yjc97/Haptic_Tablet/Media/Alpha/IMG_5569.jpg

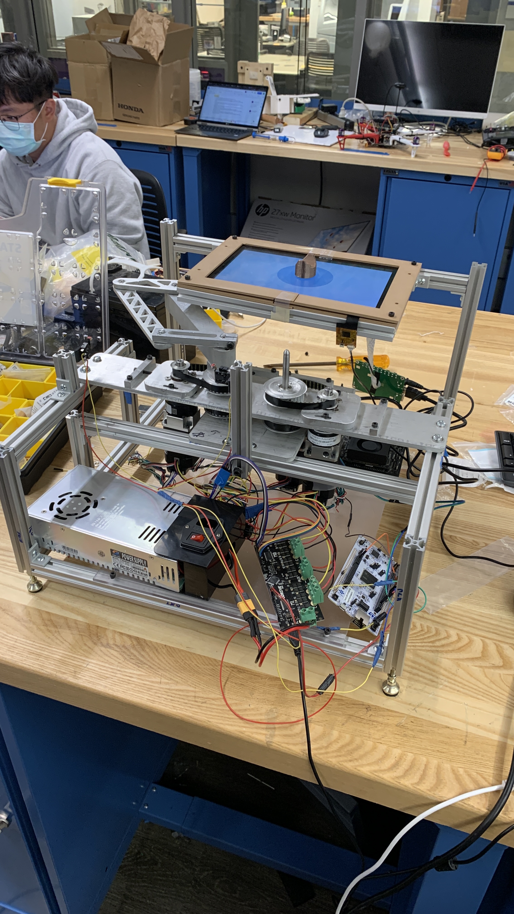
Media/Alpha/IMG_5569.jpg
