yjc97/Haptic_Tablet/Media/Alpha/IMG_5568.jpg

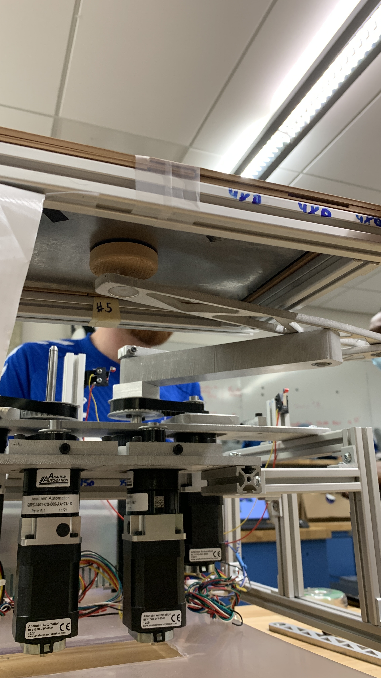
Media/Alpha/IMG_5568.jpg
