yjc97/Haptic_Tablet/Actuator/Motor Selection.docx

Maxon:

https://www.maxongroup.com/maxon/view/product/motor/ecmotor/ecflat/ecflat60/614949

Nominal voltage | 24 V
No load speed | 4300 rpm
No load current | 497 mA
Nominal speed | 3240 rpm
Nominal torque (max. continuous torque) | 536 mNm
Nominal current (max. continuous current) | 9.28 A
Stall torque | 4300 mNm
Stall current | 81.9 A
Max. efficiency | 85 %

https://www.maxongroup.com/maxon/view/category/motor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

Nominal voltage | 18 V
No load speed | 4450 rpm
No load current | 829 mA
Nominal speed | 3470 rpm
Nominal torque (max. continuous torque) | 896 mNm
Nominal current (max. continuous current) | 20.8 A
Stall torque | 10300 mNm
Stall current | 269 A
Max. efficiency | 89 %
