yjc97/Haptic_Tablet/Alpha/Demo Day Progress Slides.pptx

## Demo Day

Cameron, Sam, Lio, Ray, Diogo and Jose

## Design Requirements

- Transversable area of 7” x 10”
- Continuous 6N possible at the end effector
- Moving speed up to 150 mm/s
- Virtual wall stiffness of 1N/mm
Descoped for Alpha
- Track two points of contact -> one point of contact
  - One rotation of points, distance between points, etc.

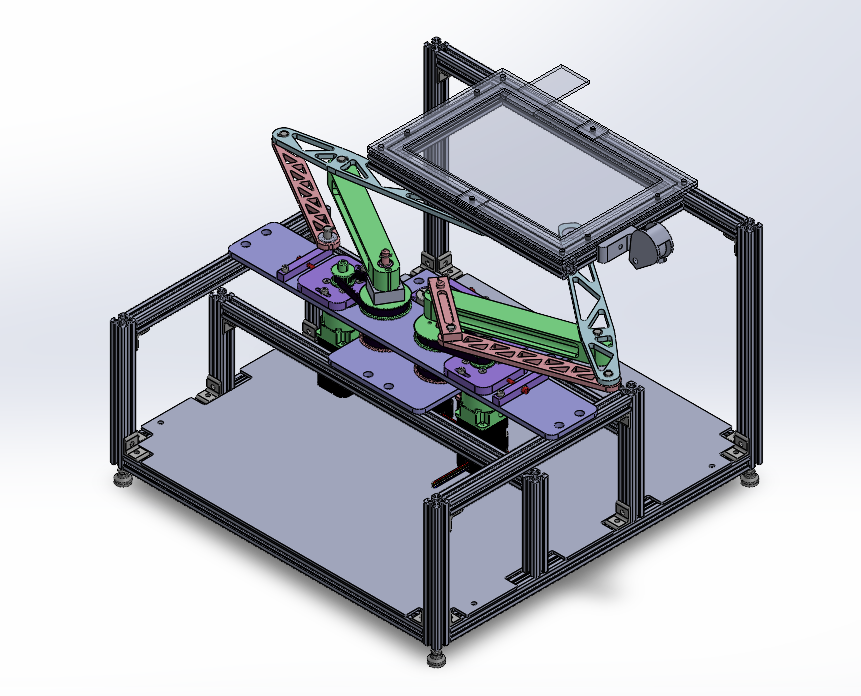
[picture p37: figure]

## Mechanical - Alpha

- Revised design
  - Removed upside-down motor
  - Updated link design to improve stiffness
  - Refined stack on longer shaft
  - Add limit switches
- Waterjet and machined all custom components
- Fully-assembled left-half linkage and 8020 frame
- Mounted key components to 8020 Frame

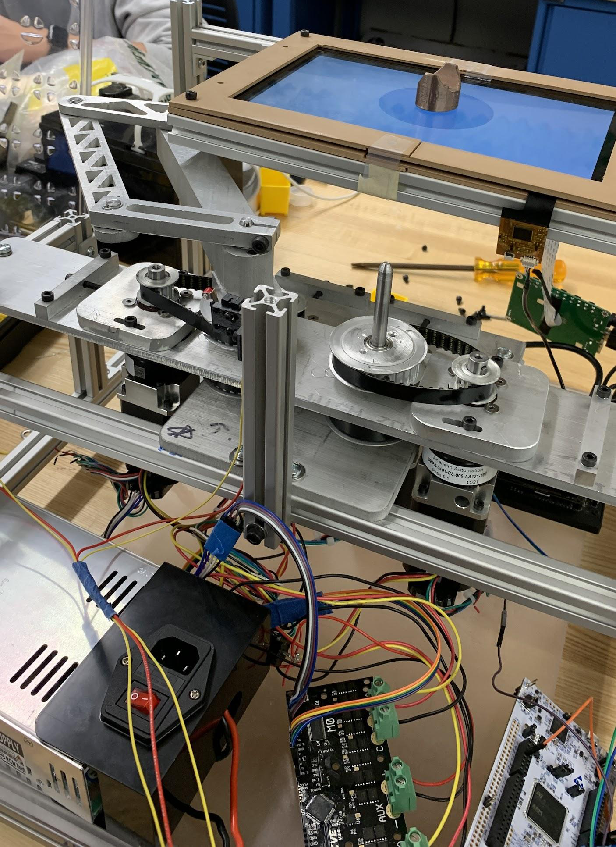
[picture p38: figure]

## Mechanical - Beta

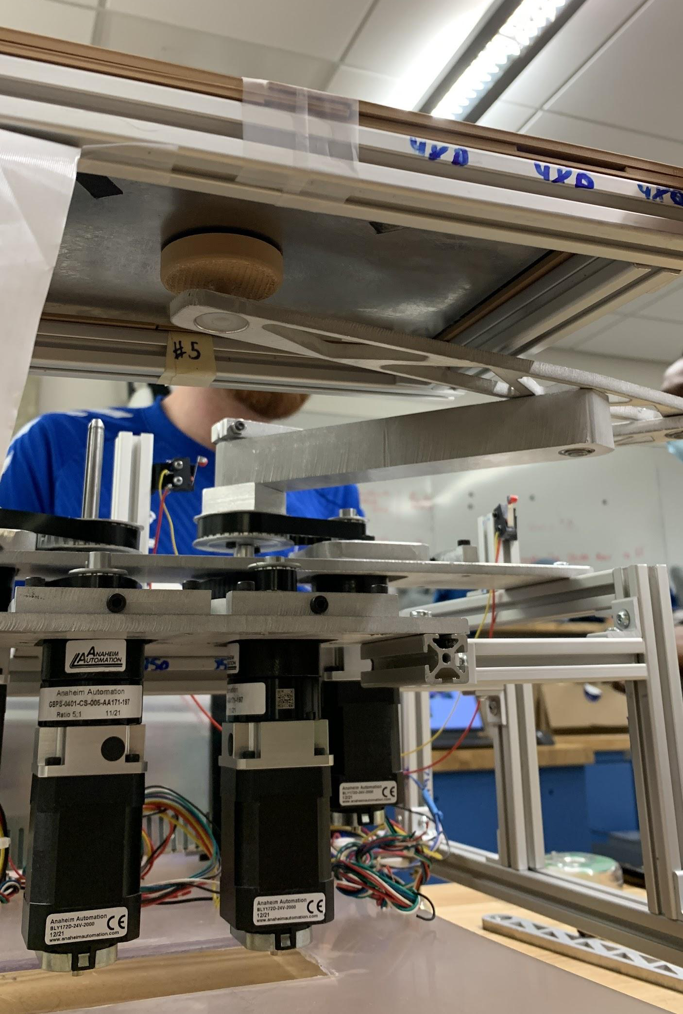
[picture p39: figure]

- Improve backdrivability
  - Analyze rotating components for ways to improve alignment & smoothness
- Improve stiffness in the frame via gussets
- Improve wire management
- Add acrylic guards to remove pinch points

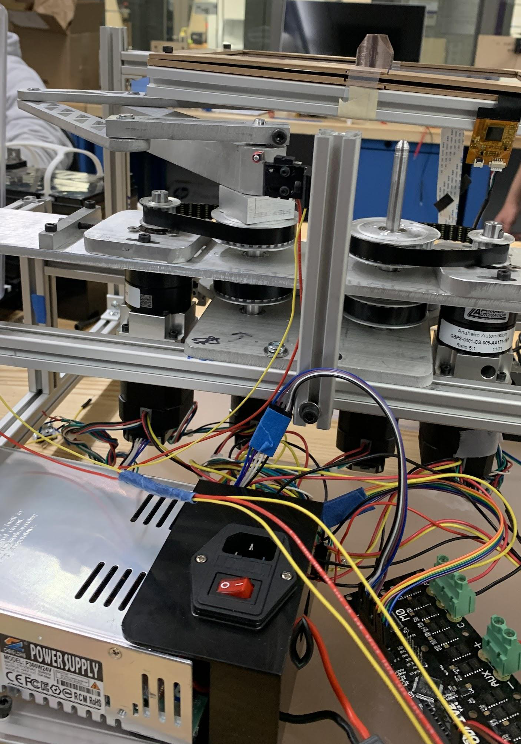
[picture p40: figure]

## Magnet

- New selection of magnets to increase shear force (8 N), while sustaining normal force and low friction (4 N)
- New puck design to allow for direct grounding

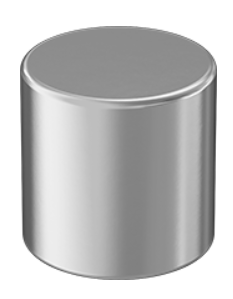
[picture p41: figure]
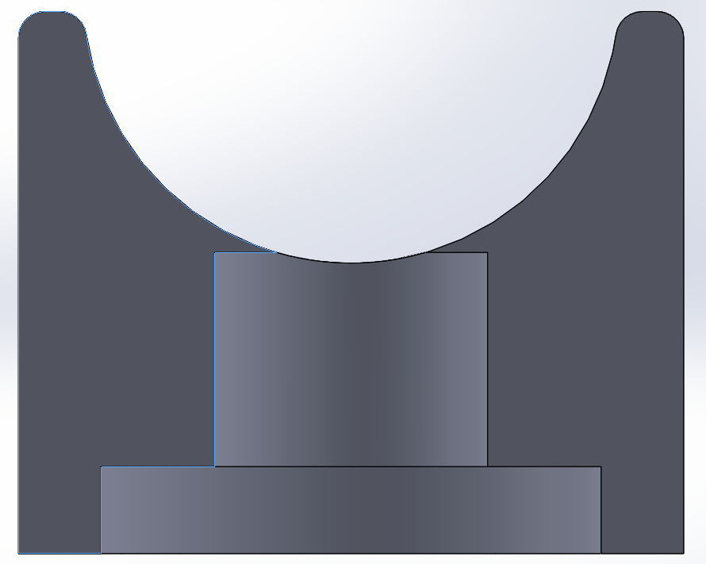
[picture p42: figure]
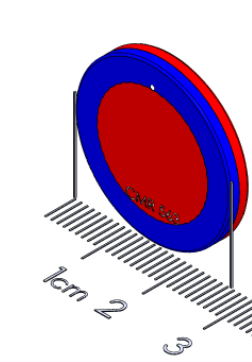
[picture p43: figure]
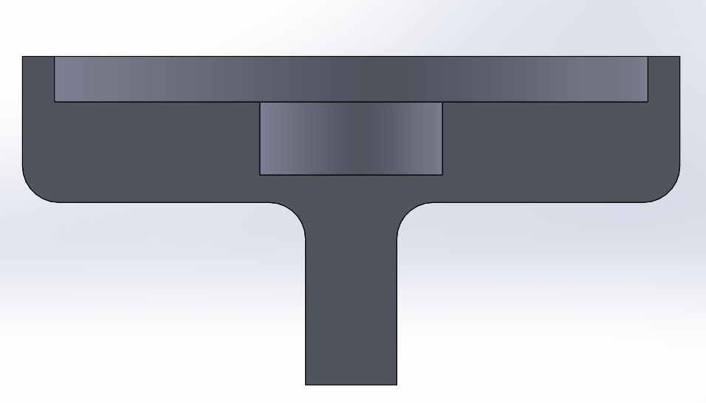
[picture p44: figure]

Notes: McMaster Magnet: 18N normal force
Polymagnet Magnet: 13.1N normal force
0.1N Shear force

## Electronics

Touchscreen

Phase ABC

Phase ABC

Axis0

Motor
Gearbox

Encoder

Axis1

Motor
Gearbox

Encoder

GND

Odrive

3.3V GND A B Z

FFC

Touch
sensor

FFC

HDMI
Driver

HDMI

Nvidia

Power

USB

3.3V GND A B Z

Power Supply

TX

RX

Power

GND

STM32

RX

TX

TX

RX

GND

## Electronics

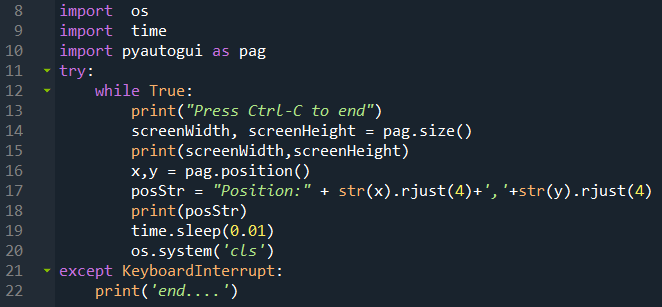
[picture p45: figure]

## Embedded

Screen (u, v) pix Touch module
Screen (x, y) mm Resolution calculation
Top Magnet (x, y)mm – –
Button Magnet desired force (Fx, Fy) N Algorithm (e.g. stiff wall)
Button Magnet desired pos (x, y) mm Magnet (displacement - force) relationship
Arm EE(x, y)mm – –
Arm Angle(theta1, theta2) revolution IK solver

## Embedded

Basic Calibration
Using switch to get the absolute angle (incremental encoder)
Use Geometric relationship to calculate the screen arm transformation
Full Automatic Calibration – TBD
Let Motor be IDEL User move the Top Magnet
Read (u, v) and Arm angle (theta1 theta2)
Use multi Group data to solve all the unknown parameter.

## Demo!

- Single-point tracking
- Circular virtual wall

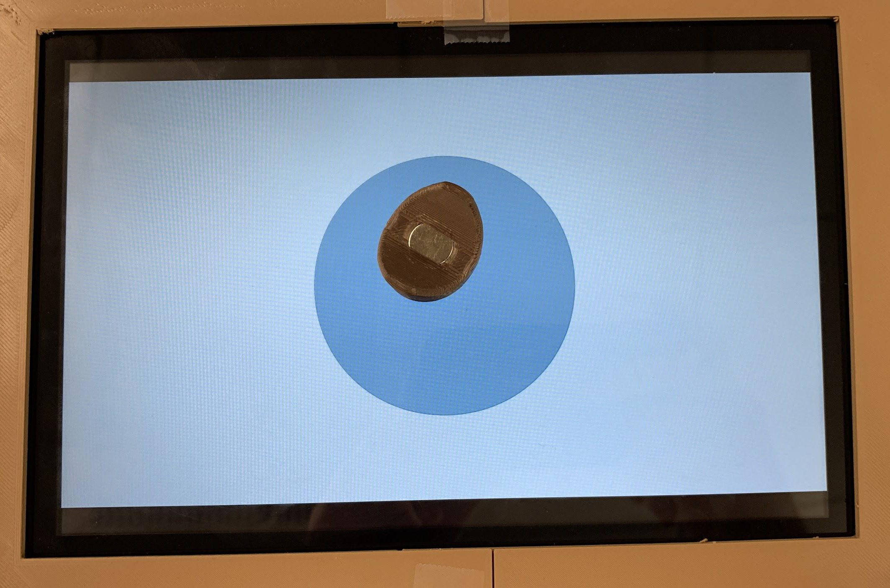
[picture p46: figure]
