yjc97/Haptic_Tablet/Alpha/Documentation Links.docx

- BOM (https://docs.google.com/spreadsheets/d/1UQJlw0del5G45h6zSm0E_HK45yHbqKKUzbgZlgoQl6M/edit#gid=0)
- Drawings (https://drive.google.com/drive/folders/1MZkpaJnwjj6plieDn9vKRo8g7MoNWwiO)
- Github (https://github.com/cmastoras/TabletCapstone)
  - Color Plot Script (https://github.com/cmastoras/TabletCapstone/blob/main/2R_TOPOLOGY.ipynb)
  - CAD (https://github.com/cmastoras/TabletCapstone/tree/main/GrabCAD)
    - Alpha (https://github.com/cmastoras/TabletCapstone/tree/main/GrabCAD/ALPHA)
