yjc97/Haptic_Tablet/Mechanism/Magnet/3_4 Polymagnet meeting.pptx

## HAPTIC DEVICE

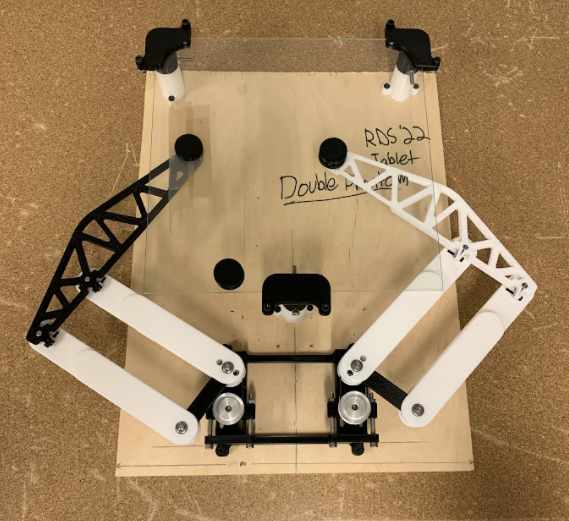
[picture p72: figure]
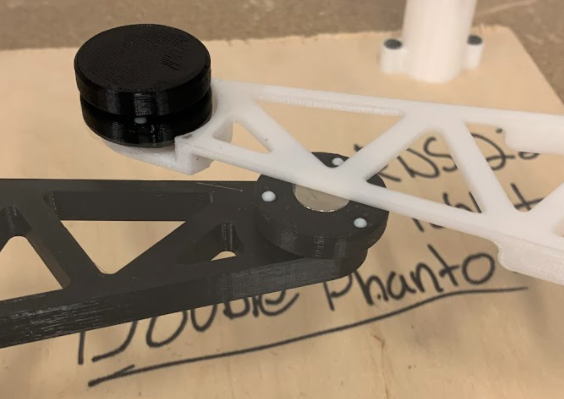
[picture p73: figure]
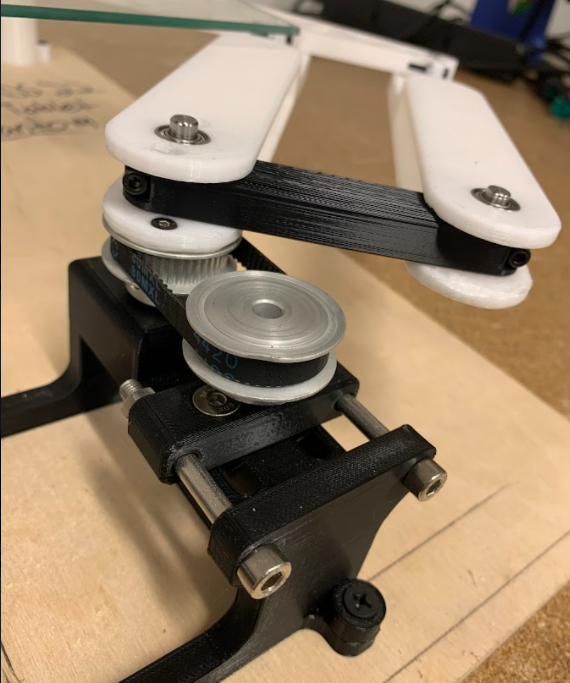
[picture p74: figure]

## KEY REQUIREMENTS

LOW FRICTION:
- In free motion, the user should experience no more than 0.22 lbs or 100 g of inertia.
- In free motion, the gantry device should be able to match finger speeds up to 150 mm/s or 5.9 in/s.
SHEAR STRENGTH:
- When the user is interacting with a virtual wall, the device will be able to respond with a stiffness of 1 N/mm or 5.71 lbs/in

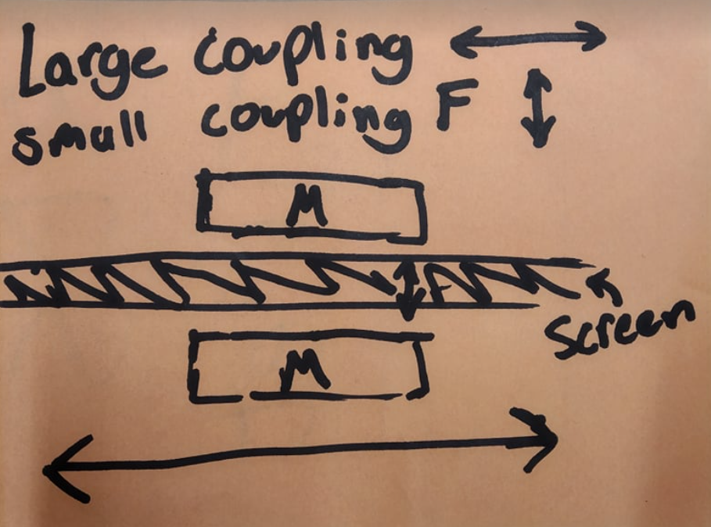
[picture p75: figure]

## CURRENT MAGNET DESIGN

- Teflon tape / balls
- Grease
- Roller Bearings
- Air bearing

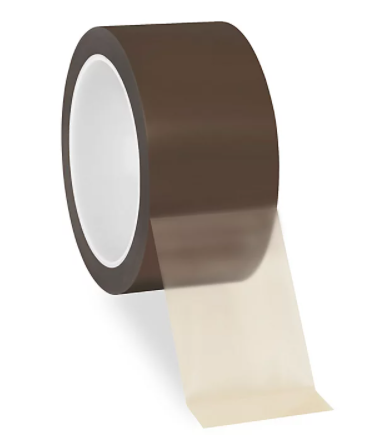
[picture p76: figure]
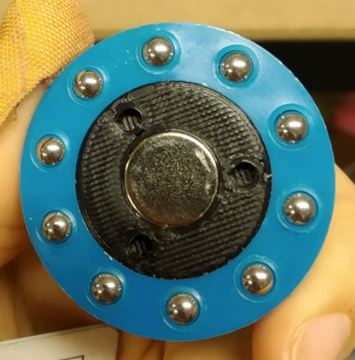
[picture p77: figure]
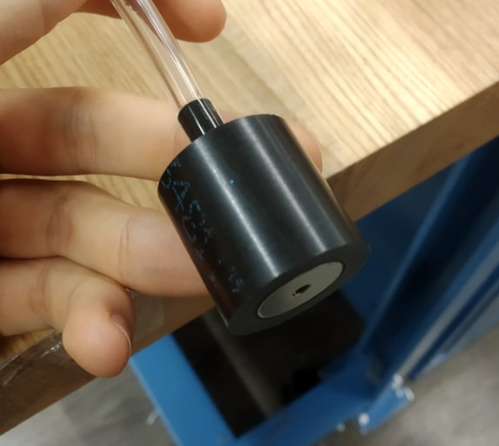
[picture p78: figure]

## Polymagnet design

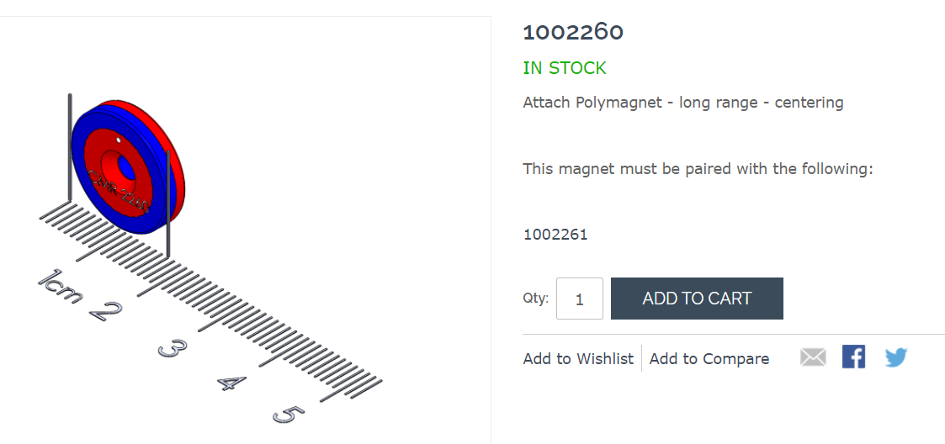
[picture p79: figure]
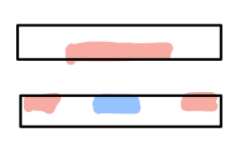
[picture p80: figure]
