yjc97/Haptic_Tablet/Mechanism/Magnet/Magnets.docx

Quick Crash Info

https://www.youtube.com/watch?v=s94suB5uLWw&t=506s

https://www.intemag.com/magnetic-frequently-asked-questions#:~:text=There%20are%20three%20types%20of,of%20magnetism%20or%20electrical%20power.

Buying list
