yjc97/Haptic_Tablet/Mechanism/Misc/Open Chain Topology Analysis.docx

Geometry | Condition Number within Boundary

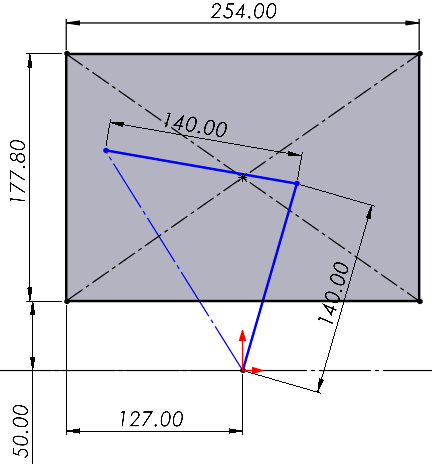
[picture p81: figure]
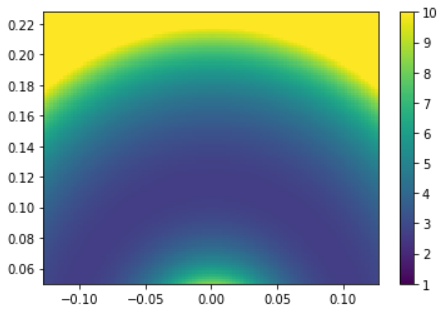
[picture p82: figure]
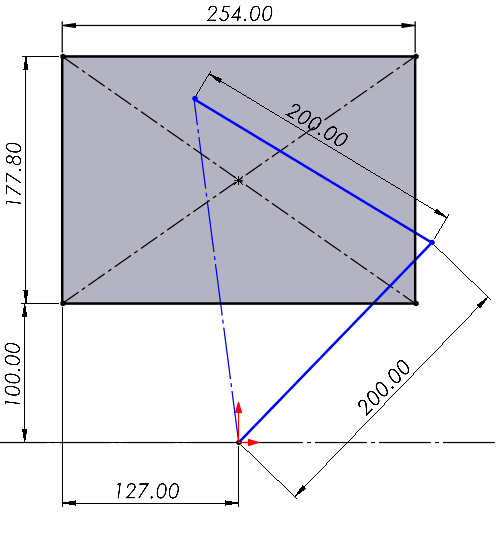
[picture p83: figure]
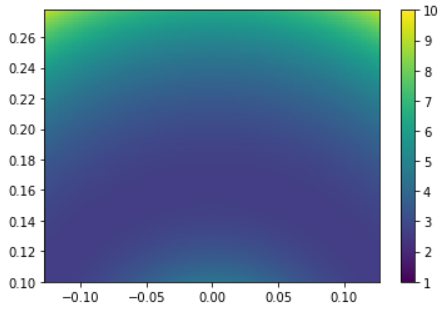
[picture p84: figure]
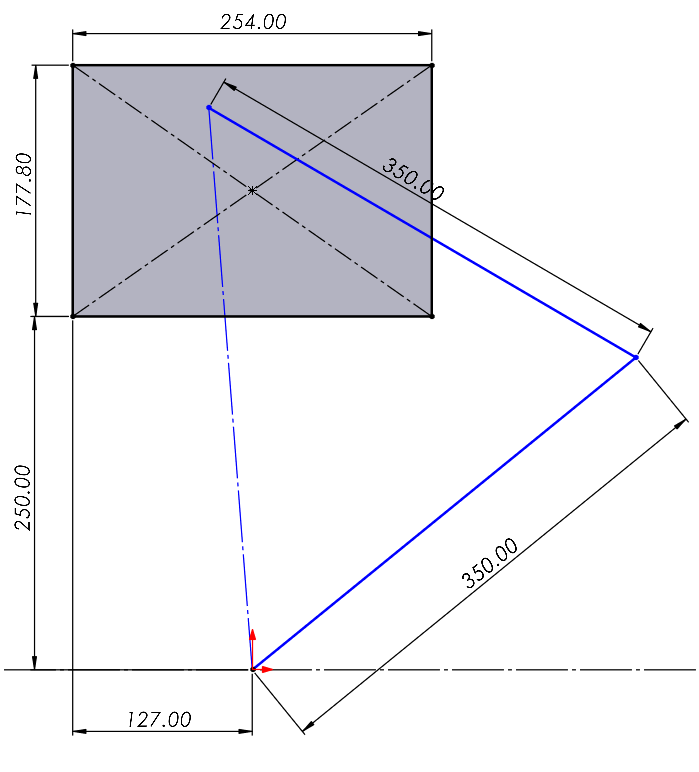
[picture p85: figure]
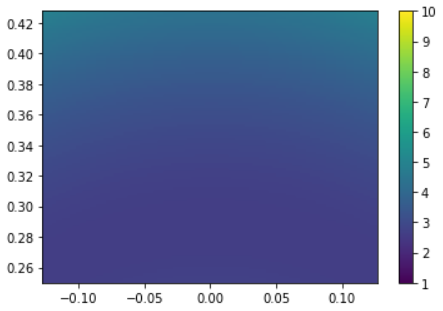
[picture p86: figure]
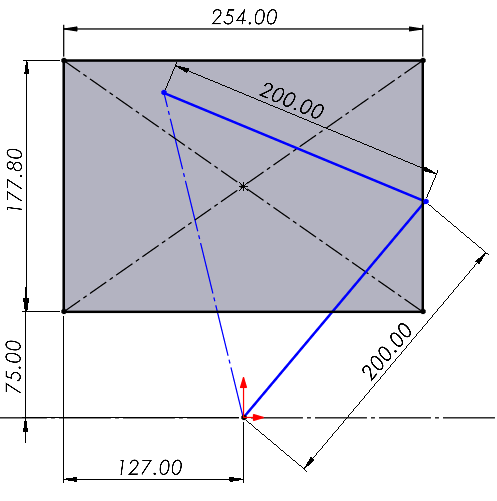
[picture p87: figure]
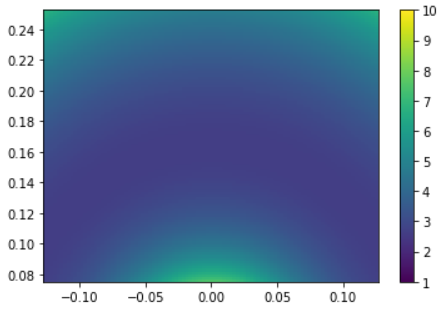
[picture p88: figure]
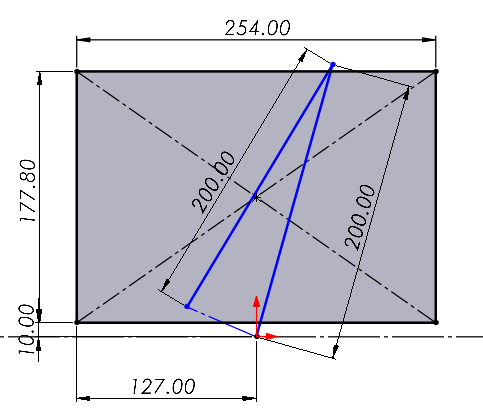
[picture p89: figure]
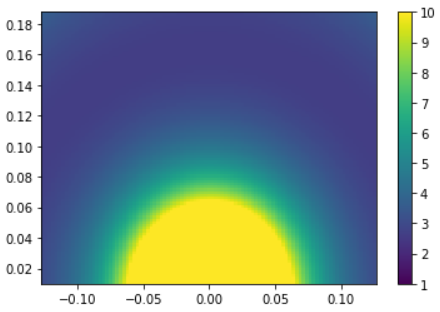
[picture p90: figure]
