yjc97/Haptic_Tablet/Brainstorming/Capstone design brainstorm.pdf

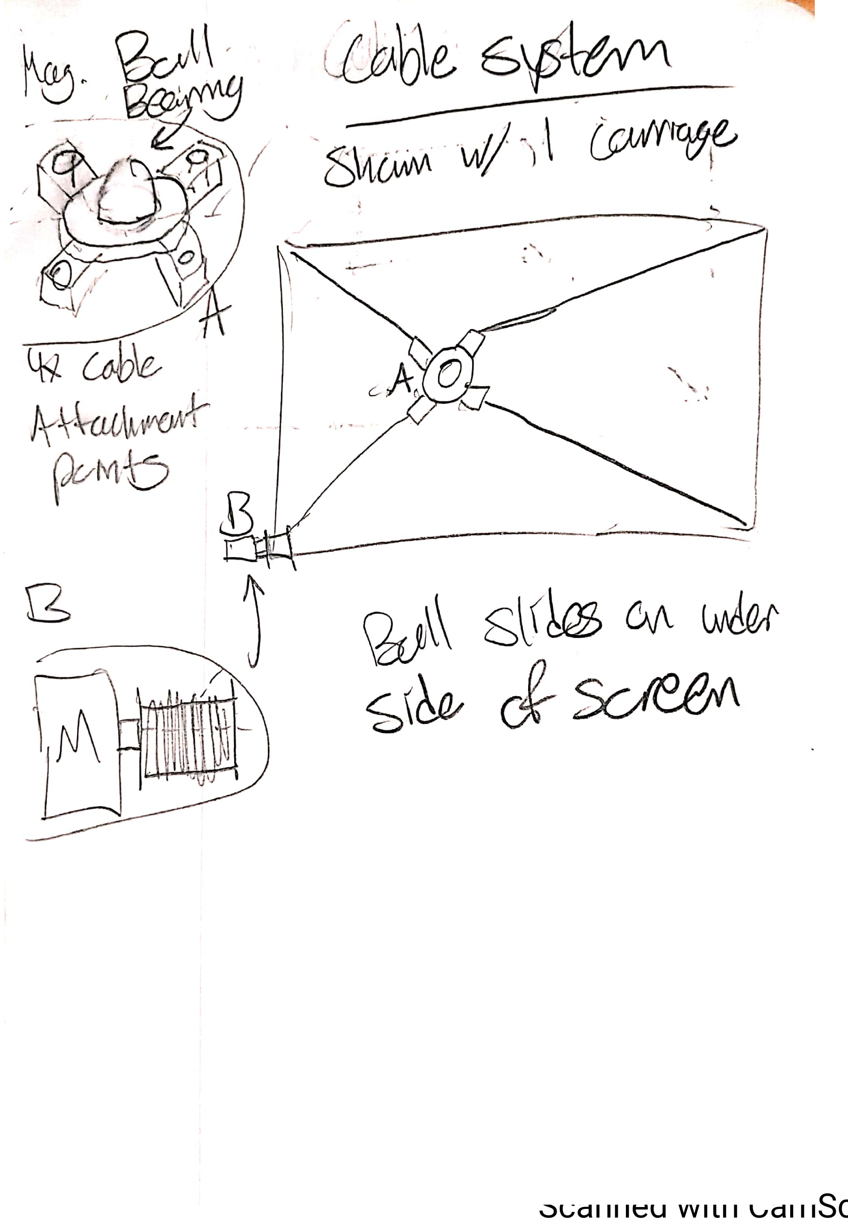
[picture p91: page 1]
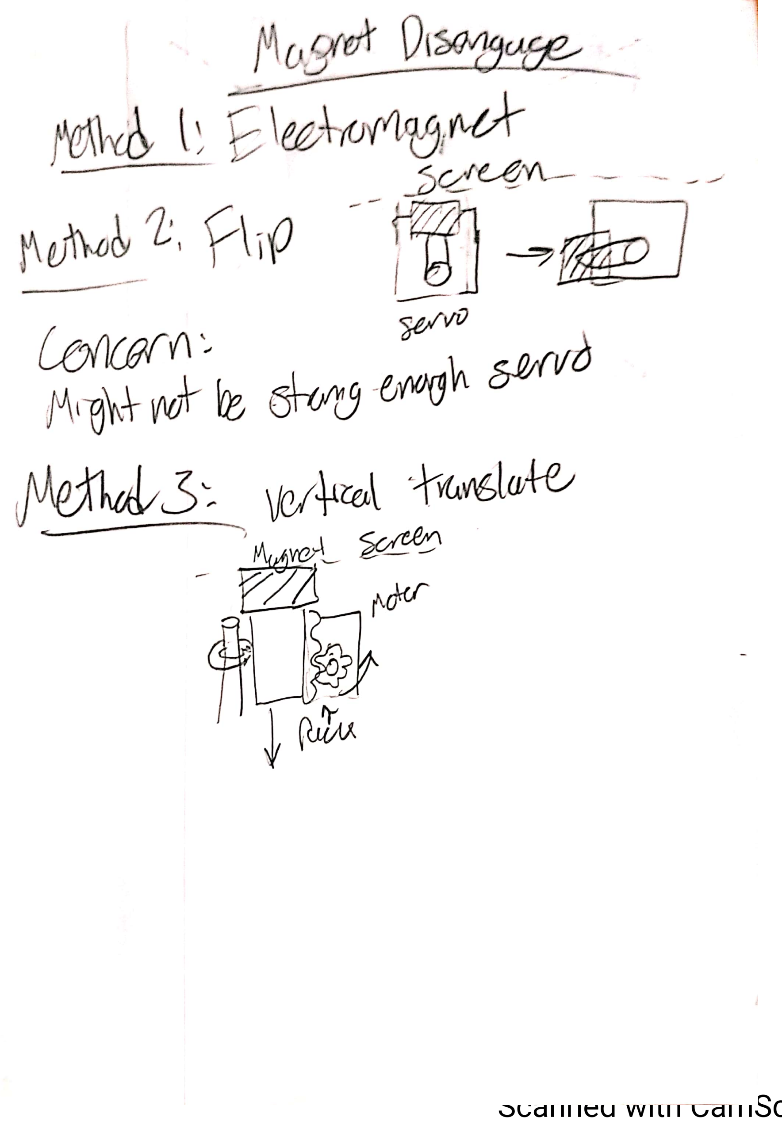
[picture p92: page 2]
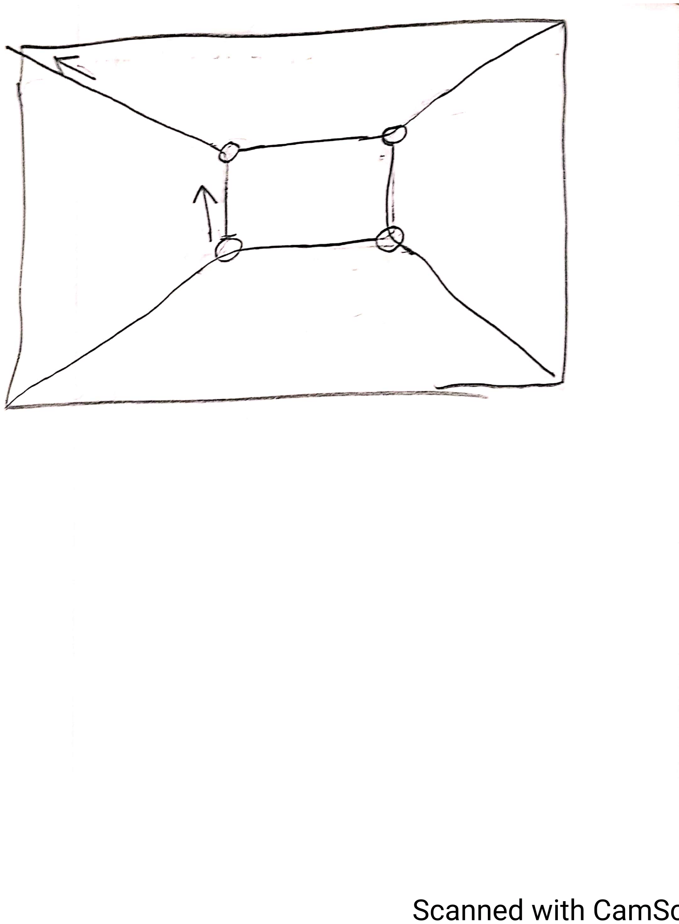
[picture p93: page 3]
