yjc97/Haptic_Tablet/Actuator/Block Diagram.jpg

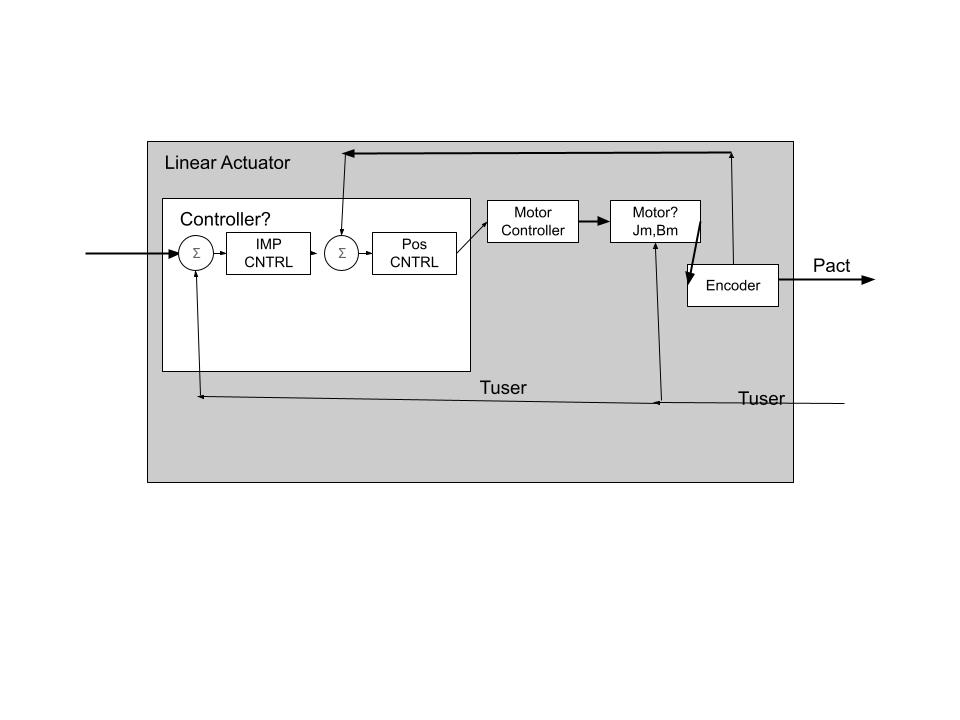
Actuator/Block Diagram.jpg
