yjc97/Haptic_Tablet/Brainstorming/Brainstorm.jpg

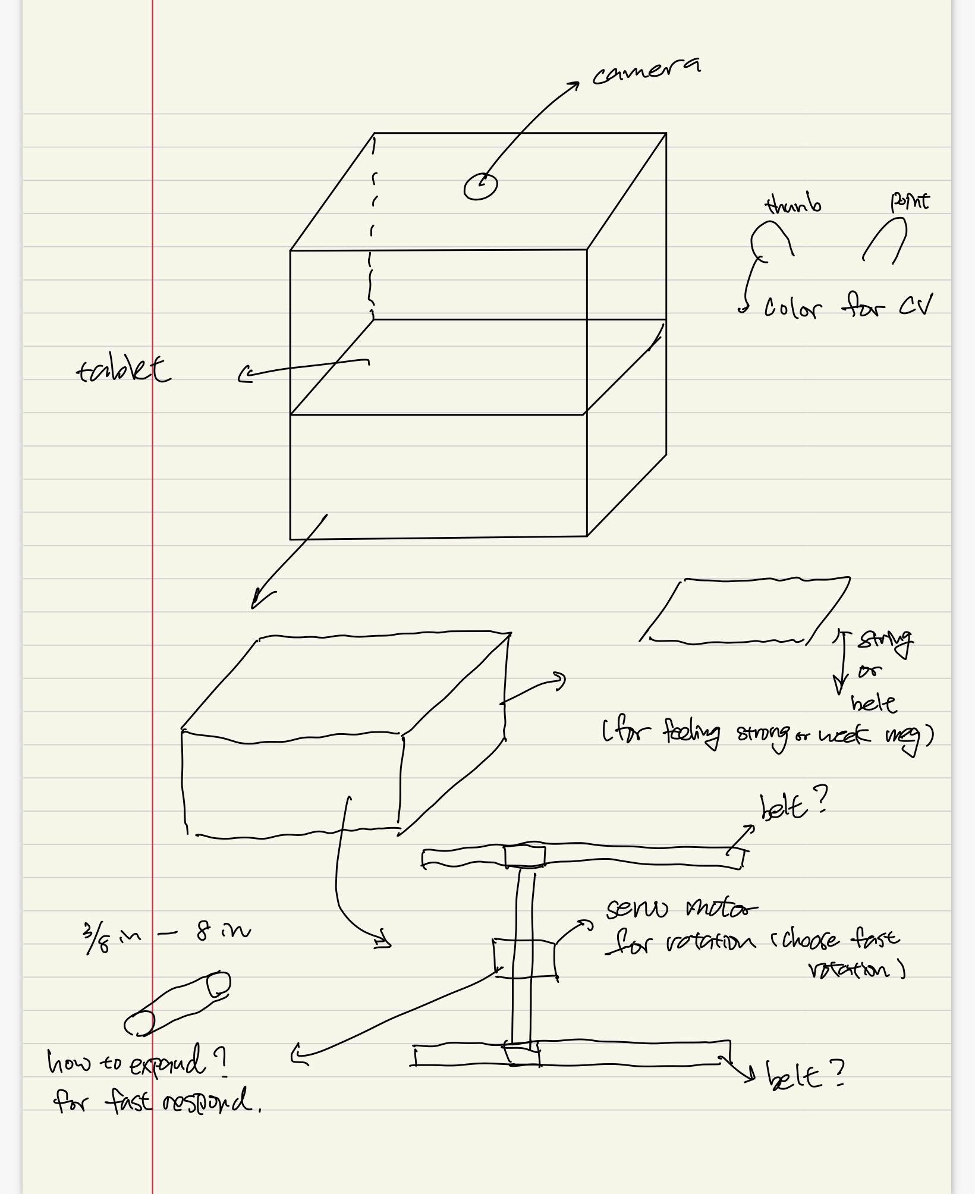
Brainstorming/Brainstorm.jpg
