yjc97/Haptic_Tablet/Brainstorming/Diogo Initial Sketches.png

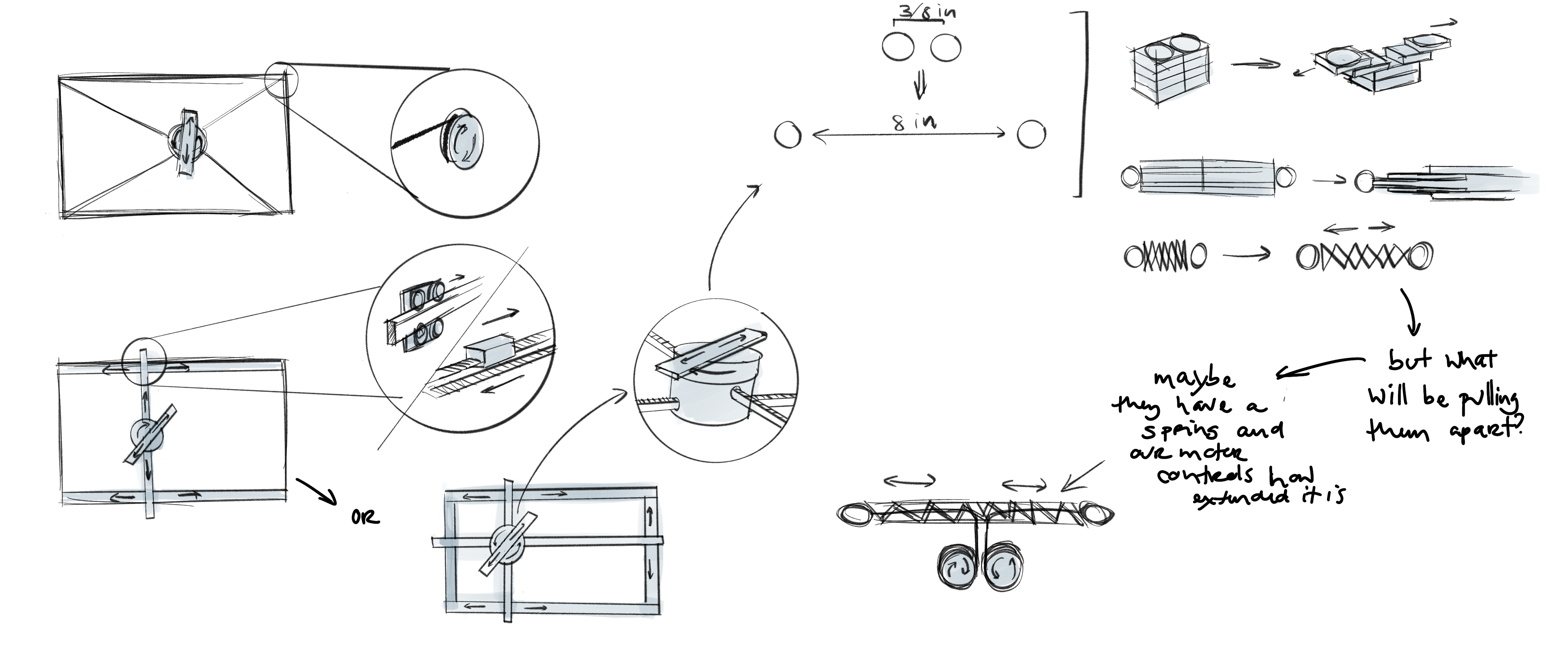
Brainstorming/Diogo Initial Sketches.png
