yjc97/Haptic_Tablet/Mechanism/Diagrams/System Architecture.jpg

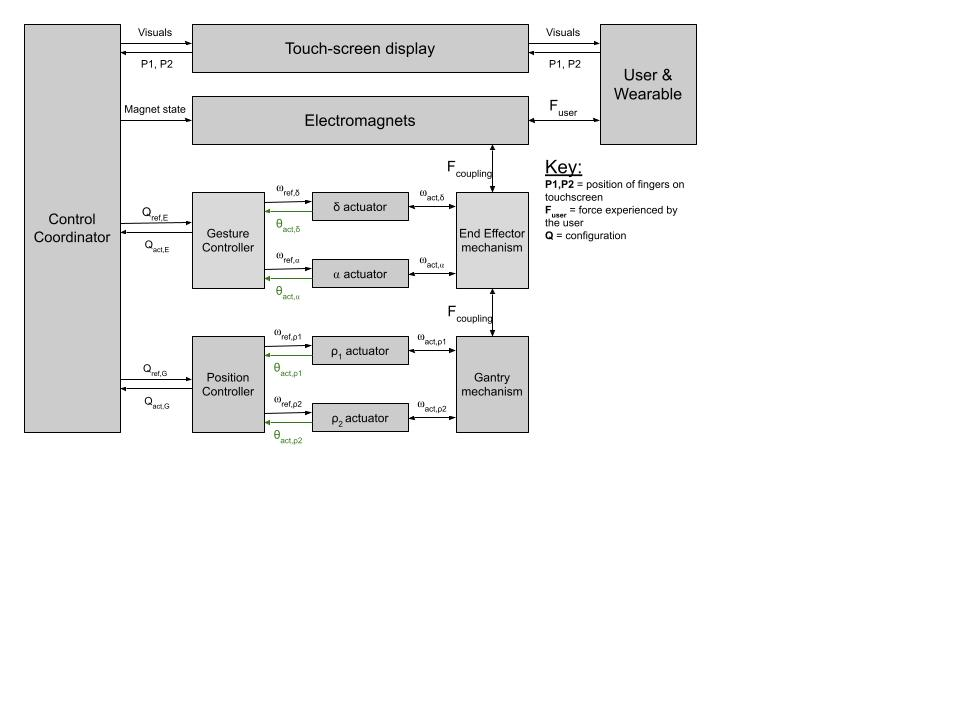
Mechanism/Diagrams/System Architecture.jpg
