yjc97/Haptic_Tablet/Media/Alpha/IMG_5562.jpg

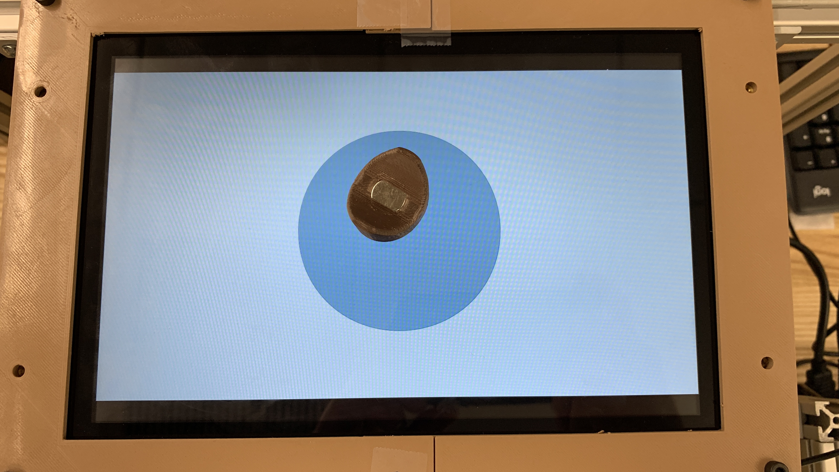
Media/Alpha/IMG_5562.jpg
