yjc97/Haptic_Tablet/Media/Alpha/IMG_5563.jpg

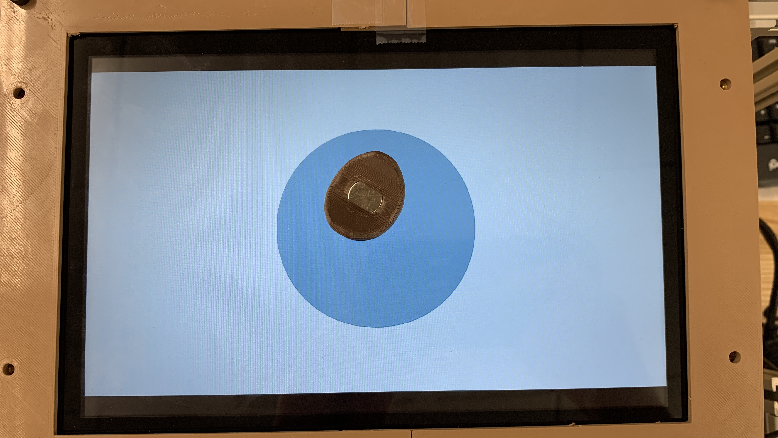
Media/Alpha/IMG_5563.jpg
