yjc97/Haptic_Tablet/Media/Alpha/IMG_5564.jpg

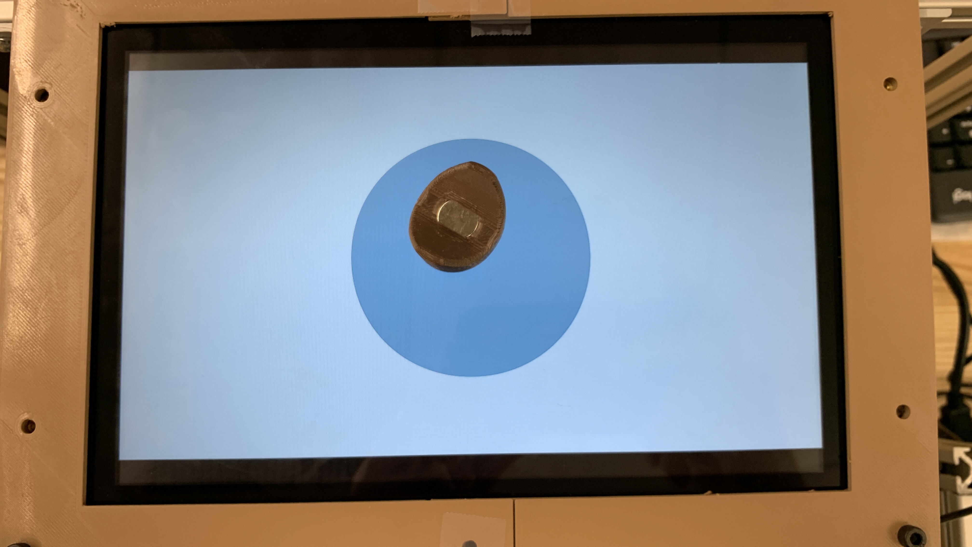
Media/Alpha/IMG_5564.jpg
