yjc97/Haptic_Tablet/Media/Alpha/IMG_5566.jpg

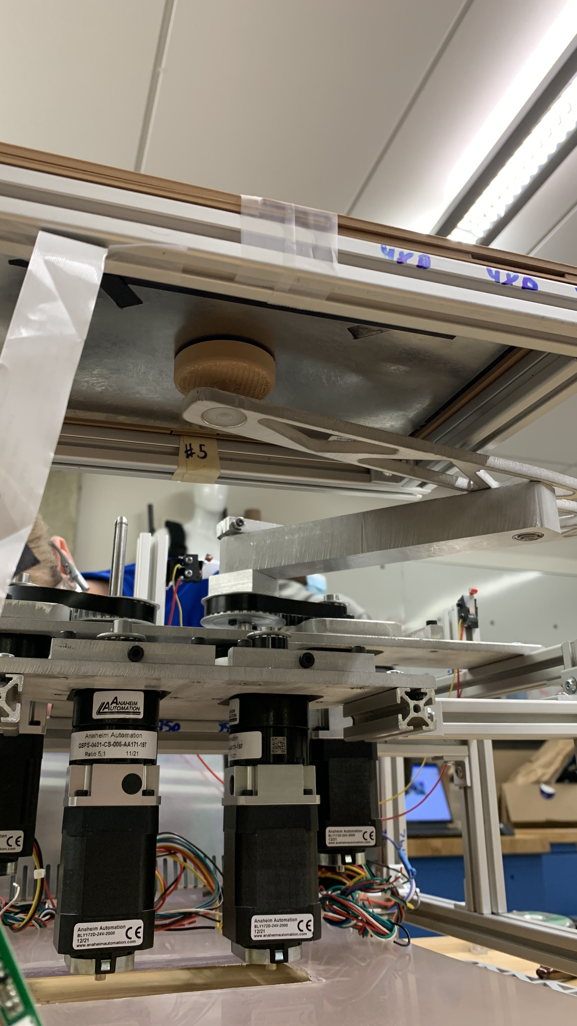
Media/Alpha/IMG_5566.jpg
