yjc97/Haptic_Tablet/Media/Alpha/IMG_5567.jpg

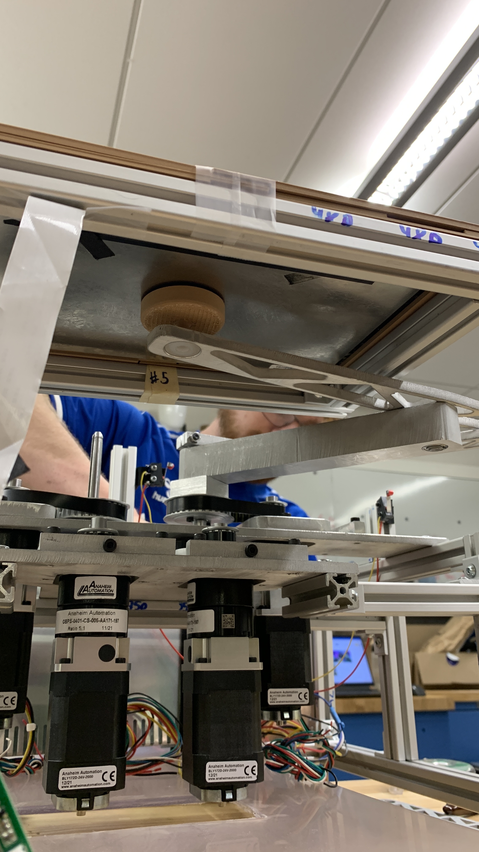
Media/Alpha/IMG_5567.jpg
