yjc97/Haptic_Tablet/Media/Alpha/IMG_5570.jpg

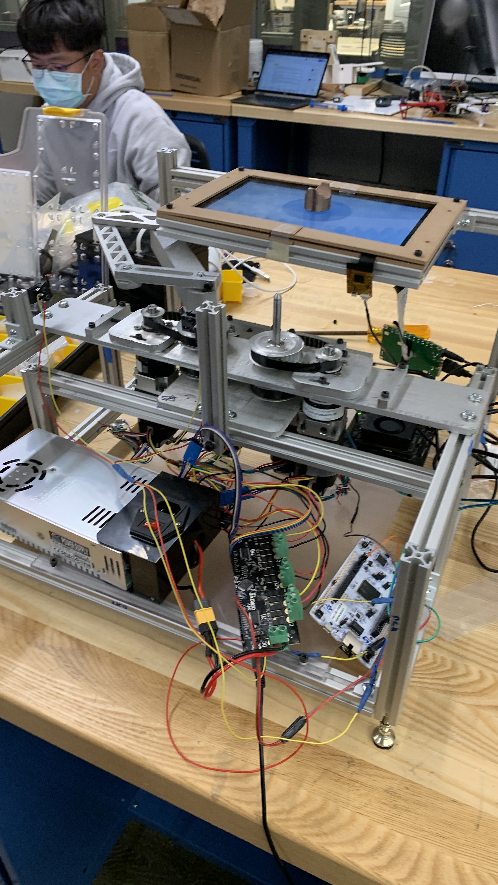
Media/Alpha/IMG_5570.jpg
