yjc97/Haptic_Tablet/Media/Alpha/IMG_5571.jpg

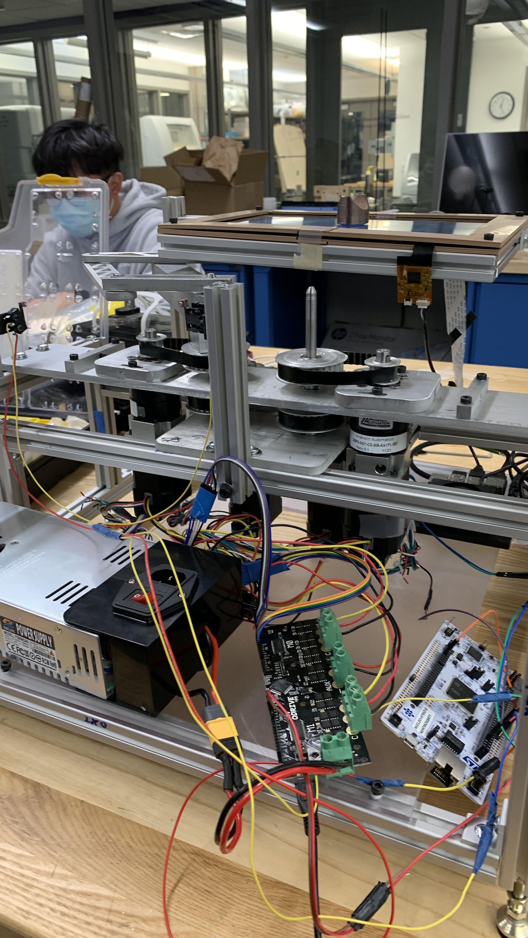
Media/Alpha/IMG_5571.jpg
