yjc97/Haptic_Tablet/Media/Alpha/IMG_5572.jpg

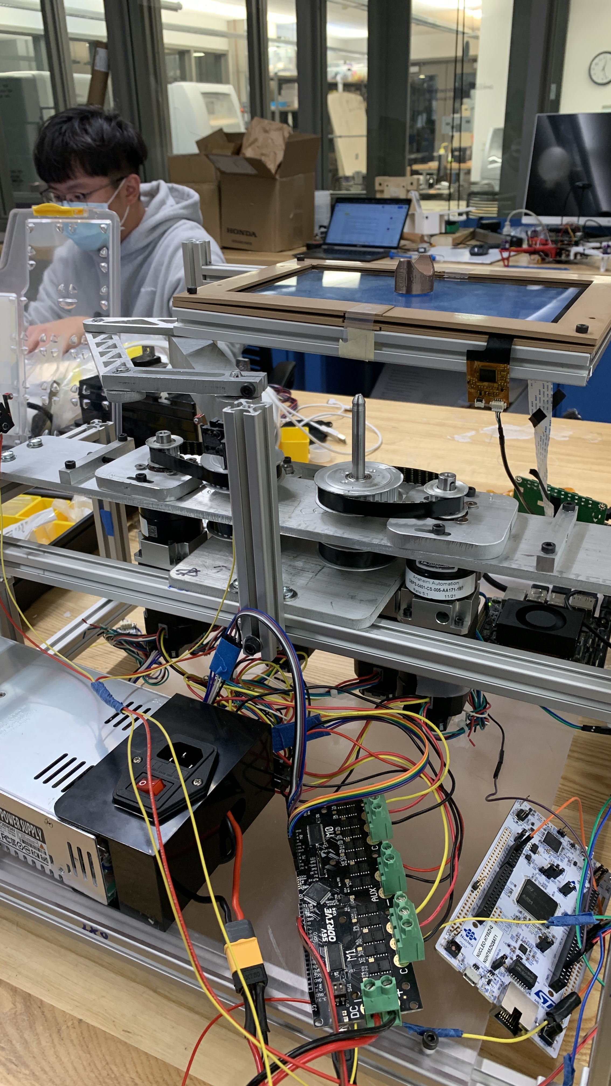
Media/Alpha/IMG_5572.jpg
