yjc97/Haptic_Tablet/Media/Alpha/IMG_5573.jpg

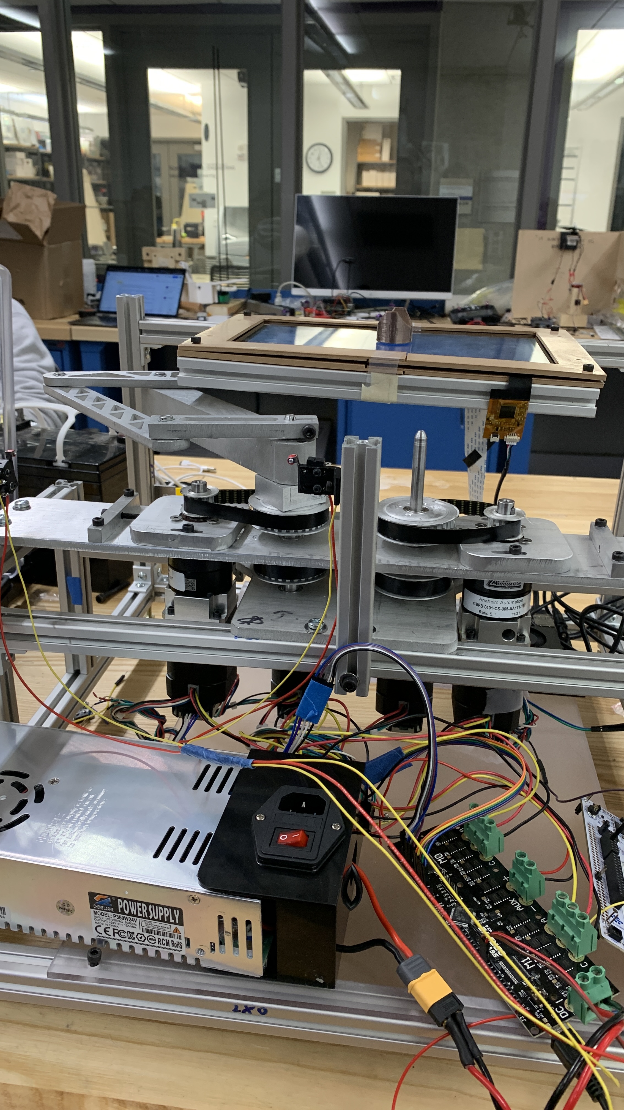
Media/Alpha/IMG_5573.jpg
