yjc97/Haptic_Tablet/Media/Alpha/IMG_5574.jpg

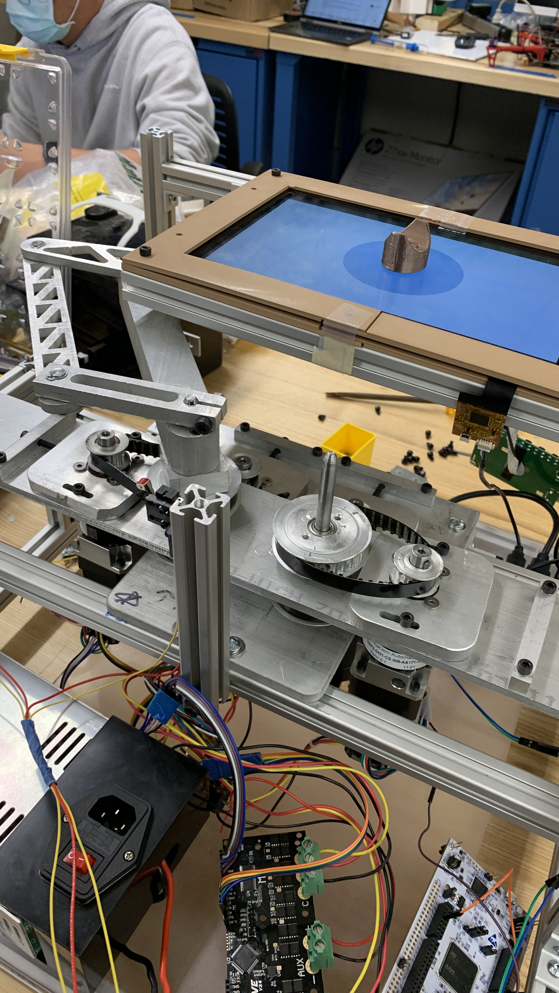
Media/Alpha/IMG_5574.jpg
