yjc97/Haptic_Tablet/Media/Alpha/IMG_5575.jpg

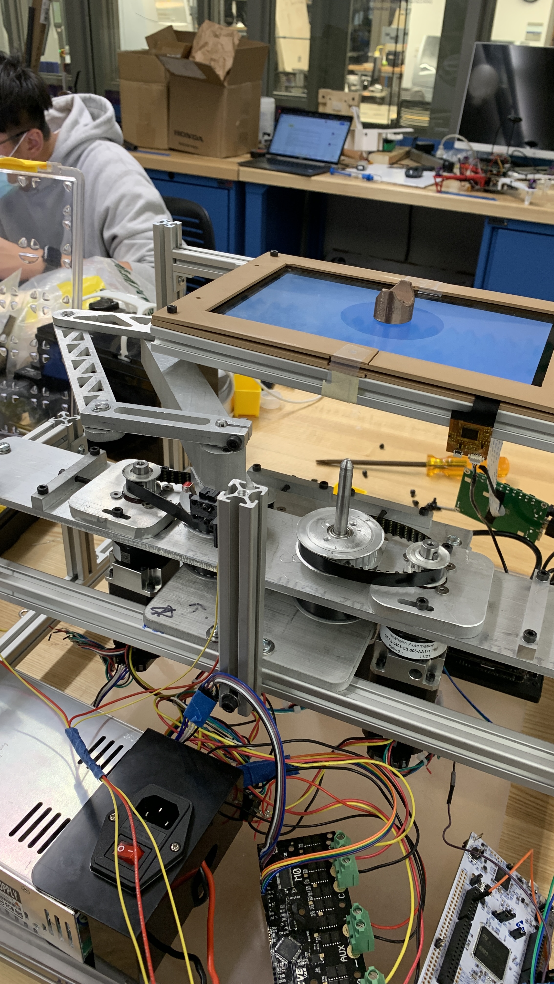
Media/Alpha/IMG_5575.jpg
