yjc97/Haptic_Tablet/Media/Alpha/IMG_5576.jpg

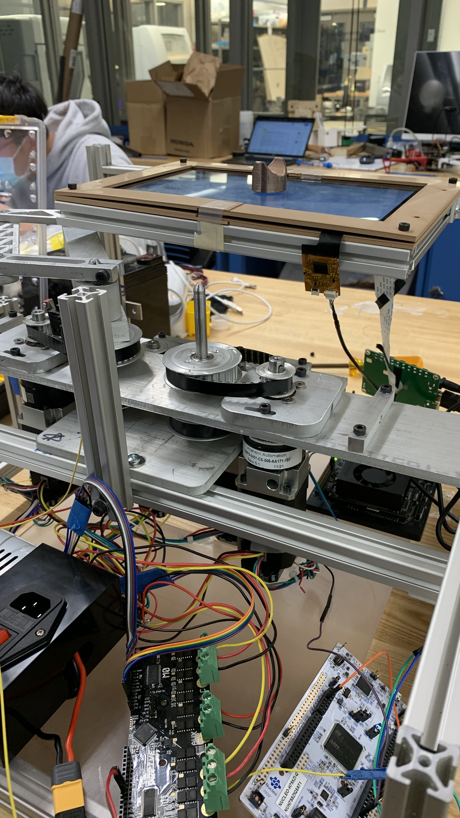
Media/Alpha/IMG_5576.jpg
