yjc97/Haptic_Tablet/Media/Alpha/IMG_5577.jpg

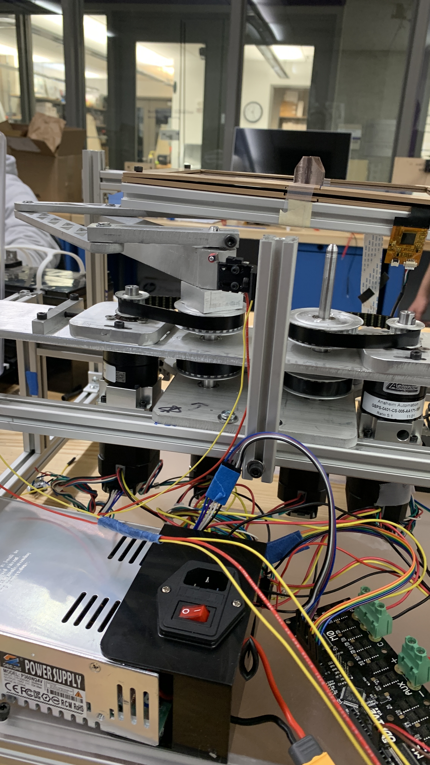
Media/Alpha/IMG_5577.jpg
