yjc97/Haptic_Tablet/Media/Alpha/IMG_5578.jpg

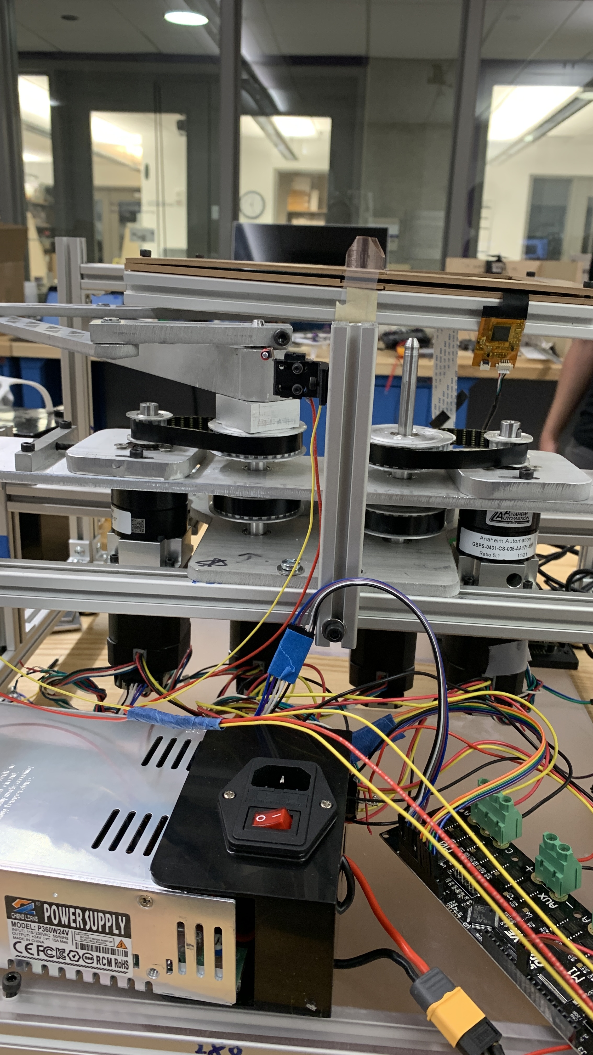
Media/Alpha/IMG_5578.jpg
