yjc97/Haptic_Tablet/Media/Alpha/IMG_5579.jpg

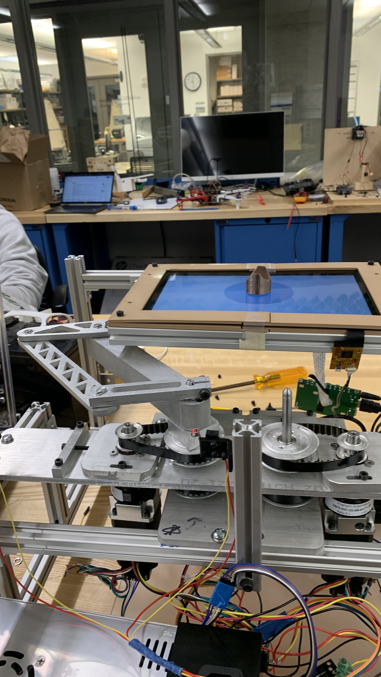
Media/Alpha/IMG_5579.jpg
