yjc97/Haptic_Tablet/Media/Alpha/IMG_5580.jpg

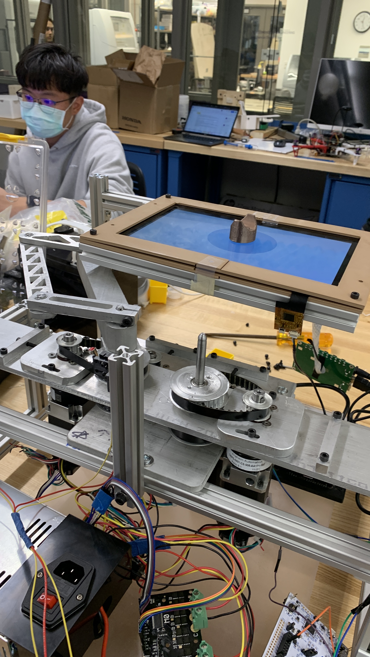
Media/Alpha/IMG_5580.jpg
