yjc97/Haptic_Tablet/Media/Alpha/IMG_5581.jpg

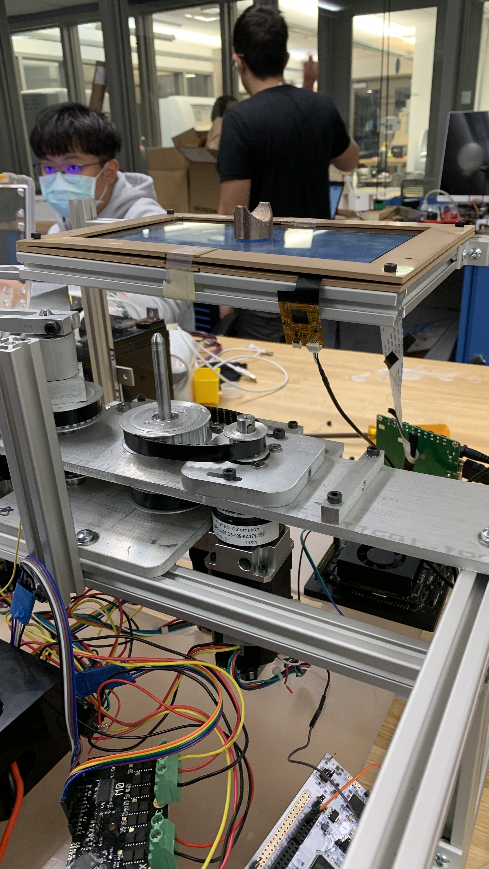
Media/Alpha/IMG_5581.jpg
