yjc97/Haptic_Tablet/Media/Alpha/IMG_5582.jpg

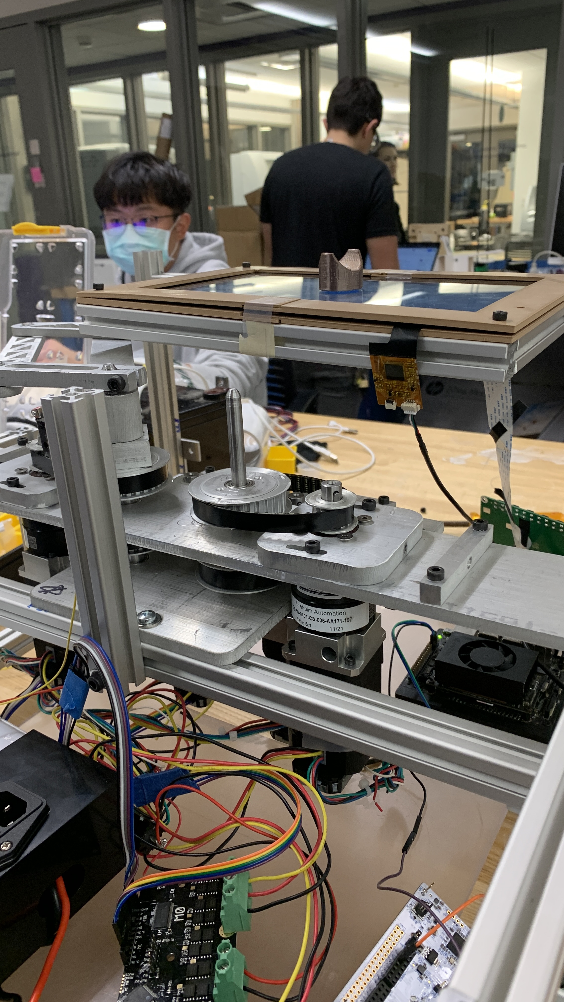
Media/Alpha/IMG_5582.jpg
