yjc97/Haptic_Tablet/Media/Mechanism/IMG_4413.JPG

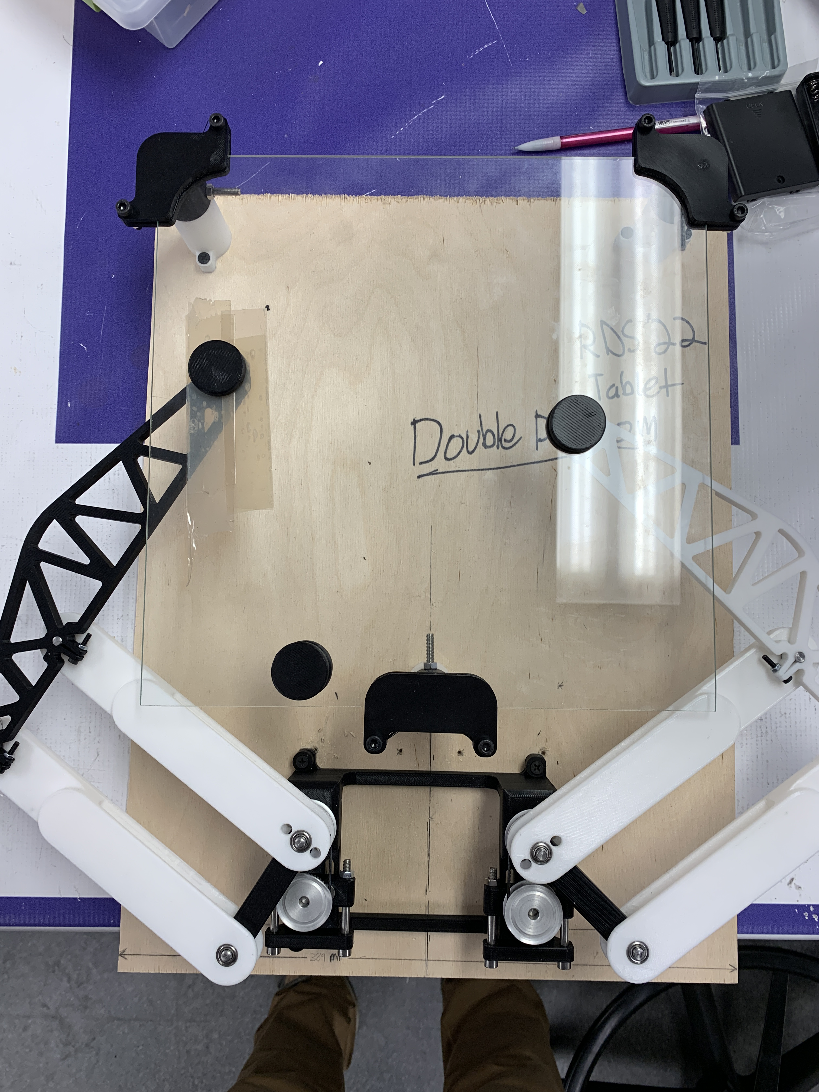
Media/Mechanism/IMG_4413.JPG
