yjc97/Haptic_Tablet/Media/Mechanism/IMG_4414.JPG

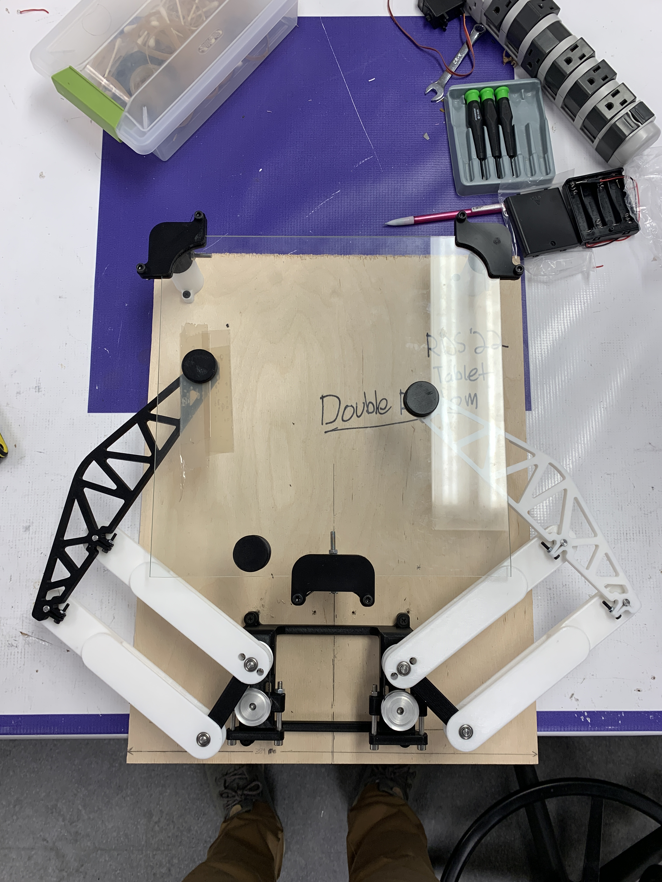
Media/Mechanism/IMG_4414.JPG
