yjc97/Haptic_Tablet/Media/Mechanism/IMG_4418.JPG

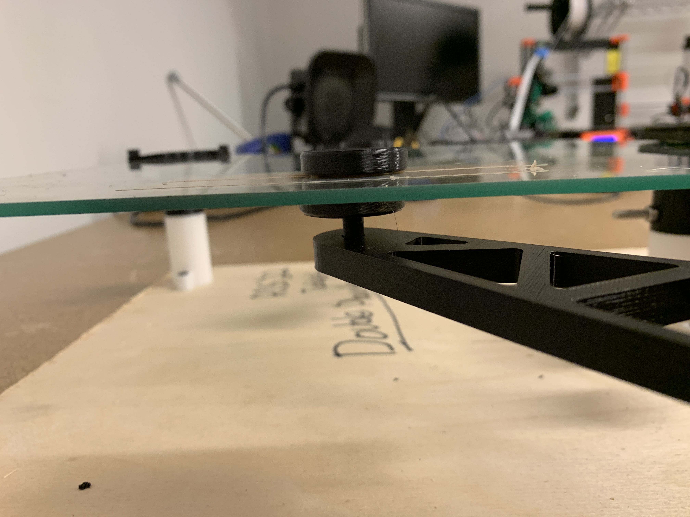
Media/Mechanism/IMG_4418.JPG
