yjc97/Haptic_Tablet/Media/Mechanism/IMG_4419.JPG

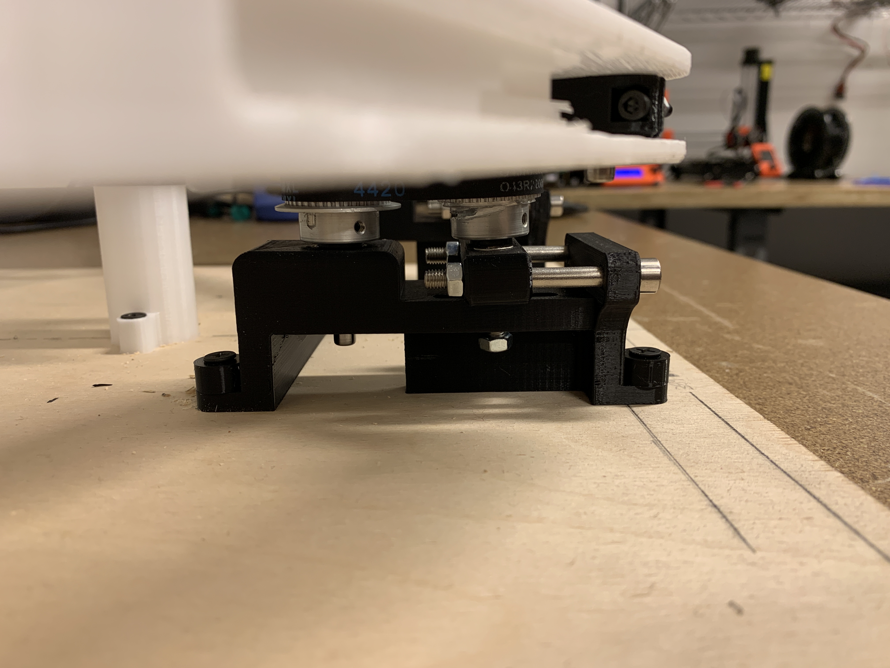
Media/Mechanism/IMG_4419.JPG
