yjc97/Haptic_Tablet/Media/Mechanism/IMG_4420.JPG

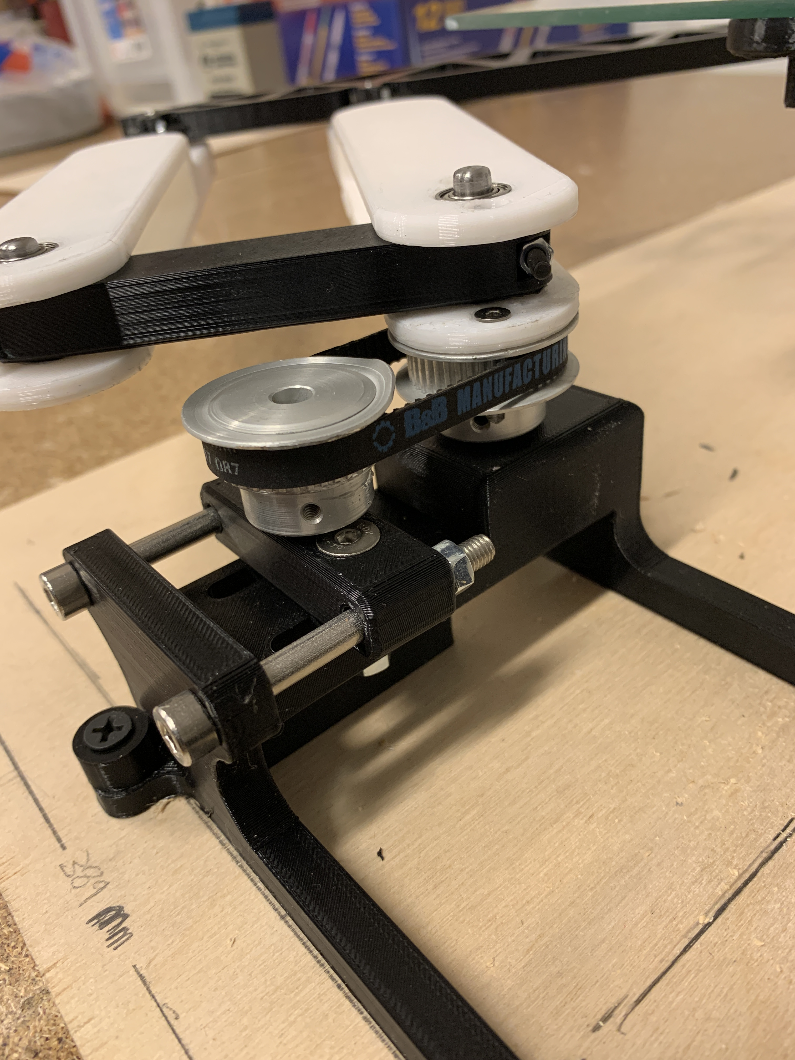
Media/Mechanism/IMG_4420.JPG
