yjc97/Haptic_Tablet/Media/Mechanism/IMG_4421.JPG

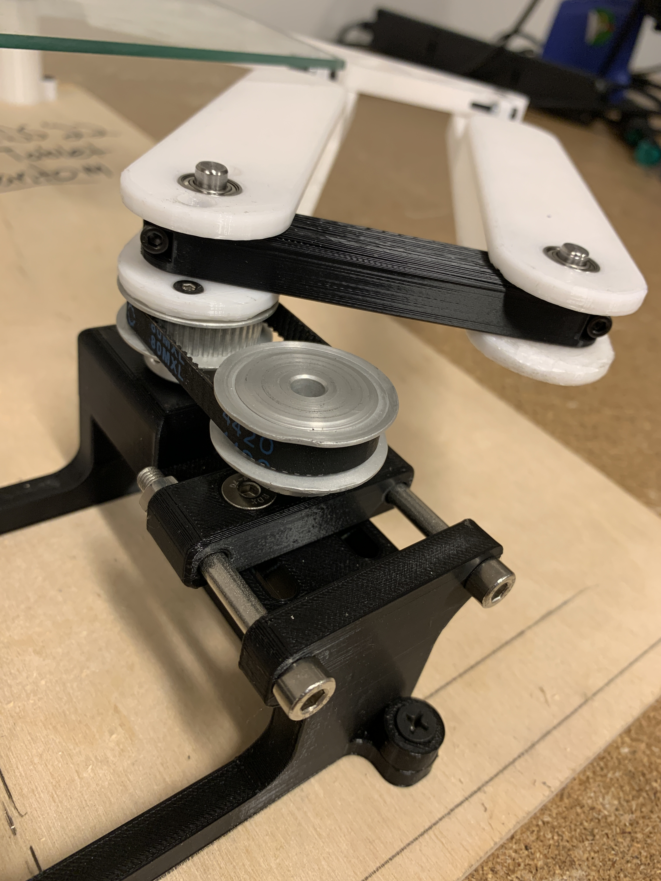
Media/Mechanism/IMG_4421.JPG
