yjc97/Haptic_Tablet/Media/Mechanism/IMG_4422.JPG

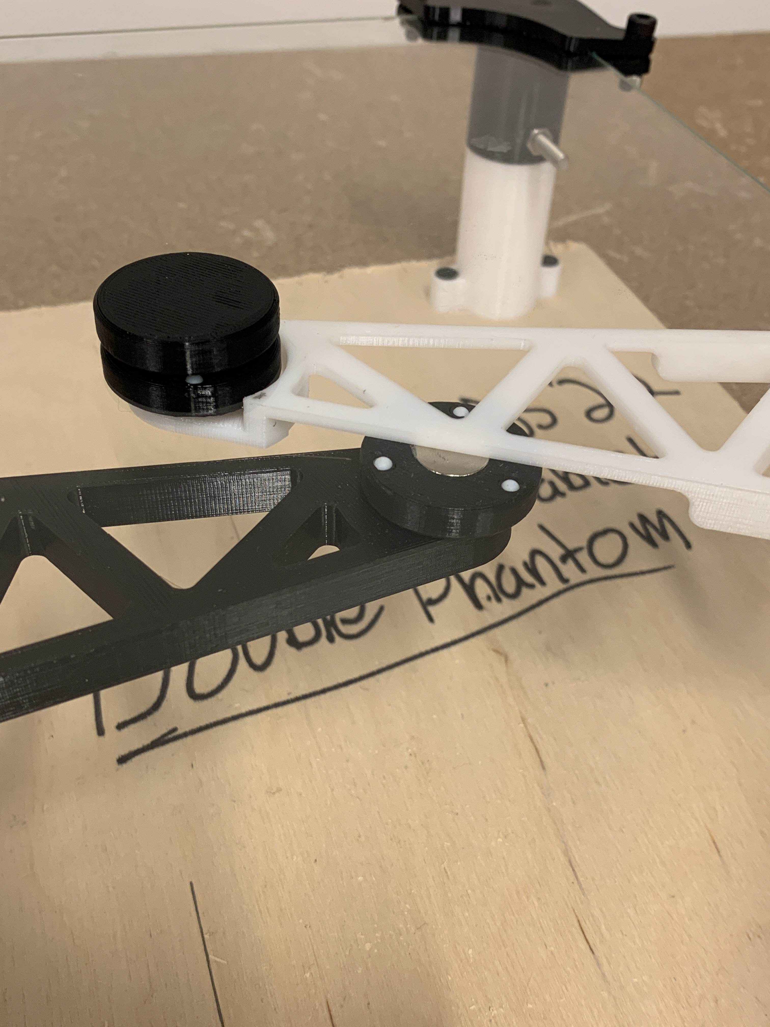
Media/Mechanism/IMG_4422.JPG
