yjc97/Haptic_Tablet/Media/Mechanism/IMG_4423.JPG

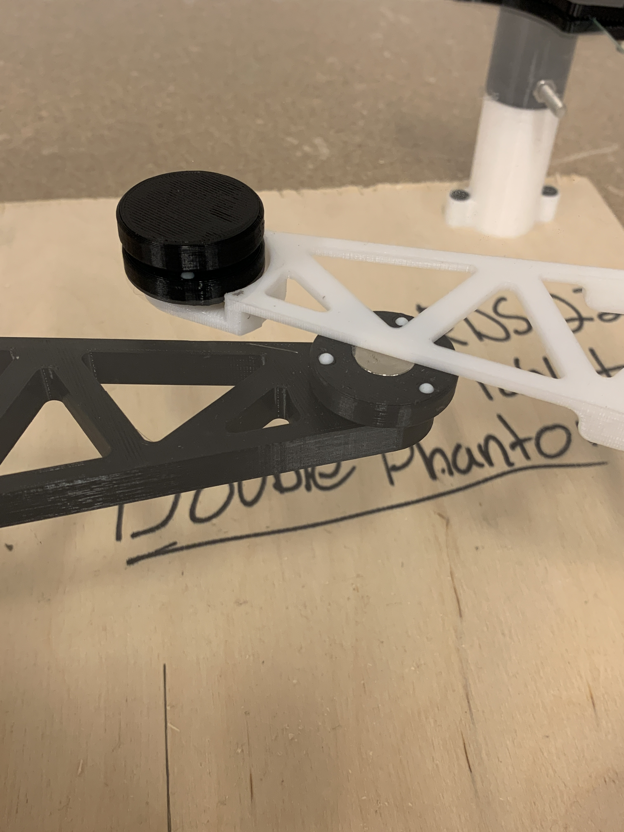
Media/Mechanism/IMG_4423.JPG
