yjc97/Haptic_Tablet/Media/Mechanism/IMG_4424.JPG

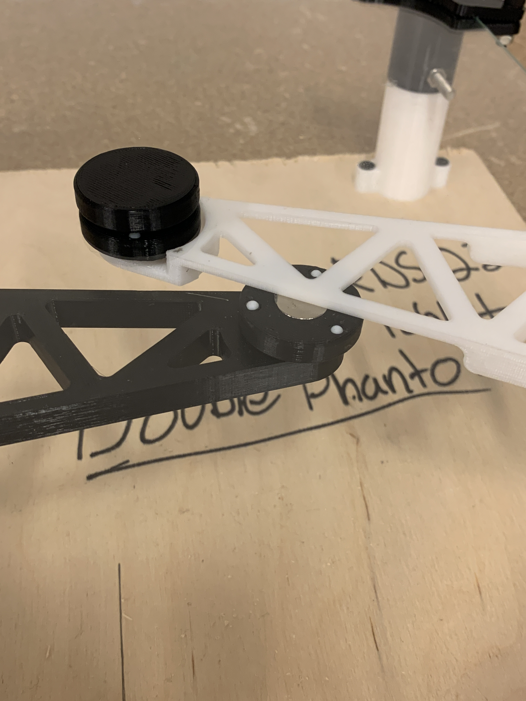
Media/Mechanism/IMG_4424.JPG
