yjc97/Haptic_Tablet/Media/Mechanism/IMG_4431.JPG

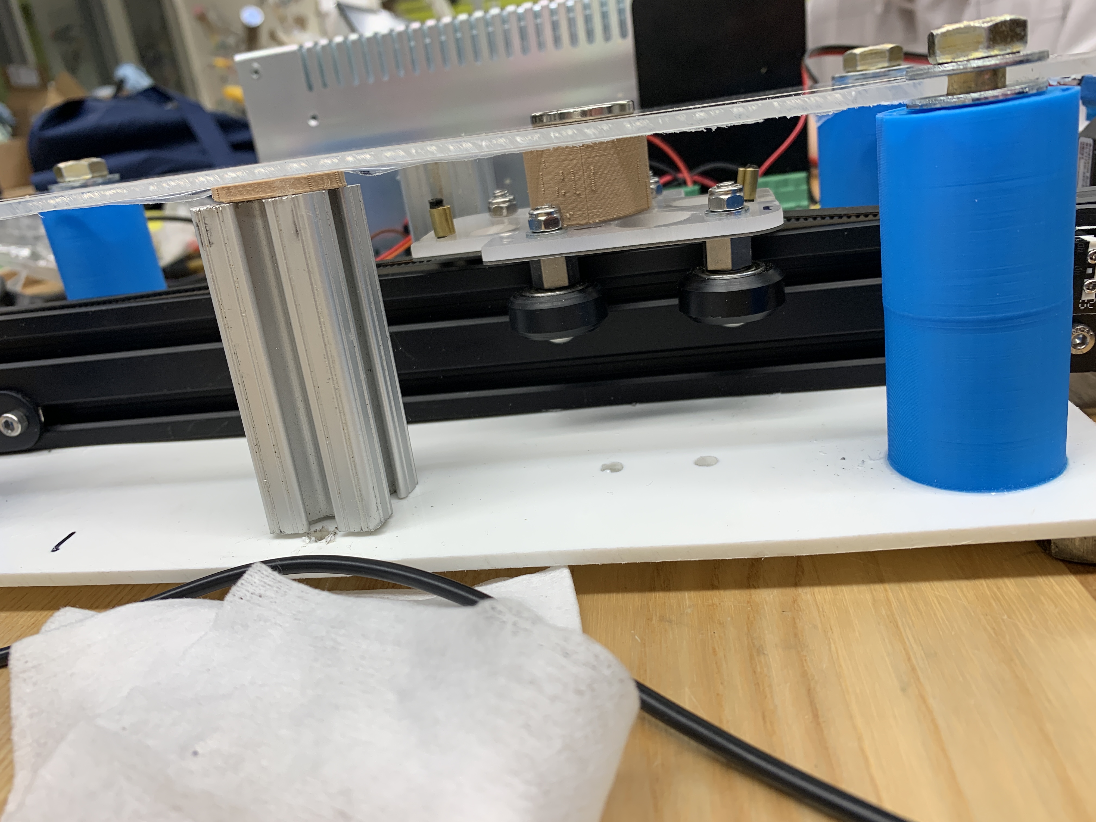
Media/Mechanism/IMG_4431.JPG
