yjc97/Haptic_Tablet/Media/Mechanism/IMG_4432.JPG

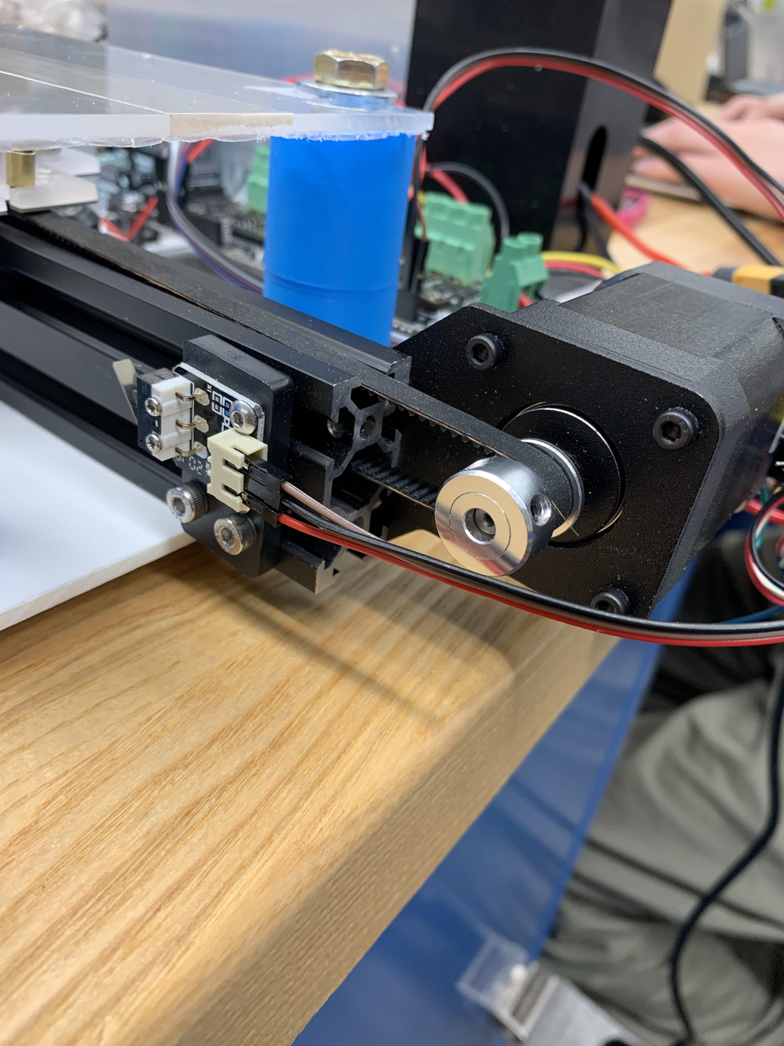
Media/Mechanism/IMG_4432.JPG
