yjc97/Haptic_Tablet/Media/Mechanism/IMG_4437.JPG

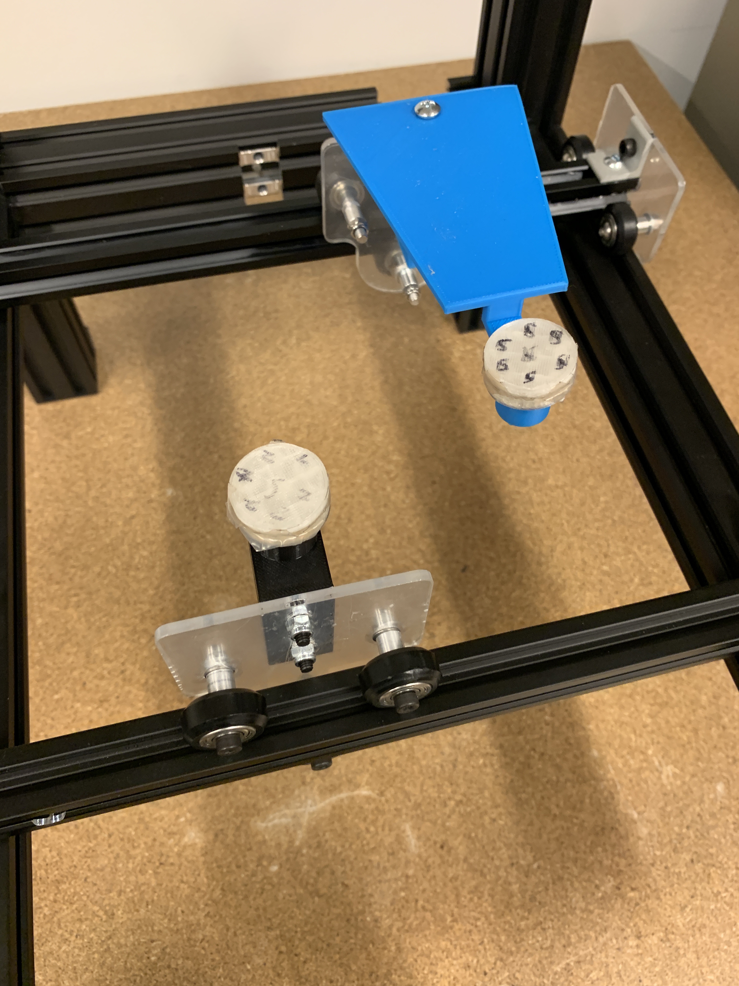
Media/Mechanism/IMG_4437.JPG
