yjc97/Haptic_Tablet/Media/Mechanism/IMG_4441.JPG

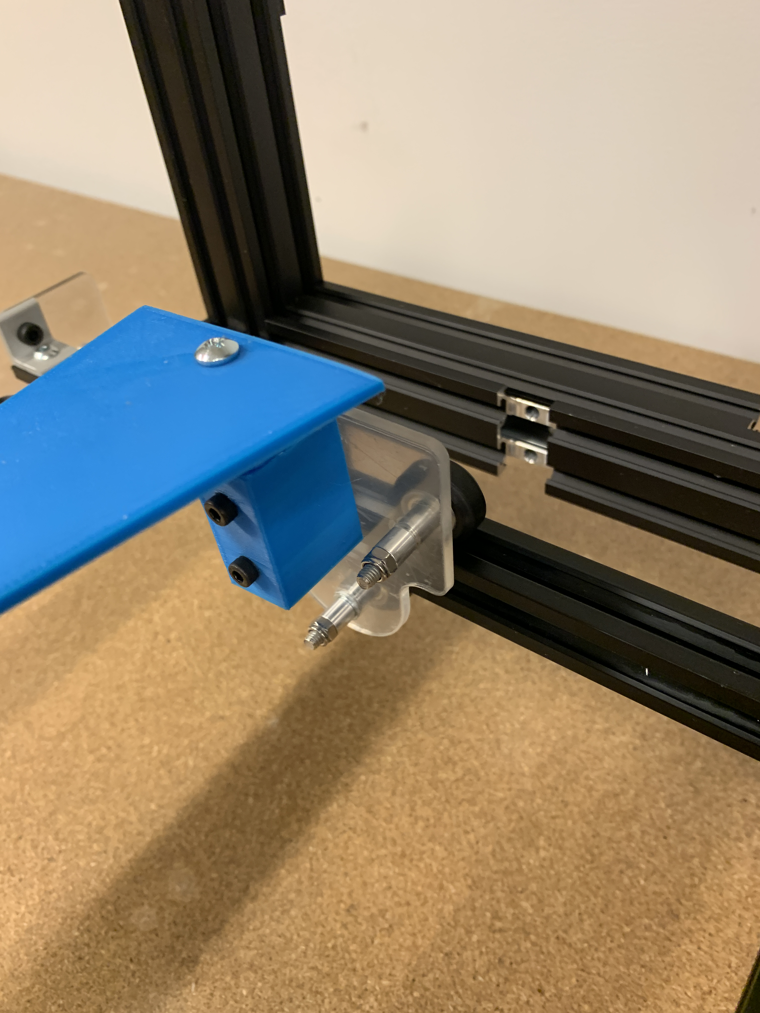
Media/Mechanism/IMG_4441.JPG
