yjc97/Haptic_Tablet/Media/Mechanism/IMG_4442.JPG

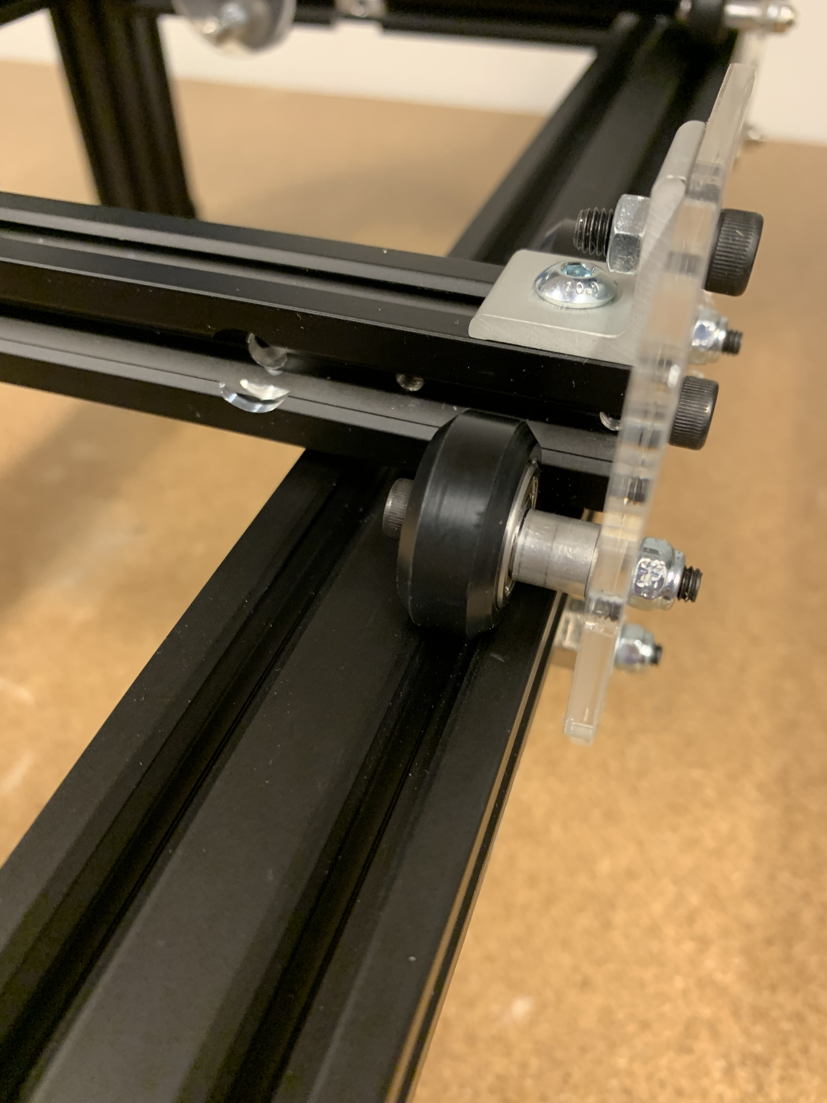
Media/Mechanism/IMG_4442.JPG
