yjc97/Haptic_Tablet/Media/Mechanism/IMG_4443.JPG

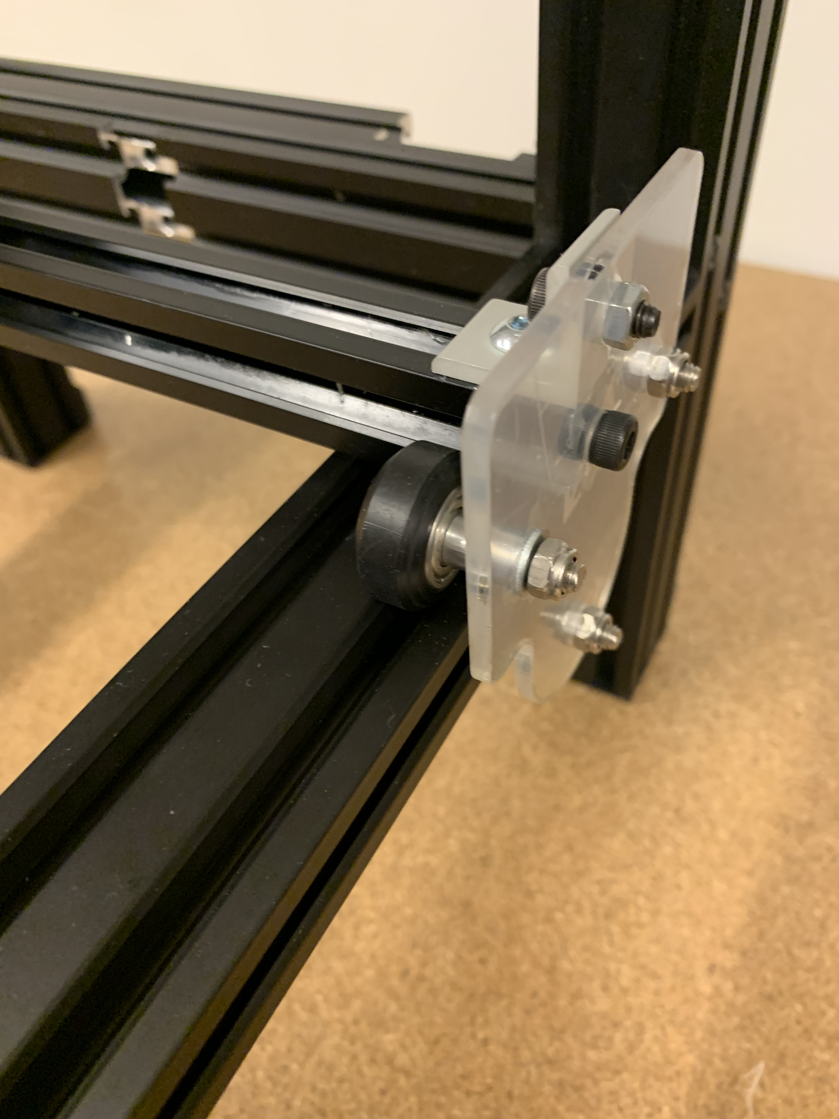
Media/Mechanism/IMG_4443.JPG
