yjc97/Haptic_Tablet/Media/Mechanism/IMG_4445.JPG

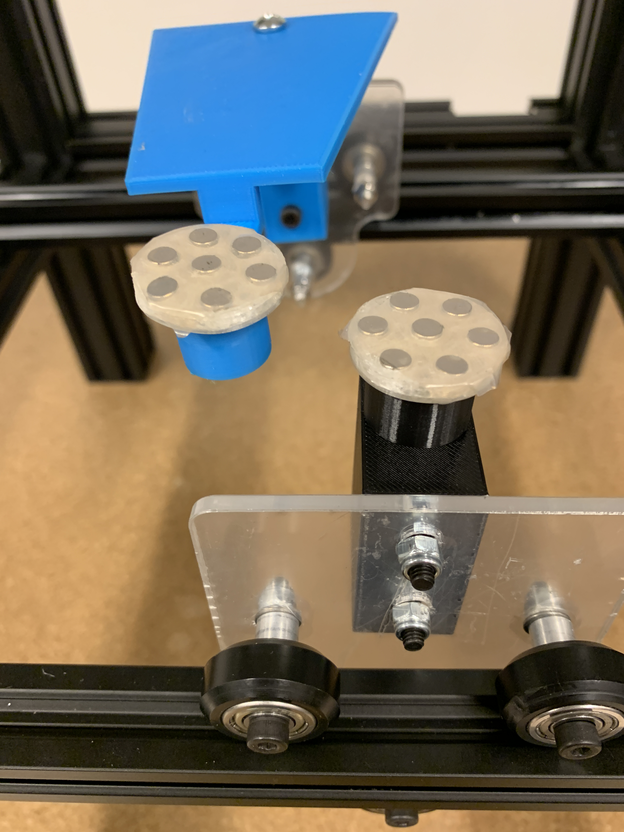
Media/Mechanism/IMG_4445.JPG
