yjc97/Haptic_Tablet/Media/Mechanism/IMG_4446.JPG

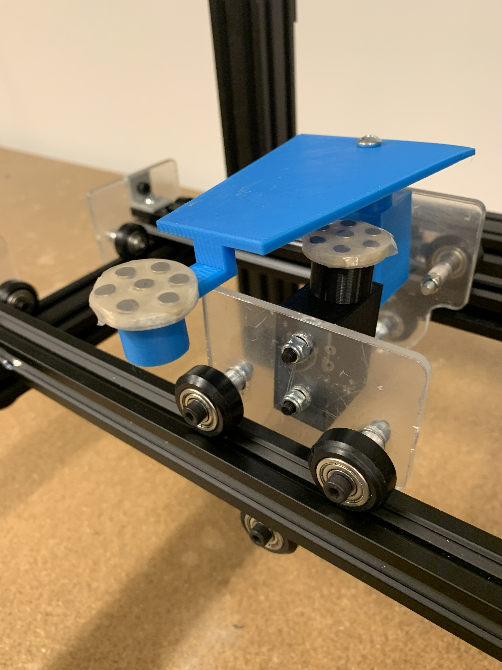
Media/Mechanism/IMG_4446.JPG
