yjc97/Haptic_Tablet/Media/Mechanism/IMG_4448.JPG

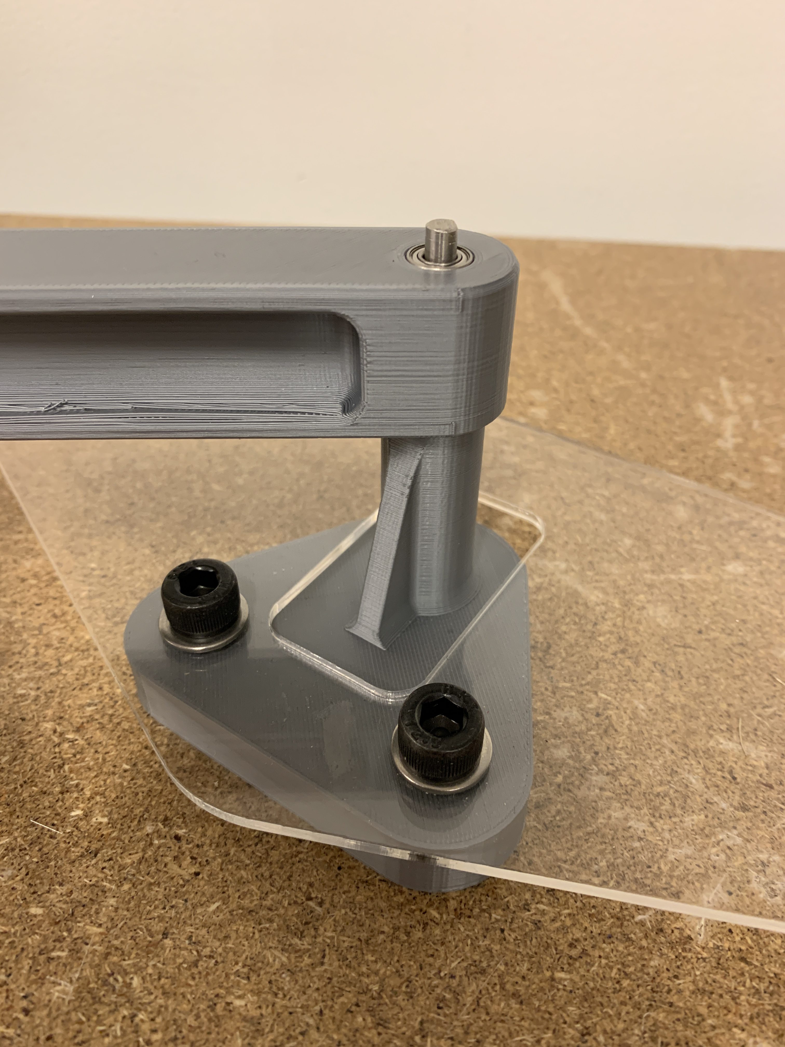
Media/Mechanism/IMG_4448.JPG
