yjc97/Haptic_Tablet/Mechanism/Magnet/Air Bearing Parts.docx

We need approximately 15 PSI to overcome the magnet force, however small aquarium pumps range from 0.5 psi to maybe 5 at the most.

Something like this would be dope:

# Awesome Tiny Compressor (https://www.amazon.com/NW-5V-6VDC-Miniature-Vacuum-100KPa/dp/B078H8V563)

4.3mm outlet so buy some 4mm tubing
