yjc97/Haptic_Tablet/Mechanism/Misc/Part Sourcing.docx

# Gantry

- [Amazon] V-2020 aluminum extrusion (https://www.amazon.com/OUYANG-Aluminum-Extrusion-European-Standard/dp/B0912PLFRX?hvadid=533110299309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)
  - 500 mm for $30
  - Should work with the wheels we have
- [Amazon] Official Creaility Ender 3 Printer (https://www.amazon.com/Comgrow-Creality-Ender-Aluminum-220x220x250mm/dp/B07BR3F9N6)
  - Full 3D printer that we destroyed
  - $189
- [Amazon] 3 rollers and face plate (https://www.amazon.com/dp/B09B3N2HBC?s=industrial)
  - $6
- [VXB] V-2020 aluminum extrusion (https://www.vxb.com/Black-Anodized-Aluminum-V-Slot-Extrusion-Profile-p/Anodized-Plate-Set-1000mm-Rail.htm)
  - 1000 mm for $40
  - Comes with face plate + 4 rollers

Adjustable screen prototype

⅜ - 16 Threaded rod - https://www.mcmaster.com/98957A132/

Plastic Threaded Inserts - https://www.mcmaster.com/90742A111/

Friction materials

⅛ PTFE balls - https://www.mcmaster.com/9660K13/

⅛ NYlon balls - https://www.mcmaster.com/9613K13/

1” by 15’ Teflon tape - https://www.mcmaster.com/6305A12/

12” x 12” x ⅛” Felt x 2 - https://www.mcmaster.com/2842T21/

8 x 10 x ⅛ Glass sheet x 2 - https://www.mcmaster.com/8476K714/

# Open-Chain Linkage

5 mm linear shaft, 200 mm length, QTY1 - https://www.mcmaster.com/1265K44/

Ball bearings, 5 mm shaft, QTY8 - https://www.mcmaster.com/7804K106/
Low-friction thrust bearing, QTY12 - https://www.mcmaster.com/8920N26/
Shaft collars, 5 mm diameter, QTY8 - https://www.mcmaster.com/3761N102/
