yjc97/Haptic_Tablet/Tablet BOM.xlsx

Sheet: Off-the-shelf
Part Name | Part Number(Link) | Vendor | Quantity Total | Already Have | Quantity To be Ordered | Price/Unit | Ordered? | Received? | Total Cost | Notes
Control System
BLDC Motor | BLY172D-24V-4000 (substituted: BLY172D-24V-2000) (https://www.anaheimautomation.com/products/brushless/brushless-motor-item.php?sID=143&pt=i&tID=96&cID=22) | AnaheimAutomation | 4 | 0 | 4 | $92.00 | TRUE | TRUE | $368.00
Gearbox, 5:1 | GBPS-0401-005-CS-AA171-197 (https://www.anaheimautomation.com/products/gearbox/planetary-gearbox-item.php?sID=786&pt=i&tID=1089&cID=30) | AnaheimAutomation | 4 | 0 | 4 | $231.00 | TRUE | TRUE | $924.00
Raspberry Pi 3b | N/A | N/A | 1 | 1 | 0 | $20.00 | TRUE | TRUE | $20.00
ODrive | ODrive 3.6 (https://odriverobotics.com/shop/odrive-v36) | ODriveRobotics | 2 | 1 | 1 | $200.00 | FALSE | FALSE | $400.00
Encoder | 490-AMT102-V (https://www.mouser.com/ProductDetail/CUI-Devices/AMT102-V?qs=WyjlAZoYn533PQfgnorrMg%3D%3D) | Mouser | 4 | 1 | 3 | $12.08 | FALSE | FALSE | $48.32
Power Supply | N/A | Creality | 1 | 1 | 0 | $0.00 | FALSE | FALSE | $0.00
Limit Switches | N/A | Creality | 4 | 4 | 0 | $0.00 | FALSE | FALSE | $0.00
 |  |  |  |  |  |  |  |  | $0.00
Mechanical |  |  |  |  |  |  |  |  | $0.00
8020 Extrusion(5 ft) | 5537T101 (https://www.mcmaster.com/5537T101/) | McMaster | 4 | 0 | 4 | $20.17 | TRUE | TRUE | $80.68 | Comes in 10 Ft pieces, get two | 80.68
8020 Brackets | 5537T935 (https://www.mcmaster.com/5537T935/) | McMaster | 35 | 0 | 35 | $7.17 | TRUE | TRUE | $250.95 |  | 250.95
24"x24" Frame Base Plate | 89015K48 (https://www.mcmaster.com/89015K48/) | McMaster | 1 | 0 | 1 | $108.44 | TRUE | TRUE | $108.44 |  | 108.44
80/20 Mounting Feet | 5537T982 (https://www.mcmaster.com/5537T982/) | McMaster | 4 | 0 | 4 | $6.29 | TRUE | TRUE | $25.16 |  | 25.16
Heat Set inserts | 94180A331 (https://www.mcmaster.com/94180A331/) | McMaster | 1 | 0 | 1 | $16.81 | TRUE | TRUE | $16.81 |  | 16.81
1045 Carbon Steel Keyed Rotary Shaft | 1439K221 (https://www.mcmaster.com/1439K221/) | McMaster | 2 | 0 | 2 | $30.92 | TRUE | TRUE | $61.84 |  | 61.84
Metal Sealing Washer | 97725A700 (https://www.mcmaster.com/97725A700/) | McMaster | 1 | 0 | 1 | $14.49 | TRUE | TRUE | $14.49 |  | 14.49
Stainless Steel Ball Bearing | 7804K117 (https://www.mcmaster.com/7804K117/) | McMaster | 24 | 0 | 24 | $7.11 | TRUE | TRUE | $170.64 |  | 170.64
Clamping Two-Piece Shaft Collar with Keyway | 3444N12 (https://www.mcmaster.com/3444N12/) | McMaster | 4 | 0 | 4 | $23.53 | TRUE | TRUE | $94.12 |  | 94.12
Thrust Ball Bearings | 6655K17 (https://www.mcmaster.com/6655K17/) | McMaster | 2 | 2 | 2 | $2.98 | TRUE | TRUE | $5.96 |  | 5.96
Teflon Balls, pack of 100 | 9660K13 (https://www.mcmaster.com/9660K13/) | McMaster | 1 | 0 | 1 | $15.19 | TRUE | TRUE | $15.19 |  | 15.19
3/4" polymagnet | 1000575 (https://catalog.polymagnet.com/polymagnet-products/attach/1000575.html) | Polymagnet | 2 | 2 | 0 |  | FALSE | FALSE
5/8" Polymagnet | 1002260 (https://catalog.polymagnet.com/polymagnet-products/attach/1002260.html) | Polymagnet | 1 | 1 | 0 | $3.55 | TRUE | TRUE | $3.55 |  | 0
1" Polymagnet | 1000563 (https://catalog.polymagnet.com/polymagnet-products/attach/1000563.html) | Polymagnet | 1 | 1 | 0 | $7.09 | TRUE | TRUE | $7.09 |  | 0
30 Tooth Pulley | 1277N787 (https://www.mcmaster.com/1277N787/) | McMaster | 4 | 0 | 4 | $20.51 | TRUE | TRUE | $82.04 |  | 82.04
Retaining ring, 8 mm shaft, packs of 100 | 90154A137 (https://www.mcmaster.com/90154A137/) | McMaster | 1 | 0 | 1 | $12.01 | TRUE | TRUE | $12.01 |  | 12.01
Socket Screw, M4x0.7x40L, packs of 5 | 91290A174 (https://www.mcmaster.com/91290A174/) | McMaster | 1 | 0 | 1 | $3.00 | TRUE | TRUE | $3.00 |  | 3
Flat Head Screw, M4x0.7x16L, packs of 100 | 92125A188 (https://www.mcmaster.com/92125A188/) | McMaster | 1 | 0 | 1 | $8.42 | TRUE | TRUE | $8.42 |  | 8.42
Socket Screw, M4x0.7x16L, packs of 100 | 91292A118 (https://www.mcmaster.com/91292A118/) | McMaster | 1 | 0 | 1 | $9.81 | TRUE | TRUE | $9.81 |  | 9.81
Magnet Bushing | 1988T11 (https://www.mcmaster.com/1988T11/) | McMaster | 1 | 0 | 1 | $17.67 | TRUE | TRUE | $17.67 |  | 17.67
Key Stock | 92288A710 (https://www.mcmaster.com/92288A710/?SrchEntryWebPart_InpBox=hex+bearings) | McMaster | 1 | 0 | 1 |  | TRUE | TRUE | $0.00
XL Timing Belt, 9" diameter | 1679K19 (https://www.mcmaster.com/1679K19/) | McMaster | 5 | 0 | 5 | $4.48 | FALSE | FALSE | $22.40
 |  |  |  |  |  |  |  |  | $0.00
 |  |  |  |  |  |  |  |  | $0.00
Stock |  |  |  |  |  |  |  |  | $0.00
STOCK-TB1-001-BASE-LINK | 8975K526 (https://www.mcmaster.com/8975K526-8975K524/) | McMaster | 1 | 1 | 0 | $48.38 | TRUE | FALSE | $48.38 | Ask Joe | 0
STOCK-TB1-002,003 | 8975K142-9246K44 (https://www.mcmaster.com/8975K142-9246K44/) | McMaster | 1 | 0 | 1 | $74.21 | TRUE | TRUE | $74.21 |  | 74.21
STOCK-TB1-004,006,008 | 8975K213-8975K441 (https://www.mcmaster.com/8975K213-8975K441/) | McMaster | 1 | 0 | 1 | $63.11 | TRUE | TRUE | $63.11 |  | 63.11
STOCK-TB1-005 | 1277N777 (https://www.mcmaster.com/1277N777/) | McMaster | 4 | 0 | 4 | $12.76 | TRUE | TRUE | $51.04 |  | 51.04
STOCK-TB1-009,011 | 8974K48 (https://www.mcmaster.com/8974K48-8974K282/) | McMaster | 1 | 0 | 1 | $6.89 | TRUE | FALSE | $6.89 | Only received 1 ft | 6.89
STOCK-TB1-007 | 5033N129 (https://www.mcmaster.com/5033N129/) | McMaster | 5 | 0 | 5 | $11.90 | FALSE | FALSE | $59.50 |  | 46.1
 |  |  |  |  |  |  |  |  | $3073.72 |  | 1218.58

Sheet: Manufactured Parts
Part name | Quantity | Process | Raw Stock Received? | Waterjet? | Drawing Made? | Part Made?
TB1-001-BASE-LINK | 4 | CNC |  | FALSE | TRUE | TRUE
TB1-002-DIST-LINK | 2 | Waterjet, Mill Finish |  | TRUE | TRUE | TRUE
TB1-003-PROX-LINK | 2 | Waterjet, Mill Finish |  | TRUE | TRUE | TRUE
TB1-004-TRANSMISSION-PLATE-TOP | 1 | Waterjet, Mill Finish |  | TRUE | TRUE | TRUE
TB1-005-DRIVE-PULLEY | 2 | Lathe |  |  | TRUE | TRUE
TB1-006-MOTOR-MOUNT | 2 | Waterjet, Mill Finish |  | TRUE | TRUE | TRUE
TB1-007-PROXIMAL-LINK-SHAFT | 6 | Lathe |  |  | TRUE | TRUE
TB1-008-TENSION-BAR | 4 | Waterjet, Mill Finish |  | TRUE | TRUE | TRUE
TB1-009-PULLEY-SPACER | 4 | Lathe |  |  | TRUE | TRUE
TB1-10-PHANTOM-PULLEY | 4 | Lathe,Mill |  |  | TRUE | TRUE | This is technically 2 different parts but whatever
TB1-011-PHANTOM-SPACER | 2 | Mill |  |  | TRUE | TRUE | May want to remake, 1 is M4 tapped other is M3 lol
TB1-012-OUTER-LINK | 2 | Waterjet, Mill Finish |  | TRUE | TRUE | TRUE
TB1-013-LINK-SPACER | 4 | Lathe |  |  | TRUE | TRUE
TB1-014-DISTAL-LINK-SHAFT | 2 | Lathe |  |  | TRUE | TRUE
TB1-015-MAGNET-BUSHING | 2 | Lathe |  |  | TRUE | TRUE
TB1-016-TRANSMISSION-PLATE-BOTTOM | 1 | Waterjet, Mill Finish |  | TRUE | TRUE | TRUE
TB1-017-OUTER-LINK-SHAFT | 2 | Lathe |  |  | TRUE | TRUE
TB1-018-POWER-SHAFT | 2 |  |  |  | TRUE | TRUE
