yjc97/Haptic_Tablet/Alpha/Rough Bom.xlsx

Description | Part No. | Vendor | Quantity | Price / ea. | Total Price | Total Price
XL timing belt pulley, 30 teeth | 1277N787 (https://www.mcmaster.com/1277N787/) | McMaster-Carr | 5 | $20.51 | $102.55 | $1644.96
Keyed shaft, 8mm diameter, 500mm long | 1439K221 (https://www.mcmaster.com/1439K221/) | McMaster-Carr | 1 | $30.92 | $30.92
Ball bearing, 8mm shaft, 16mm housing | 7804K117 (https://www.mcmaster.com/7804K117/) | McMaster-Carr | 20 | $7.11 | $142.20
Key Stock, 1/8" | 98830A520 (https://www.mcmaster.com/98830A520/) | McMaster-Carr | 1 | $4.69 | $4.69
Brushless Motor | BLY172D-24V-2000 (https://www.anaheimautomation.com/products/brushless/brushless-motor-item.php?sID=143&pt=i&tID=96&cID=22) | Anaheim | 4 | $92.00 | $368.00
5:1 Gearbox | GBPS-0401-CS-005 (https://www.anaheimautomation.com/products/gearbox/planetary-gearbox-item.php?sID=786&pt=i&tID=1089&cID=30) | Anaheim | 4 | $231.00 | $924.00
Metal Sealing Washer, 8.2 mm ID, Pack of 50 | 97725A700 (https://www.mcmaster.com/97725A700/) | McMaster-Carr | 1 | $14.49 | $14.49
Linear Motion Shaft, 8mm Dia, 400 mm long | 5033N135 (https://www.mcmaster.com/5033N135/) | McMaster-Carr | 1 | $46.10 | $46.10
Retaining ring, for 8mm shaft, pack of 100 | 90154A137 (https://www.mcmaster.com/90154A137/) | McMaster-Carr | 1 | $12.01 | $12.01
 |  |  |  |  | $0.00
 |  |  |  |  | $0.00
 |  |  |  |  | $0.00
 |  |  |  |  | $0.00
 |  |  |  |  | $0.00
 |  |  |  |  | $0.00
 |  |  |  |  | $0.00
 |  |  |  |  | $0.00
 |  |  |  |  | $0.00
 |  |  |  |  | $0.00
 |  |  |  |  | $0.00
 |  |  |  |  | $0.00
 |  |  |  |  | $0.00
 |  |  |  |  | $0.00
 |  |  |  |  | $0.00
 |  |  |  |  | $0.00
 |  |  |  |  | $0.00
 |  |  |  |  | $0.00
 |  |  |  |  | $0.00
 |  |  |  |  | $0.00
 |  |  |  |  | $0.00
 |  |  |  |  | $0.00
 |  |  |  |  | $0.00
 |  |  |  |  | $0.00
 |  |  |  |  | $0.00
 |  |  |  |  | $0.00
 |  |  |  |  | $0.00
 |  |  |  |  | $0.00
 |  |  |  |  | $0.00
 |  |  |  |  | $0.00
 |  |  |  |  | $0.00
 |  |  |  |  | $0.00
 |  |  |  |  | $0.00
 |  |  |  |  | $0.00
 |  |  |  |  | $0.00
 |  |  |  |  | $0.00
 |  |  |  |  | $0.00
 |  |  |  |  | $0.00
 |  |  |  |  | $0.00
 |  |  |  |  | $0.00
 |  |  |  |  | $0.00
 |  |  |  |  | $0.00
 |  |  |  |  | $0.00
 |  |  |  |  | $0.00
 |  |  |  |  | $0.00
 |  |  |  |  | $0.00
 |  |  |  |  | $0.00
 |  |  |  |  | $0.00
 |  |  |  |  | $0.00
 |  |  |  |  | $0.00
 |  |  |  |  | $0.00
 |  |  |  |  | $0.00
 |  |  |  |  | $0.00
 |  |  |  |  | $0.00
 |  |  |  |  | $0.00
 |  |  |  |  | $0.00
 |  |  |  |  | $0.00
 |  |  |  |  | $0.00
 |  |  |  |  | $0.00
 |  |  |  |  | $0.00
 |  |  |  |  | $0.00
 |  |  |  |  | $0.00
 |  |  |  |  | $0.00
 |  |  |  |  | $0.00
 |  |  |  |  | $0.00
 |  |  |  |  | $0.00
 |  |  |  |  | $0.00
 |  |  |  |  | $0.00
 |  |  |  |  | $0.00
 |  |  |  |  | $0.00
 |  |  |  |  | $0.00
 |  |  |  |  | $0.00
 |  |  |  |  | $0.00
 |  |  |  |  | $0.00
 |  |  |  |  | $0.00
 |  |  |  |  | $0.00
 |  |  |  |  | $0.00
 |  |  |  |  | $0.00
 |  |  |  |  | $0.00
 |  |  |  |  | $0.00
 |  |  |  |  | $0.00
 |  |  |  |  | $0.00
 |  |  |  |  | $0.00
 |  |  |  |  | $0.00
 |  |  |  |  | $0.00
 |  |  |  |  | $0.00
 |  |  |  |  | $0.00
 |  |  |  |  | $0.00
