yjc97/Haptic_Tablet/Mechanism/Misc/PHANTOM_2R_PARTS_LIST.xlsx

Item | Part No. | QTY | Price / ea. | Total Price
Ball Bearing, for 6 mm shaft | 7804K112 (https://www.mcmaster.com/7804K112/) | 20 | $8.89 | $177.80
Shaft, 6 mm DIa, 500 mm long | 5033N127 (https://www.mcmaster.com/5033N127/) | 1 | $56.18 | $56.18
Timing belt pulley, for 6 mm wide belt | 1375K147 (https://www.mcmaster.com/1375K147/) | 4 | $19.58 | $78.32
Snap ring, for 6 mm shaft, pack of 100 | 90154A111 (https://www.mcmaster.com/90154A111/) | 1 | $8.48 | $8.48
Timing belt, 6 mm wide, 162mm outside | 5027N48 (https://www.mcmaster.com/5027N48/) | 3 | $5.77 | $17.31
M3 screw, 12 mm long, 18-8 ss | 92125A132 (https://www.mcmaster.com/92125A132/) | 1 | $6.77 | $6.77
Thrust bearing, 6mm ID | 8920N29 (https://www.mcmaster.com/8920N29/) | 15 | $1.23 | $18.45
M5x0.8x50L SHCS, pack of 25 | 91292A196 (https://www.mcmaster.com/91292A196/) | 1 | $9.72 | $9.72
M5x0.8x25L Flat screw, pack of 25 | 93395A313 (https://www.mcmaster.com/93395A313/) | 1 | $9.01 | $9.01
 |  |  |  | $373.03
