yjc97/Haptic_Tablet/Mechanism/Magnet/Magnets Listings.xlsx

# | Name | Description | TB Designed | TB Printed | TB ordered | Completion
1 | 1/2 Top | -1/2 polymagnet mcmaster -1/2 dia thrust bearing -15/16 peg (encompasses thrust) | - Peg "Finger puck v2" | - Peg | -1/2 dia thrust bearing | TRUE
2 | 1/2 Top | -1/2 polymagnet mcmaster -5/8 dia thrust bearing - Holding structure -1 1/8'' peg (encompasses thrust) | - Peg "Finger puck v3" - Holding Structure "Magnet Peg Top V11_1_2MC" | - Peg - Holding Structure | -5/8 dia thrust bearing | TRUE
3 | 1 Bottom | -1 polymagnet -1 bottom peg | - Botttom Peg "Magnet Peg V12_1in_wballs" | - Botttom Peg |  | TRUE
4 | 1 Bottom | -1 polymagnet -1 dia thrust bearing -Holding structure | - Holding structure "Magnet Peg V12_1in_wrollers" | - Holding Structure |  | TRUE
