yjc97/Haptic_Tablet/CAD/Tablet Capstone/Initial Prototypes/Mechanism Team/Air Bearings/AirBearing Assembly.SLDASM

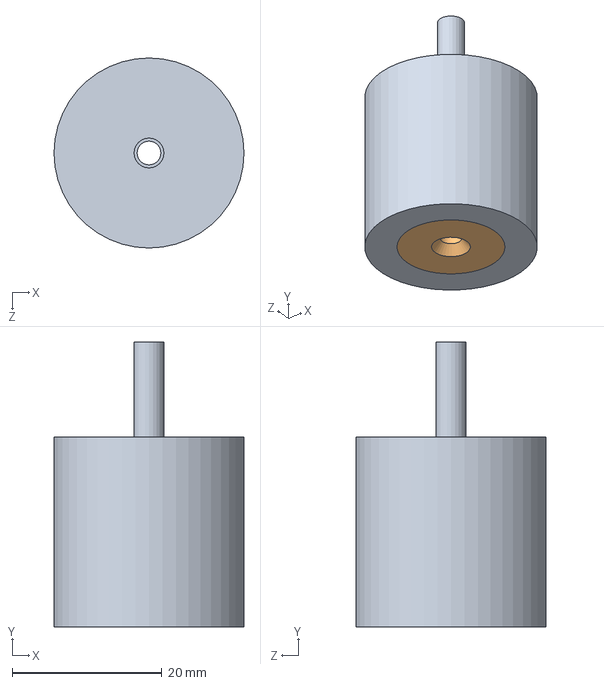
[picture p148: CAD file, 2022-11-08]
CAD/Tablet Capstone/Initial Prototypes/Mechanism Team/Air Bearings/AirBearing Assembly.SLDASM
25.4 x 38.1 x 25.4 mm
MagnetToHoseAdapter
