yjc97/Haptic_Tablet/CAD/Tablet Capstone/Initial Prototypes/Mechanism Team/Ender3 Files/ASM Frame.step.SLDASM

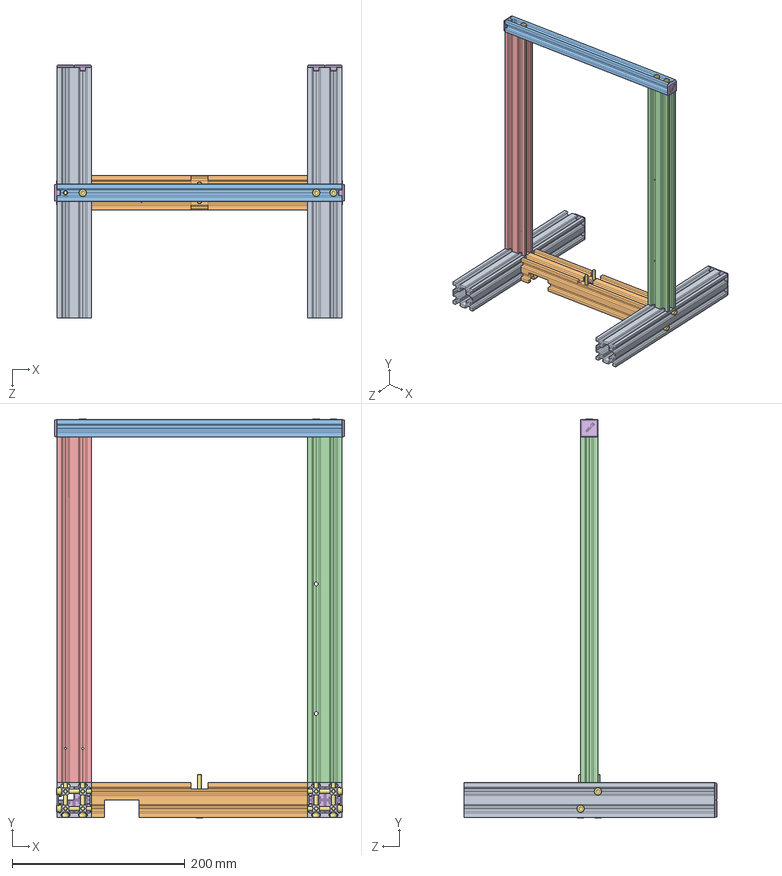
[picture p149: CAD file, 2022-11-08]
CAD/Tablet Capstone/Initial Prototypes/Mechanism Team/Ender3 Files/ASM Frame.step.SLDASM
335.7 x 461.6 x 292.9 mm
4040 profile.step x 2
4040-3 profile.step
2040-3R profile.step
2040-3L profile.step
2020 Endcap.step x 9
M5X45 Socket Head Screw.step x 13
