yjc97/Haptic_Tablet/CAD/Tablet Capstone/Frame/FrameAssem.SLDASM

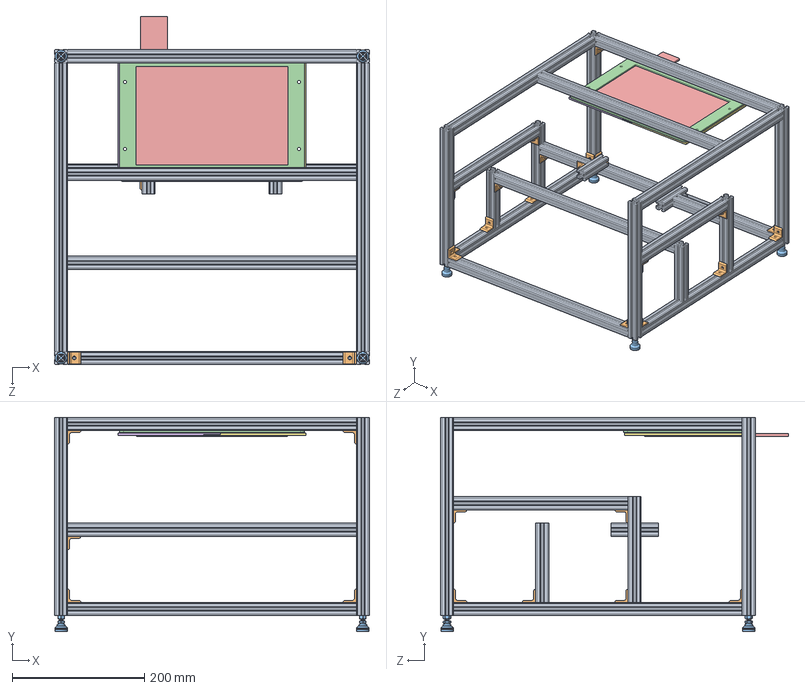
[picture p150: CAD file, 2022-11-08]
CAD/Tablet Capstone/Frame/FrameAssem.SLDASM
477.2 x 324.3 x 527.4 mm
ShortCornerBracket x 20
5537T982_feet x 4
ScreenMountPlate
TabletScreen
TopLeft
TopRight
