yjc97/Haptic_Tablet/CAD/Tablet Capstone/Initial Prototypes/1DOF Actuator Team/V2/EnderY/Ensamblaje_Tensor_Eje_Y.SLDASM

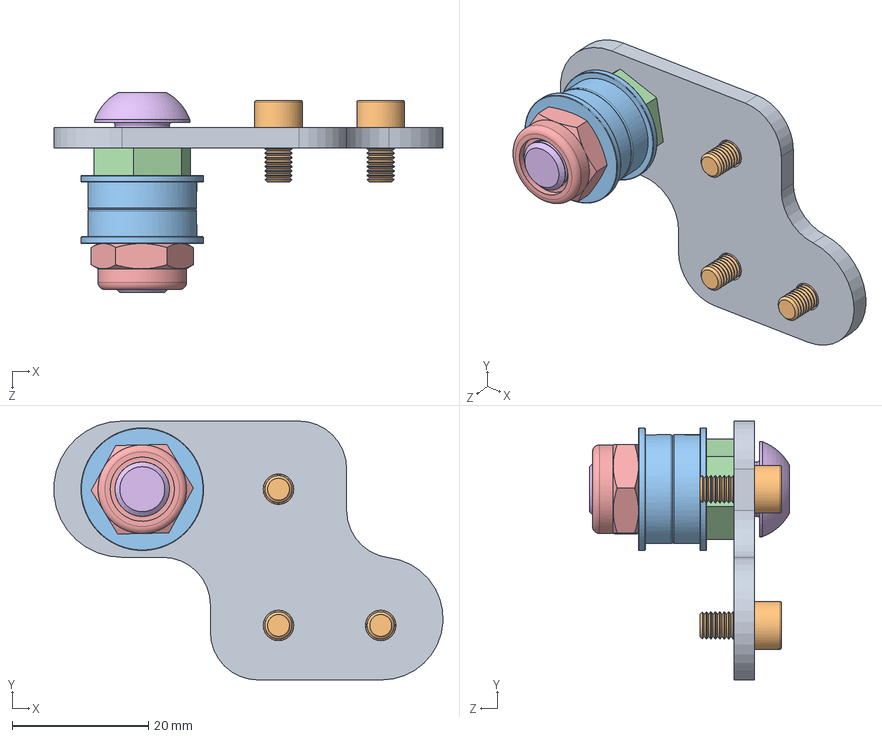
[picture p151: CAD file, 2022-11-08]
CAD/Tablet Capstone/Initial Prototypes/1DOF Actuator Team/V2/EnderY/Ensamblaje_Tensor_Eje_Y.SLDASM
57.1 x 38.0 x 29.4 mm
Base_Tensor_Y
socket head cap screw_iso x 3
Cojinete x 2
hex thin nut gradeb_iso
torque nut 08_iso
socket button head screw_iso
