yjc97/Haptic_Tablet/CAD/Tablet Capstone/Initial Prototypes/Mechanism Team/Magnets/First Quarter - Final Magnet/Top Magnets.SLDASM

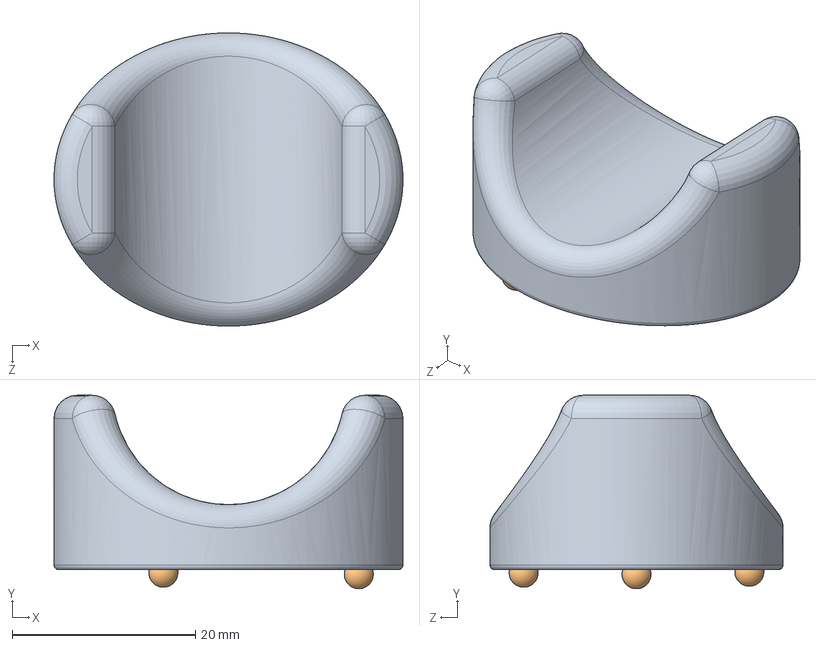
[picture p152: CAD file, 2022-11-08]
CAD/Tablet Capstone/Initial Prototypes/Mechanism Team/Magnets/First Quarter - Final Magnet/Top Magnets.SLDASM
38.1 x 21.1 x 32.0 mm
Finger puck v4
Teflon Balls x 3
Polymagnet
