yjc97/Haptic_Tablet/CAD/Tablet Capstone/ALPHA/TB1-DRIVE-TRAIN.SLDASM

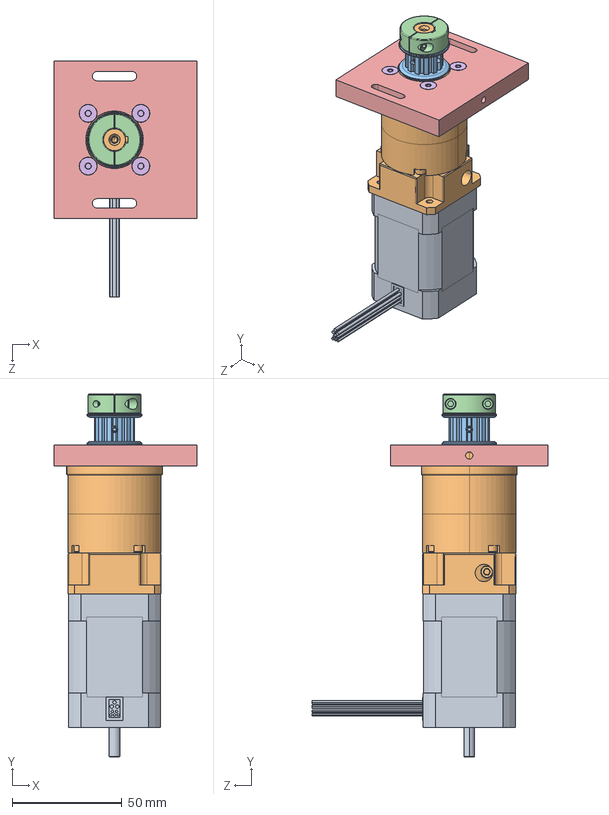
[picture p153: CAD file, 2022-11-08]
CAD/Tablet Capstone/ALPHA/TB1-DRIVE-TRAIN.SLDASM
65.0 x 165.5 x 107.8 mm
BLY172D
GBPS-0401-CS-AA171-197
TB1-005-DRIVE-PULLEY
3444N12_SHAFT-COLLAR_10MM-SHAFT
TB1-006-MOTOR-MOUNT
92125A188_FLAT-SCREW_M4X0.7X8L x 4
