yjc97/Haptic_Tablet/CAD/Tablet Capstone/Frame/ScreenStuff/CasePieces_ForPrinting/CaseAssem_SeperateParts.SLDASM

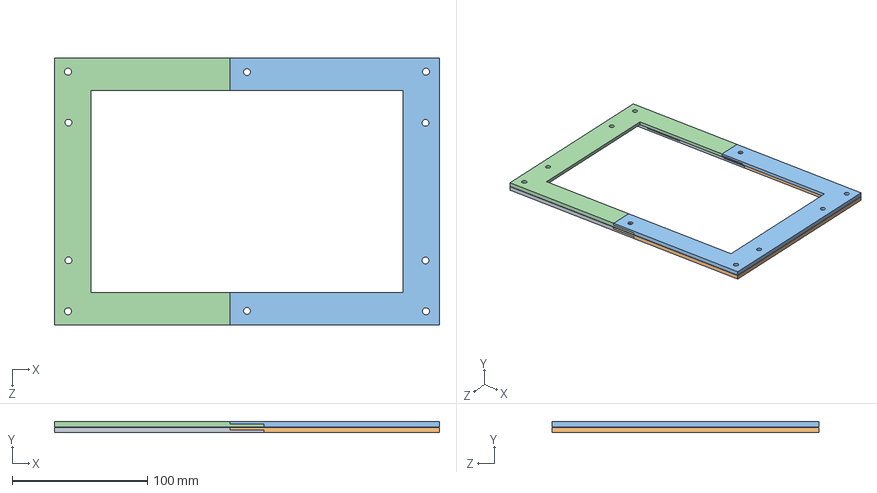
[picture p154: CAD file, 2022-11-08]
CAD/Tablet Capstone/Frame/ScreenStuff/CasePieces_ForPrinting/CaseAssem_SeperateParts.SLDASM
284.2 x 8.39 x 196.9 mm
BottomLeft
BottomRight
TopRight
TopLeft
