yjc97/Haptic_Tablet/CAD/Tablet Capstone/Initial Prototypes/Mechanism Team/PH2R-PROTOTYPE/PH2R-COMMON-LINKAGE.SLDASM

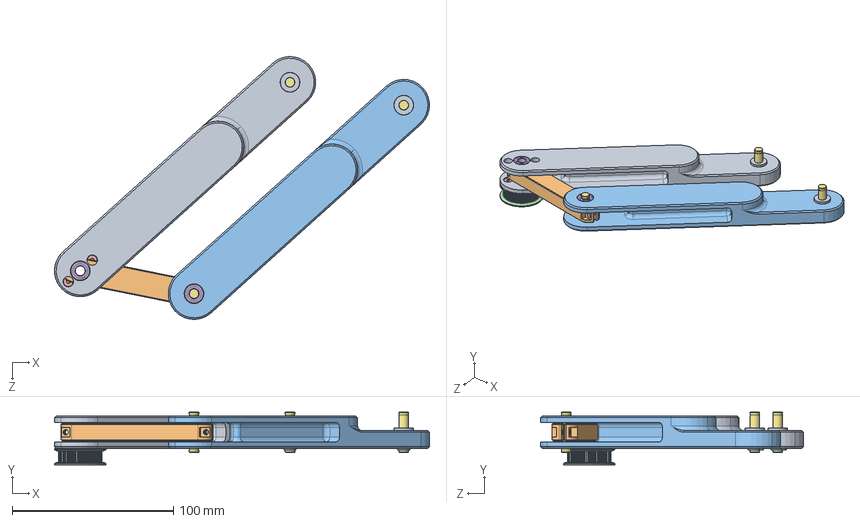
[picture p155: CAD file, 2022-11-08]
CAD/Tablet Capstone/Initial Prototypes/Mechanism Team/PH2R-PROTOTYPE/PH2R-COMMON-LINKAGE.SLDASM
232.7 x 32.8 x 163.1 mm
PH2R-BASE-LINK
PH2R-CON-LINK
PH2R-ACT-LINK
1375K147_PULLEY_32MM_NO-HUB
92125A132_M3X12 x 2
7804K112_BEARING x 8
5033N127_6MM-SHAFT_24MM x 3
90154A111_SNAP_RING x 2
8920N29_THRUST-WASHER x 2
