yjc97/Haptic_Tablet/CAD/Tablet Capstone/ALPHA/TB1-PHANTOM-LINKAGE.SLDASM

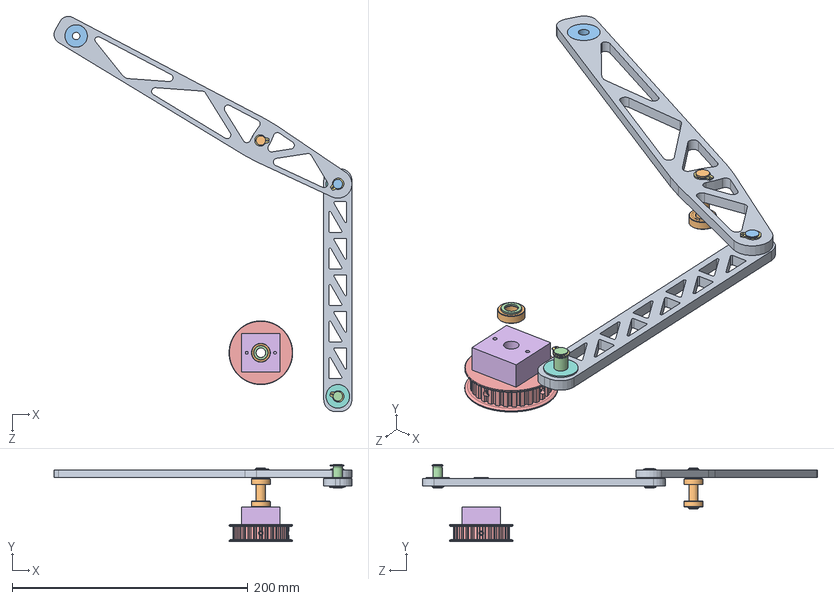
[picture p156: CAD file, 2022-11-08]
CAD/Tablet Capstone/ALPHA/TB1-PHANTOM-LINKAGE.SLDASM
252.7 x 65.4 x 335.2 mm
TB1-002-DIST-LINK
7804K117_BALL-BEARING_8MM-SHAFT x 6
TB1-017-OUTER-LINK-SHAFT
TB1-007-PROXIMAL-LINK-SHAFT
TB1-010-PHANTOM-PULLEY
TB1-011-PHANTOM-SPACER
90154A137_External Retaining Ring (1) x 6
TB1-013-LINK-SPACER x 2
TB1-012-OUTER-LINK
TB1-014-DISTAL-LINK-SHAFT
TB1-015-MAGNET-BUSHING
97725A700_WASHER_8MMID x 2
