yjc97/Haptic_Tablet/CAD/Tablet Capstone/Initial Prototypes/1DOF Actuator Team/V2/EnderY/Ensamblaje_Rueda_Excentrica_EjeY.SLDASM

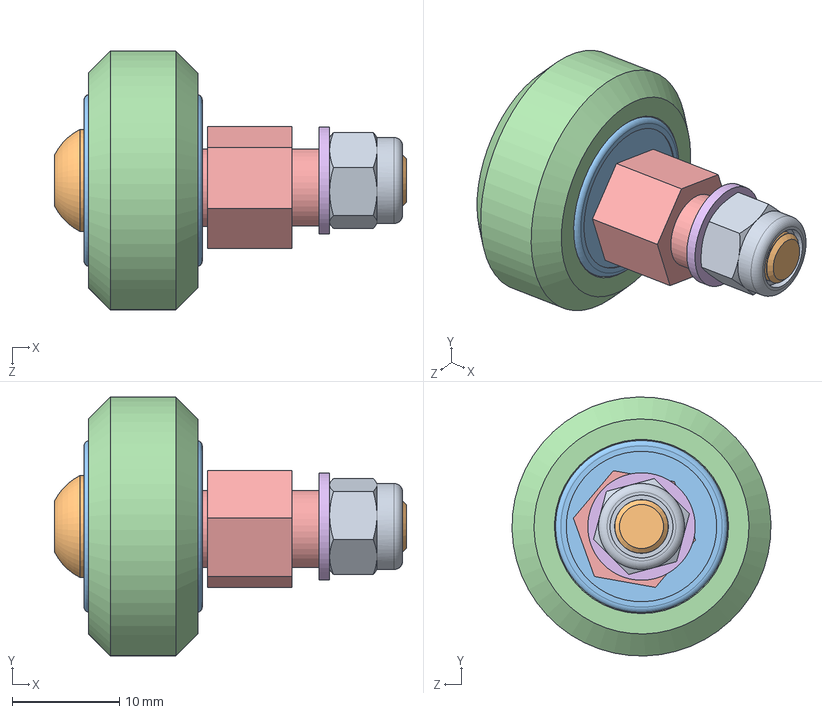
[picture p157: CAD file, 2022-11-08]
CAD/Tablet Capstone/Initial Prototypes/1DOF Actuator Team/V2/EnderY/Ensamblaje_Rueda_Excentrica_EjeY.SLDASM
32.8 x 24.1 x 24.1 mm
torque nut 01_iso
socket button head screw_iso
Rodamiento x 2
Rueda
Separador
plain washer normal grade a_iso
