yjc97/Haptic_Tablet/CAD/Tablet Capstone/Initial Prototypes/Mechanism Team/Ender3 Files/DenisSofron_Proyecto_EG_Ender_3_PackandGo/Ensamblaje_Fuente_Alimentacion.SLDASM

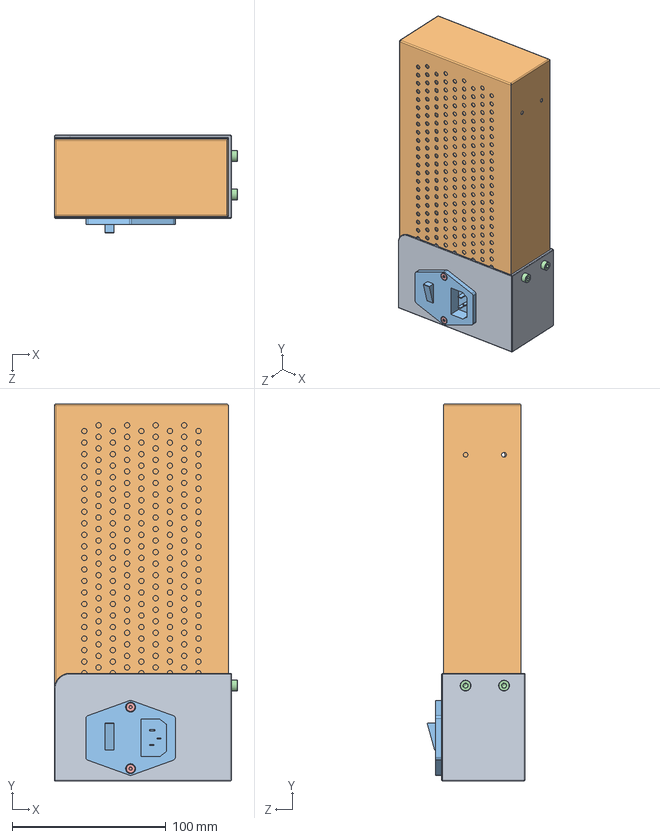
[picture p158: CAD file, 2022-11-08]
CAD/Tablet Capstone/Initial Prototypes/Mechanism Team/Ender3 Files/DenisSofron_Proyecto_EG_Ender_3_PackandGo/Ensamblaje_Fuente_Alimentacion.SLDASM
119.0 x 245.0 x 63.5 mm
Base
Fuente_General
Slot_Enchufe
socket head cap screw_iso x 2
socket countersunk head screw_iso x 2
