yjc97/Haptic_Tablet/CAD/Tablet Capstone/Initial Prototypes/1DOF Actuator Team/V2/1DOF V2 Assembly.SLDASM

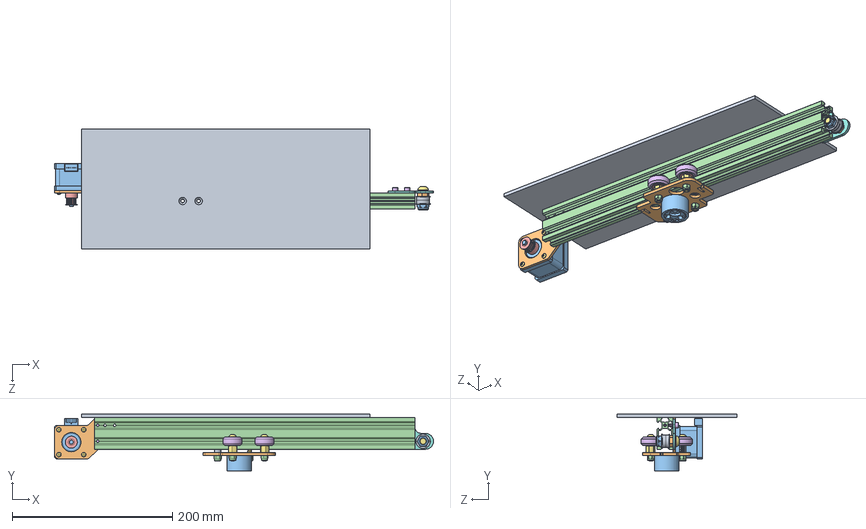
[picture p159: CAD file, 2022-11-08]
CAD/Tablet Capstone/Initial Prototypes/1DOF Actuator Team/V2/1DOF V2 Assembly.SLDASM
473.1 x 70.8 x 150.0 mm
Base Plate
Base_Sujecion
Motor_PasoaPaso
Perfil
Polea
socket head cap screw_iso x 5
socket button head screw_iso x 9
Base_Tensor_Y
Cojinete x 2
hex thin nut gradeb_iso
torque nut 08_iso
torque nut 01_iso x 4
Rodamiento x 8
Rueda x 4
Separador x 2
plain washer normal grade a_iso x 2
Electromagnet Belt Mounting Plate
Gantry Magnet Mount
