yjc97/Haptic_Tablet/CAD/Tablet Capstone/Initial Prototypes/Mechanism Team/GantryPrototype/Gantry-X-Axis.SLDASM

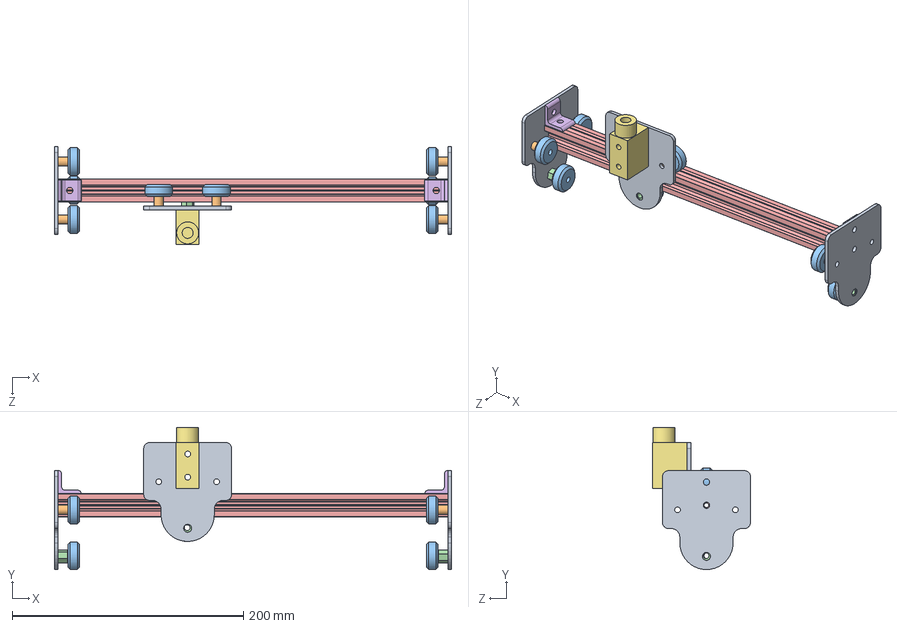
[picture p160: CAD file, 2022-11-08]
CAD/Tablet Capstone/Initial Prototypes/Mechanism Team/GantryPrototype/Gantry-X-Axis.SLDASM
343.2 x 123.1 x 84.6 mm
WheelPlates x 3
WheelSpacers x 6
Wheels x 9
eccentric_nut x 3
20x20Extrusion-XAxis
5537T935_T-Slotted Framing x 2
MagnetHolderV1
