yjc97/Haptic_Tablet/CAD/Tablet Capstone/Initial Prototypes/1DOF Actuator Team/V2/Ender3 Y Axis Modified.SLDASM

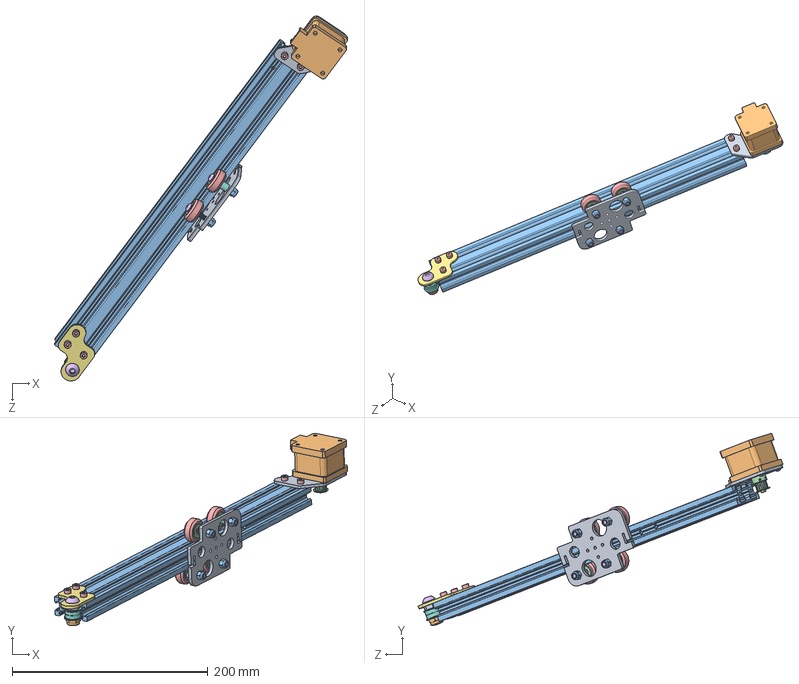
[picture p161: CAD file, 2022-11-08]
CAD/Tablet Capstone/Initial Prototypes/1DOF Actuator Team/V2/Ender3 Y Axis Modified.SLDASM
299.4 x 196.5 x 372.5 mm
Base_Sujecion
Motor_PasoaPaso
Perfil
Polea
socket head cap screw_iso x 5
socket button head screw_iso x 9
Base_Tensor_Y
Cojinete x 2
hex thin nut gradeb_iso
torque nut 08_iso
torque nut 01_iso x 4
Rodamiento x 8
Rueda x 4
Separador x 2
plain washer normal grade a_iso x 2
Electromagnet Belt Mounting Plate
