yjc97/Haptic_Tablet/CAD/Tablet Capstone/Initial Prototypes/Mechanism Team/CABLE-BOT-PROTOTYPE/CABLE-CARRIAGE.SLDASM

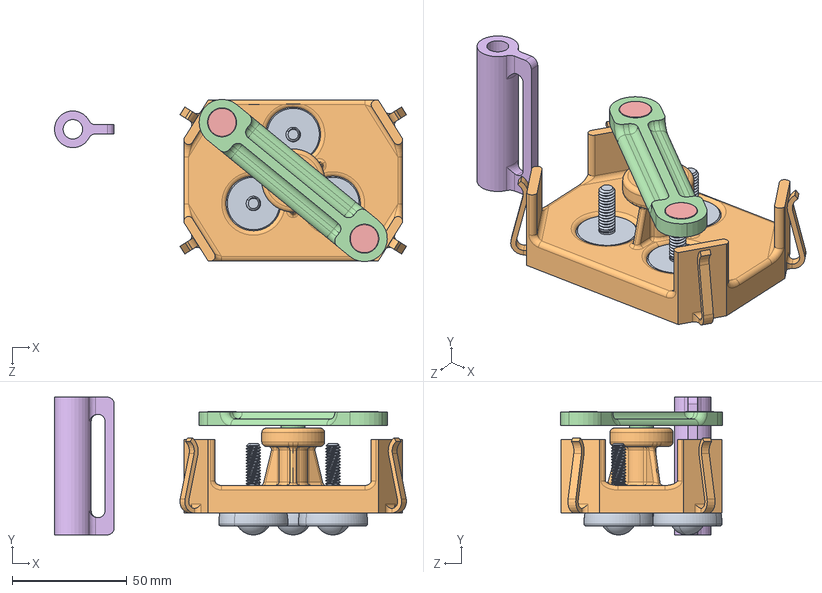
[picture p162: CAD file, 2022-11-08]
CAD/Tablet Capstone/Initial Prototypes/Mechanism Team/CABLE-BOT-PROTOTYPE/CABLE-CARRIAGE.SLDASM
153.2 x 60.0 x 70.6 mm
6460K21 x 3
CABLE-CARRIAGE
7804K117
MAGNET-SUPPORT
5862K105 x 2
SCREEN-SUPPORT
