yjc97/Haptic_Tablet/CAD/Tablet Capstone/Initial Prototypes/Mechanism Team/Ender3 Files/DenisSofron_Proyecto_EG_Ender_3_PackandGo/Ensamblaje_Eje_Z.SLDASM

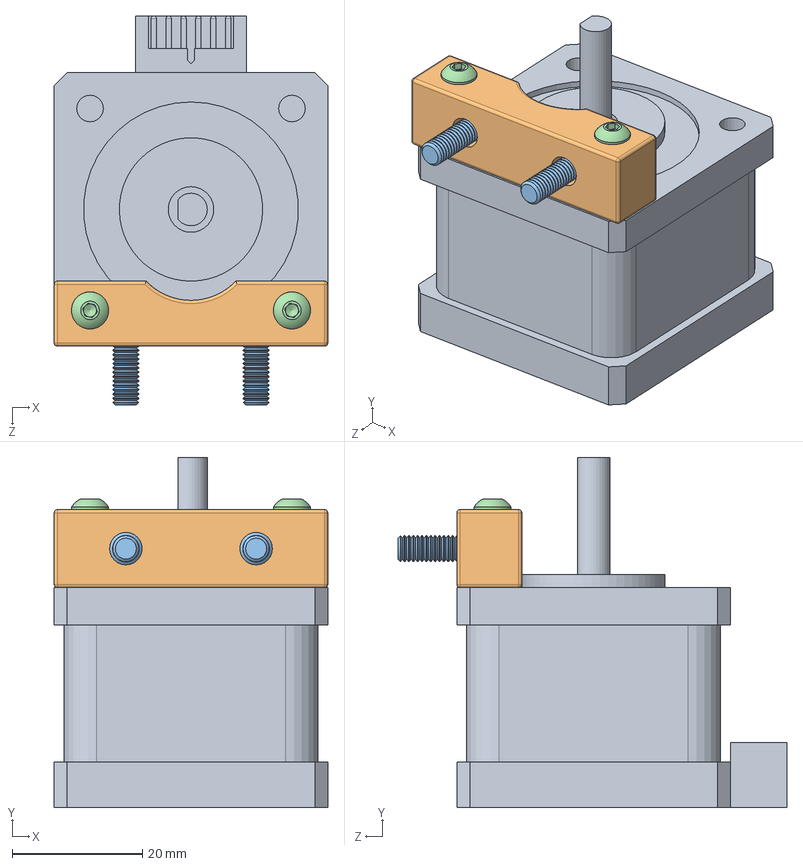
[picture p163: CAD file, 2022-11-08]
CAD/Tablet Capstone/Initial Prototypes/Mechanism Team/Ender3 Files/DenisSofron_Proyecto_EG_Ender_3_PackandGo/Ensamblaje_Eje_Z.SLDASM
42.0 x 53.8 x 59.7 mm
Motor_PasoaPaso
Pieza_Agarrar
socket countersunk head screw_iso x 2
socket button head screw_iso x 2
