yjc97/Haptic_Tablet/CAD/Tablet Capstone/Initial Prototypes/1DOF Actuator Team/V2/EnderY/Ensamblaje_Tornillería_Ruedas.SLDASM

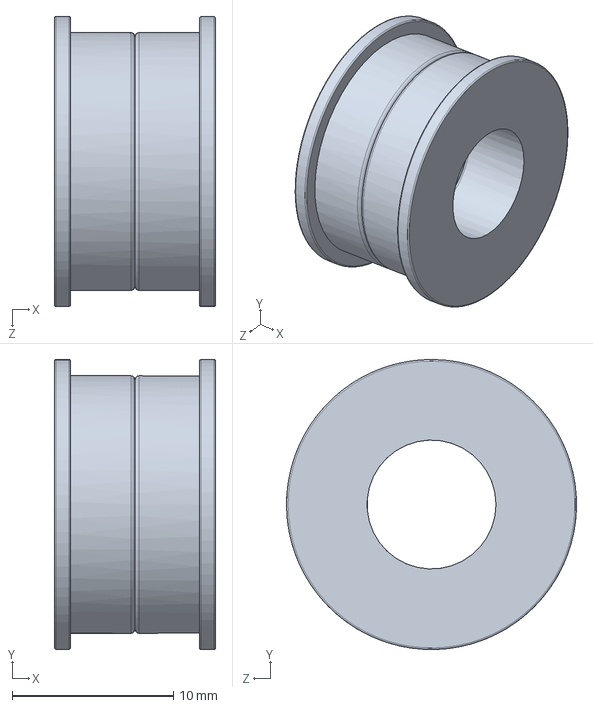
[picture p164: CAD file, 2022-11-08]
CAD/Tablet Capstone/Initial Prototypes/1DOF Actuator Team/V2/EnderY/Ensamblaje_Tornillería_Ruedas.SLDASM
10.0 x 18.0 x 18.0 mm
Cojinete x 2
