yjc97/Haptic_Tablet/CAD/Tablet Capstone/Initial Prototypes/Mechanism Team/2R-ARM-PROTOTYPE/2R-LINKAGE.SLDASM

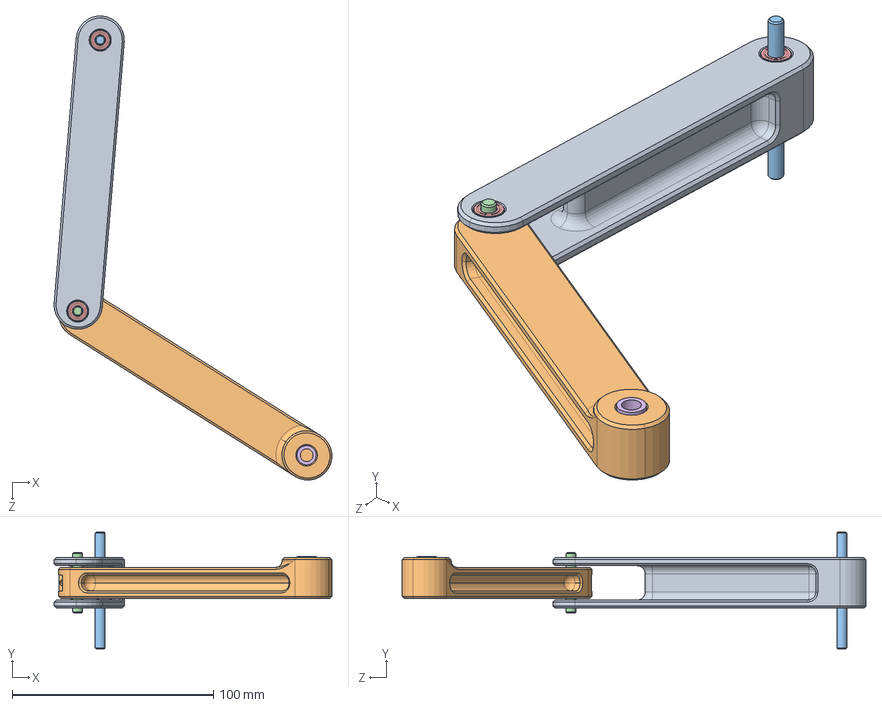
[picture p165: CAD file, 2022-11-08]
CAD/Tablet Capstone/Initial Prototypes/Mechanism Team/2R-ARM-PROTOTYPE/2R-LINKAGE.SLDASM
137.9 x 58.0 x 230.3 mm
2R-BASE-LINK
2R-END-LINK
1265K44-58MM
1265K44-30MM
7804K106-BEARING x 4
2639T7-PTFE-SLEEVE-BEARING
