yjc97/Haptic_Tablet/CAD/Tablet Capstone/Initial Prototypes/Mechanism Team/AdjustableScreen/AdjustableScreen.SLDASM

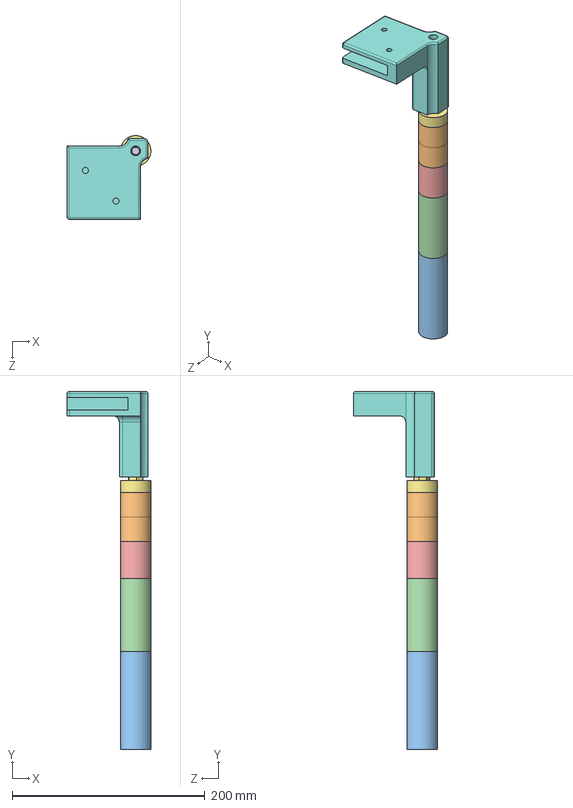
[picture p166: CAD file, 2022-11-08]
CAD/Tablet Capstone/Initial Prototypes/Mechanism Team/AdjustableScreen/AdjustableScreen.SLDASM
87.0 x 371.8 x 87.0 mm
98957A132_Grade B7 Medium-Strength Steel Threaded Rod
RiserSpacer1.0 x 2
RiserSpacer4.0
RiserSpacer3.0
RiserSpacer1.5
95462A031_Medium-Strength Steel Hex Nut
RiserSpacer0.5
GlassAdapter
