yjc97/Haptic_Tablet/CAD/Tablet Capstone/Initial Prototypes/Mechanism Team/GantryPrototype/Gantry.SLDASM

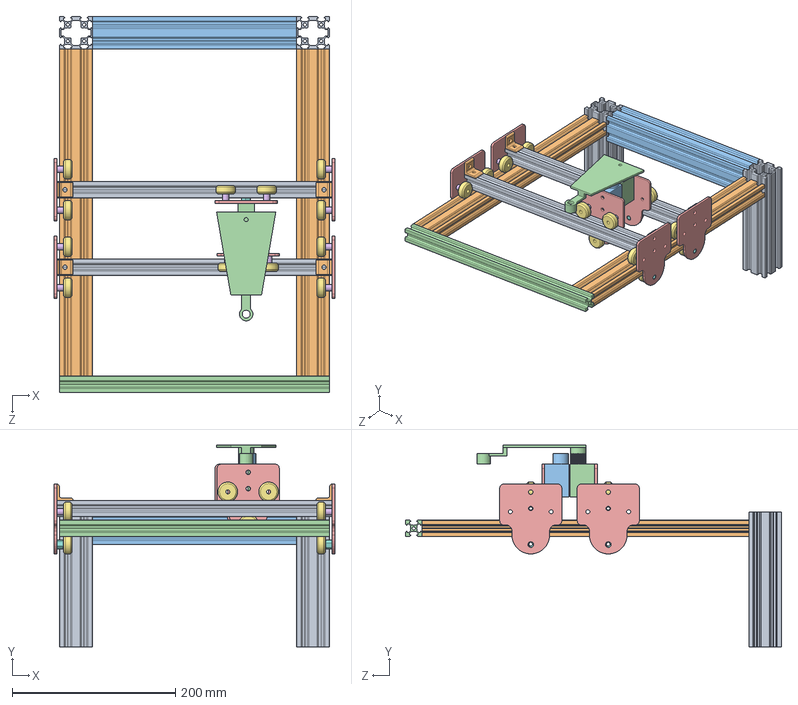
[picture p167: CAD file, 2022-11-08]
CAD/Tablet Capstone/Initial Prototypes/Mechanism Team/GantryPrototype/Gantry.SLDASM
343.2 x 246.8 x 460.0 mm
40x40Extrusion x 2
20x40Extrusion x 2
40x40Extrusion-CenterPiece
20x20Extrusion-FrameTop
WheelPlates x 6
WheelSpacers x 12
Wheels x 18
eccentric_nut x 6
20x20Extrusion-XAxis x 2
5537T935_T-Slotted Framing x 4
MagnetHolderV1
MagnetHolderOverhang
