yjc97/Haptic_Tablet/CAD/Tablet Capstone/Initial Prototypes/Mechanism Team/Magnets/First Quarter - Final Magnet/Bottom Magnet.SLDASM

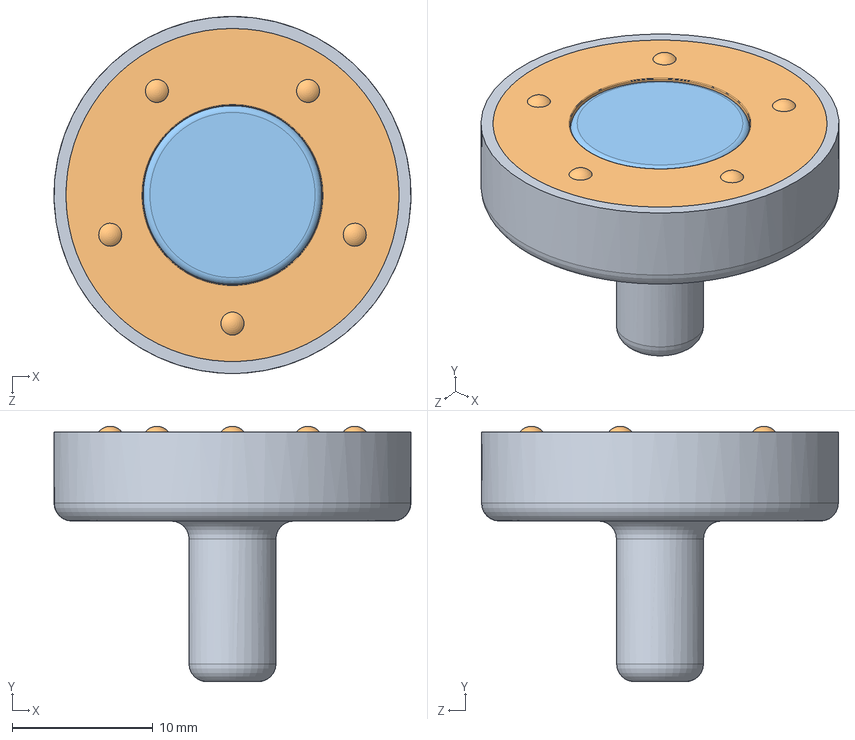
[picture p168: CAD file, 2022-11-08]
CAD/Tablet Capstone/Initial Prototypes/Mechanism Team/Magnets/First Quarter - Final Magnet/Bottom Magnet.SLDASM
25.4 x 18.2 x 25.4 mm
Magnet Peg Bottom V13
6655K17_Thrust Ball Bearing
2494N11_Multi-Pole Neodymium Magnet
