yjc97/Haptic_Tablet/CAD/Tablet Capstone/Initial Prototypes/Mechanism Team/PH2R-PROTOTYPE/PH2R-ANCHOR.SLDASM

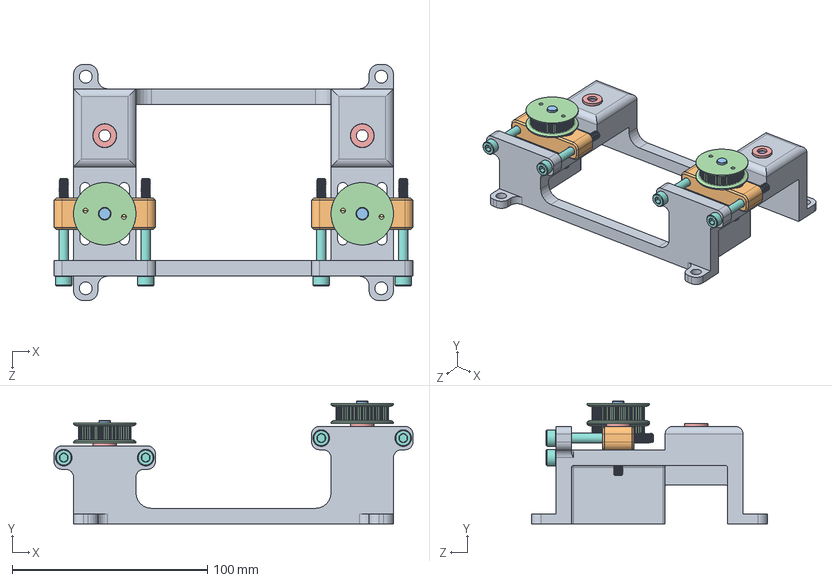
[picture p169: CAD file, 2022-11-08]
CAD/Tablet Capstone/Initial Prototypes/Mechanism Team/PH2R-PROTOTYPE/PH2R-ANCHOR.SLDASM
184.0 x 63.0 x 121.0 mm
PH2R-MOUNT
PH2R-PULLEY-SLIDE x 2
5033N127_6MM-SHAFT_24MM x 2
1375K147_PULLEY_32MM_NO-HUB - Copy x 2
8920N29_THRUST-WASHER x 4
7804K112_BEARING x 4
93395A313_M5X0.8X25_FLAT x 4
91292A196_M5X0.8X50L_SHCS x 4
