yjc97/Haptic_Tablet/CAD/Tablet Capstone/Initial Prototypes/1DOF Actuator Team/V2/EnderY/Ensamblaje_Eje_Y.SLDASM

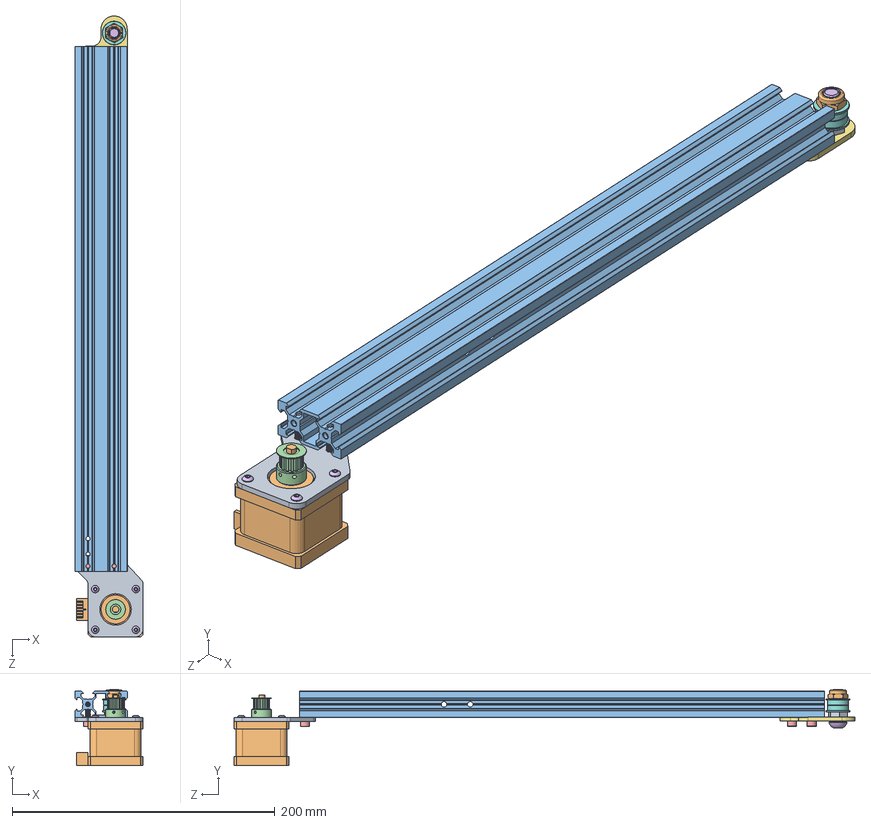
[picture p170: CAD file, 2022-11-08]
CAD/Tablet Capstone/Initial Prototypes/1DOF Actuator Team/V2/EnderY/Ensamblaje_Eje_Y.SLDASM
52.0 x 58.2 x 473.1 mm
Base_Sujecion
Motor_PasoaPaso
Perfil
Polea
socket head cap screw_iso x 5
socket button head screw_iso x 5
Base_Tensor_Y
Cojinete x 2
hex thin nut gradeb_iso
torque nut 08_iso
