yjc97/Haptic_Tablet/CAD/Tablet Capstone/Initial Prototypes/Mechanism Team/CABLE-BOT-PROTOTYPE/SCREEN-MOCKUP.SLDASM

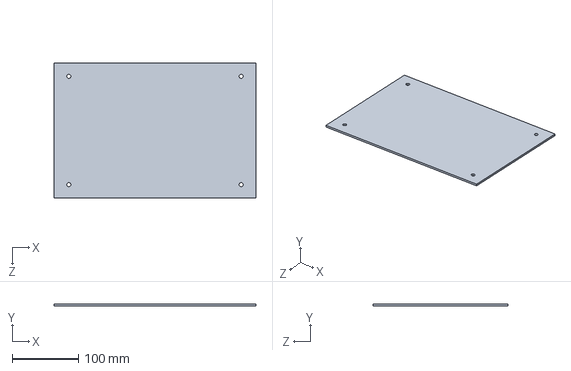
[picture p171: CAD file, 2022-11-08]
CAD/Tablet Capstone/Initial Prototypes/Mechanism Team/CABLE-BOT-PROTOTYPE/SCREEN-MOCKUP.SLDASM
304.8 x 3.17 x 203.2 mm
