yjc97/Haptic_Tablet/CAD/Tablet Capstone/Initial Prototypes/Mechanism Team/D2R-CONCEPT-MODEL/D2R-PROTOTYE.SLDASM

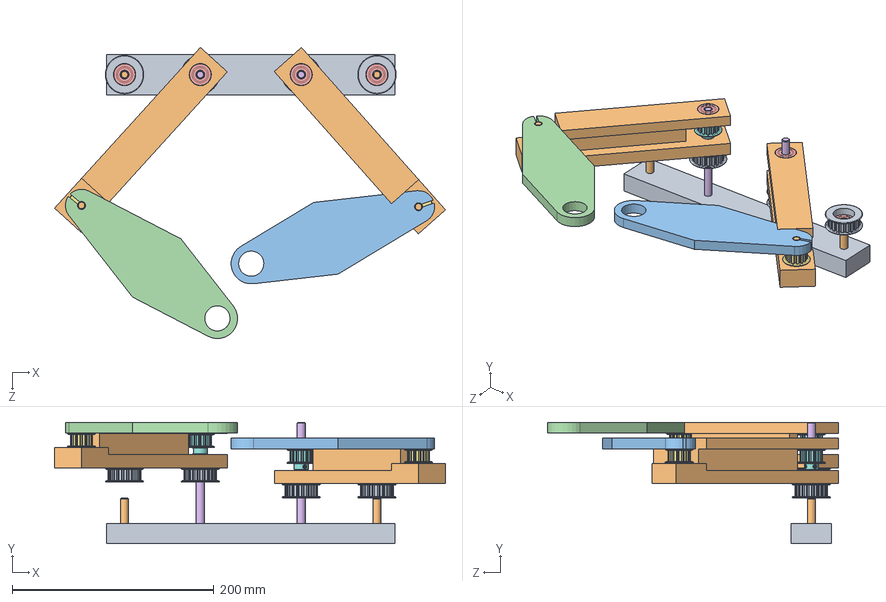
[picture p172: CAD file, 2022-11-08]
CAD/Tablet Capstone/Initial Prototypes/Mechanism Team/D2R-CONCEPT-MODEL/D2R-PROTOTYE.SLDASM
387.3 x 120.0 x 288.3 mm
D2R-BASE
D2R-BASE-LINK x 2
D2R-PROX-LINK-BOT
D2R-PROX-LINK-TOP
5972K501_Ball Bearing x 10
1265K66_77MM x 2
1277N714_28MM x 2
1277N714_28MM_HUB x 2
1277N718_PULLEY_38MM x 4
1265K66_45MM x 4
