yjc97/Haptic_Tablet/CAD/Tablet Capstone/Initial Prototypes/Mechanism Team/Ender3 Files/DenisSofron_Proyecto_EG_Ender_3_PackandGo/Ensamblaje_Final_de_Carrera_EjeX.SLDASM

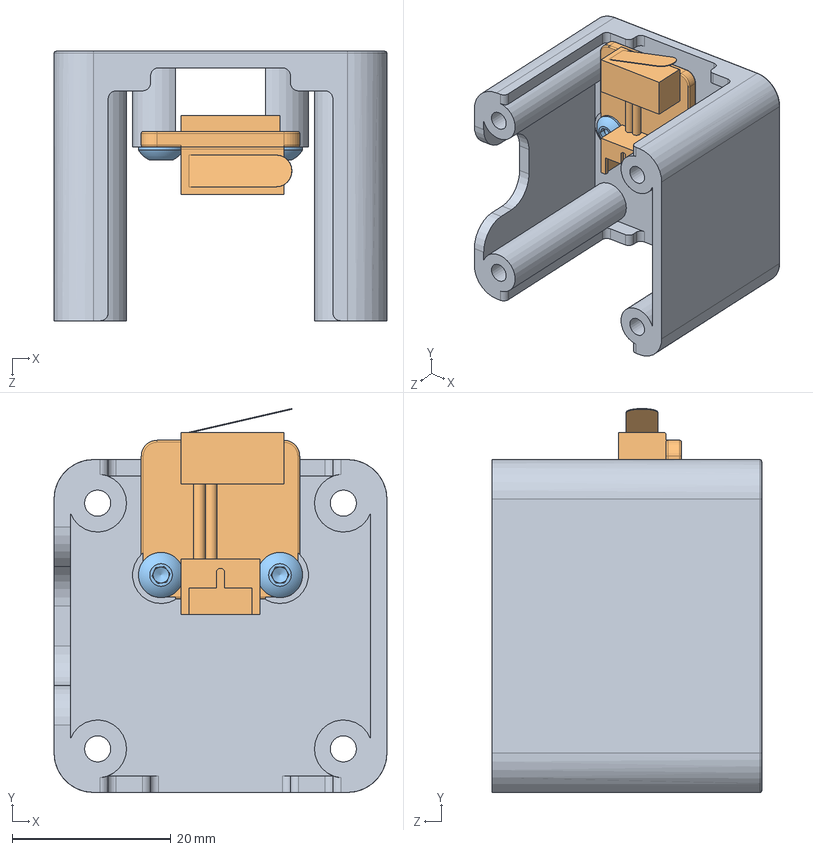
[picture p173: CAD file, 2022-11-08]
CAD/Tablet Capstone/Initial Prototypes/Mechanism Team/Ender3 Files/DenisSofron_Proyecto_EG_Ender_3_PackandGo/Ensamblaje_Final_de_Carrera_EjeX.SLDASM
42.0 x 48.4 x 34.0 mm
Tapa_X
Final_Carrera
socket button head screw_iso x 2
