yjc97/Haptic_Tablet/CAD/Tablet Capstone/Initial Prototypes/Mechanism Team/GantryPrototype/Wheel+PlateSubassem.SLDASM

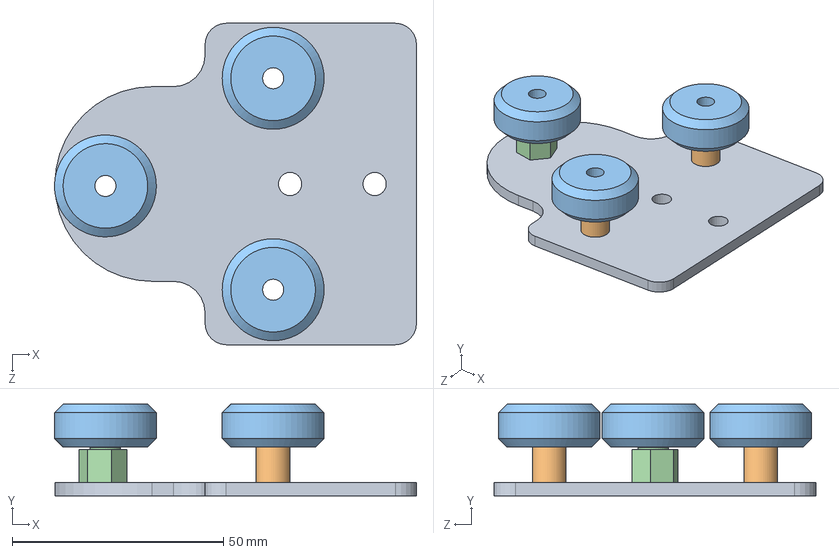
[picture p174: CAD file, 2022-11-08]
CAD/Tablet Capstone/Initial Prototypes/Mechanism Team/GantryPrototype/Wheel+PlateSubassem.SLDASM
85.6 x 21.7 x 76.0 mm
WheelPlates
WheelSpacers x 2
Wheels x 3
eccentric_nut
