yjc97/Haptic_Tablet/CAD/Tablet Capstone/Frame/ScreenStuff/ScreenAssem.SLDASM

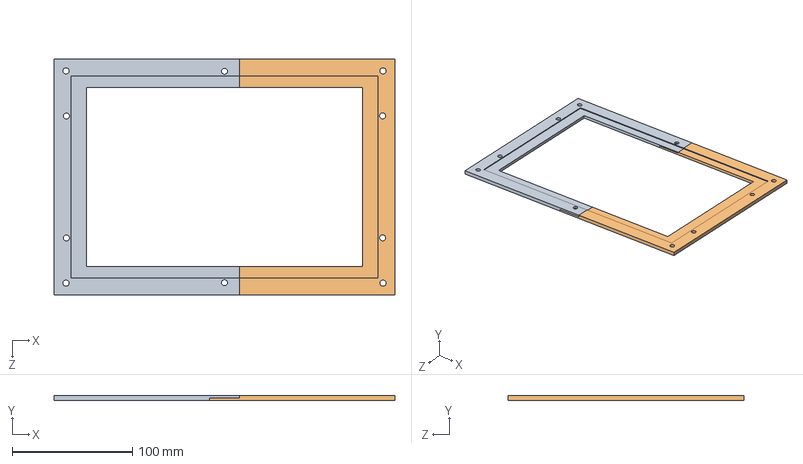
[picture p175: CAD file, 2022-11-08]
CAD/Tablet Capstone/Frame/ScreenStuff/ScreenAssem.SLDASM
284.2 x 4.04 x 196.9 mm
TopLeft
TopRight
