yjc97/Haptic_Tablet/CAD/Tablet Capstone/Initial Prototypes/Mechanism Team/PH2R-PROTOTYPE/PH2R-PROTOTYPE.SLDASM

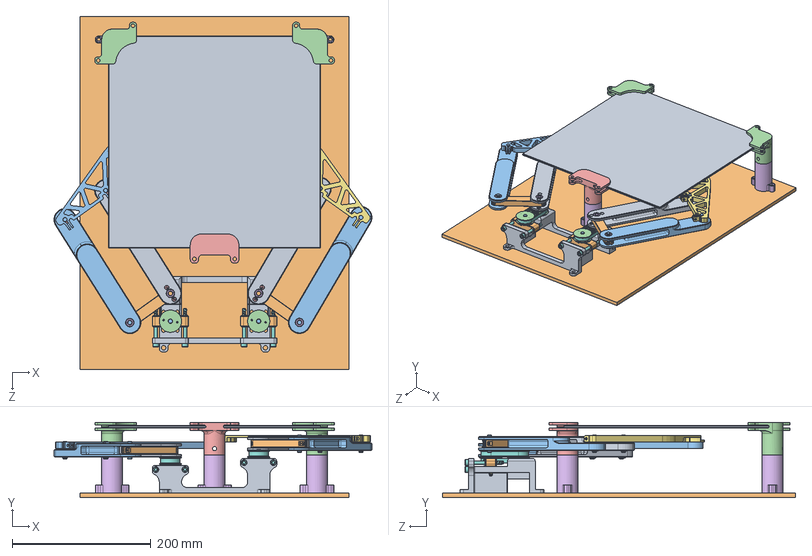
[picture p177: CAD file, 2022-11-08]
CAD/Tablet Capstone/Initial Prototypes/Mechanism Team/PH2R-PROTOTYPE/PH2R-PROTOTYPE.SLDASM
457.6 x 108.1 x 508.0 mm
PH2R-MOUNT
PH2R-PULLEY-SLIDE x 2
5033N127_6MM-SHAFT_24MM x 8
1375K147_PULLEY_32MM_NO-HUB - Copy x 2
8920N29_THRUST-WASHER x 8
7804K112_BEARING x 20
93395A313_M5X0.8X25_FLAT x 4
91292A196_M5X0.8X50L_SHCS x 4
PH2R-BASE-LINK x 2
PH2R-CON-LINK x 2
PH2R-ACT-LINK x 2
1375K147_PULLEY_32MM_NO-HUB x 2
92125A132_M3X12 x 4
90154A111_SNAP_RING x 4
PH2R-PROX-LINK
5027N48_TIMING-BELT_162MM x 2
GLASS-SCREEN
WOODEN-BASE
PH2R-PROX-LINK-BOT
GLASS-STAND-CORNER x 2
GLASS-STAND-SIDE
GLASS-STAND-BASE x 3
