yjc97/Haptic_Tablet/CAD/Tablet Capstone/Initial Prototypes/1DOF Actuator Team/V2/EnderY/Ensamblaje_Cama_Caliente.SLDASM

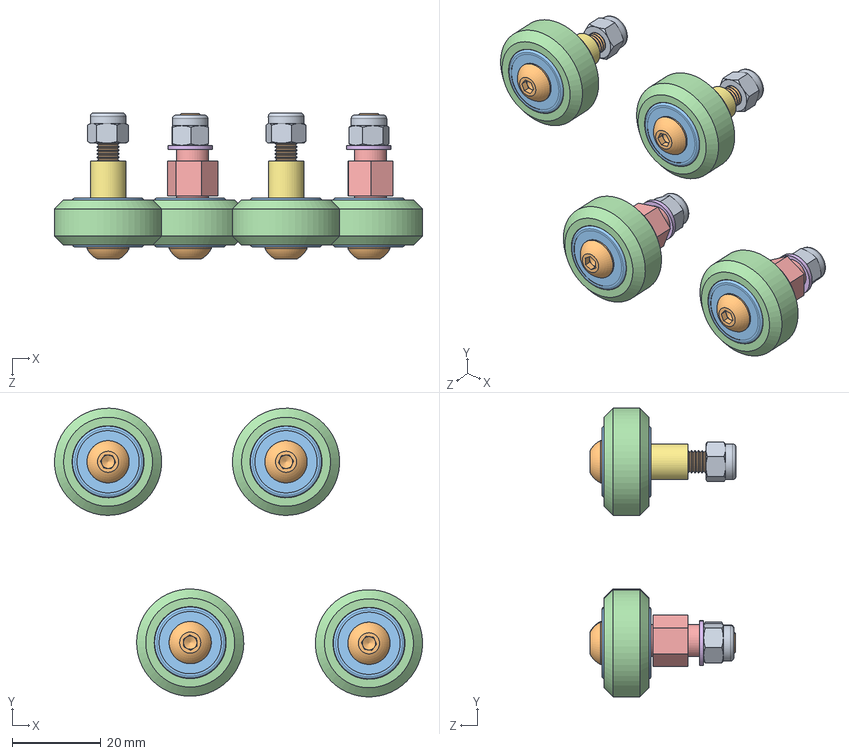
[picture p178: CAD file, 2022-11-08]
CAD/Tablet Capstone/Initial Prototypes/1DOF Actuator Team/V2/EnderY/Ensamblaje_Cama_Caliente.SLDASM
82.7 x 64.9 x 32.9 mm
torque nut 01_iso x 4
socket button head screw_iso x 4
Rodamiento x 8
Rueda x 4
Separador x 2
plain washer normal grade a_iso x 2
Separador_2 x 2
