yjc97/Haptic_Tablet/CAD/Tablet Capstone/Initial Prototypes/Mechanism Team/Ender3 Files/DenisSofron_Proyecto_EG_Ender_3_PackandGo/Ensamblaje_Final_de_Carrera_EjeZ.SLDASM

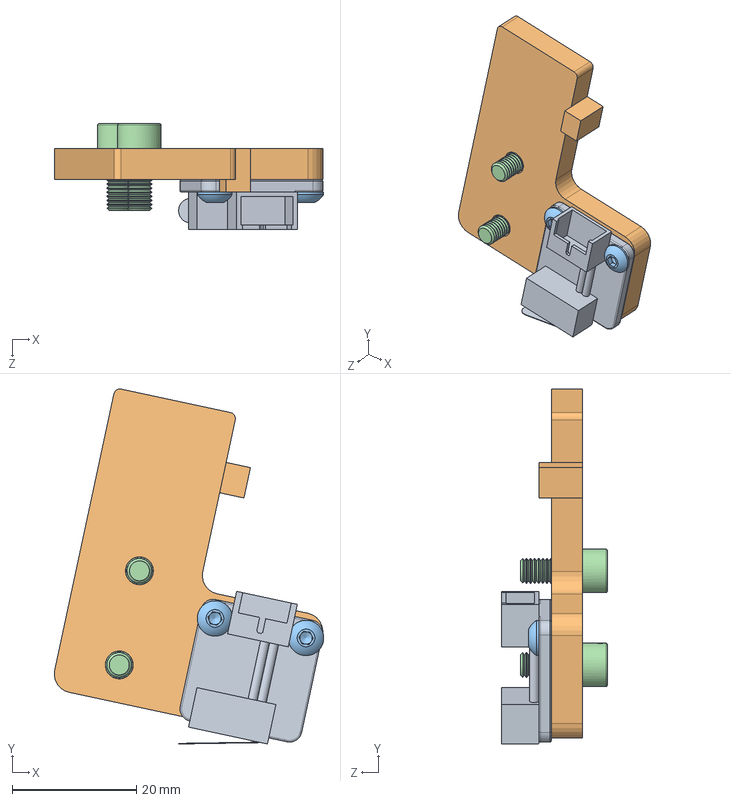
[picture p179: CAD file, 2022-11-08]
CAD/Tablet Capstone/Initial Prototypes/Mechanism Team/Ender3 Files/DenisSofron_Proyecto_EG_Ender_3_PackandGo/Ensamblaje_Final_de_Carrera_EjeZ.SLDASM
43.4 x 57.2 x 17.0 mm
Final_Carrera
Pieza_Base_2
socket button head screw_iso x 2
socket head cap screw_iso x 2
