yjc97/Haptic_Tablet/CAD/Tablet Capstone/Initial Prototypes/Mechanism Team/GantryPrototype/EnderFrame.SLDASM

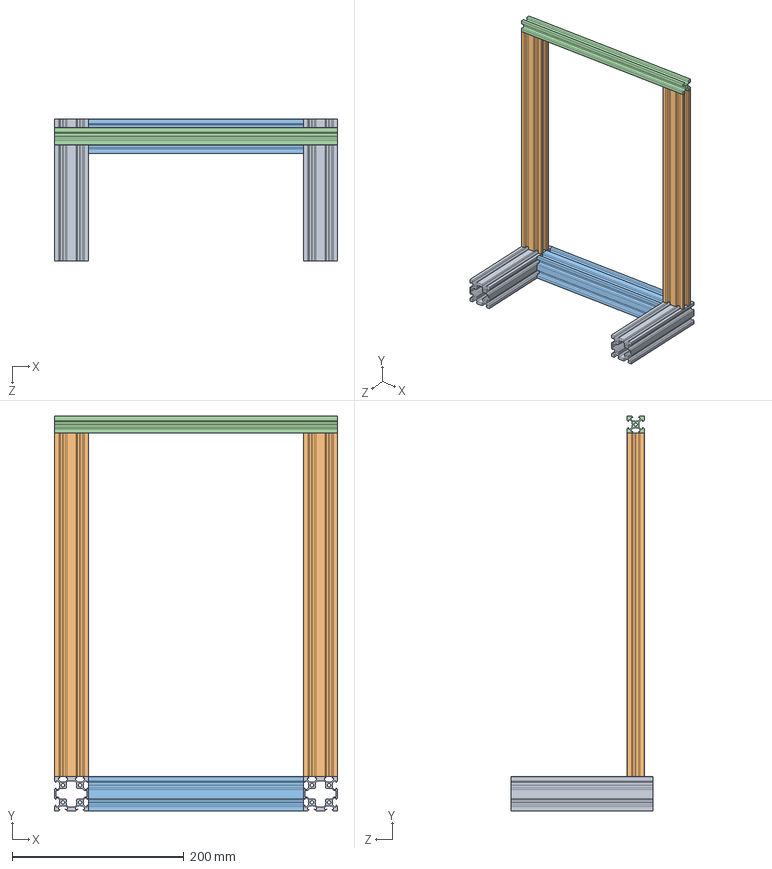
[picture p180: CAD file, 2022-11-08]
CAD/Tablet Capstone/Initial Prototypes/Mechanism Team/GantryPrototype/EnderFrame.SLDASM
330.0 x 460.0 x 165.0 mm
40x40Extrusion x 2
20x40Extrusion x 2
40x40Extrusion-CenterPiece
20x20Extrusion-FrameTop
