yjc97/Haptic_Tablet/CAD/Tablet Capstone/Initial Prototypes/Mechanism Team/Ender3 Files/DenisSofron_Proyecto_EG_Ender_3_PackandGo/Ensamblaje_Placa_Rodadura_Izquierda.SLDASM

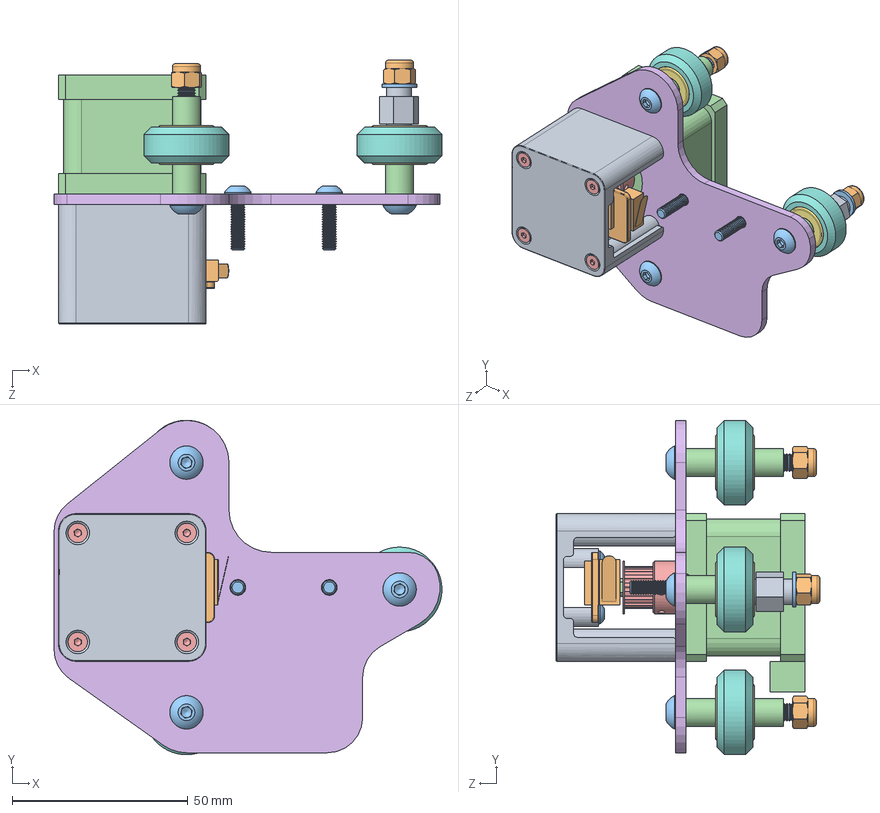
[picture p181: CAD file, 2022-11-08]
CAD/Tablet Capstone/Initial Prototypes/Mechanism Team/Ender3 Files/DenisSofron_Proyecto_EG_Ender_3_PackandGo/Ensamblaje_Placa_Rodadura_Izquierda.SLDASM
110.3 x 95.1 x 75.0 mm
Tapa_X
Final_Carrera
socket button head screw_iso x 7
Motor_PasoaPaso
Polea
Base_SujecionX_Izquierda
Rodamiento x 6
Rueda x 3
Separador
torque nut 01_iso x 3
plain washer normal grade a_iso
Separador_2 x 5
socket countersunk head screw_iso x 4
