yjc97/Haptic_Tablet/CAD/Tablet Capstone/Initial Prototypes/Mechanism Team/Ender3 Files/DenisSofron_Proyecto_EG_Ender_3_PackandGo/Ensamblaje_Rueda_Excentrica_EjeZ_I.SLDASM

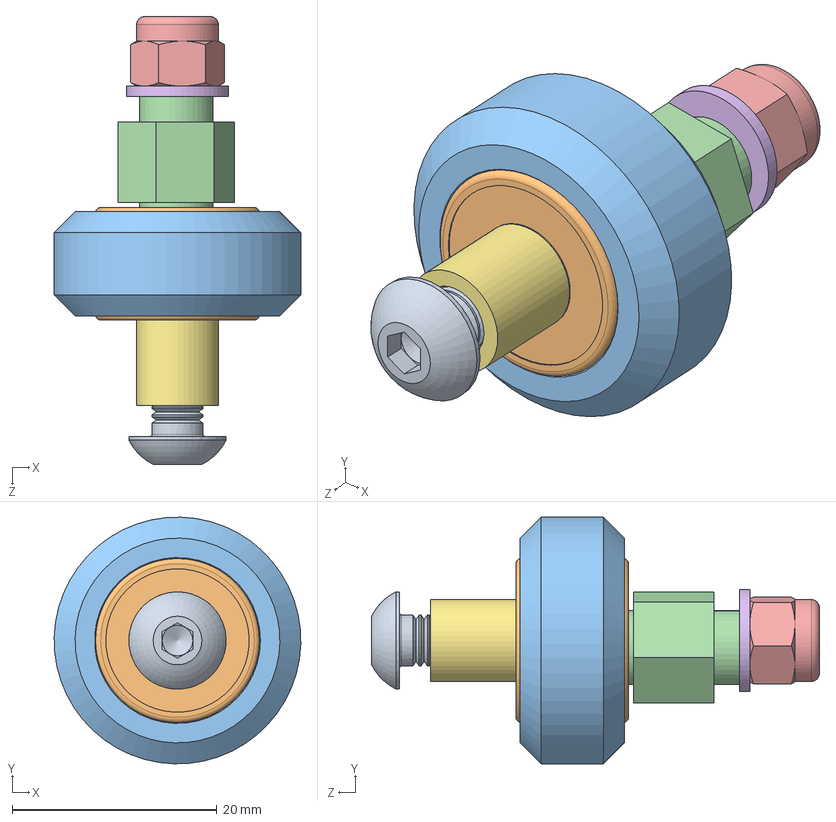
[picture p182: CAD file, 2022-11-08]
CAD/Tablet Capstone/Initial Prototypes/Mechanism Team/Ender3 Files/DenisSofron_Proyecto_EG_Ender_3_PackandGo/Ensamblaje_Rueda_Excentrica_EjeZ_I.SLDASM
24.1 x 24.1 x 43.8 mm
socket button head screw_iso
Rodamiento x 2
Rueda
Separador
torque nut 01_iso
plain washer normal grade a_iso
Separador_2
