yjc97/Haptic_Tablet/CAD/Tablet Capstone/Initial Prototypes/Mechanism Team/Ender3 Files/DenisSofron_Proyecto_EG_Ender_3_PackandGo/Ensamblaje_Sujeta_Bobina.SLDASM

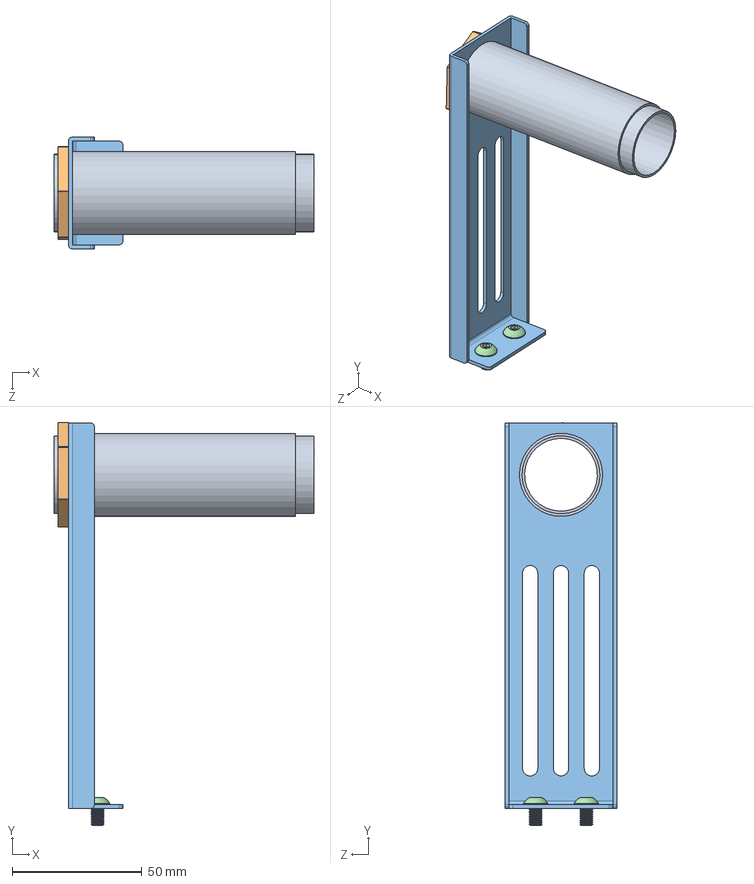
[picture p183: CAD file, 2022-11-08]
CAD/Tablet Capstone/Initial Prototypes/Mechanism Team/Ender3 Files/DenisSofron_Proyecto_EG_Ender_3_PackandGo/Ensamblaje_Sujeta_Bobina.SLDASM
100.0 x 155.1 x 43.0 mm
Cilindro
M30_Cierre
Pieza_Principal
socket button head screw_iso x 2
