yjc97/Haptic_Tablet/CAD/Tablet Capstone/Initial Prototypes/Mechanism Team/Ender3 Files/DenisSofron_Proyecto_EG_Ender_3_PackandGo/Ensamblaje2.SLDASM

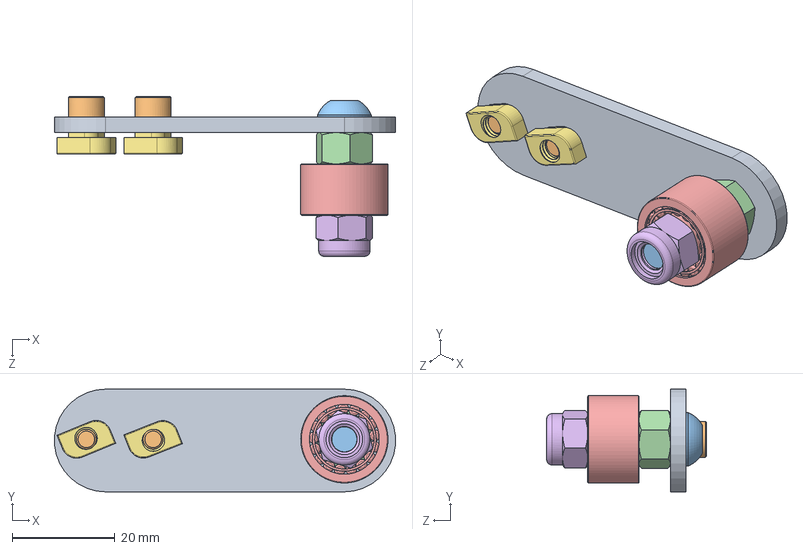
[picture p184: CAD file, 2022-11-08]
CAD/Tablet Capstone/Initial Prototypes/Mechanism Team/Ender3 Files/DenisSofron_Proyecto_EG_Ender_3_PackandGo/Ensamblaje2.SLDASM
66.4 x 20.0 x 31.1 mm
Placa
socket head cap screw_iso x 2
socket button head screw_iso
hex nut gradec_iso
needle roller bearing_nrba_iso
torque nut 01_iso
Tuerca_carril_Tornillo_2xM4 x 2
