yjc97/Haptic_Tablet/CAD/Tablet Capstone/Initial Prototypes/Mechanism Team/Ender3 Files/DenisSofron_Proyecto_EG_Ender_3_PackandGo/Ensamblaje_Perfil.SLDASM

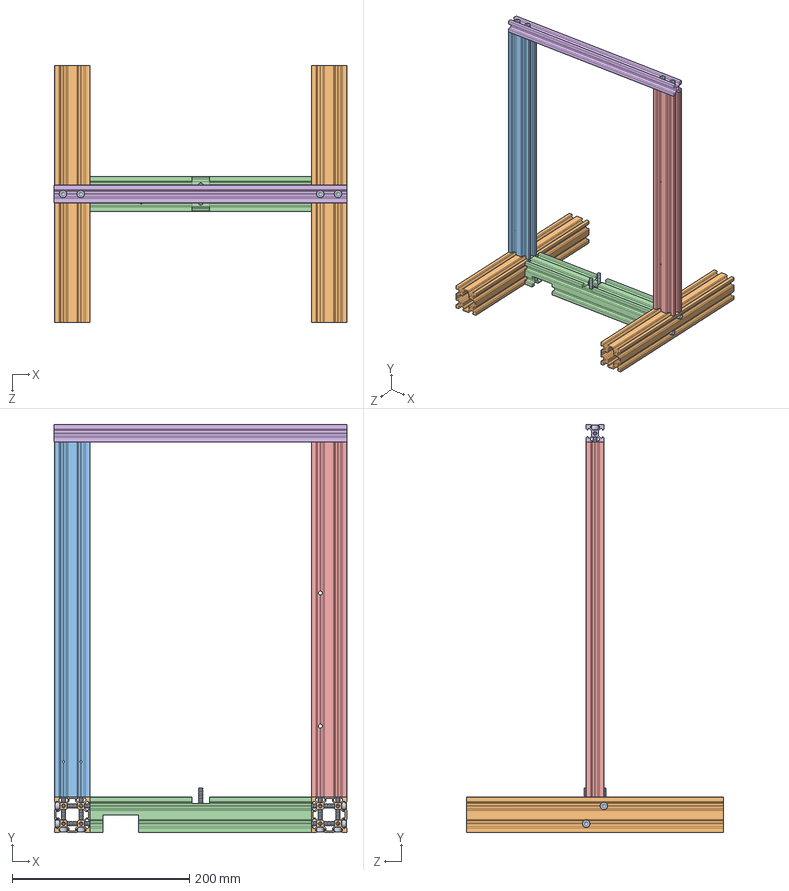
[picture p185: CAD file, 2022-11-08]
CAD/Tablet Capstone/Initial Prototypes/Mechanism Team/Ender3 Files/DenisSofron_Proyecto_EG_Ender_3_PackandGo/Ensamblaje_Perfil.SLDASM
330.0 x 459.9 x 290.1 mm
socket head cap screw_iso x 14
Perfil_Base_1 x 2
Perfil_3_I
Perfil_Base_2
Perfil_3_D
Perfil_1
