yjc97/Haptic_Tablet/CAD/Tablet Capstone/Initial Prototypes/Mechanism Team/Ender3 Files/DenisSofron_Proyecto_EG_Ender_3_PackandGo/Ensamblaje_Cabeza.SLDASM

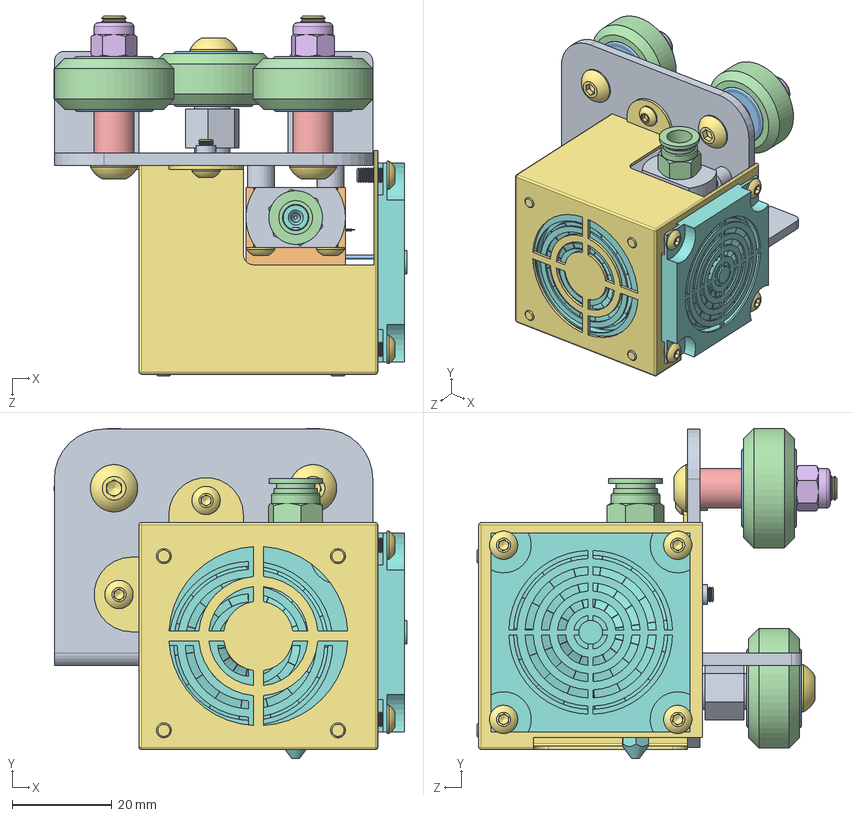
[picture p186: CAD file, 2022-11-08]
CAD/Tablet Capstone/Initial Prototypes/Mechanism Team/Ender3 Files/DenisSofron_Proyecto_EG_Ender_3_PackandGo/Ensamblaje_Cabeza.SLDASM
70.9 x 66.4 x 72.3 mm
Chapa_Forma_L
Bloque_1
Calentador
Conector neumatico
socket countersunk head screw_iso x 2
socket set screw cup point_iso x 2
socket button head screw_iso x 15
Punta
Radiador
Tremistor x 2
Rodamiento x 6
Rueda x 3
Separador_2 x 2
torque nut 01_iso x 3
Cubierta
Ventilador x 2
Separador
plain washer normal grade a_iso
