yjc97/Haptic_Tablet/CAD/Tablet Capstone/Initial Prototypes/Mechanism Team/Ender3 Files/DenisSofron_Proyecto_EG_Ender_3_PackandGo/Ensamblaje_Placa_Rodadura_Derecha.SLDASM

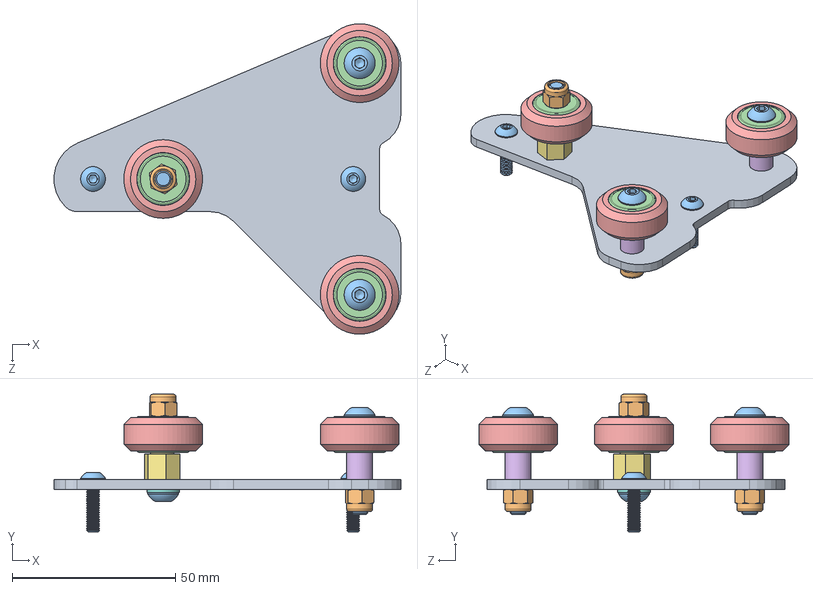
[picture p187: CAD file, 2022-11-08]
CAD/Tablet Capstone/Initial Prototypes/Mechanism Team/Ender3 Files/DenisSofron_Proyecto_EG_Ender_3_PackandGo/Ensamblaje_Placa_Rodadura_Derecha.SLDASM
106.3 x 42.2 x 95.1 mm
Base_SujecionX_Derecha
torque nut 01_iso x 3
socket button head screw_iso x 5
Rodamiento x 6
Rueda x 3
Separador_2 x 2
Separador
plain washer normal grade a_iso
