yjc97/Haptic_Tablet/CAD/Tablet Capstone/Initial Prototypes/Mechanism Team/Ender3 Files/DenisSofron_Proyecto_EG_Ender_3_PackandGo/Ensamblaje_Rueda_Normal_EjeZ_I.SLDASM

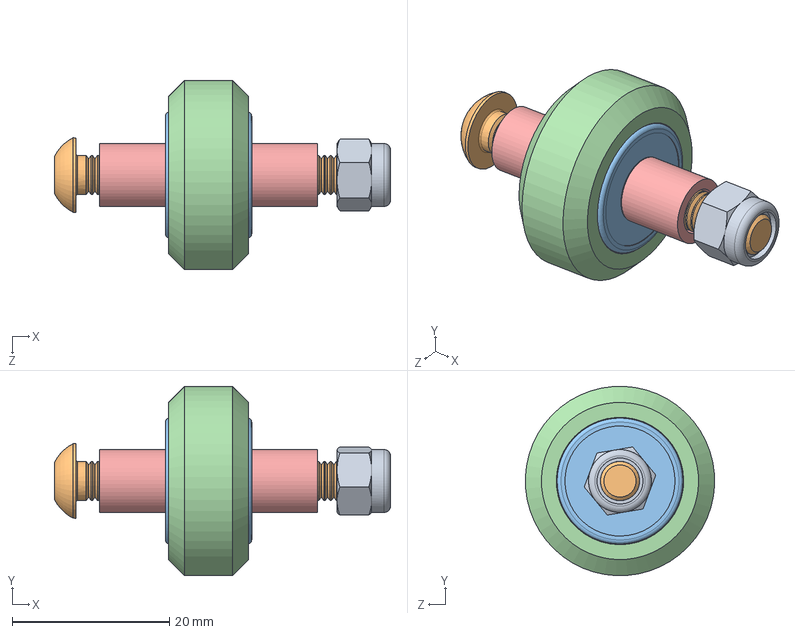
[picture p188: CAD file, 2022-11-08]
CAD/Tablet Capstone/Initial Prototypes/Mechanism Team/Ender3 Files/DenisSofron_Proyecto_EG_Ender_3_PackandGo/Ensamblaje_Rueda_Normal_EjeZ_I.SLDASM
42.8 x 24.1 x 24.1 mm
torque nut 01_iso
socket button head screw_iso
Rodamiento x 2
Rueda
Separador_2 x 2
