yjc97/Haptic_Tablet/CAD/Tablet Capstone/Initial Prototypes/Mechanism Team/Ender3 Files/DenisSofron_Proyecto_EG_Ender_3_PackandGo/Ensamblaje_Final_de_Carrera_Switch.SLDASM

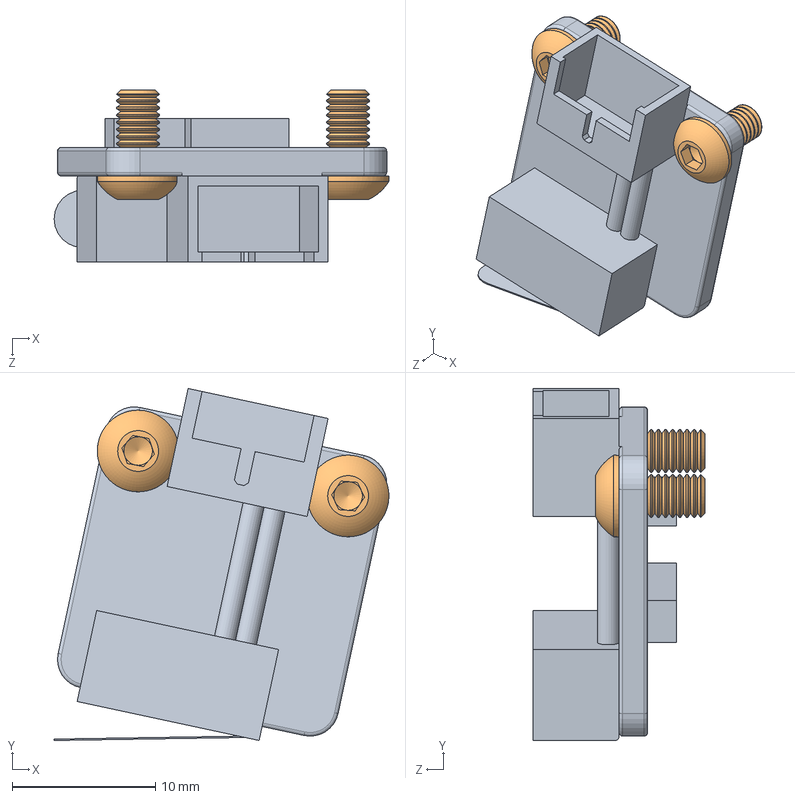
[picture p189: CAD file, 2022-11-08]
CAD/Tablet Capstone/Initial Prototypes/Mechanism Team/Ender3 Files/DenisSofron_Proyecto_EG_Ender_3_PackandGo/Ensamblaje_Final_de_Carrera_Switch.SLDASM
23.4 x 24.6 x 12.0 mm
Final_Carrera
socket button head screw_iso x 2
