yjc97/Haptic_Tablet/CAD/Tablet Capstone/Initial Prototypes/Mechanism Team/Ender3 Files/DenisSofron_Proyecto_EG_Ender_3_PackandGo/Ensamblaje_Calentador.SLDASM

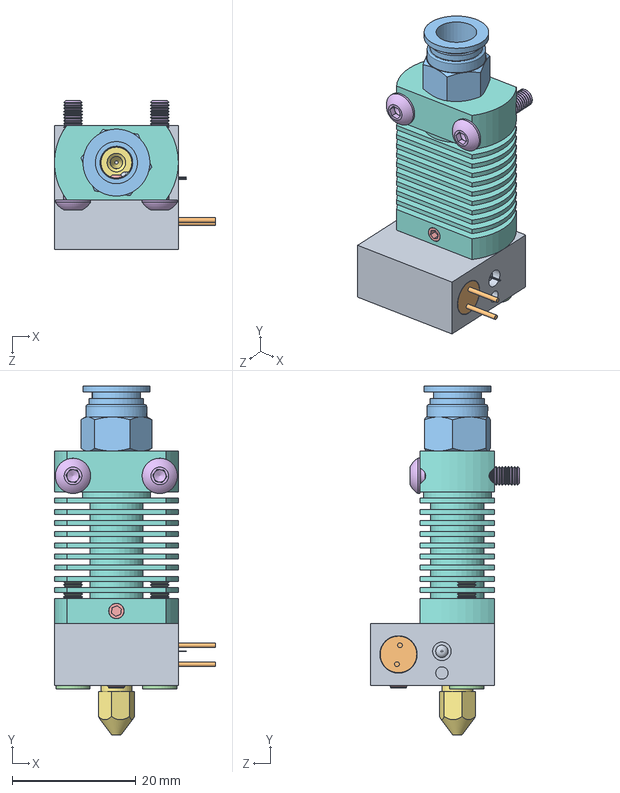
[picture p190: CAD file, 2022-11-08]
CAD/Tablet Capstone/Initial Prototypes/Mechanism Team/Ender3 Files/DenisSofron_Proyecto_EG_Ender_3_PackandGo/Ensamblaje_Calentador.SLDASM
26.0 x 56.3 x 24.0 mm
Bloque_1
Calentador
Conector neumatico
socket countersunk head screw_iso x 2
socket set screw cup point_iso x 2
socket button head screw_iso x 2
Punta
Radiador
Tremistor x 2
