yjc97/Haptic_Tablet/CAD/Tablet Capstone/Initial Prototypes/Mechanism Team/Ender3 Files/DenisSofron_Proyecto_EG_Ender_3_PackandGo/Ensamblaje_Eje_X.SLDASM

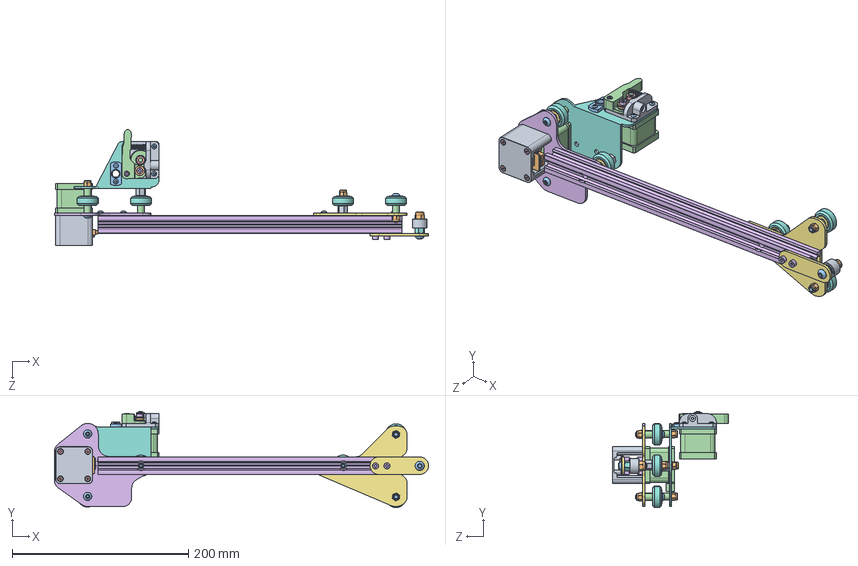
[picture p191: CAD file, 2022-11-08]
CAD/Tablet Capstone/Initial Prototypes/Mechanism Team/Ender3 Files/DenisSofron_Proyecto_EG_Ender_3_PackandGo/Ensamblaje_Eje_X.SLDASM
425.0 x 109.1 x 132.1 mm
Tapa_X
Final_Carrera
socket button head screw_iso x 17
Motor_PasoaPaso x 2
Polea
Base_SujecionX_Izquierda
Rodamiento x 12
Rueda x 6
Separador x 2
torque nut 01_iso x 7
plain washer normal grade a_iso x 2
Separador_2 x 7
socket countersunk head screw_iso x 5
Perfil_X
Base_SujecionX_Derecha
Base_SujecionX_Extrusor
Base_Ext_1
Cojinete_Extrusor
Muelle_Extrusor
Palanca_Ext
Rueda_Extrusor_Agarre
socket head cap screw_iso x 4
Placa
hex nut gradec_iso
needle roller bearing_nrba_iso
Tuerca_carril_Tornillo_2xM4 x 2
Tuerca_1
