yjc97/Haptic_Tablet/CAD/Tablet Capstone/Initial Prototypes/Mechanism Team/Ender3 Files/DenisSofron_Proyecto_EG_Ender_3_PackandGo/Ensamblaje_Cama_Caliente.SLDASM

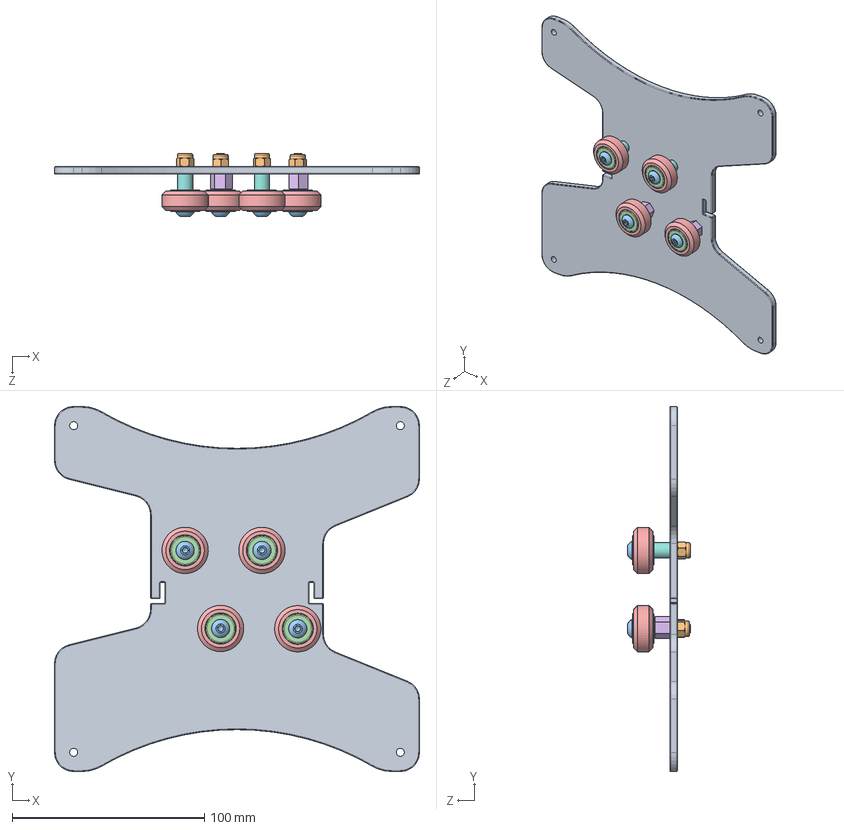
[picture p192: CAD file, 2022-11-08]
CAD/Tablet Capstone/Initial Prototypes/Mechanism Team/Ender3 Files/DenisSofron_Proyecto_EG_Ender_3_PackandGo/Ensamblaje_Cama_Caliente.SLDASM
190.0 x 190.0 x 32.9 mm
Apoyo Cama
torque nut 01_iso x 4
socket button head screw_iso x 4
Rodamiento x 8
Rueda x 4
Separador x 2
plain washer normal grade a_iso x 2
Separador_2 x 2
