yjc97/Haptic_Tablet/CAD/Tablet Capstone/Initial Prototypes/Mechanism Team/Ender3 Files/DenisSofron_Proyecto_EG_Ender_3_PackandGo/Ensamblaje_Extrusor.SLDASM

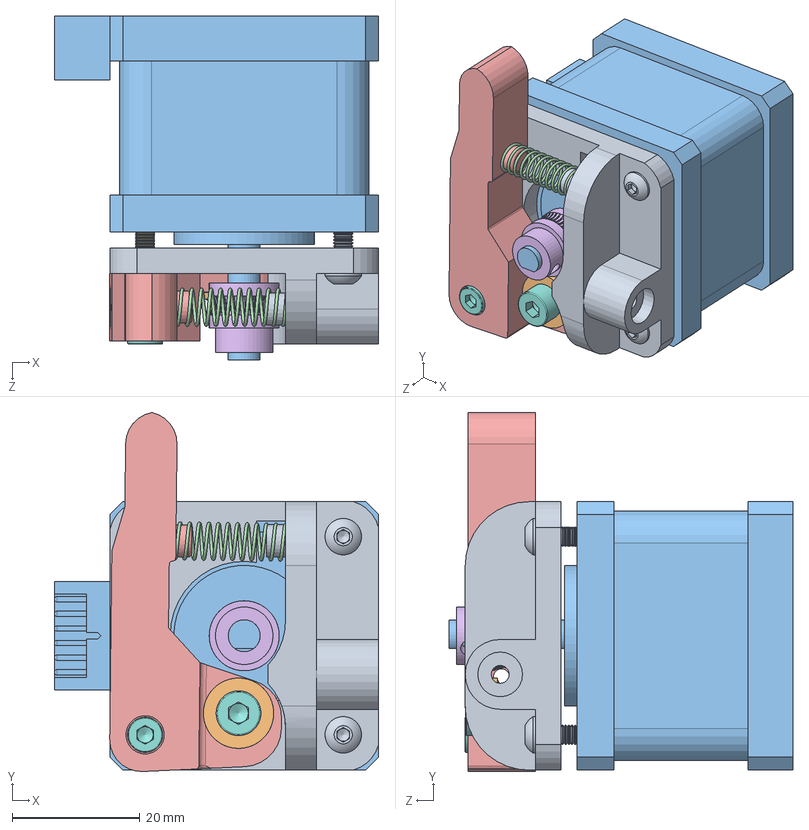
[picture p193: CAD file, 2022-11-08]
CAD/Tablet Capstone/Initial Prototypes/Mechanism Team/Ender3 Files/DenisSofron_Proyecto_EG_Ender_3_PackandGo/Ensamblaje_Extrusor.SLDASM
50.7 x 56.2 x 53.8 mm
Base_Ext_1
Cojinete_Extrusor
Motor_PasoaPaso
Muelle_Extrusor
Palanca_Ext
Rueda_Extrusor_Agarre
socket countersunk head screw_iso
socket head cap screw_iso x 2
socket button head screw_iso x 2
