yjc97/Haptic_Tablet/CAD/Tablet Capstone/Initial Prototypes/Mechanism Team/Ender3 Files/DenisSofron_Proyecto_EG_Ender_3_PackandGo/Ensamblaje_PANTALLA.SLDASM

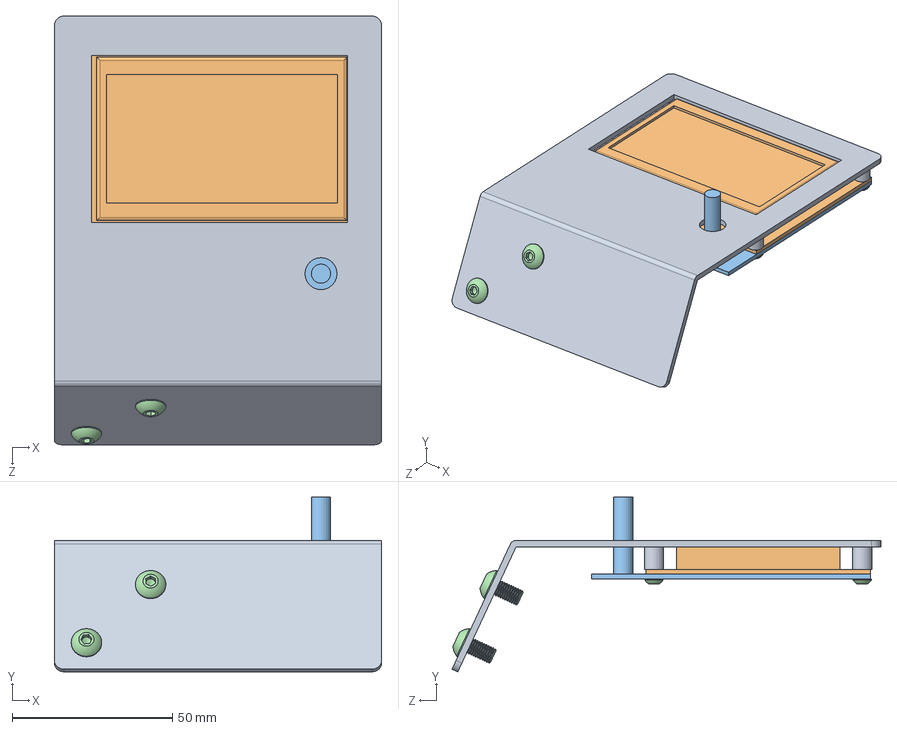
[picture p194: CAD file, 2022-11-08]
CAD/Tablet Capstone/Initial Prototypes/Mechanism Team/Ender3 Files/DenisSofron_Proyecto_EG_Ender_3_PackandGo/Ensamblaje_PANTALLA.SLDASM
102.0 x 54.5 x 133.7 mm
Soporte
LCD
Base_1
socket button head screw_iso x 6
