yjc97/Haptic_Tablet/CAD/Tablet Capstone/ALPHA/CUSTOM/TB1-004-TRANSMISSION-PLATE.SLDPRT

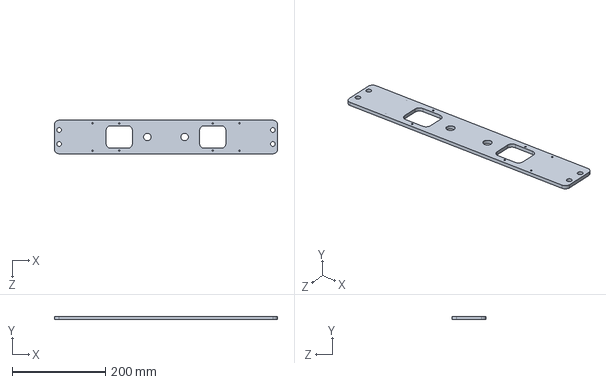
[picture p196: CAD file, 2022-11-08]
CAD/Tablet Capstone/ALPHA/CUSTOM/TB1-004-TRANSMISSION-PLATE.SLDPRT
477.2 x 6.35 x 72.0 mm
