yjc97/Haptic_Tablet/CAD/Tablet Capstone/ALPHA/DRAWINGS/DXFs/TB1-012-OUTER-LINK 0.25_QTY1.DXF

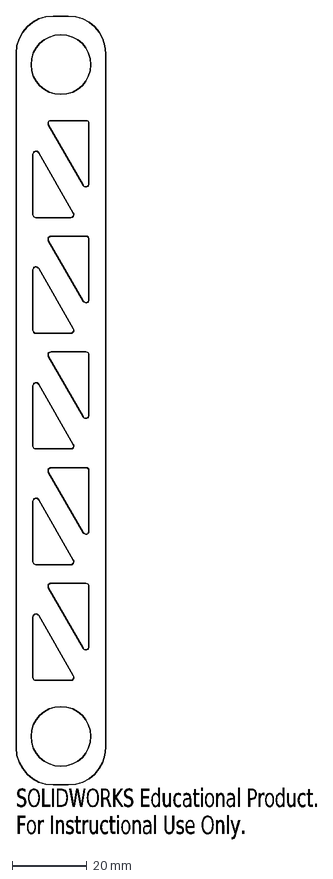
[picture p197: CAD file, 2022-11-08]
CAD/Tablet Capstone/ALPHA/DRAWINGS/DXFs/TB1-012-OUTER-LINK 0.25_QTY1.DXF
SOLIDWORKS Educational Product.
For Instructional Use Only.
