yjc97/Haptic_Tablet/CAD/Tablet Capstone/ALPHA/PURCHASE/GBPS-0401-CS-AA171-197.SLDPRT

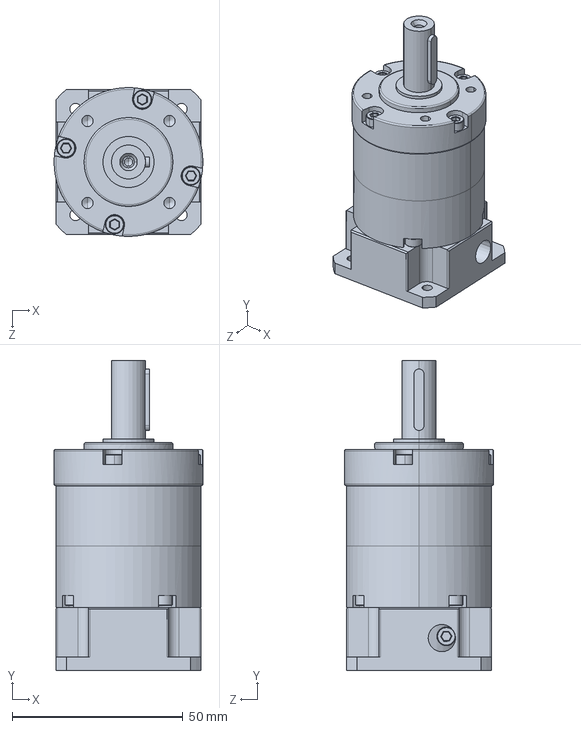
[picture p198: CAD file, 2022-11-08]
CAD/Tablet Capstone/ALPHA/PURCHASE/GBPS-0401-CS-AA171-197.SLDPRT
43.6 x 90.8 x 43.6 mm
