yjc97/Haptic_Tablet/CAD/Tablet Capstone/ALPHA/TB1-MASTER.SLDPRT

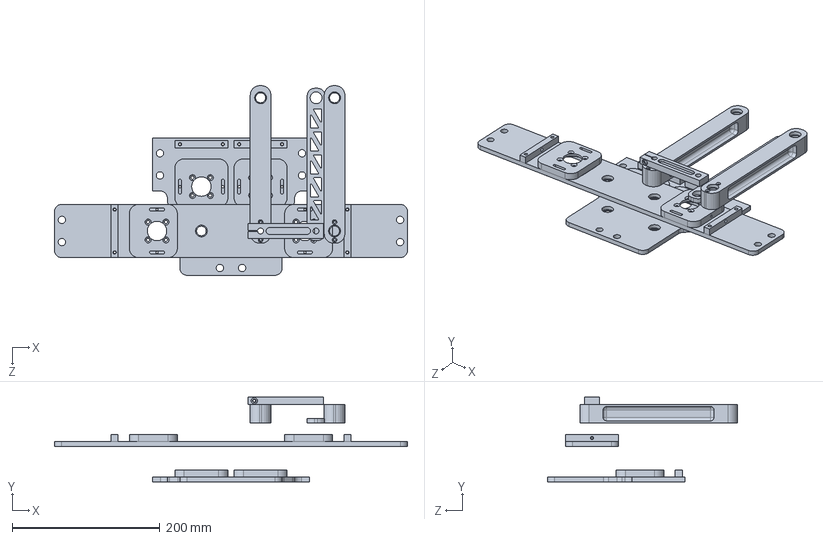
[picture p199: CAD file, 2022-11-08]
CAD/Tablet Capstone/ALPHA/TB1-MASTER.SLDPRT
477.2 x 114.3 x 256.5 mm
