yjc97/Haptic_Tablet/CAD/Tablet Capstone/Frame/MagnetValidation/Pulley.SLDPRT

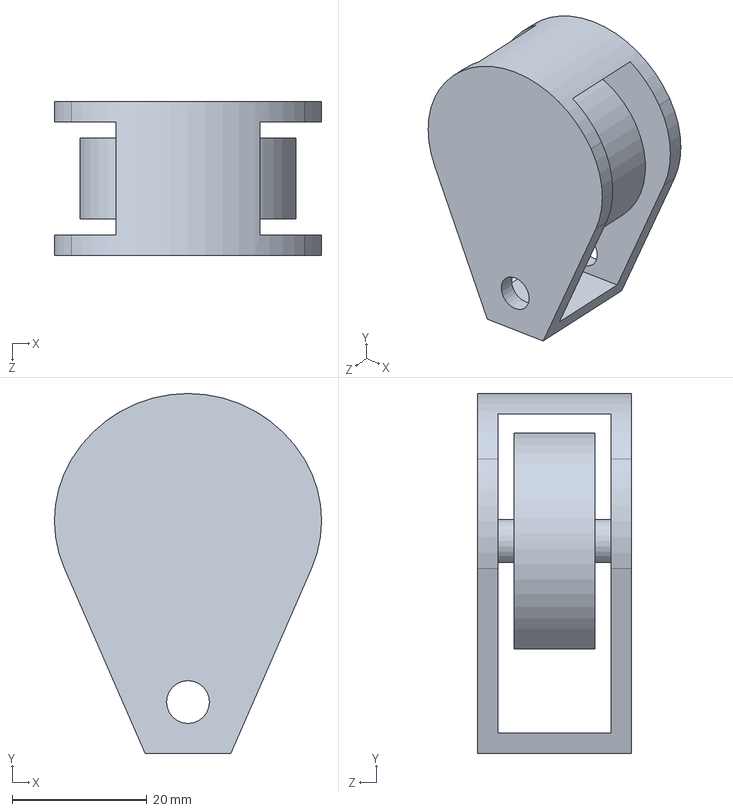
[picture p200: CAD file, 2022-11-08]
CAD/Tablet Capstone/Frame/MagnetValidation/Pulley.SLDPRT
39.6 x 53.3 x 22.9 mm
