yjc97/Haptic_Tablet/CAD/Tablet Capstone/Frame/ScreenStuff/CasePieces_ForPrinting/STLs/BottomRight-1.STL

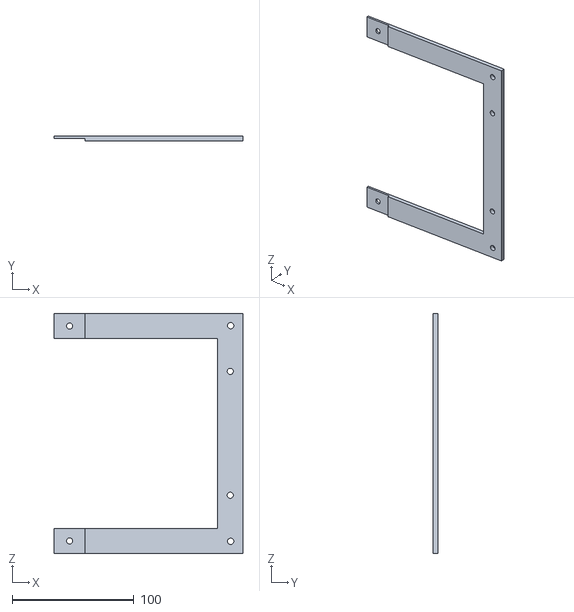
[picture p201: CAD file, 2022-11-08]
CAD/Tablet Capstone/Frame/ScreenStuff/CasePieces_ForPrinting/STLs/BottomRight-1.STL
154.8 x 3.97 x 196.9
