yjc97/Haptic_Tablet/CAD/Tablet Capstone/Frame/ShortCornerBracket.SLDPRT

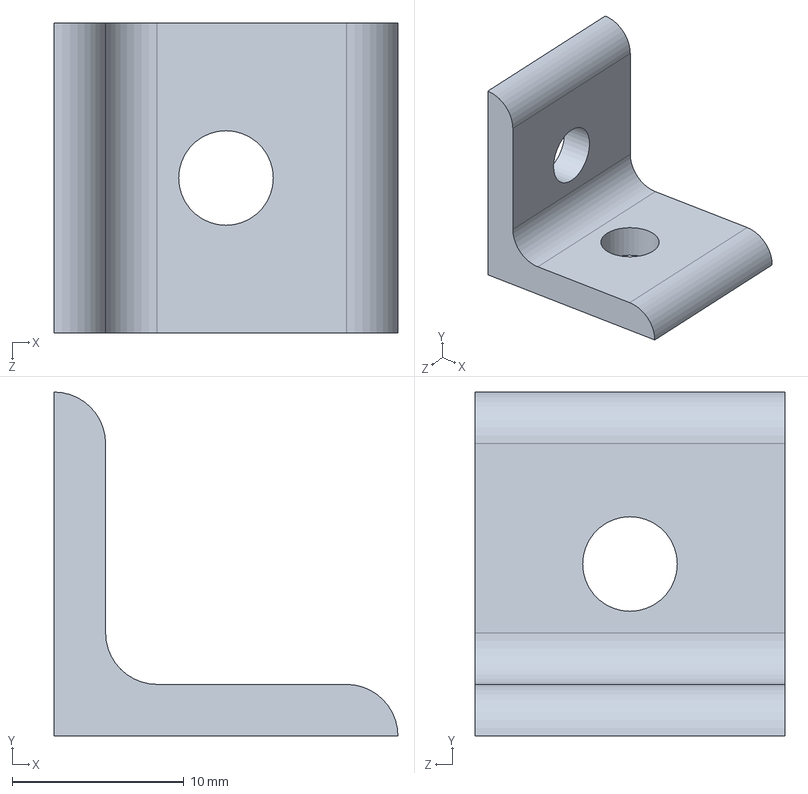
[picture p202: CAD file, 2022-11-08]
CAD/Tablet Capstone/Frame/ShortCornerBracket.SLDPRT
20.0 x 20.0 x 18.0 mm
