yjc97/Haptic_Tablet/CAD/Tablet Capstone/Initial Prototypes/1DOF Actuator Team/V2/Electromagnet Belt Mounting Plate_V4.DXF

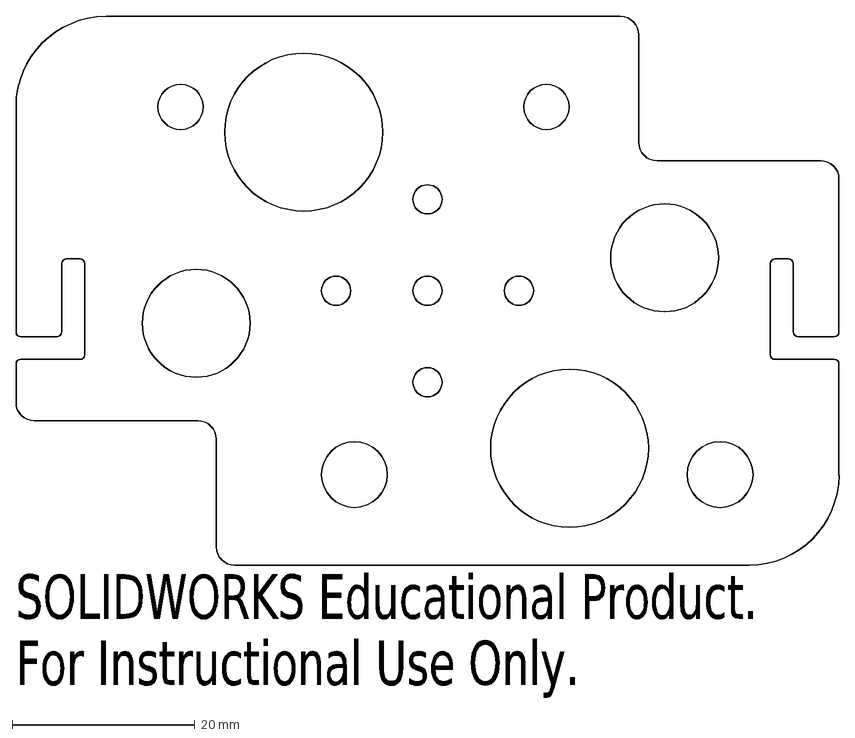
[picture p203: CAD file, 2022-11-08]
CAD/Tablet Capstone/Initial Prototypes/1DOF Actuator Team/V2/Electromagnet Belt Mounting Plate_V4.DXF
SOLIDWORKS Educational Product.
For Instructional Use Only.
