yjc97/Haptic_Tablet/CAD/Tablet Capstone/Initial Prototypes/Mechanism Team/AdjustableScreen/RiserSpacer2.0.SLDPRT

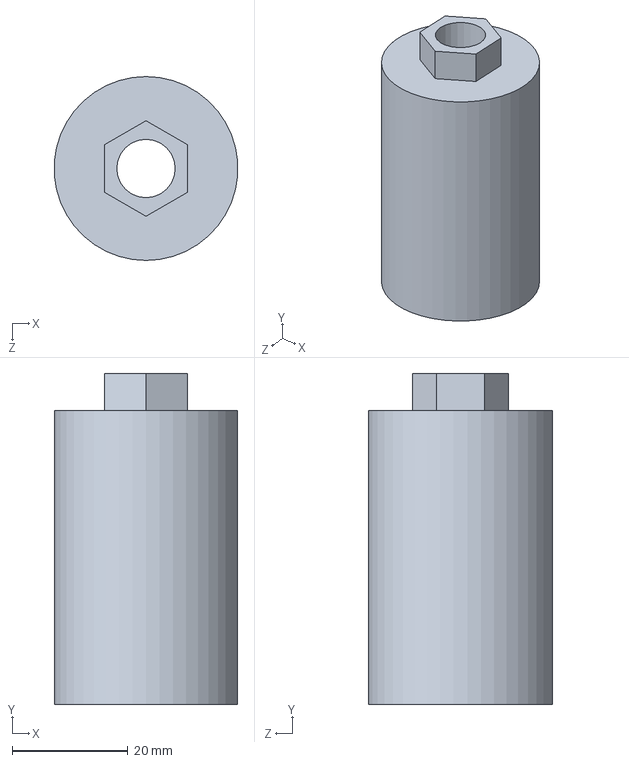
[picture p206: CAD file, 2022-11-08]
CAD/Tablet Capstone/Initial Prototypes/Mechanism Team/AdjustableScreen/RiserSpacer2.0.SLDPRT
31.7 x 57.1 x 31.8 mm
