yjc97/Haptic_Tablet/CAD/Tablet Capstone/Initial Prototypes/Mechanism Team/AdjustableScreen/STLs/RiserSpacer1.5_Q4.STL

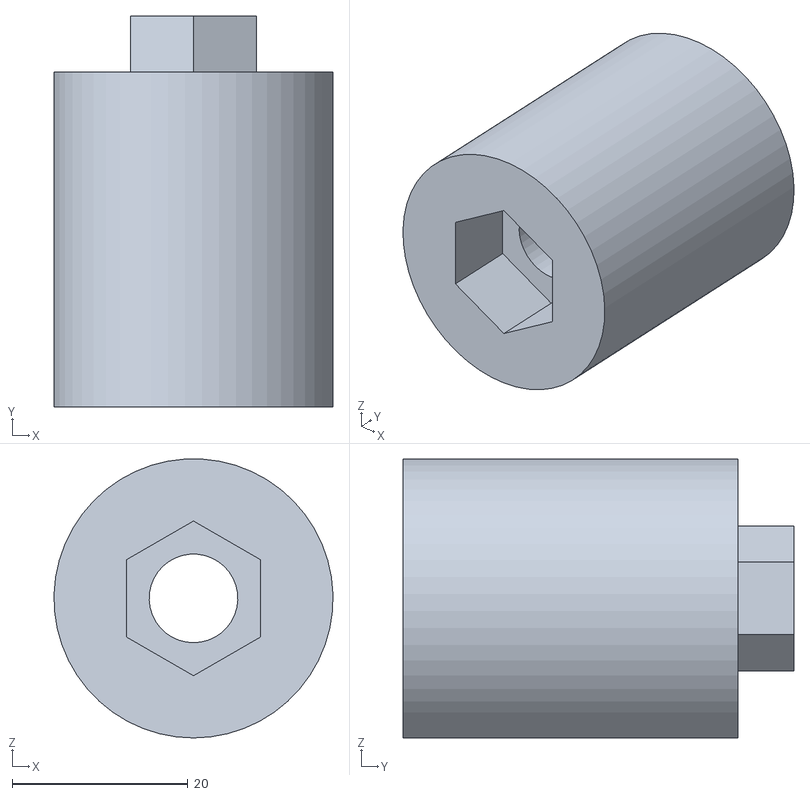
[picture p207: CAD file, 2022-11-08]
CAD/Tablet Capstone/Initial Prototypes/Mechanism Team/AdjustableScreen/STLs/RiserSpacer1.5_Q4.STL
31.7 x 44.5 x 31.7
