yjc97/Haptic_Tablet/CAD/Tablet Capstone/Initial Prototypes/Mechanism Team/CABLE-BOT-PROTOTYPE/MAGNET-SUPPORT.SLDPRT

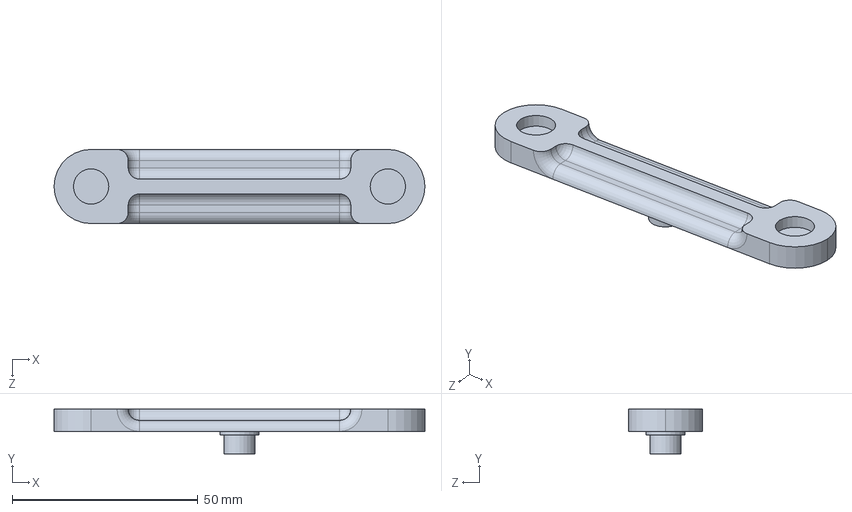
[picture p208: CAD file, 2022-11-08]
CAD/Tablet Capstone/Initial Prototypes/Mechanism Team/CABLE-BOT-PROTOTYPE/MAGNET-SUPPORT.SLDPRT
100.0 x 12.0 x 20.0 mm
