yjc97/Haptic_Tablet/CAD/Tablet Capstone/Initial Prototypes/Mechanism Team/GantryPrototype/Extrusions/20x20Extrusion.SLDPRT

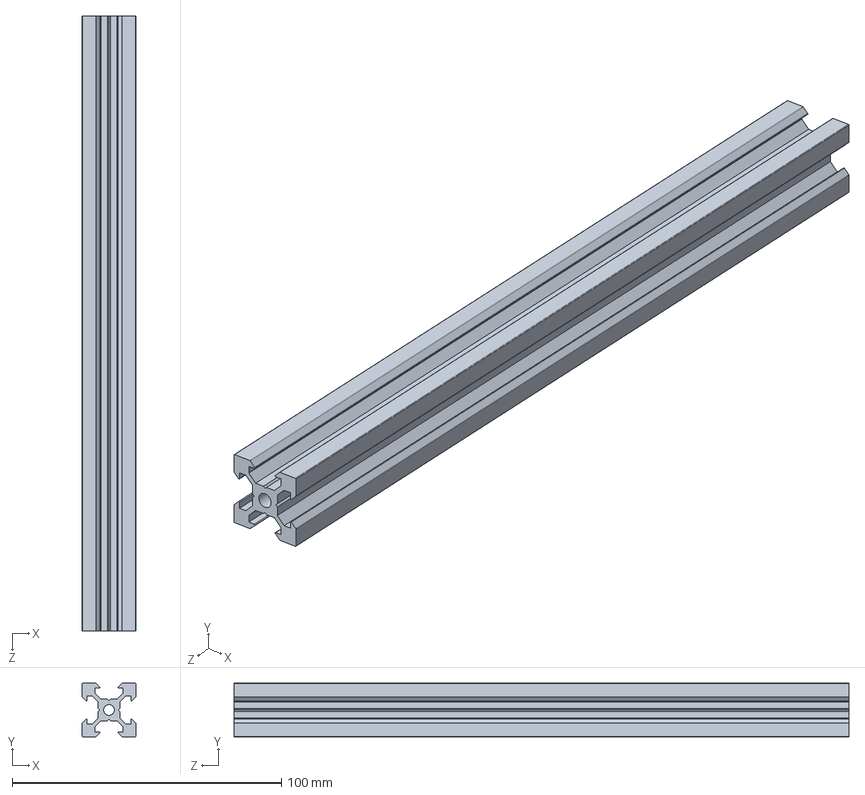
[picture p210: CAD file, 2022-11-08]
CAD/Tablet Capstone/Initial Prototypes/Mechanism Team/GantryPrototype/Extrusions/20x20Extrusion.SLDPRT
20.0 x 20.0 x 228.6 mm
