yjc97/Haptic_Tablet/CAD/Tablet Capstone/Initial Prototypes/Mechanism Team/Magnets/Alpha Final Magnets/Finger puck v5.SLDPRT

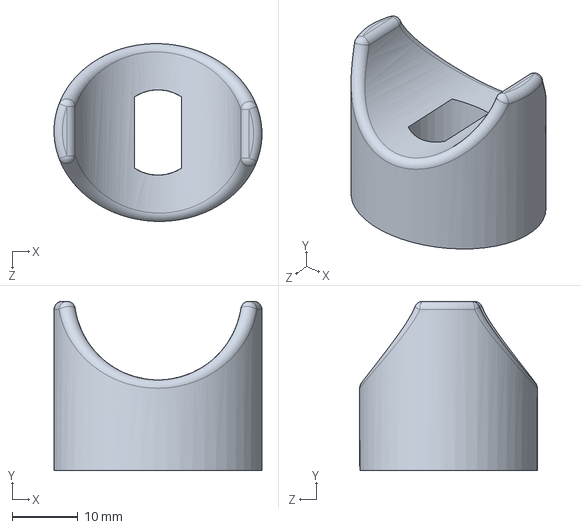
[picture p211: CAD file, 2022-11-08]
CAD/Tablet Capstone/Initial Prototypes/Mechanism Team/Magnets/Alpha Final Magnets/Finger puck v5.SLDPRT
31.6 x 25.7 x 27.0 mm
