yjc97/Haptic_Tablet/CAD/Tablet Capstone/Initial Prototypes/Mechanism Team/Magnets/Beta Final Magnets/Bottom Magnet (Weak).SLDPRT

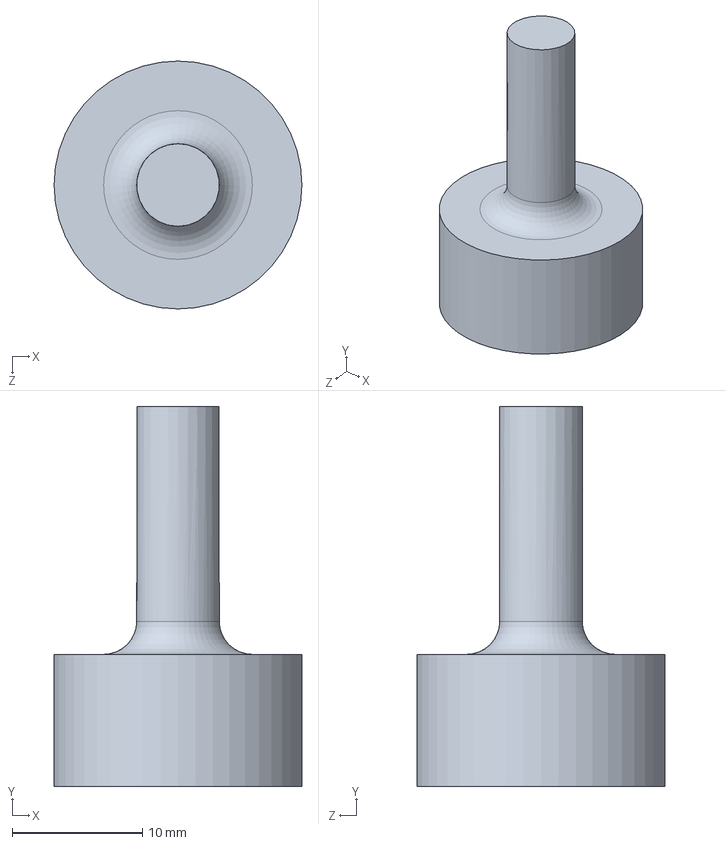
[picture p212: CAD file, 2022-11-08]
CAD/Tablet Capstone/Initial Prototypes/Mechanism Team/Magnets/Beta Final Magnets/Bottom Magnet (Weak).SLDPRT
19.1 x 29.2 x 19.1 mm
