yjc97/Haptic_Tablet/CAD/Tablet Capstone/Initial Prototypes/Mechanism Team/Magnets/First Quarter - Final Magnet/Finger puck v4.SLDPRT

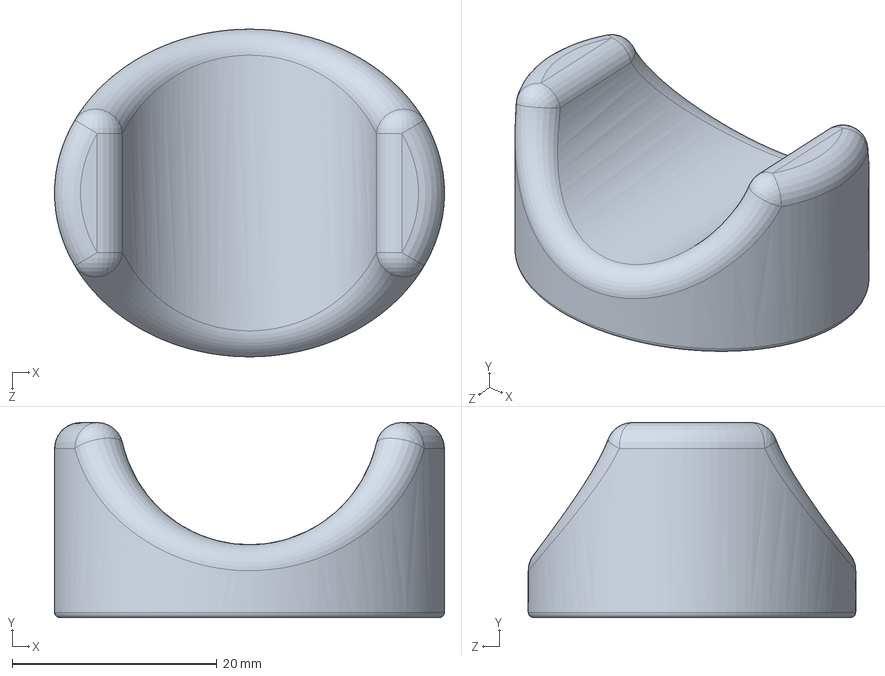
[picture p213: CAD file, 2022-11-08]
CAD/Tablet Capstone/Initial Prototypes/Mechanism Team/Magnets/First Quarter - Final Magnet/Finger puck v4.SLDPRT
38.1 x 19.1 x 32.0 mm
