yjc97/Haptic_Tablet/CAD/Tablet Capstone/Initial Prototypes/Mechanism Team/OverhangBase-Cam.STL

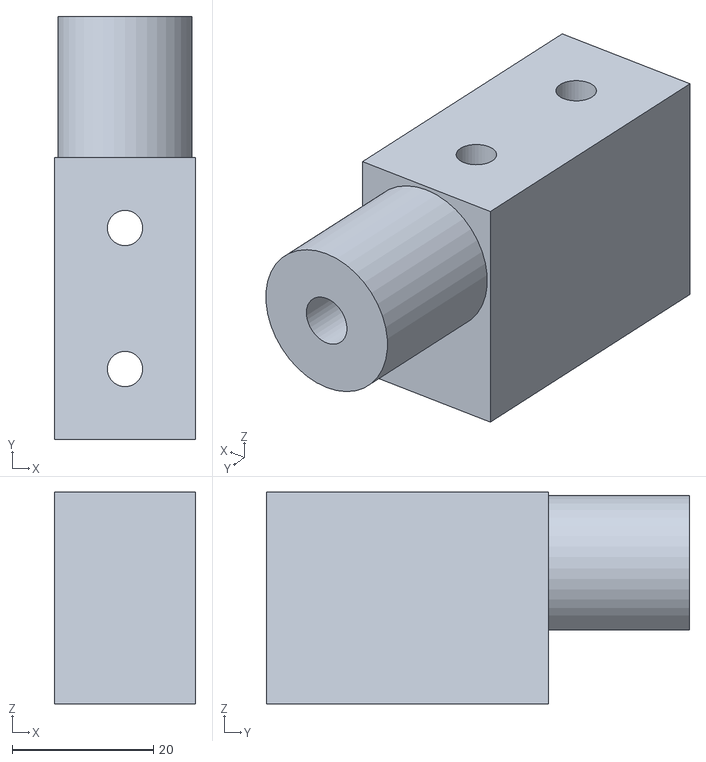
[picture p214: CAD file, 2022-11-08]
CAD/Tablet Capstone/Initial Prototypes/Mechanism Team/OverhangBase-Cam.STL
20.0 x 60.0 x 30.0
