yjc97/Haptic_Tablet/CAD/Tablet Capstone/Initial Prototypes/Mechanism Team/PH2R-PROTOTYPE/ACRYLIC-SCREEN.SLDPRT

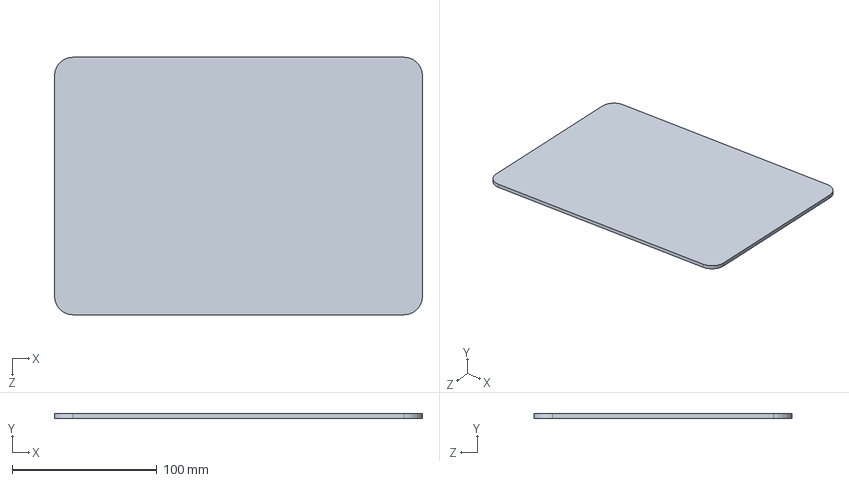
[picture p215: CAD file, 2022-11-08]
CAD/Tablet Capstone/Initial Prototypes/Mechanism Team/PH2R-PROTOTYPE/ACRYLIC-SCREEN.SLDPRT
254.0 x 3.17 x 177.8 mm
