yjc97/Haptic_Tablet/CAD/Tablet Capstone/Initial Prototypes/Mechanism Team/PH2R-PROTOTYPE/PRINTING/PH2R-BASE-LINK_2-22.STL

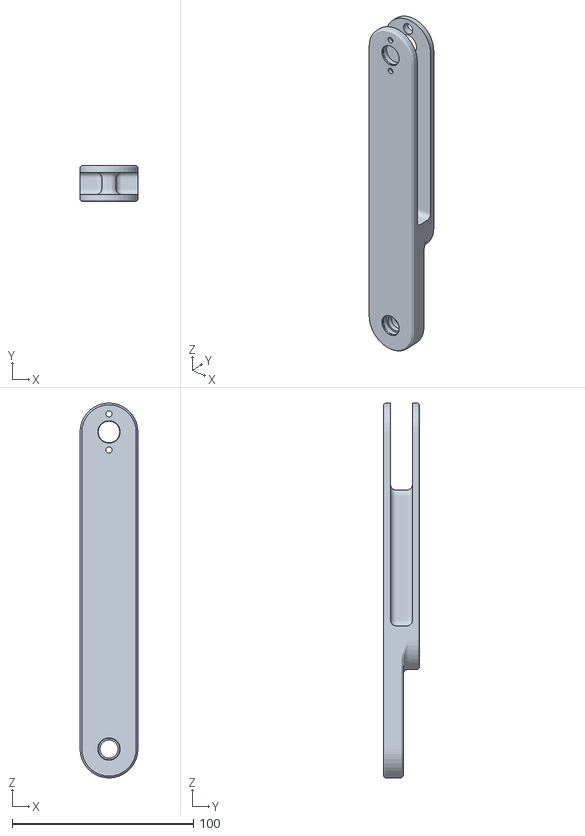
[picture p216: CAD file, 2022-11-08]
CAD/Tablet Capstone/Initial Prototypes/Mechanism Team/PH2R-PROTOTYPE/PRINTING/PH2R-BASE-LINK_2-22.STL
32.0 x 20.0 x 207.0
