yjc97/Haptic_Tablet/CAD/Tablet Capstone/ALPHA/CUSTOM/TB1-014-DISTAL-LINK-SHAFT.SLDPRT

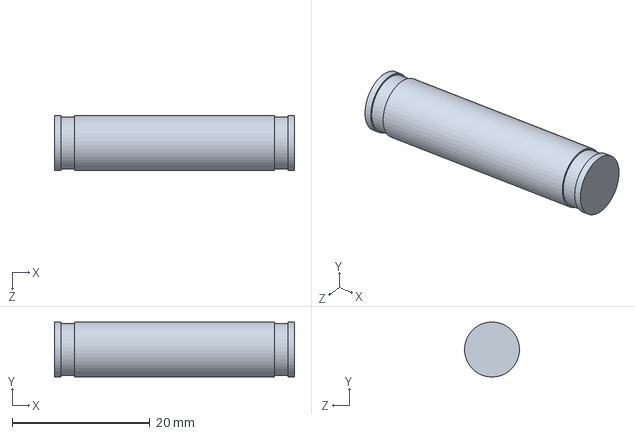
[picture p217: CAD file, 2022-11-08]
CAD/Tablet Capstone/ALPHA/CUSTOM/TB1-014-DISTAL-LINK-SHAFT.SLDPRT
34.9 x 7.98 x 8.00 mm
