yjc97/Haptic_Tablet/CAD/Tablet Capstone/ALPHA/DRAWINGS/DXFs/TB1-006-MOTOR-MOUNT_0.38_QTY4.DXF

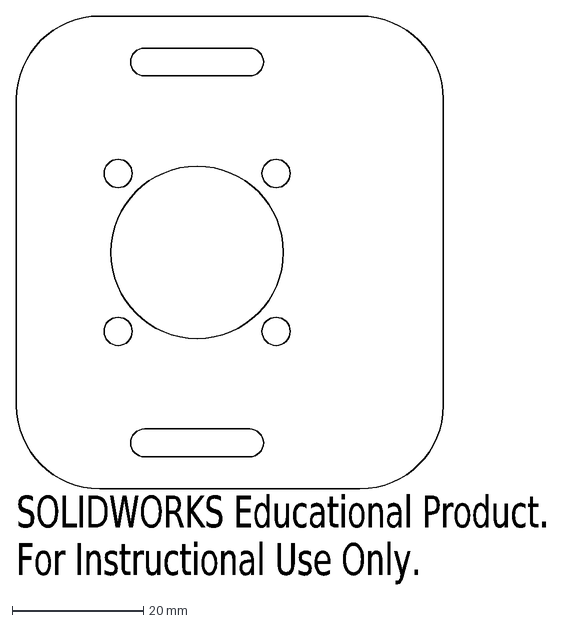
[picture p218: CAD file, 2022-11-08]
CAD/Tablet Capstone/ALPHA/DRAWINGS/DXFs/TB1-006-MOTOR-MOUNT_0.38_QTY4.DXF
SOLIDWORKS Educational Product.
For Instructional Use Only.
