yjc97/Haptic_Tablet/CAD/Tablet Capstone/ALPHA/Outer Link.SLDPRT

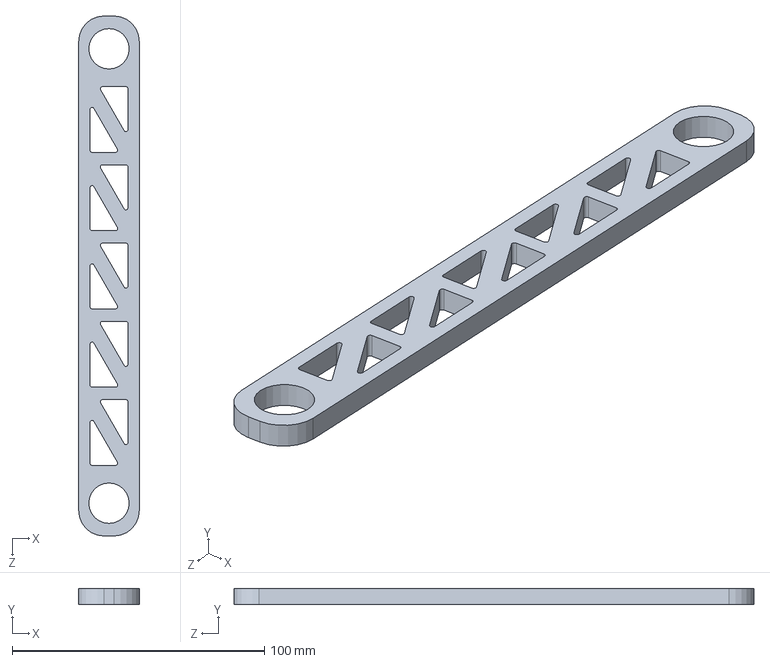
[picture p219: CAD file, 2022-11-08]
CAD/Tablet Capstone/ALPHA/Outer Link.SLDPRT
24.0 x 6.35 x 206.0 mm
