yjc97/Haptic_Tablet/CAD/Tablet Capstone/Frame/MagnetValidation/pulley_bracket.SLDPRT

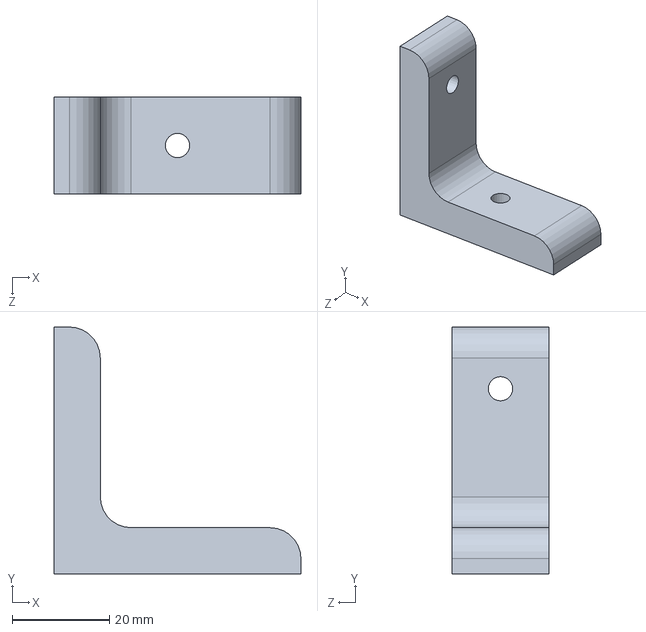
[picture p220: CAD file, 2022-11-08]
CAD/Tablet Capstone/Frame/MagnetValidation/pulley_bracket.SLDPRT
50.8 x 50.8 x 20.0 mm
