yjc97/Haptic_Tablet/CAD/Tablet Capstone/Frame/ScreenStuff/CasePieces_ForPrinting/STLs/TopLeft-1.STL

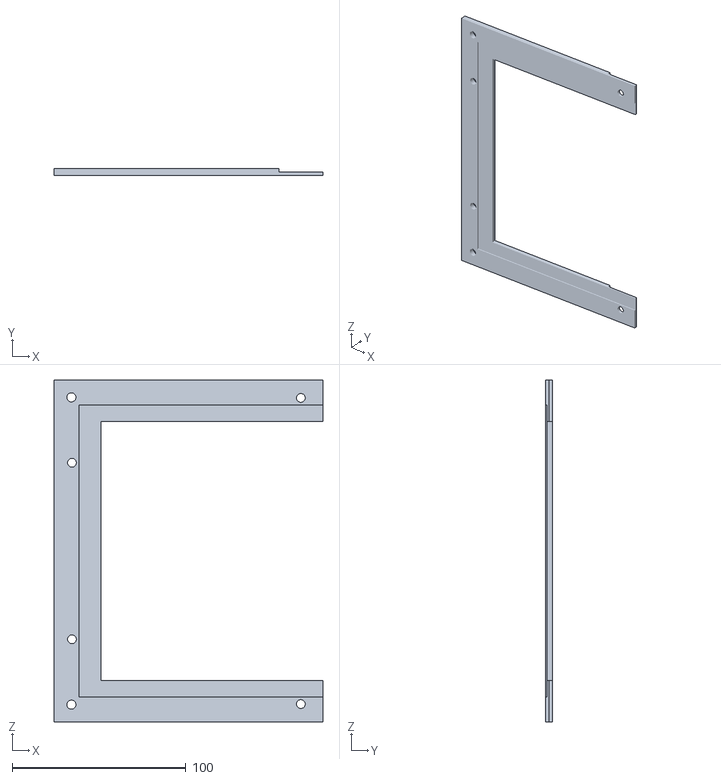
[picture p221: CAD file, 2022-11-08]
CAD/Tablet Capstone/Frame/ScreenStuff/CasePieces_ForPrinting/STLs/TopLeft-1.STL
154.8 x 4.04 x 196.9
