yjc97/Haptic_Tablet/CAD/Tablet Capstone/Frame/ScreenStuff/ScreenMountPlate.SLDPRT

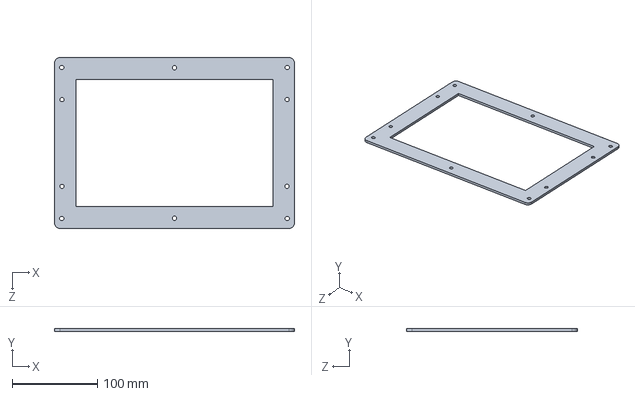
[picture p222: CAD file, 2022-11-08]
CAD/Tablet Capstone/Frame/ScreenStuff/ScreenMountPlate.SLDPRT
281.0 x 3.17 x 200.0 mm
