yjc97/Haptic_Tablet/CAD/Tablet Capstone/Initial Prototypes/1DOF Actuator Team/V2/BLY172D.STEP

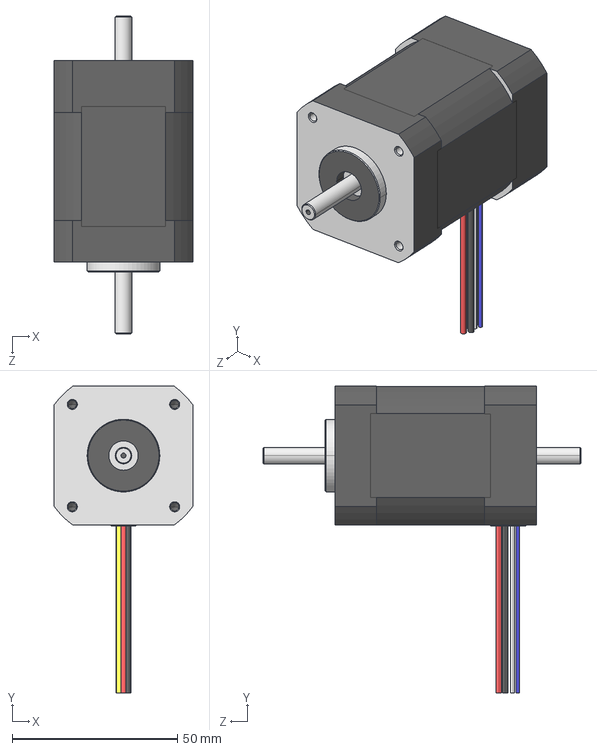
[picture p223: CAD file, 2022-11-08]
CAD/Tablet Capstone/Initial Prototypes/1DOF Actuator Team/V2/BLY172D.STEP
42.0 x 92.8 x 96.3 mm
