yjc97/Haptic_Tablet/CAD/Tablet Capstone/Initial Prototypes/Mechanism Team/2R-ARM-PROTOTYPE/2R-ALIGNMENT-PLATE.SLDPRT

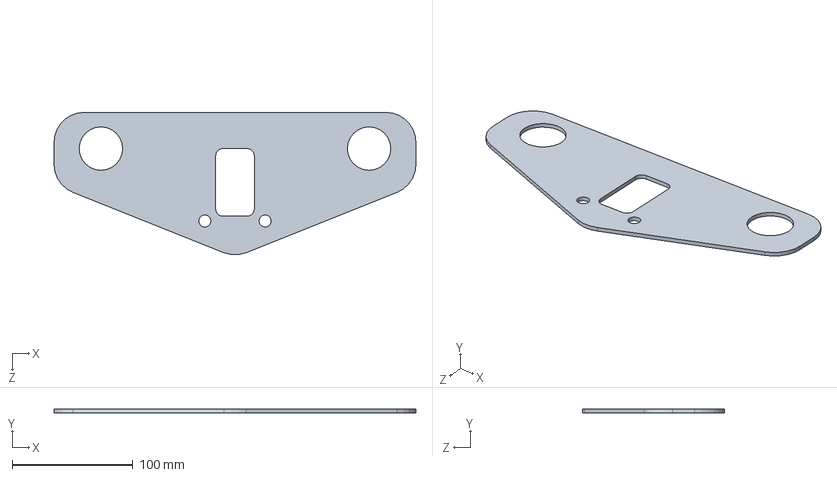
[picture p224: CAD file, 2022-11-08]
CAD/Tablet Capstone/Initial Prototypes/Mechanism Team/2R-ARM-PROTOTYPE/2R-ALIGNMENT-PLATE.SLDPRT
300.0 x 3.17 x 117.9 mm
