yjc97/Haptic_Tablet/CAD/Tablet Capstone/Initial Prototypes/Mechanism Team/2R-ARM-PROTOTYPE/PRINTING/2R-END-LINK-2-16.STL

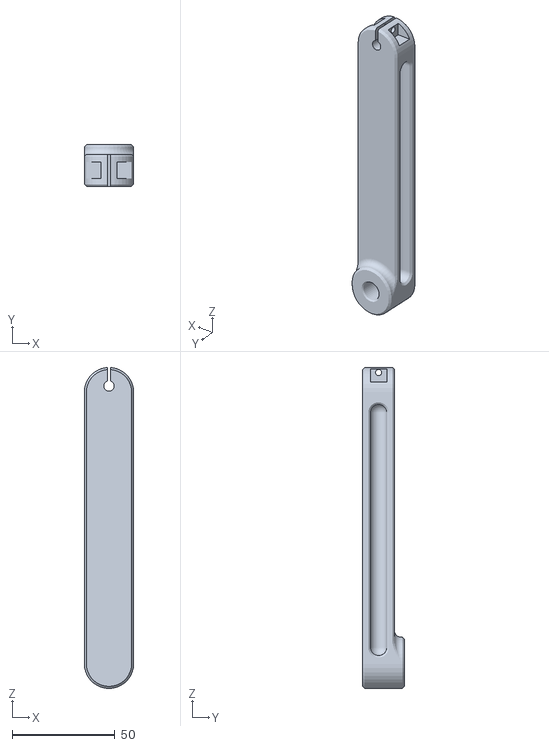
[picture p225: CAD file, 2022-11-08]
CAD/Tablet Capstone/Initial Prototypes/Mechanism Team/2R-ARM-PROTOTYPE/PRINTING/2R-END-LINK-2-16.STL
24.0 x 20.2 x 156.0
