yjc97/Haptic_Tablet/CAD/Tablet Capstone/Initial Prototypes/Mechanism Team/AdjustableScreen/RiserSpacer4.0.SLDPRT

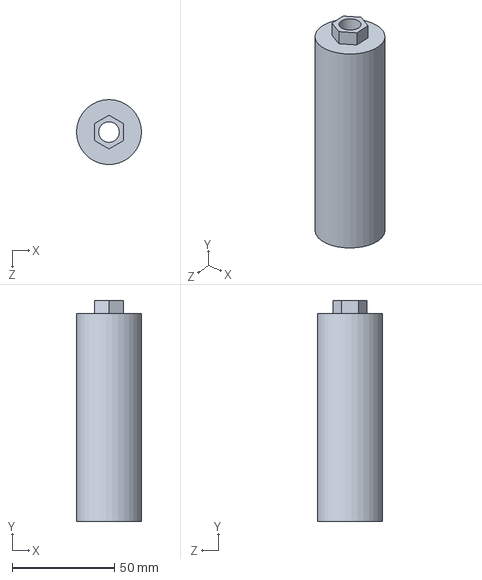
[picture p226: CAD file, 2022-11-08]
CAD/Tablet Capstone/Initial Prototypes/Mechanism Team/AdjustableScreen/RiserSpacer4.0.SLDPRT
31.7 x 108.0 x 31.7 mm
