yjc97/Haptic_Tablet/CAD/Tablet Capstone/Initial Prototypes/Mechanism Team/AdjustableScreen/STLs/RiserSpacer3.0_Q4.STL

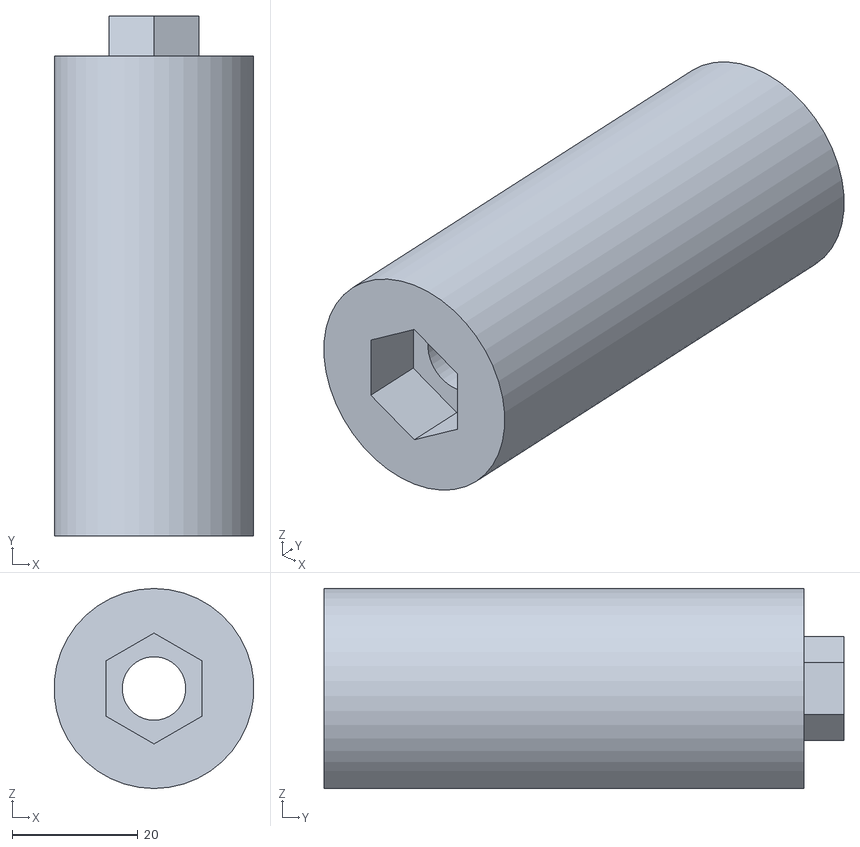
[picture p227: CAD file, 2022-11-08]
CAD/Tablet Capstone/Initial Prototypes/Mechanism Team/AdjustableScreen/STLs/RiserSpacer3.0_Q4.STL
31.7 x 82.5 x 31.8
