yjc97/Haptic_Tablet/CAD/Tablet Capstone/Initial Prototypes/Mechanism Team/Air Bearings/Multi-holePuck.SLDPRT

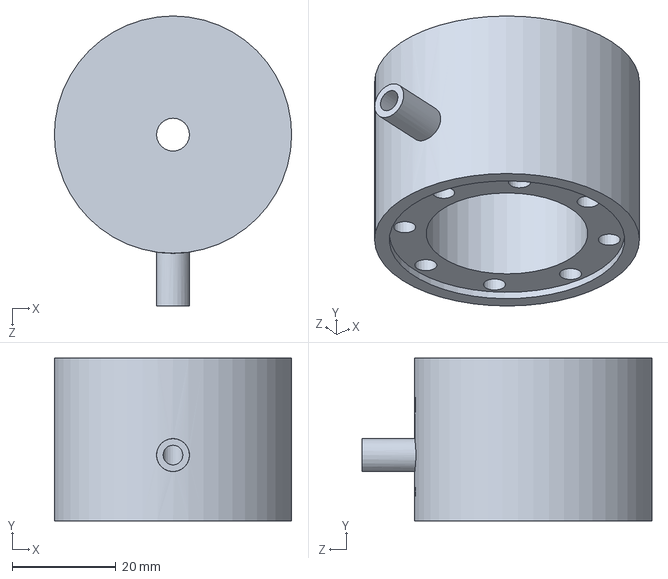
[picture p228: CAD file, 2022-11-08]
CAD/Tablet Capstone/Initial Prototypes/Mechanism Team/Air Bearings/Multi-holePuck.SLDPRT
45.7 x 31.4 x 55.9 mm
