yjc97/Haptic_Tablet/CAD/Tablet Capstone/Initial Prototypes/Mechanism Team/CABLE-BOT-PROTOTYPE/PRINTING/CABLE-CARRIAGE-2-16.STL

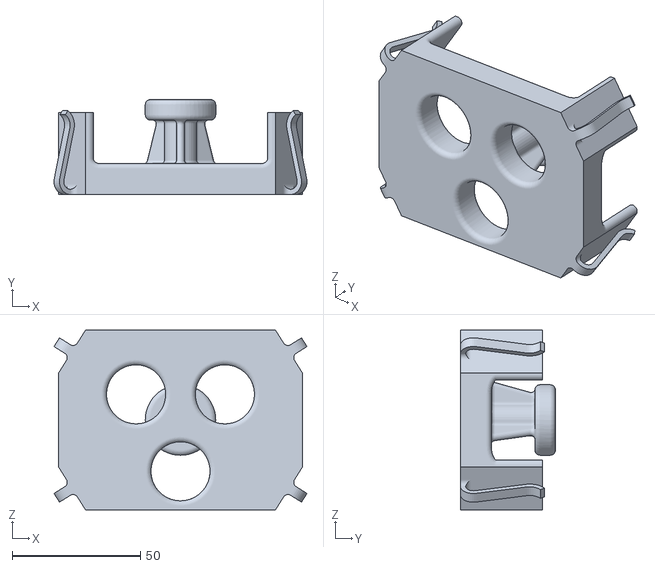
[picture p229: CAD file, 2022-11-08]
CAD/Tablet Capstone/Initial Prototypes/Mechanism Team/CABLE-BOT-PROTOTYPE/PRINTING/CABLE-CARRIAGE-2-16.STL
98.6 x 37.0 x 70.0
