yjc97/Haptic_Tablet/CAD/Tablet Capstone/Initial Prototypes/Mechanism Team/GantryPrototype/Extrusions/20x20Extrusion-FrameTop.SLDPRT

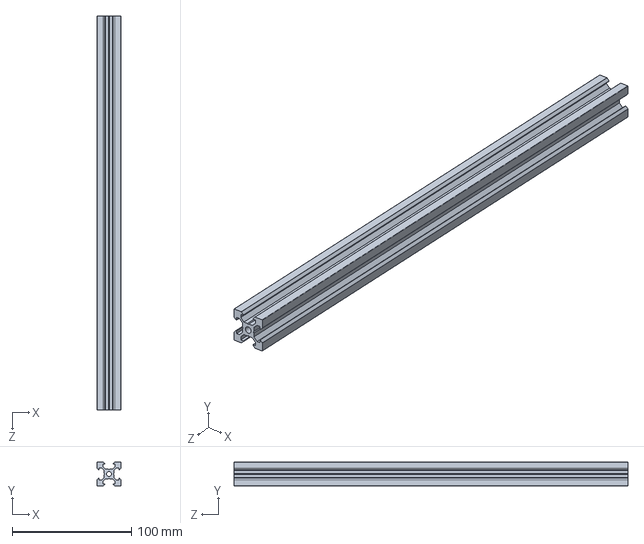
[picture p230: CAD file, 2022-11-08]
CAD/Tablet Capstone/Initial Prototypes/Mechanism Team/GantryPrototype/Extrusions/20x20Extrusion-FrameTop.SLDPRT
20.0 x 20.0 x 330.0 mm
