yjc97/Haptic_Tablet/CAD/Tablet Capstone/Initial Prototypes/Mechanism Team/GantryPrototype/WheelPlates.SLDPRT

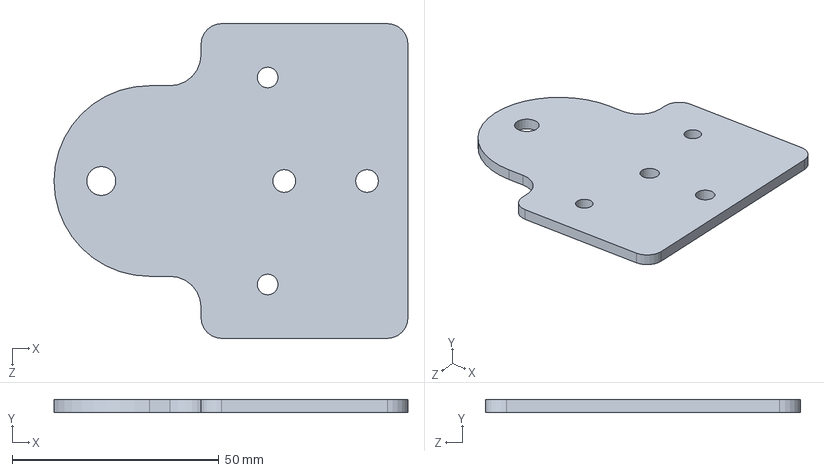
[picture p231: CAD file, 2022-11-08]
CAD/Tablet Capstone/Initial Prototypes/Mechanism Team/GantryPrototype/WheelPlates.SLDPRT
85.5 x 3.17 x 76.0 mm
