yjc97/Haptic_Tablet/CAD/Tablet Capstone/Initial Prototypes/Mechanism Team/MagnetHolderV1_STL.STL

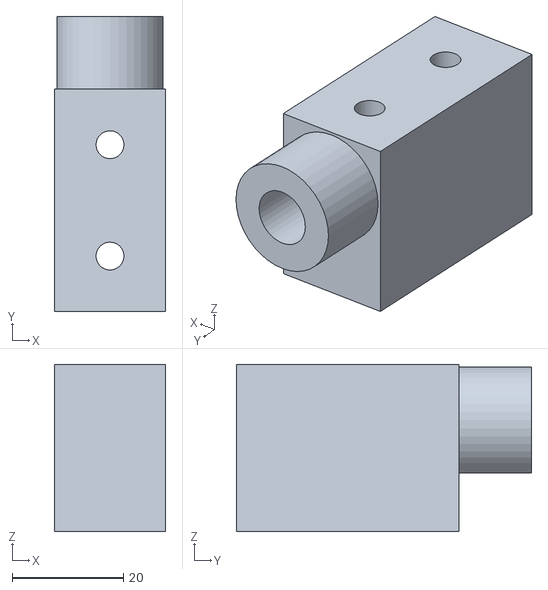
[picture p232: CAD file, 2022-11-08]
CAD/Tablet Capstone/Initial Prototypes/Mechanism Team/MagnetHolderV1_STL.STL
20.0 x 53.1 x 30.0
