yjc97/Haptic_Tablet/CAD/Tablet Capstone/Initial Prototypes/Mechanism Team/Magnets/Alpha Final Magnets/Bottom_Magnet_Peg_V15.SLDPRT

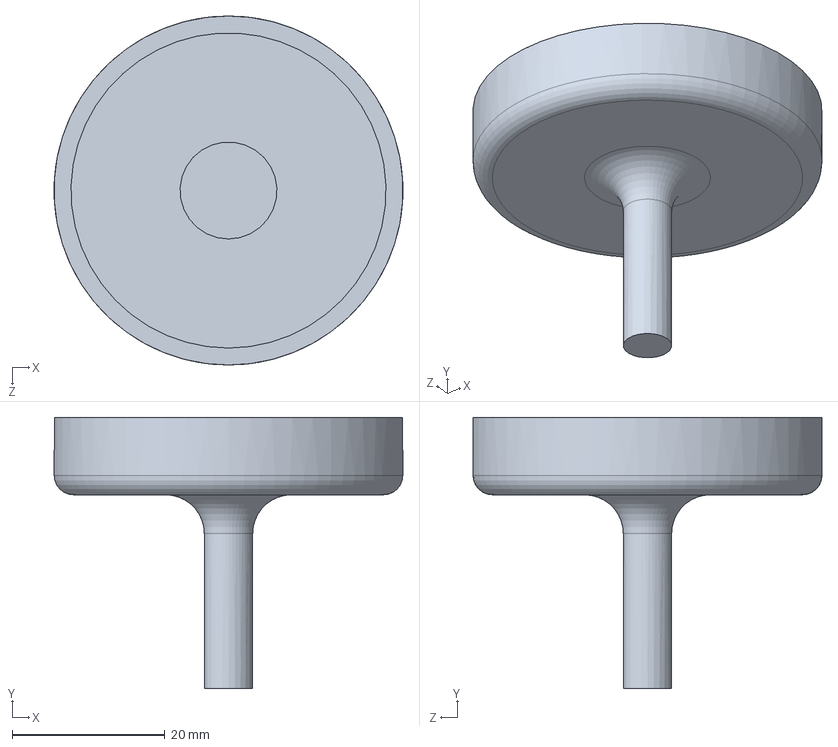
[picture p233: CAD file, 2022-11-08]
CAD/Tablet Capstone/Initial Prototypes/Mechanism Team/Magnets/Alpha Final Magnets/Bottom_Magnet_Peg_V15.SLDPRT
45.7 x 35.6 x 45.7 mm
