yjc97/Haptic_Tablet/CAD/Tablet Capstone/Initial Prototypes/Mechanism Team/Magnets/Beta Final Magnets/Magnet Puck (Open).SLDPRT

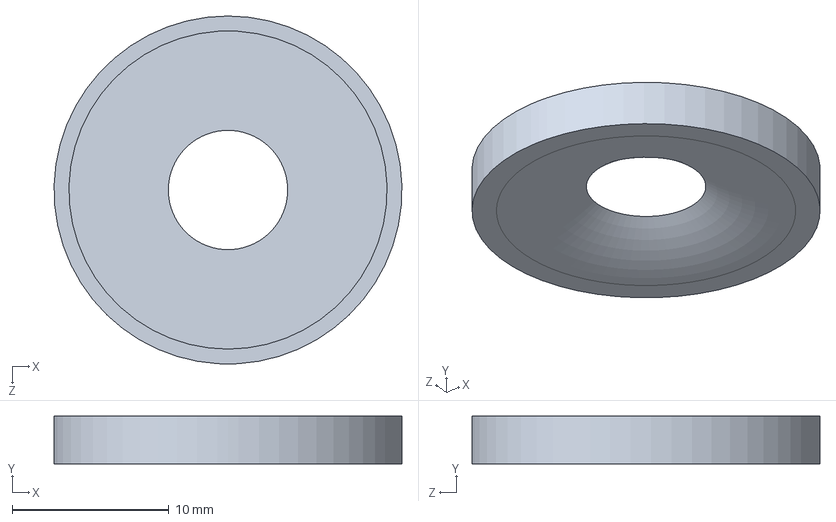
[picture p234: CAD file, 2022-11-08]
CAD/Tablet Capstone/Initial Prototypes/Mechanism Team/Magnets/Beta Final Magnets/Magnet Puck (Open).SLDPRT
22.2 x 3.05 x 22.2 mm
