yjc97/Haptic_Tablet/CAD/Tablet Capstone/Initial Prototypes/Mechanism Team/PH2R-PROTOTYPE/GLASS-STAND-BASE.SLDPRT

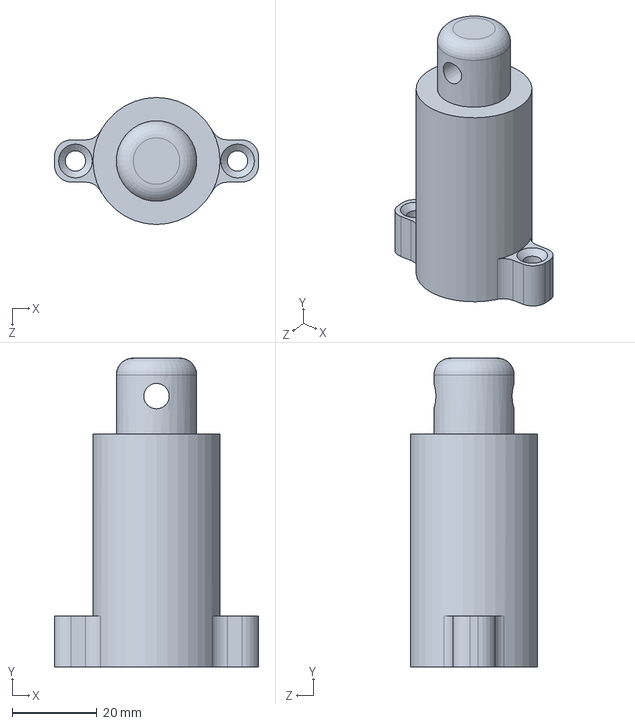
[picture p235: CAD file, 2022-11-08]
CAD/Tablet Capstone/Initial Prototypes/Mechanism Team/PH2R-PROTOTYPE/GLASS-STAND-BASE.SLDPRT
48.3 x 73.0 x 30.0 mm
