yjc97/Haptic_Tablet/CAD/Tablet Capstone/Initial Prototypes/Mechanism Team/PH2R-PROTOTYPE/PRINTING/PH2R-PROX-LINK-BOT_2-24.STL

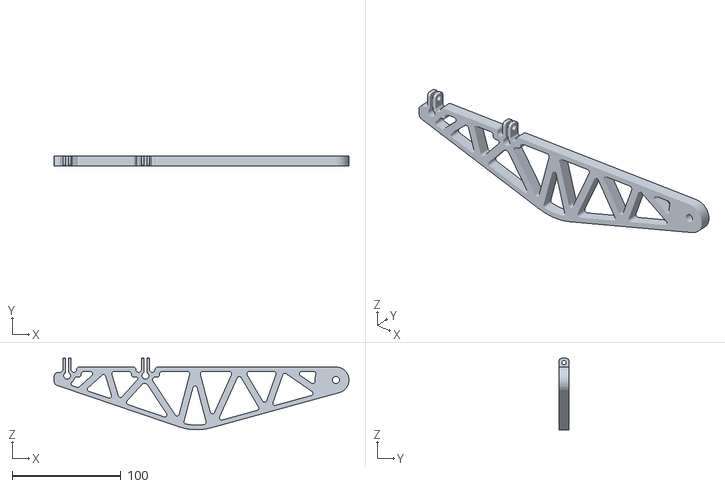
[picture p236: CAD file, 2022-11-08]
CAD/Tablet Capstone/Initial Prototypes/Mechanism Team/PH2R-PROTOTYPE/PRINTING/PH2R-PROX-LINK-BOT_2-24.STL
271.0 x 9.00 x 65.7
