yjc97/Haptic_Tablet/CAD/Tablet Capstone/ALPHA/DRAWINGS/DXFs/TB1-004-TRANSMISSION-PLATE-TOP_0.25.DXF

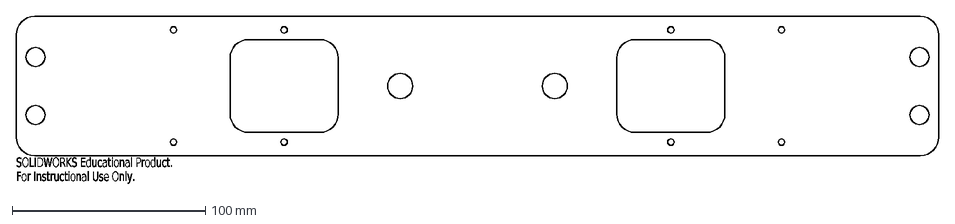
[picture p237: CAD file, 2022-11-08]
CAD/Tablet Capstone/ALPHA/DRAWINGS/DXFs/TB1-004-TRANSMISSION-PLATE-TOP_0.25.DXF
SOLIDWORKS Educational Product.
For Instructional Use Only.
