yjc97/Haptic_Tablet/CAD/Tablet Capstone/Initial Prototypes/Mechanism Team/2R-ARM-PROTOTYPE/PRINTING/2R-ANCHOR-2-17.STL

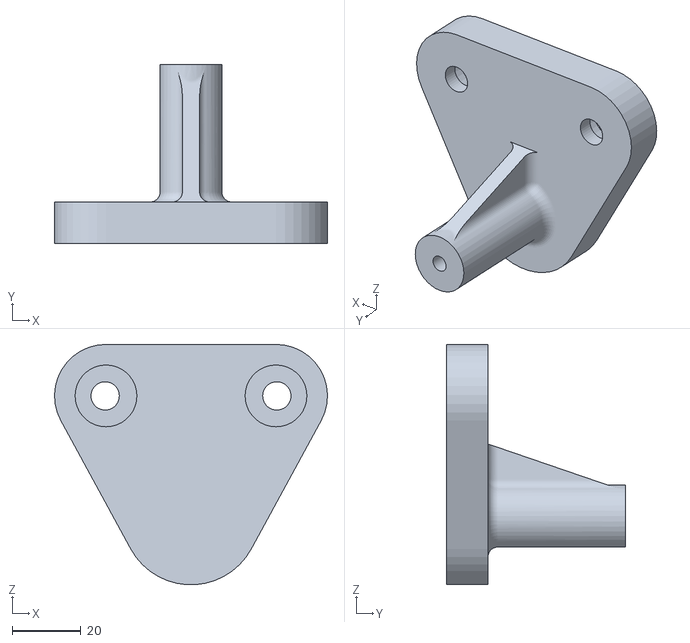
[picture p239: CAD file, 2022-11-08]
CAD/Tablet Capstone/Initial Prototypes/Mechanism Team/2R-ARM-PROTOTYPE/PRINTING/2R-ANCHOR-2-17.STL
79.5 x 52.0 x 69.9
