yjc97/Haptic_Tablet/CAD/Tablet Capstone/Initial Prototypes/Mechanism Team/AdjustableScreen/STLs/GlassAdapter_Q3.STL

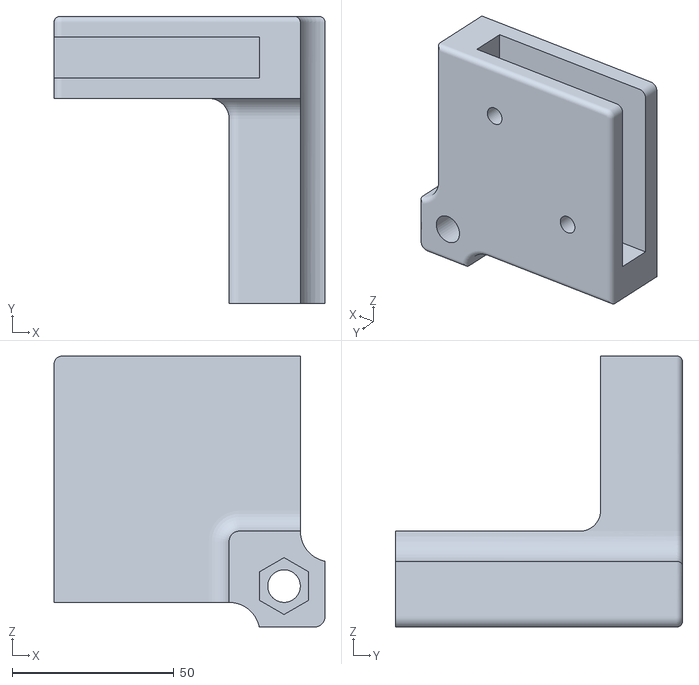
[picture p240: CAD file, 2022-11-08]
CAD/Tablet Capstone/Initial Prototypes/Mechanism Team/AdjustableScreen/STLs/GlassAdapter_Q3.STL
83.8 x 88.9 x 83.8
