yjc97/Haptic_Tablet/CAD/Tablet Capstone/Initial Prototypes/Mechanism Team/Air Bearings/2261.SLDPRT

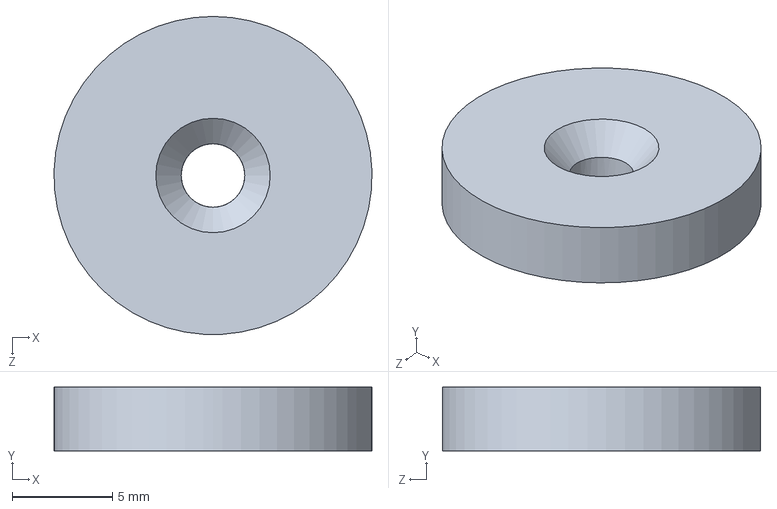
[picture p241: CAD file, 2022-11-08]
CAD/Tablet Capstone/Initial Prototypes/Mechanism Team/Air Bearings/2261.SLDPRT
15.9 x 3.17 x 15.9 mm
