yjc97/Haptic_Tablet/CAD/Tablet Capstone/Initial Prototypes/Mechanism Team/D2R-CONCEPT-MODEL/D2R-PROX-LINK-TOP.SLDPRT

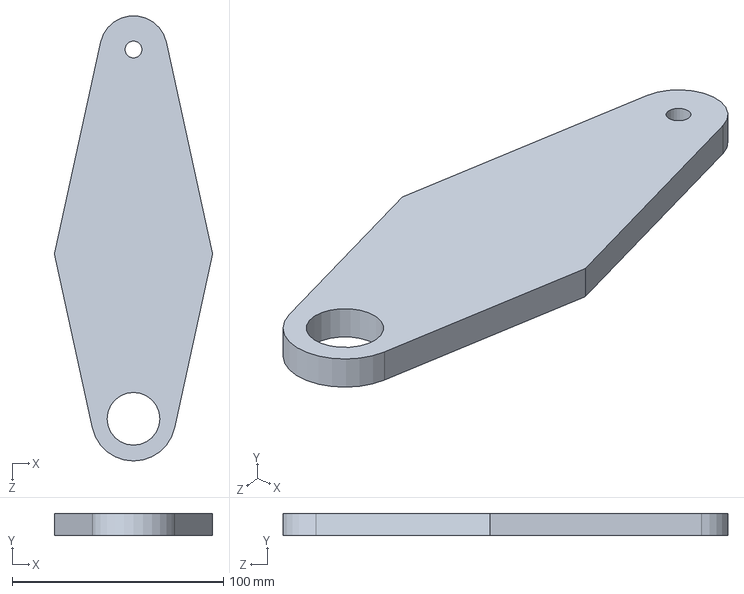
[picture p242: CAD file, 2022-11-08]
CAD/Tablet Capstone/Initial Prototypes/Mechanism Team/D2R-CONCEPT-MODEL/D2R-PROX-LINK-TOP.SLDPRT
75.0 x 10.5 x 210.9 mm
