yjc97/Haptic_Tablet/CAD/Tablet Capstone/Initial Prototypes/Mechanism Team/GantryPrototype/Extrusions/40x40Extrusion-CenterPiece.SLDPRT

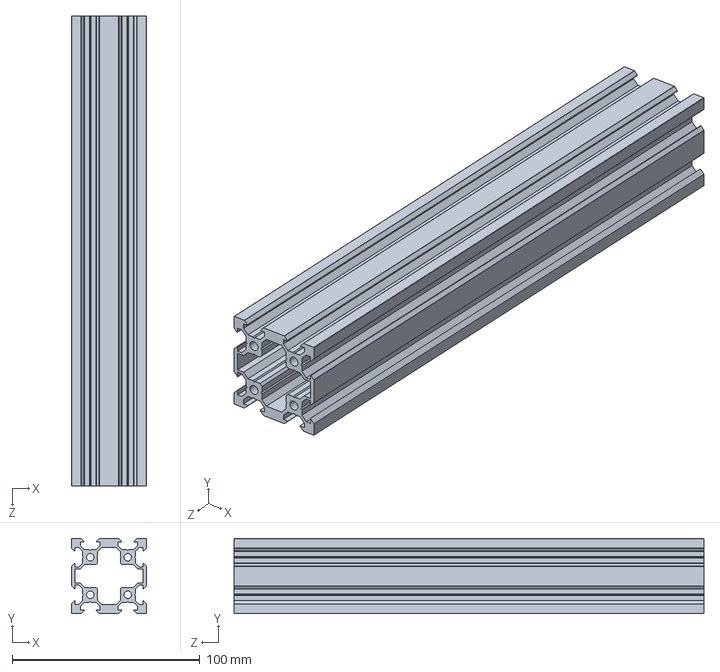
[picture p244: CAD file, 2022-11-08]
CAD/Tablet Capstone/Initial Prototypes/Mechanism Team/GantryPrototype/Extrusions/40x40Extrusion-CenterPiece.SLDPRT
40.0 x 40.0 x 250.0 mm
