yjc97/Haptic_Tablet/CAD/Tablet Capstone/Initial Prototypes/Mechanism Team/GantryPrototype/MagnetHolderOverhang.SLDPRT

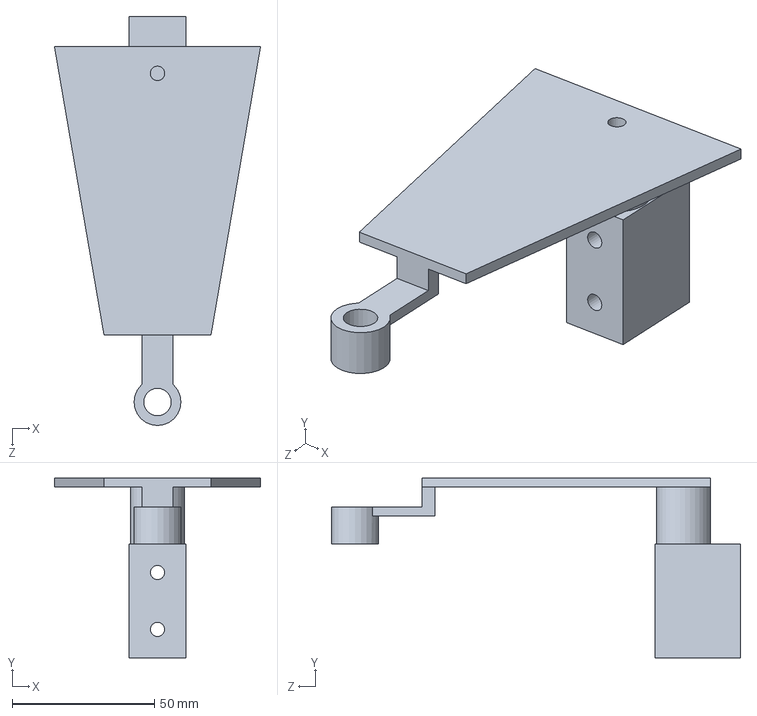
[picture p245: CAD file, 2022-11-08]
CAD/Tablet Capstone/Initial Prototypes/Mechanism Team/GantryPrototype/MagnetHolderOverhang.SLDPRT
72.5 x 63.2 x 143.9 mm
