yjc97/Haptic_Tablet/CAD/Tablet Capstone/Initial Prototypes/Mechanism Team/Magnets/Beta Final Magnets/Bottom Magnet (Strong).SLDPRT

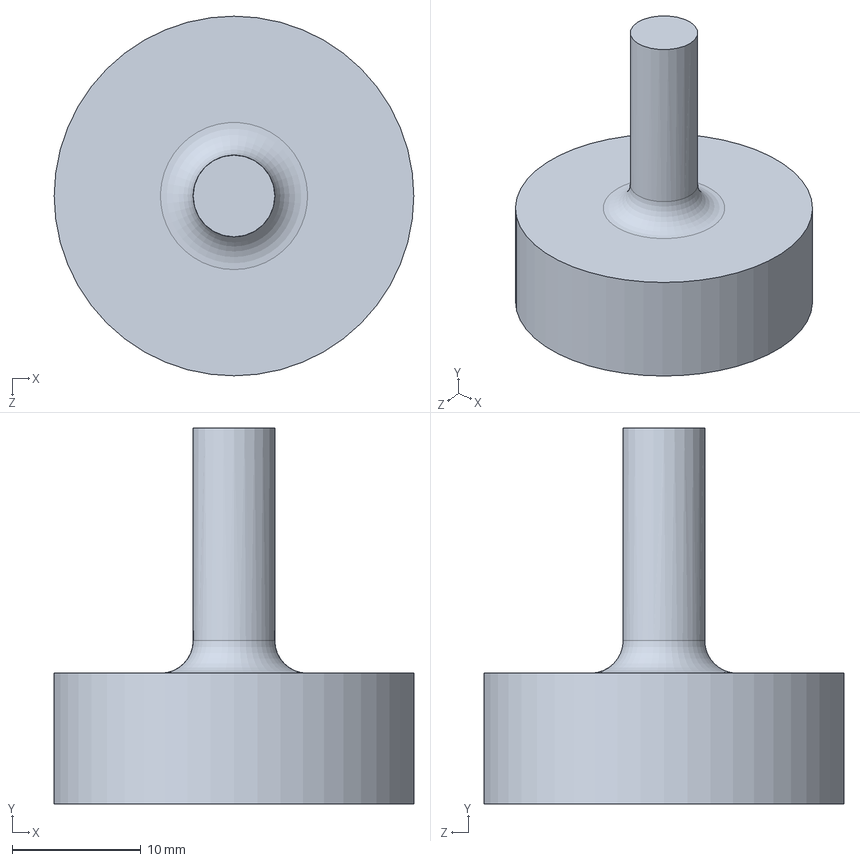
[picture p246: CAD file, 2022-11-08]
CAD/Tablet Capstone/Initial Prototypes/Mechanism Team/Magnets/Beta Final Magnets/Bottom Magnet (Strong).SLDPRT
27.9 x 29.2 x 27.9 mm
