yjc97/Haptic_Tablet/CAD/Tablet Capstone/Initial Prototypes/Mechanism Team/Magnets/First Quarter - Final Magnet/Polymagnet.SLDPRT

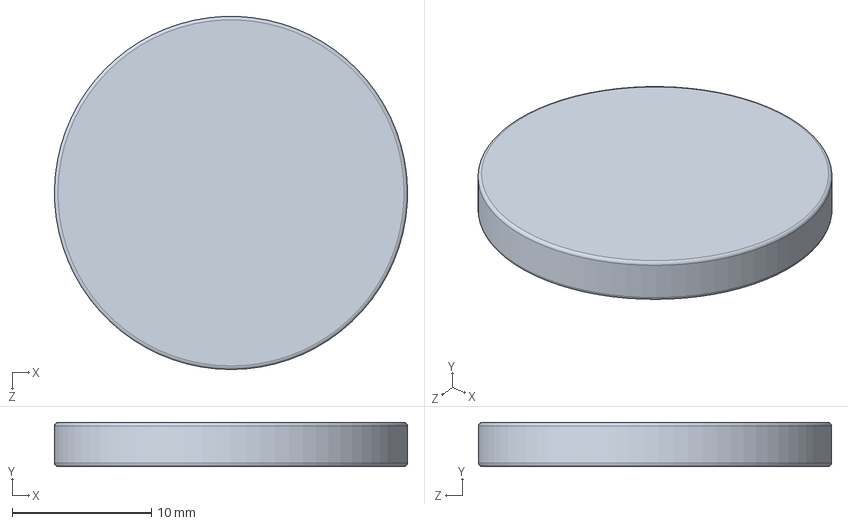
[picture p247: CAD file, 2022-11-08]
CAD/Tablet Capstone/Initial Prototypes/Mechanism Team/Magnets/First Quarter - Final Magnet/Polymagnet.SLDPRT
25.4 x 3.17 x 25.4 mm
