yjc97/Haptic_Tablet/CAD/Tablet Capstone/Initial Prototypes/Mechanism Team/Overhang_flop.SLDPRT

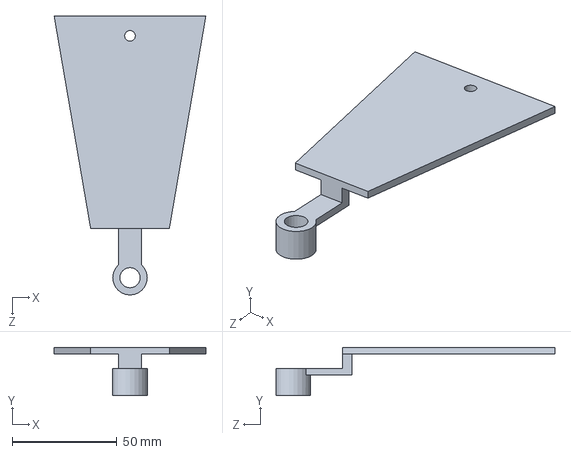
[picture p248: CAD file, 2022-11-08]
CAD/Tablet Capstone/Initial Prototypes/Mechanism Team/Overhang_flop.SLDPRT
72.5 x 23.2 x 133.4 mm
