yjc97/Haptic_Tablet/CAD/Tablet Capstone/Initial Prototypes/Mechanism Team/PH2R-PROTOTYPE/PRINTING/PH2R-CON-LINK_2-22.STL

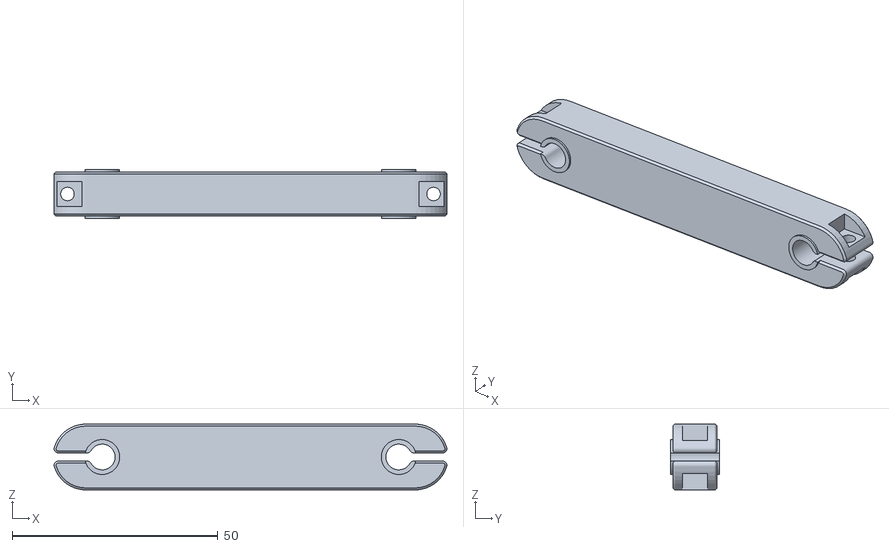
[picture p249: CAD file, 2022-11-08]
CAD/Tablet Capstone/Initial Prototypes/Mechanism Team/PH2R-PROTOTYPE/PRINTING/PH2R-CON-LINK_2-22.STL
95.4 x 11.8 x 16.0
