yjc97/Haptic_Tablet/CAD/Tablet Capstone/ALPHA/CUSTOM/TB1-009-PULLEY-SPACER.SLDPRT

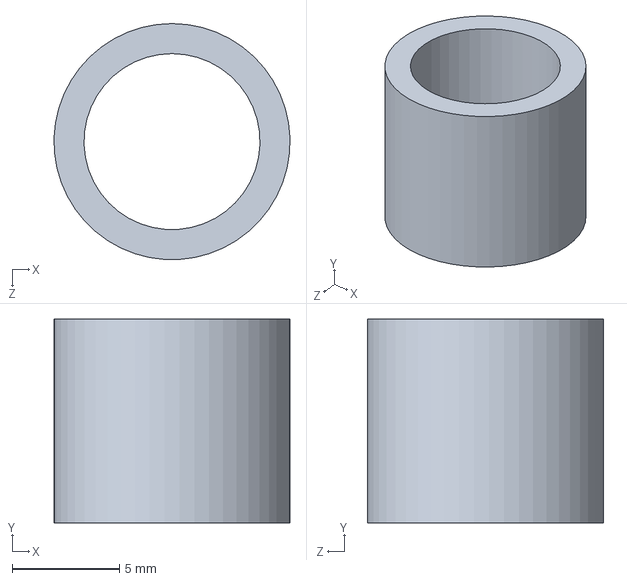
[picture p250: CAD file, 2022-11-08]
CAD/Tablet Capstone/ALPHA/CUSTOM/TB1-009-PULLEY-SPACER.SLDPRT
11.0 x 9.50 x 11.0 mm
