yjc97/Haptic_Tablet/CAD/Tablet Capstone/ALPHA/DRAWINGS/DXFs/TB1-016-TRANSMISSION-PLATE-BOT_0.25.DXF

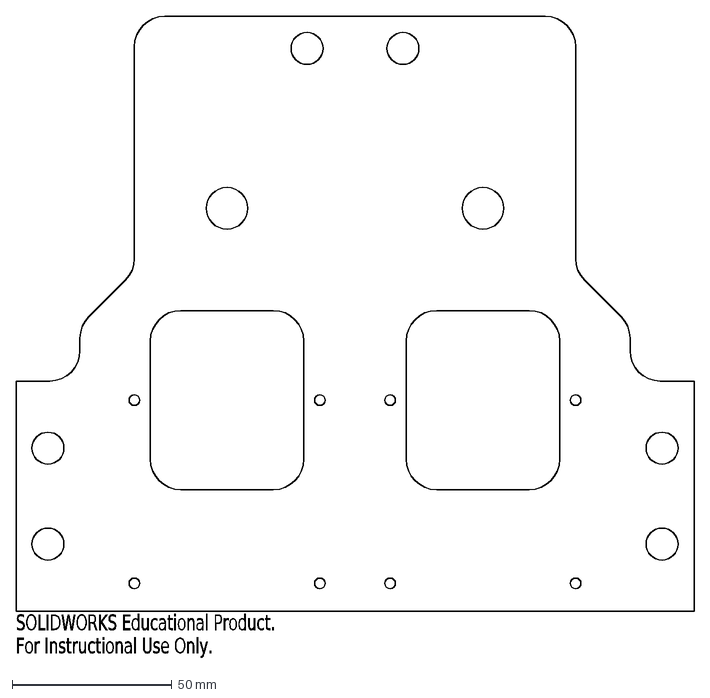
[picture p251: CAD file, 2022-11-08]
CAD/Tablet Capstone/ALPHA/DRAWINGS/DXFs/TB1-016-TRANSMISSION-PLATE-BOT_0.25.DXF
SOLIDWORKS Educational Product.
For Instructional Use Only.
