yjc97/Haptic_Tablet/CAD/Tablet Capstone/Initial Prototypes/1DOF Actuator Team/V2/Gantry Magnet Mount_V2.STL

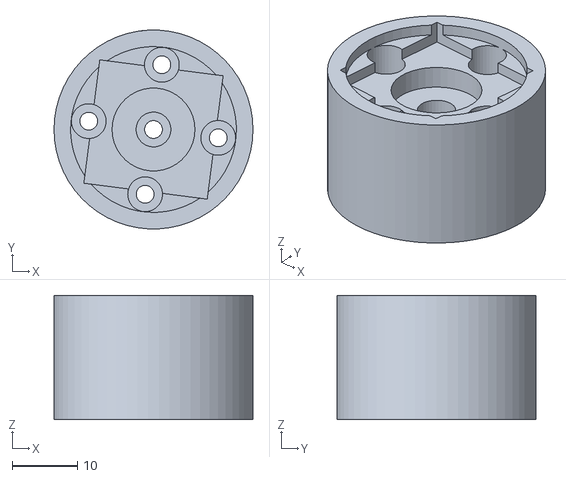
[picture p252: CAD file, 2022-11-08]
CAD/Tablet Capstone/Initial Prototypes/1DOF Actuator Team/V2/Gantry Magnet Mount_V2.STL
30.5 x 30.4 x 19.1
