yjc97/Haptic_Tablet/(list of files, cad)

Other CAD files:
CAD/Tablet Capstone/Initial Prototypes/Mechanism Team/Ender3 Files/STEP Import/ASM X-Axis.step.SLDASM
CAD/Tablet Capstone/Initial Prototypes/Mechanism Team/Ender3 Files/STEP Import/ASM Display.step.SLDASM
CAD/Tablet Capstone/Initial Prototypes/Mechanism Team/Ender3 Files/STEP Import/ASM Eccentrical Roller Y-Axis.step.SLDASM
CAD/Tablet Capstone/Initial Prototypes/Mechanism Team/Ender3 Files/STEP Import/ASM Frame.step.SLDASM
CAD/Tablet Capstone/Initial Prototypes/Mechanism Team/Ender3 Files/STEP Import/ASM Roller Z-Axis Left.step.SLDASM
CAD/Tablet Capstone/Initial Prototypes/Mechanism Team/Ender3 Files/STEP Import/ASM Roller X-Axis.step.SLDASM
CAD/Tablet Capstone/Initial Prototypes/Mechanism Team/Ender3 Files/DenisSofron_Proyecto_EG_Ender_3_PackandGo/Ensamblaje_Rueda_Normal_EjeX.SLDASM
CAD/Tablet Capstone/Initial Prototypes/Mechanism Team/Ender3 Files/DenisSofron_Proyecto_EG_Ender_3_PackandGo/Ensamblaje_Rueda_Excentrica_EjeY.SLDASM
CAD/Tablet Capstone/Initial Prototypes/Mechanism Team/Ender3 Files/DenisSofron_Proyecto_EG_Ender_3_PackandGo/Ensamblaje_Rueda_Normal_EjeY.SLDASM
CAD/Tablet Capstone/Initial Prototypes/Mechanism Team/Ender3 Files/DenisSofron_Proyecto_EG_Ender_3_PackandGo/Ensamblaje_Eje_Y.SLDASM
CAD/Tablet Capstone/Initial Prototypes/Mechanism Team/Ender3 Files/DenisSofron_Proyecto_EG_Ender_3_PackandGo/Ensamblaje_Rueda_Excentrica_EjeZ_D.SLDASM
CAD/Tablet Capstone/Initial Prototypes/Mechanism Team/Ender3 Files/STEP Import/ASM Extruder.step.SLDASM
CAD/Tablet Capstone/Initial Prototypes/Mechanism Team/Ender3 Files/STEP Import/ASM Y-Axis Limit Switch.step.SLDASM
CAD/Tablet Capstone/Initial Prototypes/Mechanism Team/Ender3 Files/STEP Import/ASM Power Supply.step.SLDASM
CAD/Tablet Capstone/Initial Prototypes/Mechanism Team/Ender3 Files/DenisSofron_Proyecto_EG_Ender_3_PackandGo/Ensamblaje_Rueda_Normal_EjeZ_D.SLDASM
CAD/Tablet Capstone/Initial Prototypes/Mechanism Team/Ender3 Files/STEP Import/ASM Bed.step.SLDASM
CAD/Tablet Capstone/Initial Prototypes/Mechanism Team/Ender3 Files/STEP Import/ASM Z-Axis Limit Switch.step.SLDASM
CAD/Tablet Capstone/Initial Prototypes/Mechanism Team/Ender3 Files/STEP Import/ASM Y-Axis.step.SLDASM
CAD/Tablet Capstone/Initial Prototypes/Mechanism Team/Ender3 Files/STEP Import/ASM Printing Head.step.SLDASM
CAD/Tablet Capstone/Initial Prototypes/Mechanism Team/Ender3 Files/STEP Import/ASM Electronic Enclosure.step.SLDASM
CAD/Tablet Capstone/Initial Prototypes/Mechanism Team/Ender3 Files/DenisSofron_Proyecto_EG_Ender_3_PackandGo/Ensamblaje_Tensor_Eje_Y.SLDASM
CAD/Tablet Capstone/Initial Prototypes/Mechanism Team/Ender3 Files/STEP Import/ASM Z-Axis.step.SLDASM
CAD/Tablet Capstone/Initial Prototypes/Mechanism Team/Ender3 Files/DenisSofron_Proyecto_EG_Ender_3_PackandGo/Ensamblaje_Tornillería_Ruedas.SLDASM
CAD/Tablet Capstone/Initial Prototypes/Mechanism Team/Ender3 Files/STEP Import/ASM Eccentrical Roller X-Axis.step.SLDASM
CAD/Tablet Capstone/Initial Prototypes/Mechanism Team/Ender3 Files/STEP Import/ASM Spool Holder.step.SLDASM
CAD/Tablet Capstone/Initial Prototypes/Mechanism Team/Ender3 Files/STEP Import/ASM Heating Unit.step.SLDASM
CAD/Tablet Capstone/Initial Prototypes/Mechanism Team/Ender3 Files/STEP Import/ASM Roller Y-Axis.step.SLDASM
CAD/Tablet Capstone/Initial Prototypes/Mechanism Team/Ender3 Files/STEP Import/ASM Roller Z-Axis Right.step.SLDASM
CAD/Tablet Capstone/Initial Prototypes/Mechanism Team/Ender3 Files/STEP Import/ASM Eccentrical Roller Z-Axis Left.step.SLDASM
CAD/Tablet Capstone/Initial Prototypes/Mechanism Team/Ender3 Files/STEP Import/ASM Eccentrical Roller Z-Axis Right.step.SLDASM
CAD/Tablet Capstone/Initial Prototypes/Mechanism Team/Ender3 Files/STEP Import/ASM X-Belt Tensioner.step.SLDASM
CAD/Tablet Capstone/Initial Prototypes/Mechanism Team/Ender3 Files/STEP Import/ASM Y-Belt Tensioner.step.SLDASM
CAD/Tablet Capstone/Initial Prototypes/Mechanism Team/Ender3 Files/STEP Import/Ender_3_Whole_Assembly (1).step.SLDASM
CAD/Tablet Capstone/Frame/ScreenStuff/CasePieces_ForPrinting/BottomLeft.SLDPRT
CAD/Tablet Capstone/Initial Prototypes/Mechanism Team/CABLE-BOT-PROTOTYPE/PRINTING/MAGNET-SUPPORT-2-17.STL
CAD/Tablet Capstone/Initial Prototypes/Mechanism Team/Ender3 Files/STEP Import/4040-3 profile.step.SLDPRT
CAD/Tablet Capstone/Frame/ScreenStuff/CasePieces_ForPrinting/TopLeft.SLDPRT
CAD/Tablet Capstone/Initial Prototypes/Mechanism Team/Ender3 Files/STEP Import/Y Adjustment Block.step.SLDPRT
CAD/Tablet Capstone/ALPHA/CUSTOM/TB1-004-TRANSMISSION-PLATE-BOT.SLDPRT
CAD/Tablet Capstone/Frame/ScreenStuff/CasePieces_ForPrinting/STLs/TopRight-1.STL
CAD/Tablet Capstone/Initial Prototypes/Mechanism Team/AdjustableScreen/RiserSpacer3.0.SLDPRT
CAD/Tablet Capstone/Initial Prototypes/Mechanism Team/CABLE-BOT-PROTOTYPE/PRINTING/CABLE-CARRIAGE-2-17.STL
CAD/Tablet Capstone/Frame/ScreenStuff/BottomRight.SLDPRT
CAD/Tablet Capstone/Frame/ScreenStuff/CasePieces_ForPrinting/BottomRight.SLDPRT
CAD/Tablet Capstone/Frame/ScreenStuff/CasePieces_ForPrinting/STLs/BottomLeft-1.STL
CAD/Tablet Capstone/ALPHA/CUSTOM/TB1-001-BASE-LINK.SLDPRT
CAD/Tablet Capstone/ALPHA/CUSTOM/TB1-002-DIST-LINK.SLDPRT
CAD/Tablet Capstone/ALPHA/CUSTOM/TB1-003-PROX-LINK.SLDPRT
CAD/Tablet Capstone/ALPHA/CUSTOM/TB1-004-TRANSMISSION-PLATE-TOP.SLDPRT
CAD/Tablet Capstone/ALPHA/CUSTOM/TB1-005-DRIVE-PULLEY.SLDPRT
CAD/Tablet Capstone/ALPHA/CUSTOM/TB1-006-MOTOR-MOUNT.SLDPRT
CAD/Tablet Capstone/ALPHA/CUSTOM/TB1-007-LONGER-SHAFT.SLDPRT
CAD/Tablet Capstone/ALPHA/CUSTOM/TB1-007-PROXIMAL-LINK-SHAFT.SLDPRT
CAD/Tablet Capstone/ALPHA/CUSTOM/TB1-008-TENSION-BAR.SLDPRT
CAD/Tablet Capstone/ALPHA/CUSTOM/TB1-010-PHANTOM-PULLEY.SLDPRT
CAD/Tablet Capstone/ALPHA/CUSTOM/TB1-011-PHANTOM-SPACER.SLDPRT
CAD/Tablet Capstone/ALPHA/CUSTOM/TB1-012-OUTER-LINK.SLDPRT
CAD/Tablet Capstone/ALPHA/CUSTOM/TB1-013-LINK-SPACER.SLDPRT
CAD/Tablet Capstone/ALPHA/CUSTOM/TB1-015-MAGNET-BUSHING.SLDPRT
CAD/Tablet Capstone/ALPHA/CUSTOM/TB1-016-TRANSMISSION-PLATE-BOT.SLDPRT
CAD/Tablet Capstone/ALPHA/CUSTOM/TB1-017-OUTER-LINK-SHAFT.SLDPRT
CAD/Tablet Capstone/ALPHA/DRAWINGS/DXFs/TB1-002-DIST-LINK_0.25_QTY2.DXF
CAD/Tablet Capstone/ALPHA/DRAWINGS/DXFs/TB1-003-PROX-LINK_0.38_QTY2.DXF
CAD/Tablet Capstone/ALPHA/DRAWINGS/DXFs/TB1-008-TENSION-BAR_0.38_QTY4.DXF
CAD/Tablet Capstone/ALPHA/DRAWINGS/DXFs/TB1-011-PHANTOM-SPACER_1.0.DXF
CAD/Tablet Capstone/ALPHA/DRAWINGS/TB1-002-DIST-LINK.SLDDRW
CAD/Tablet Capstone/ALPHA/DRAWINGS/TB1-003-PROX-LINK.SLDDRW
CAD/Tablet Capstone/ALPHA/DRAWINGS/TB1-004-TRANSMISSION-PLATE.SLDDRW
CAD/Tablet Capstone/ALPHA/DRAWINGS/TB1-005-DRIVE-PULLEY.SLDDRW
CAD/Tablet Capstone/ALPHA/DRAWINGS/TB1-006-MOTOR-MOUNT.SLDDRW
CAD/Tablet Capstone/ALPHA/DRAWINGS/TB1-007-PROXIMAL-LINK-SHAFT.SLDDRW
CAD/Tablet Capstone/ALPHA/DRAWINGS/TB1-008-TENSION-BAR.SLDDRW
CAD/Tablet Capstone/ALPHA/DRAWINGS/TB1-009-PULLEY-SPACER.SLDDRW
CAD/Tablet Capstone/ALPHA/DRAWINGS/TB1-011-PHANTOM-SPACER.SLDDRW
CAD/Tablet Capstone/ALPHA/DRAWINGS/TB1-013-LINK-SPACER.SLDDRW
CAD/Tablet Capstone/ALPHA/DRAWINGS/TB1-014-DISTAL-LINK-SHAFT.SLDDRW
CAD/Tablet Capstone/ALPHA/DRAWINGS/TB1-015-MAGNET-BUSHING.SLDDRW
CAD/Tablet Capstone/ALPHA/DRAWINGS/TB1-016-TRANSMISSION-PLATE-BOT.SLDDRW
CAD/Tablet Capstone/ALPHA/DRAWINGS/TB1-017-OUTER-LINK-SHAFT.SLDDRW
CAD/Tablet Capstone/ALPHA/DRAWINGS/TB1-018-POWER-SHAFT-1439K221_KEYED-SHAFT_8MM.SLDDRW
CAD/Tablet Capstone/ALPHA/PURCHASE/1277N775_XL-PULLEY_10-TEETH.SLDPRT
CAD/Tablet Capstone/ALPHA/PURCHASE/1277N777_XL-PULLEY_12-TEETH.SLDPRT
CAD/Tablet Capstone/ALPHA/PURCHASE/1277N787_XL-PULLEY_30-TEETH.SLDPRT
CAD/Tablet Capstone/ALPHA/PURCHASE/1679K197_Dust-Free Timing Belt.SLDPRT
CAD/Tablet Capstone/ALPHA/PURCHASE/3444N12_SHAFT-COLLAR_10MM-SHAFT.SLDPRT
CAD/Tablet Capstone/ALPHA/PURCHASE/5033N135_LIN-SHAFT_8MMX400L.SLDPRT
CAD/Tablet Capstone/ALPHA/PURCHASE/6383K215_Ball Bearing.SLDPRT
CAD/Tablet Capstone/ALPHA/PURCHASE/7804K117_BALL-BEARING_8MM-SHAFT.SLDPRT
CAD/Tablet Capstone/ALPHA/PURCHASE/8920N36_THRUST-BEARING_8MM-SHAFT.SLDPRT
CAD/Tablet Capstone/ALPHA/PURCHASE/90154A137_External Retaining Ring (1).SLDPRT
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
