yjc97/Haptic_Tablet/Mechanism/Magnet/Testing_.docx

TESTING NEEDED

1. Measure lateral forces when the arm is free
2. Measure lateral forces when the arm is fixed - how does the force displacement characteristic look?

PROCEDURE

1. Apply forces and use the touch screen to measure how the magnet moves - use a cable and over pulley with changing weights
