yjc97/Haptic_Tablet/CAD/Tablet Capstone/Initial Prototypes/1DOF Actuator Team/V1/new/test.txt

AGTFW30-GT2090-5
GPA30GT2090-A-H5
SSEBZ13_220
GBN4302GT-90
TBCF-S2M100-4H-N3-L16-P15
