yjc97/Haptic_Tablet/Software/calibration/reprojection.png

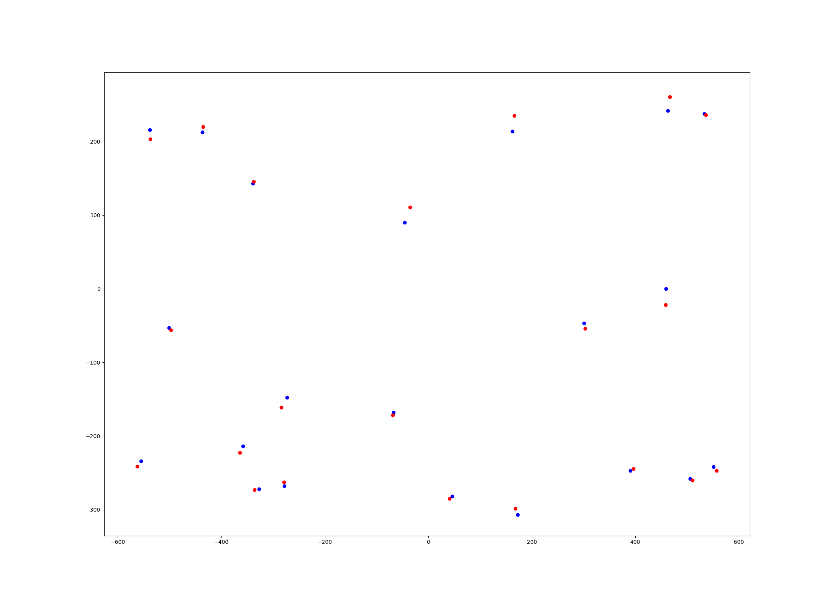
Software/calibration/reprojection.png
