yjc97/Haptic_Tablet/Alpha/Drawings/TB1-DRIVE-TRAIN.pdf

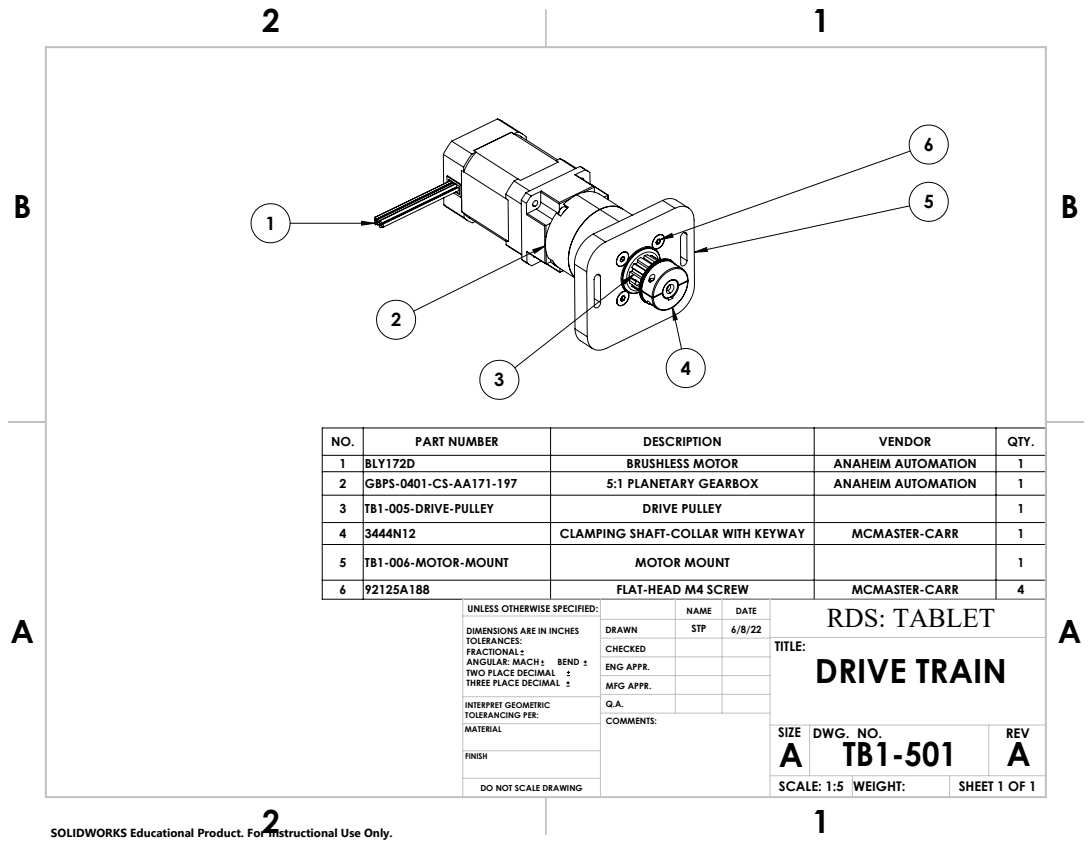
[picture p259: page 1]
SHEET 1 OF 1; SCALE: 1:5; WEIGHT:; DWG. NO.; REV

NO. | PART NUMBER | DESCRIPTION | VENDOR | QTY.
1 | BLY172D | BRUSHLESS MOTOR | ANAHEIM AUTOMATION | 1
2 | GBPS-0401-CS-AA171-197 | 5:1 PLANETARY GEARBOX | ANAHEIM AUTOMATION | 1
3 | TB1-005-DRIVE-PULLEY | DRIVE PULLEY | | 1
4 | 3444N12 | CLAMPING SHAFT-COLLAR WITH KEYWAY | MCMASTER-CARR | 1
5 | TB1-006-MOTOR-MOUNT | MOTOR MOUNT | | 1
6 | 92125A188 | FLAT-HEAD M4 SCREW | MCMASTER-CARR | 4

UNLESS OTHERWISE SPECIFIED: | | | DATE | RDS: TABLET NAME
DIMENSIONS ARE IN INCHES TOLERANCES: FRACTIONAL ANGULAR: MACH BEND TWO PLACE DECIMAL THREE PLACE DECIMAL | DRAWN | STP | 6/8/22
CHECKED | | | TITLE: DRIVE TRAIN

ENG APPR.
MFG APPR.

INTERPRET GEOMETRIC TOLERANCING PER: | Q.A.

DO NOT SCALE DRAWING

SOLIDWORKS Educational Product. For Instructional Use Only.
