yjc97/Haptic_Tablet/Alpha/Drawings/TB1-002-DIST-LINK.pdf

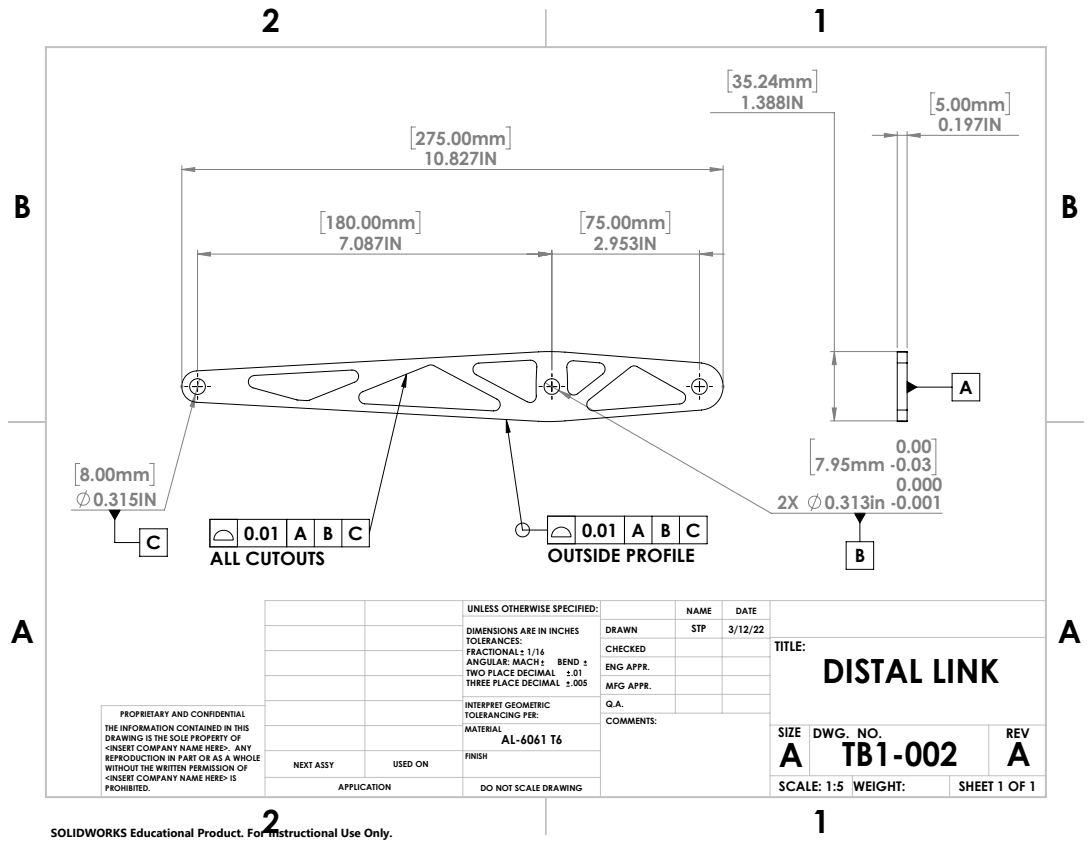
[picture p261: page 1]
0.01 A B C ALL CUTOUTS; OUTSIDE PROFILE

UNLESS OTHERWISE SPECIFIED: | | NAME | DATE
DIMENSIONS ARE IN INCHES TOLERANCES: FRACTIONAL 1/16 ANGULAR: MACH BEND TWO PLACE DECIMAL .01 THREE PLACE DECIMAL .005 | DRAWN | STP | 3/12/22
CHECKED | | | TITLE: DISTAL LINK

ENG APPR.
MFG APPR.

INTERPRET GEOMETRIC TOLERANCING PER: | Q.A.
MATERIAL AL-6061 T6 | | SIZE A | DWG. NO. TB1-002 | REV A

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

NEXT ASSY | USED ON | FINISH

APPLICATION | DO NOT SCALE DRAWING | | SCALE: 1:5 | WEIGHT: | SHEET 1 OF 1

SOLIDWORKS Educational Product. For Instructional Use Only.
