yjc97/Haptic_Tablet/Alpha/Drawings/TB1-003-PROX-LINK.pdf

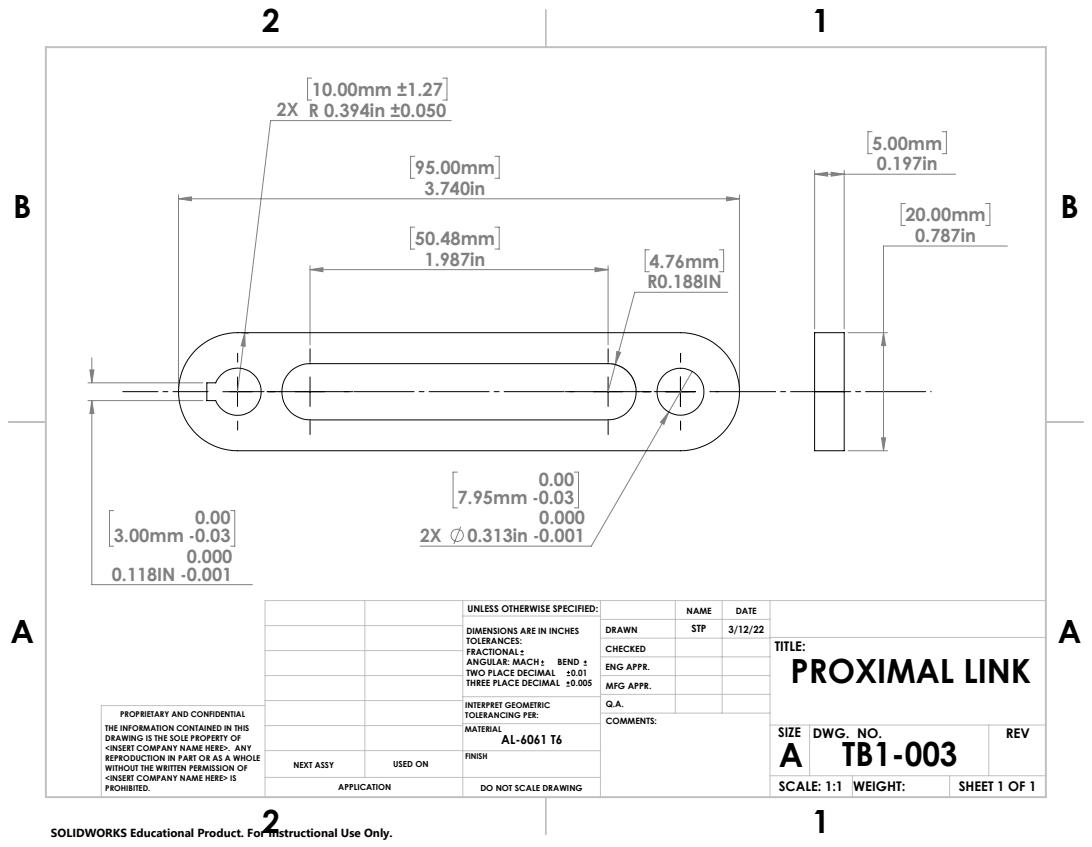
[picture p262: page 1]

UNLESS OTHERWISE SPECIFIED: | | NAME | DATE
DIMENSIONS ARE IN INCHES TOLERANCES: FRACTIONAL ANGULAR: MACH BEND TWO PLACE DECIMAL 0.01 THREE PLACE DECIMAL 0.005 | DRAWN | STP | 3/12/22
CHECKED | | | TITLE: PROXIMAL LINK

ENG APPR.
MFG APPR.

INTERPRET GEOMETRIC TOLERANCING PER: | Q.A.
MATERIAL AL-6061 T6 | | SIZE A | DWG. NO. TB1-003 | REV

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

NEXT ASSY | USED ON | FINISH

APPLICATION | DO NOT SCALE DRAWING | | SCALE: 1:1 | WEIGHT: | SHEET 1 OF 1

SOLIDWORKS Educational Product. For Instructional Use Only.
