yjc97/Haptic_Tablet/Alpha/Drawings/TB1-004-TRANSMISSION-PLATE.pdf

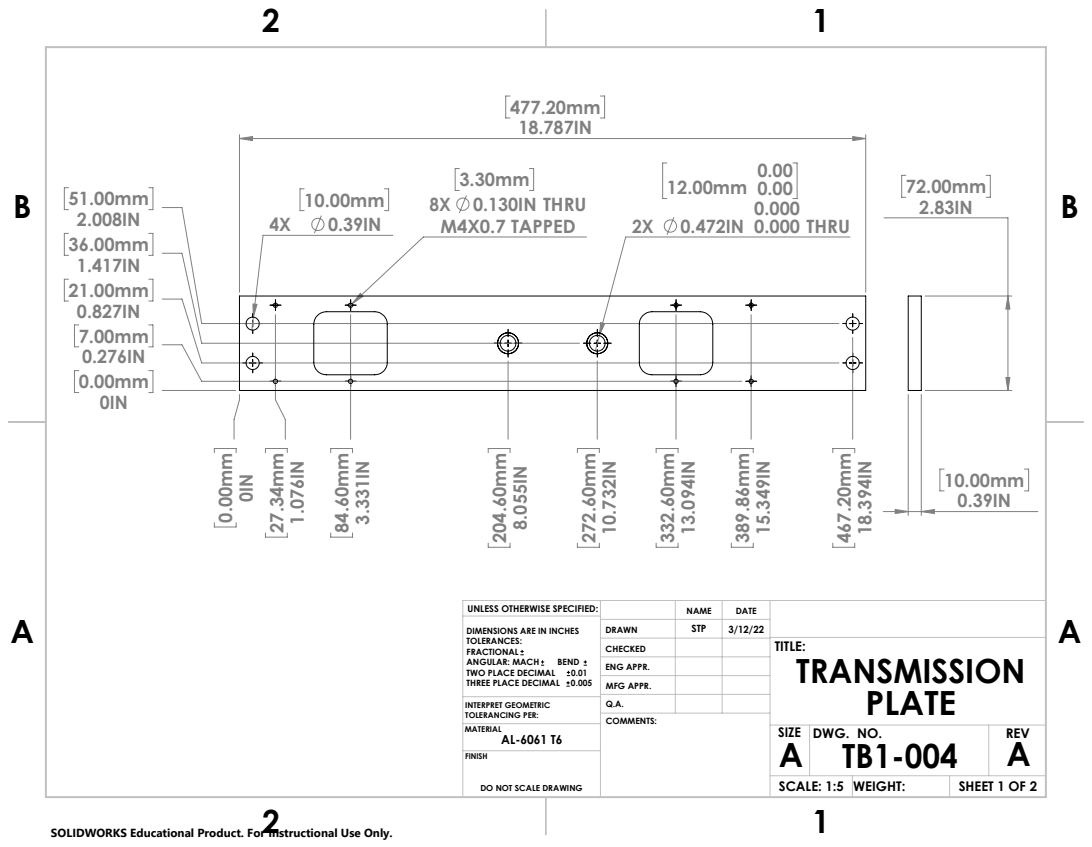
[picture p263: page 1]
0.130IN THRU; M4X0.7 TAPPED; 0.000 THRU; SHEET 1 OF 2; SCALE: 1:5; WEIGHT:; DWG. NO.; REV

UNLESS OTHERWISE SPECIFIED: | | NAME | DATE
DIMENSIONS ARE IN INCHES TOLERANCES: FRACTIONAL ANGULAR: MACH BEND TWO PLACE DECIMAL 0.01 THREE PLACE DECIMAL 0.005 | DRAWN | STP | 3/12/22
CHECKED | | | TITLE: TRANSMISSION PLATE

ENG APPR.
MFG APPR.

INTERPRET GEOMETRIC TOLERANCING PER: | Q.A.

DO NOT SCALE DRAWING

SOLIDWORKS Educational Product. For Instructional Use Only.

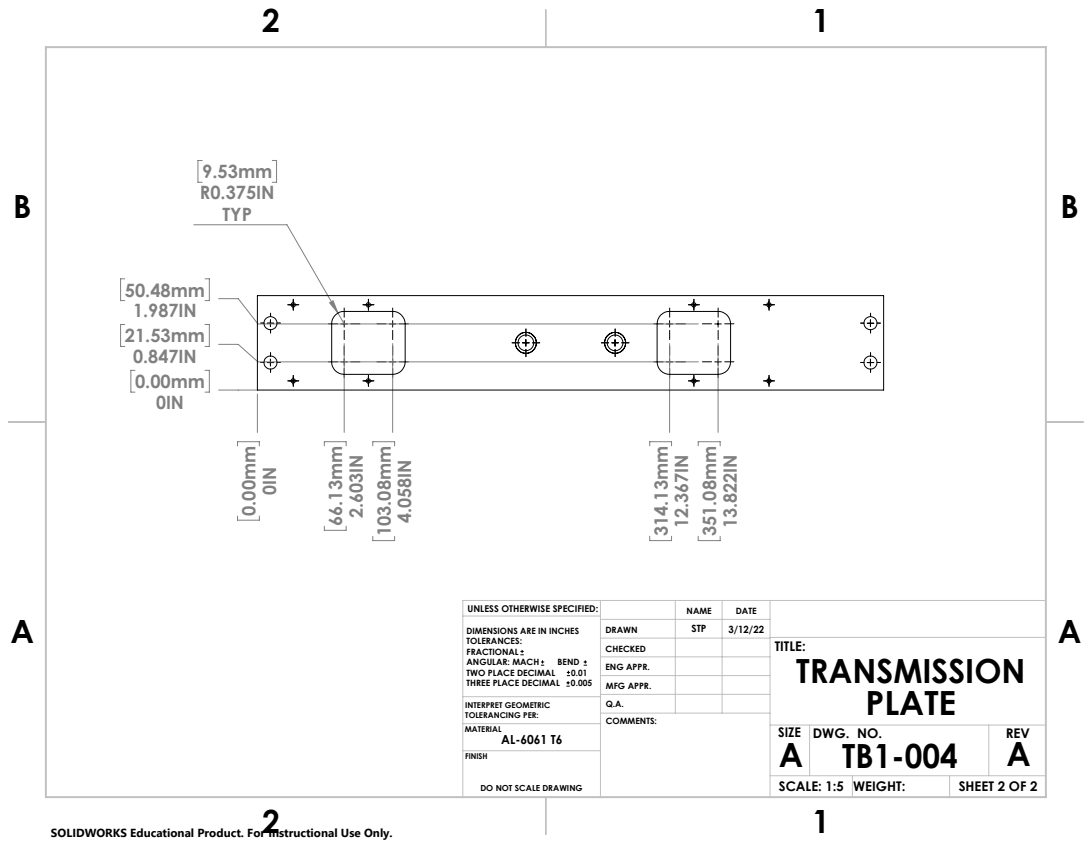
[picture p264: page 2]
TYP 0.00mm; SHEET 2 OF 2; SCALE: 1:5; WEIGHT:; DWG. NO.; REV

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

ENG APPR.
MFG APPR.

INTERPRET GEOMETRIC TOLERANCING PER: | Q.A.

DO NOT SCALE DRAWING

SOLIDWORKS Educational Product. For Instructional Use Only.
