yjc97/Haptic_Tablet/Alpha/Drawings/TB1-005-DRIVE-PULLEY.pdf

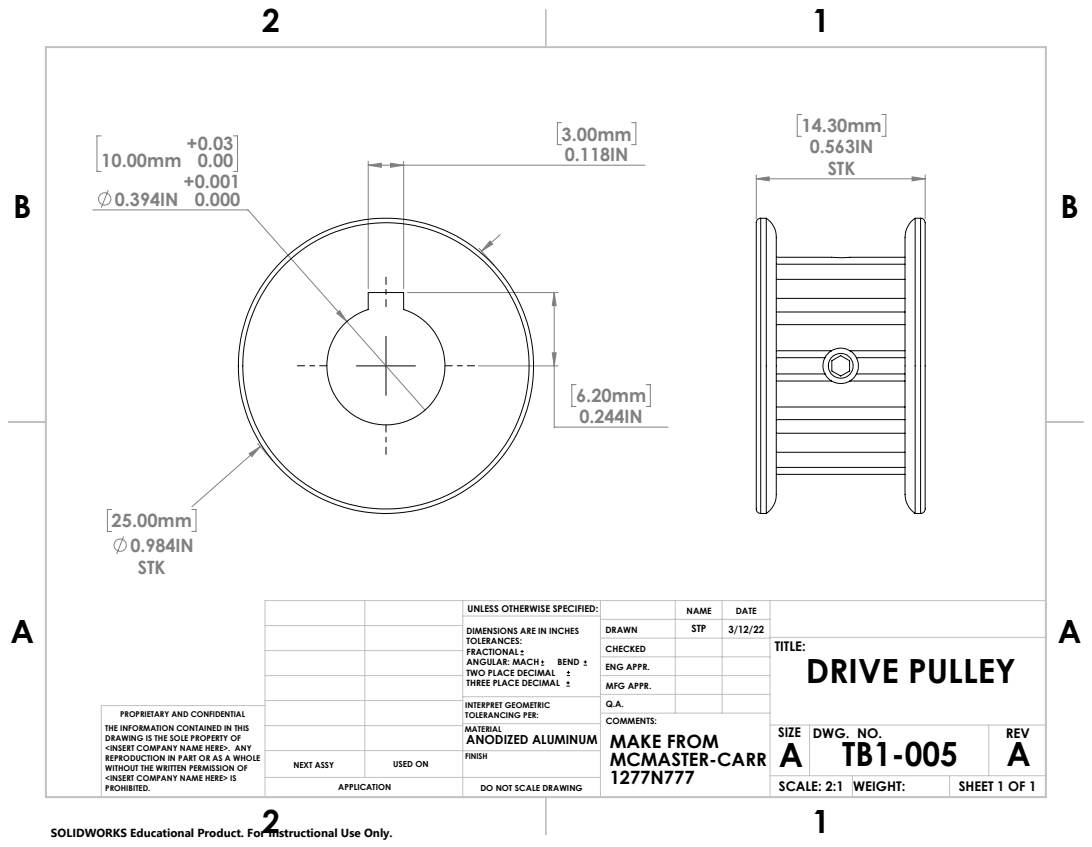
[picture p265: page 1]
MAKE FROM

UNLESS OTHERWISE SPECIFIED: | | NAME | DATE
DIMENSIONS ARE IN INCHES TOLERANCES: FRACTIONAL ANGULAR: MACH BEND TWO PLACE DECIMAL THREE PLACE DECIMAL | DRAWN | STP | 3/12/22
CHECKED | | | TITLE: DRIVE PULLEY

ENG APPR.
MFG APPR.

INTERPRET GEOMETRIC TOLERANCING PER: | Q.A.
MATERIAL ANODIZED ALUMINUM | | SIZE A | DWG. NO. TB1-005 | REV A

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

NEXT ASSY | USED ON | FINISH

APPLICATION | DO NOT SCALE DRAWING | | SCALE: 2:1 | WEIGHT: | SHEET 1 OF 1

SOLIDWORKS Educational Product. For Instructional Use Only.
