yjc97/Haptic_Tablet/Alpha/Drawings/TB1-PHANTOM-LINKAGE.pdf

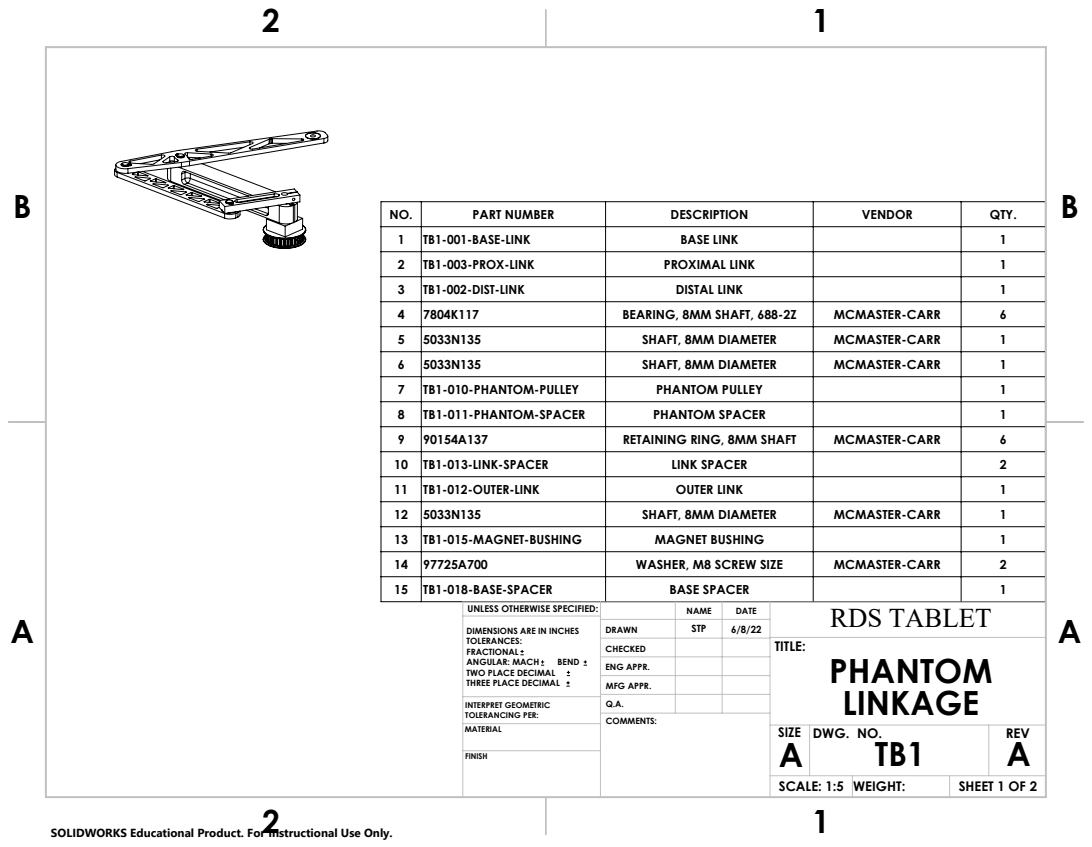
[picture p268: page 1]
SHEET 1 OF 2; SCALE: 1:5; WEIGHT:; DWG. NO.; REV

NO. | PART NUMBER | DESCRIPTION | VENDOR | QTY.
1 | TB1-001-BASE-LINK | BASE LINK | | 1
2 | TB1-003-PROX-LINK | PROXIMAL LINK | | 1
3 | TB1-002-DIST-LINK | DISTAL LINK | | 1
4 | 7804K117 | BEARING, 8MM SHAFT, 688-2Z | MCMASTER-CARR | 6
5 | 5033N135 | SHAFT, 8MM DIAMETER | MCMASTER-CARR | 1
6 | 5033N135 | SHAFT, 8MM DIAMETER | MCMASTER-CARR | 1
7 | TB1-010-PHANTOM-PULLEY | PHANTOM PULLEY | | 1
8 | TB1-011-PHANTOM-SPACER | PHANTOM SPACER | | 1
9 | 90154A137 | RETAINING RING, 8MM SHAFT | MCMASTER-CARR | 6
10 | TB1-013-LINK-SPACER | LINK SPACER | | 2
11 | TB1-012-OUTER-LINK | OUTER LINK | | 1
12 | 5033N135 | SHAFT, 8MM DIAMETER | MCMASTER-CARR | 1
13 | TB1-015-MAGNET-BUSHING | MAGNET BUSHING | | 1
14 | 97725A700 | WASHER, M8 SCREW SIZE | MCMASTER-CARR | 2
15 | TB1-018-BASE-SPACER | BASE SPACER | | 1

UNLESS OTHERWISE SPECIFIED: | | | DATE | RDS TABLET NAME
DIMENSIONS ARE IN INCHES TOLERANCES: FRACTIONAL ANGULAR: MACH BEND TWO PLACE DECIMAL THREE PLACE DECIMAL | DRAWN | STP | 6/8/22
CHECKED | | | TITLE: PHANTOM LINKAGE

ENG APPR.
MFG APPR.

INTERPRET GEOMETRIC TOLERANCING PER: | Q.A.

SOLIDWORKS Educational Product. For Instructional Use Only.

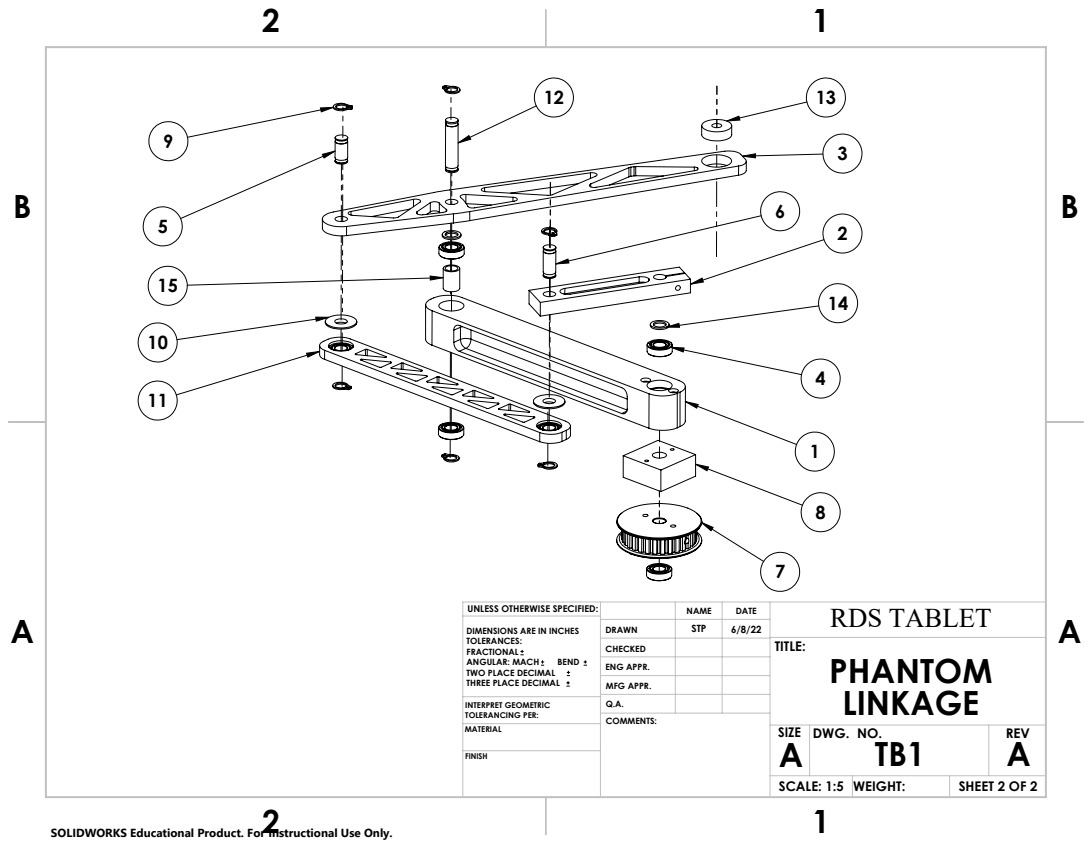
[picture p269: page 2]
SHEET 2 OF 2; SCALE: 1:5; WEIGHT:; DWG. NO.; REV

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

ENG APPR.
MFG APPR.

INTERPRET GEOMETRIC TOLERANCING PER: | Q.A.

SOLIDWORKS Educational Product. For Instructional Use Only.
