yjc97/Haptic_Tablet/Alpha/Drawings/TB1-TOP-TRANSMISSION.pdf

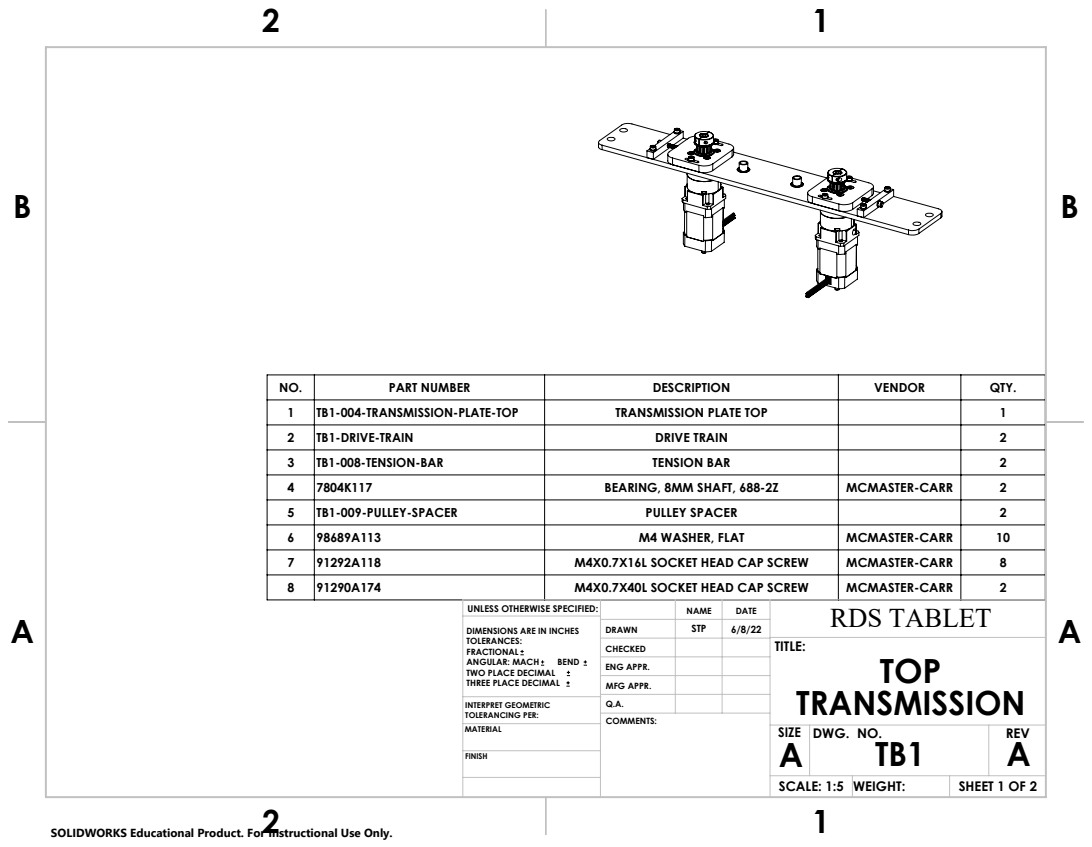
[picture p270: page 1]
SHEET 1 OF 2; SCALE: 1:5; WEIGHT:; DWG. NO.; REV

NO. | PART NUMBER | DESCRIPTION | VENDOR | QTY.
1 | TB1-004-TRANSMISSION-PLATE-TOP | TRANSMISSION PLATE TOP | | 1
2 | TB1-DRIVE-TRAIN | DRIVE TRAIN | | 2
3 | TB1-008-TENSION-BAR | TENSION BAR | | 2
4 | 7804K117 | BEARING, 8MM SHAFT, 688-2Z | MCMASTER-CARR | 2
5 | TB1-009-PULLEY-SPACER | PULLEY SPACER | | 2
6 | 98689A113 | M4 WASHER, FLAT | MCMASTER-CARR | 10
7 | 91292A118 | M4X0.7X16L SOCKET HEAD CAP SCREW | MCMASTER-CARR | 8
8 | 91290A174 | M4X0.7X40L SOCKET HEAD CAP SCREW | MCMASTER-CARR | 2

UNLESS OTHERWISE SPECIFIED: | | | DATE | RDS TABLET NAME
DIMENSIONS ARE IN INCHES TOLERANCES: FRACTIONAL ANGULAR: MACH BEND TWO PLACE DECIMAL THREE PLACE DECIMAL | DRAWN | STP | 6/8/22
CHECKED | | | TITLE: TOP TRANSMISSION

ENG APPR.
MFG APPR.

INTERPRET GEOMETRIC TOLERANCING PER: | Q.A.

SOLIDWORKS Educational Product. For Instructional Use Only.

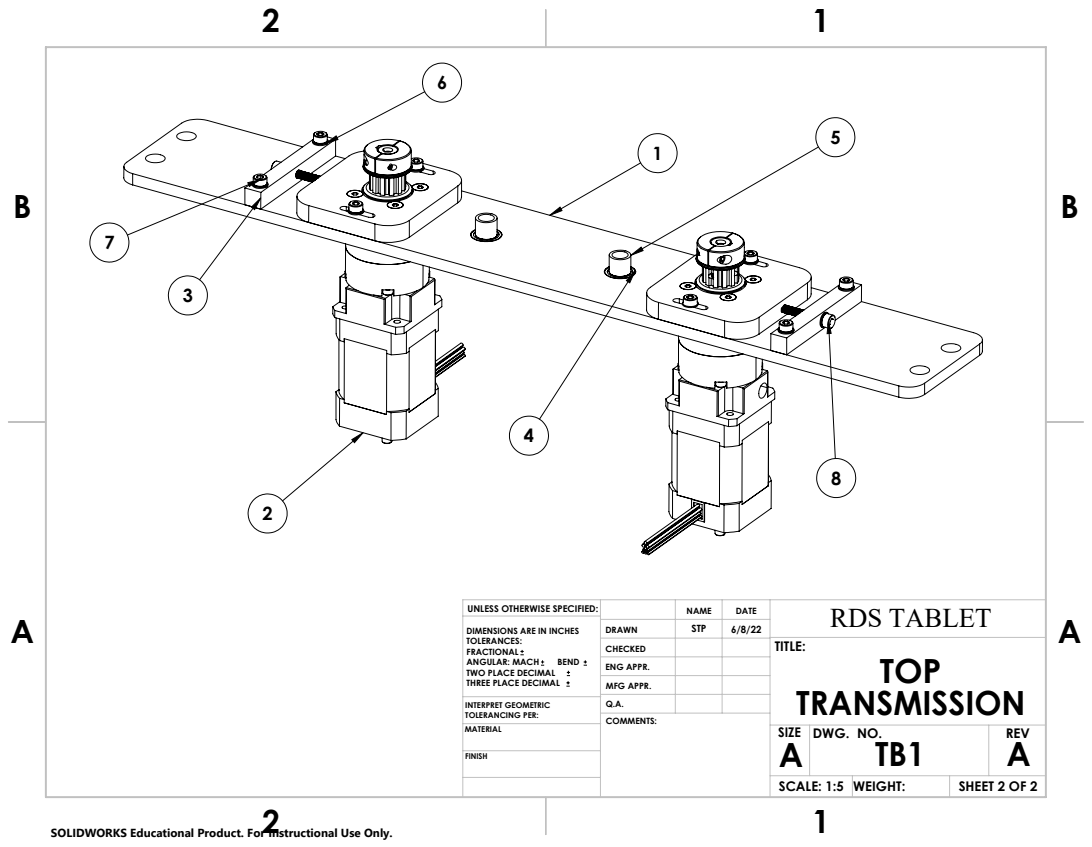
[picture p271: page 2]
SHEET 2 OF 2; SCALE: 1:5; WEIGHT:; DWG. NO.; REV

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

ENG APPR.
MFG APPR.

INTERPRET GEOMETRIC TOLERANCING PER: | Q.A.

SOLIDWORKS Educational Product. For Instructional Use Only.
