yjc97/Haptic_Tablet/Mechanism/Magnet/MagnetToHoseAdapterDrawing.pdf

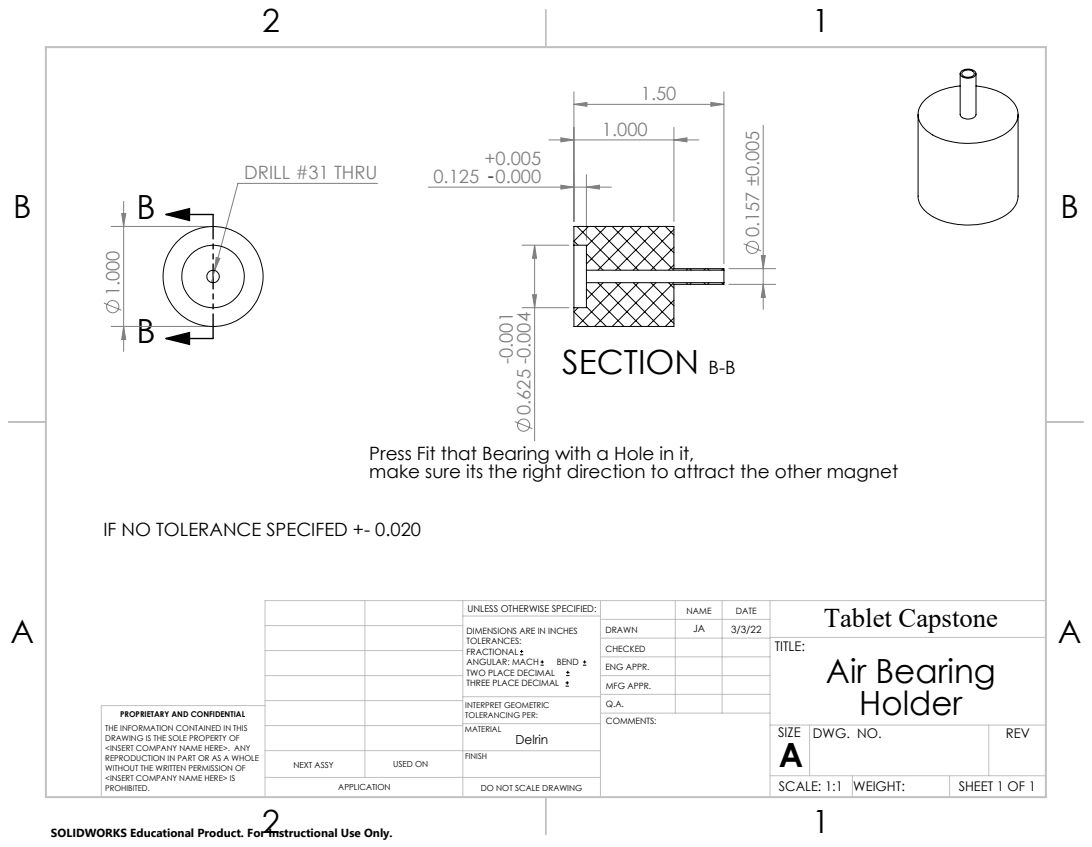
[picture p274: page 1]
DRILL #31 THRU; SECTION B-B

Press Fit that Bearing with a Hole in it,
make sure its the right direction to attract the other magnet

IF NO TOLERANCE SPECIFED +- 0.020

UNLESS OTHERWISE SPECIFIED: | | | DATE | Tablet Capstone NAME
DIMENSIONS ARE IN INCHES TOLERANCES: FRACTIONAL ANGULAR: MACH BEND TWO PLACE DECIMAL THREE PLACE DECIMAL | DRAWN | JA | 3/3/22

CHECKED | | | TITLE: Air Bearing Holder

ENG APPR.
MFG APPR.

INTERPRET GEOMETRIC TOLERANCING PER: | Q.A.
MATERIAL Delrin | | SIZE A | DWG. NO. | REV

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

NEXT ASSY | USED ON | FINISH

APPLICATION | DO NOT SCALE DRAWING | | SCALE: 1:1 | WEIGHT: | SHEET 1 OF 1

SOLIDWORKS Educational Product. For Instructional Use Only.
