yjc97/Haptic_Tablet/CAD/Tablet Capstone/Frame/80-20Frame_Drawing.pdf

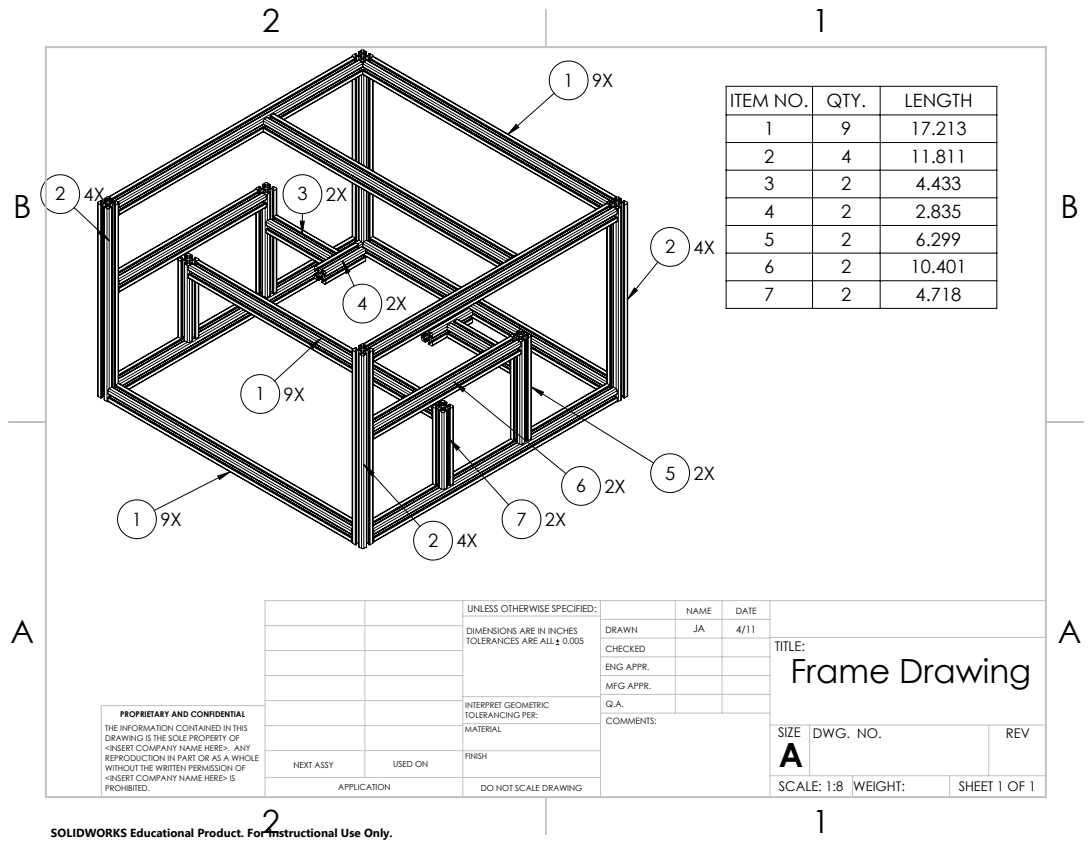
[picture p275: page 1]

ITEM NO. | QTY. | LENGTH
1 | 9 | 17.213
2 | 4 | 11.811
3 | 2 | 4.433
4 | 2 | 2.835
5 | 2 | 6.299
6 | 2 | 10.401
7 | 2 | 4.718

UNLESS OTHERWISE SPECIFIED: | | NAME | DATE
DIMENSIONS ARE IN INCHES TOLERANCES ARE ALL 0.005 | DRAWN | JA | 4/11

CHECKED | | | TITLE: Frame Drawing

ENG APPR.
MFG APPR.

INTERPRET GEOMETRIC TOLERANCING PER: | Q.A.
MATERIAL | | SIZE A | DWG. NO. | REV

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

NEXT ASSY | USED ON | FINISH

APPLICATION | DO NOT SCALE DRAWING | | SCALE: 1:8 | WEIGHT: | SHEET 1 OF 1

SOLIDWORKS Educational Product. For Instructional Use Only.
