yjc97/Haptic_Tablet/CAD/Tablet Capstone/.grabcad/.filecache/034B537FC6ADE67D82B392E09138ECEDE8240049.pdf

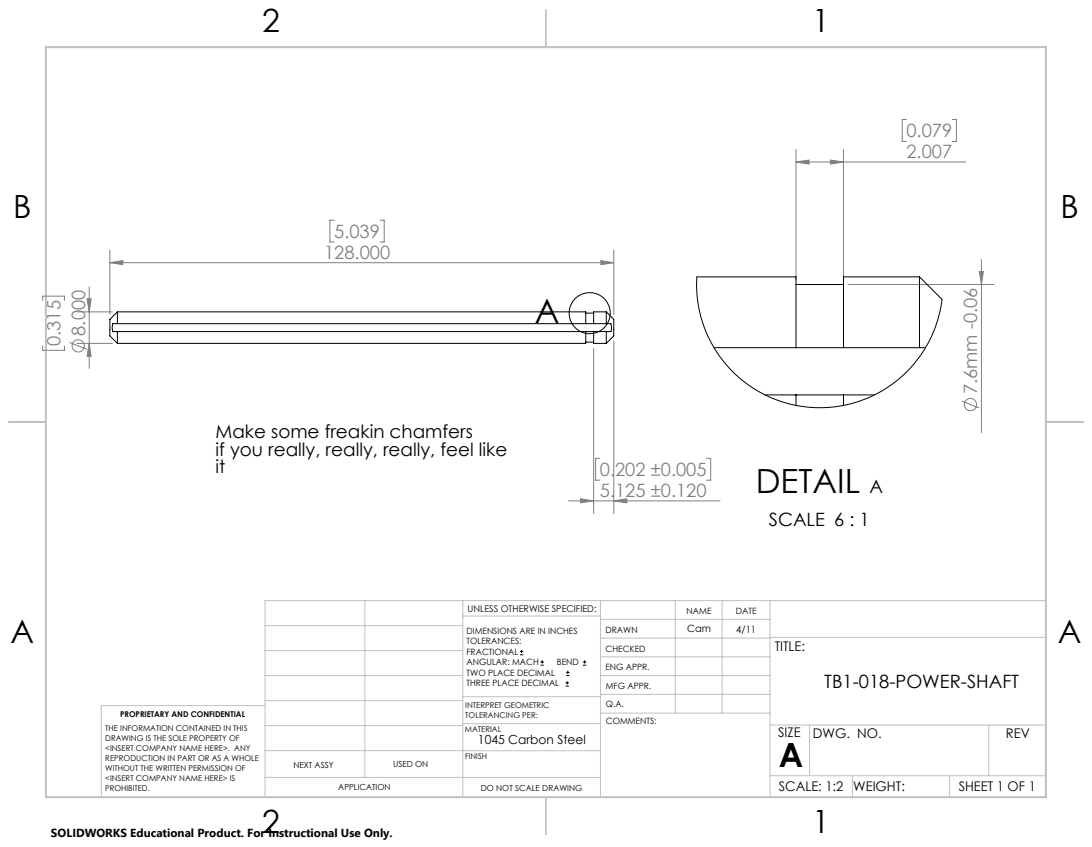
[picture p276: page 1]
DETAIL A; SCALE 6 : 1

Make some freakin chamfers
if you really, really, really, feel like

UNLESS OTHERWISE SPECIFIED: | | NAME | DATE
DIMENSIONS ARE IN INCHES TOLERANCES: FRACTIONAL ANGULAR: MACH BEND TWO PLACE DECIMAL THREE PLACE DECIMAL | DRAWN | Cam | 4/11

CHECKED | | | TITLE: TB1-018-POWER-SHAFT

ENG APPR.
MFG APPR.

INTERPRET GEOMETRIC TOLERANCING PER: | Q.A.
MATERIAL 1045 Carbon Steel | | SIZE A | DWG. NO. | REV

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

NEXT ASSY | USED ON | FINISH

APPLICATION | DO NOT SCALE DRAWING | | SCALE: 1:2 | WEIGHT: | SHEET 1 OF 1

SOLIDWORKS Educational Product. For Instructional Use Only.
