yjc97/Haptic_Tablet/CAD/Tablet Capstone/.grabcad/.filecache/97BA577459D1CBC70F8E5DD97B4C9442E10E0275.pdf

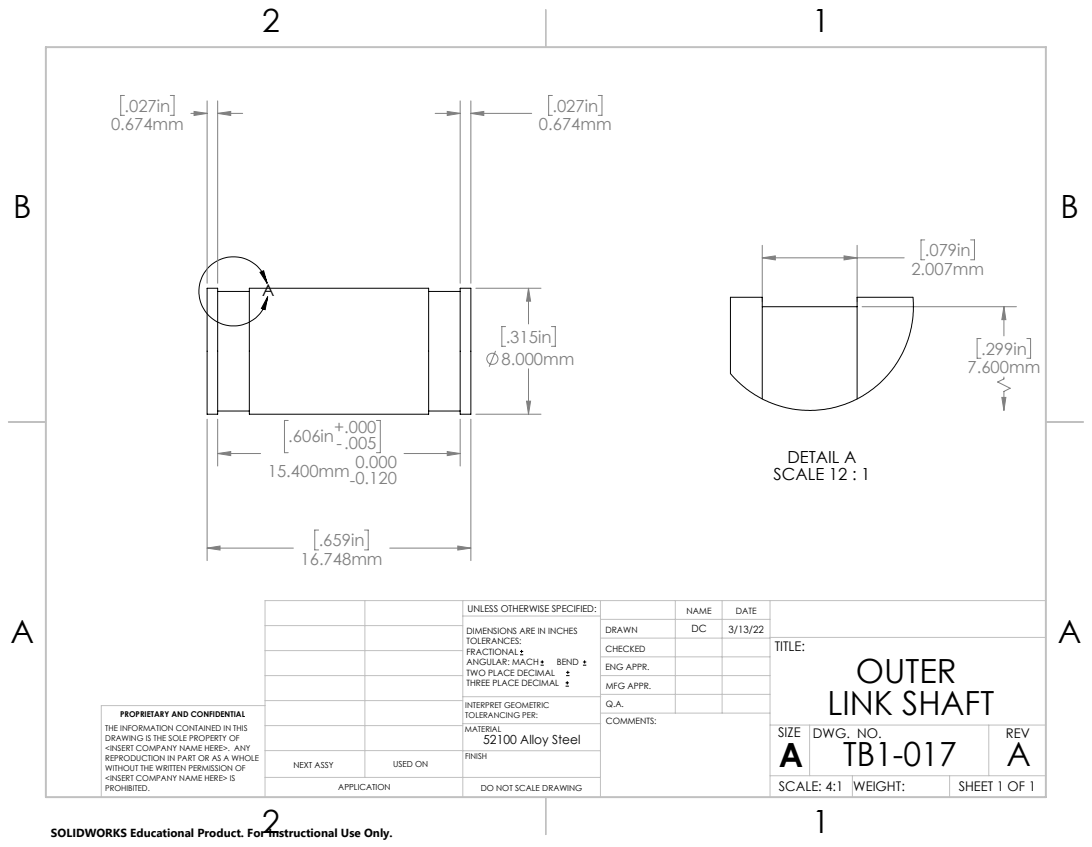
[picture p279: page 1]
DETAIL A SCALE 12 : 1

UNLESS OTHERWISE SPECIFIED: | | NAME | DATE
DIMENSIONS ARE IN INCHES TOLERANCES: FRACTIONAL ANGULAR: MACH BEND TWO PLACE DECIMAL THREE PLACE DECIMAL | DRAWN | DC | 3/13/22

CHECKED | | | TITLE: OUTER LINK SHAFT

ENG APPR.
MFG APPR.

INTERPRET GEOMETRIC TOLERANCING PER: | Q.A.
MATERIAL 52100 Alloy Steel | | SIZE A | DWG. NO. TB1-017 | REV A

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

NEXT ASSY | USED ON | FINISH

APPLICATION | DO NOT SCALE DRAWING | | SCALE: 4:1 | WEIGHT: | SHEET 1 OF 1

SOLIDWORKS Educational Product. For Instructional Use Only.
