yjc97/Haptic_Tablet/CAD/Tablet Capstone/.grabcad/.filecache/DB0EC0E3B1B323DB7EBBF1F18E505083E2141170.pdf

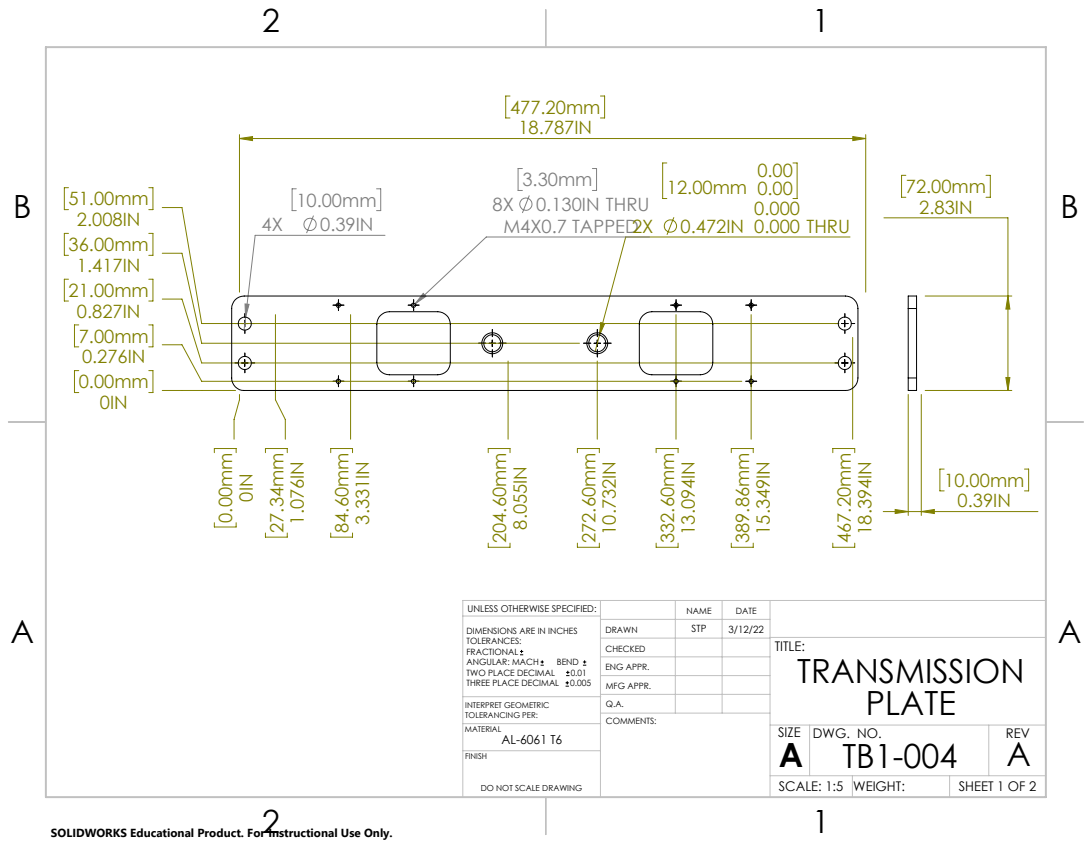
[picture p280: page 1]
0.130IN THRU M4X0.7 TAPPED2X; 0.000 THRU; SHEET 1 OF 2; SCALE: 1:5; WEIGHT:; DWG. NO.; REV

UNLESS OTHERWISE SPECIFIED: | | NAME | DATE
DIMENSIONS ARE IN INCHES TOLERANCES: FRACTIONAL ANGULAR: MACH BEND TWO PLACE DECIMAL 0.01 THREE PLACE DECIMAL 0.005 | DRAWN | STP | 3/12/22

CHECKED | | | TITLE: TRANSMISSION PLATE

ENG APPR.
MFG APPR.

INTERPRET GEOMETRIC TOLERANCING PER: | Q.A.

DO NOT SCALE DRAWING

SOLIDWORKS Educational Product. For Instructional Use Only.

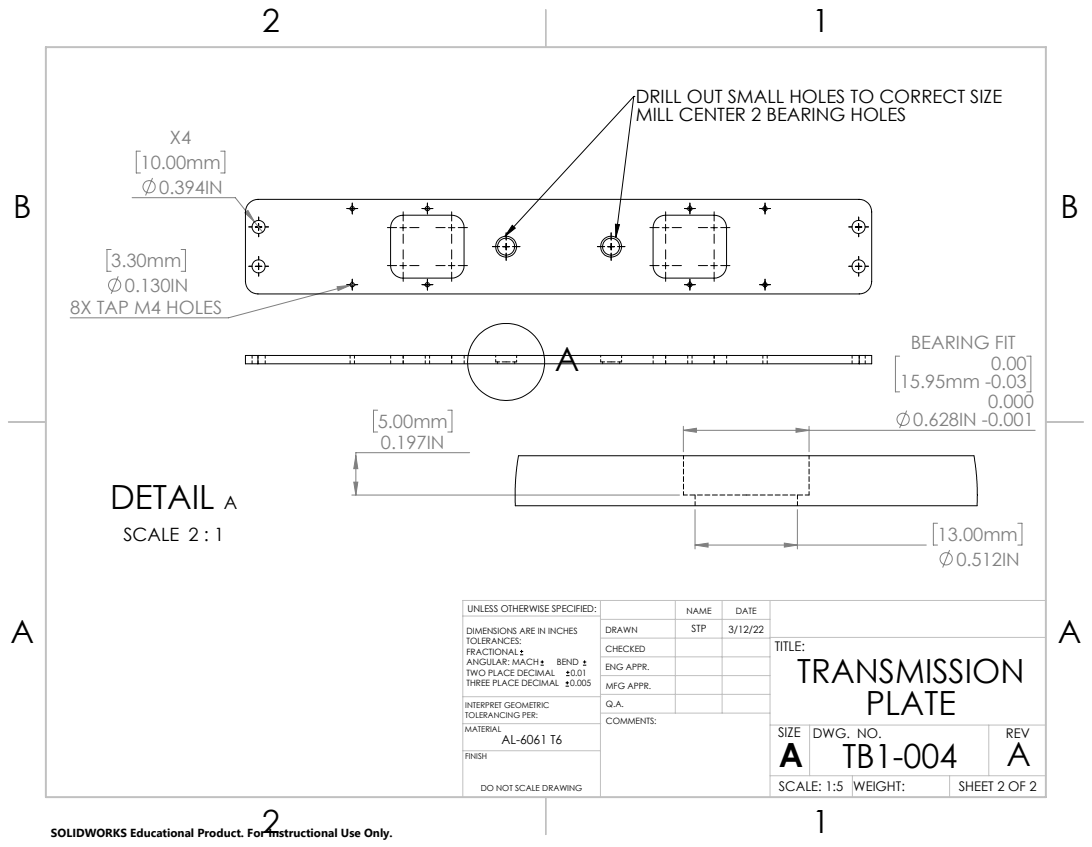
[picture p281: page 2]
8X TAP M4 HOLES; BEARING FIT; DETAIL A; SCALE 2 : 1; SHEET 2 OF 2; SCALE: 1:5; WEIGHT:; DWG. NO.; REV

DRILL OUT SMALL HOLES TO CORRECT SIZE
MILL CENTER 2 BEARING HOLES

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

CHECKED | | | TITLE: TRANSMISSION PLATE

ENG APPR.
MFG APPR.

INTERPRET GEOMETRIC TOLERANCING PER: | Q.A.

DO NOT SCALE DRAWING

SOLIDWORKS Educational Product. For Instructional Use Only.
