yjc97/Haptic_Tablet/Software/stm32cubeProject/tablet/tablet.ioc

Mcu.UserName=STM32H755ZITx
PA1.Signal=ETH_REF_CLK
PA10.Signal=USART1_RX
PA11.Signal=USB_OTG_FS_DM
PA12.Signal=USB_OTG_FS_DP
PA2.Signal=ETH_MDIO
PA7.Signal=ETH_CRS_DV
PA8.Signal=USB_OTG_FS_SOF
PA9.Signal=USART1_TX
PB0.GPIO_Label=LD1 [Green Led]
PB0.Signal=GPIO_Output
PB10.GPIO_Label=STLINK_RX
PB10.Signal=USART3_TX
PB11.GPIO_Label=STLINK_TX
PB11.Signal=USART3_RX
PB13.Signal=ETH_TXD1
PB14.GPIO_Label=LD3 [Red Led]
PB14.Signal=GPIO_Output
PB7.Signal=I2C1_SDA
PB8.Signal=I2C1_SCL
PC1.Signal=ETH_MDC
PC13.GPIO_Label=B1 [Blue PushButton]
PC13.Signal=GPIO_Input
PC4.Signal=ETH_RXD0
PC5.Signal=ETH_RXD1
PD10.GPIO_Label=USB_OTG_FS_PWR_EN
PD10.Signal=GPIO_Output
PD5.Signal=USART2_TX
PD6.Signal=USART2_RX
PE1.GPIO_Label=LD2 [Yellow Led]
PE1.Signal=GPIO_Output
PG11.Signal=ETH_TX_EN
PG13.Signal=ETH_TXD0
PG7.GPIO_Label=USB_OTG_FS_OVCR
PG7.Signal=GPXTI7
