yjc97/Haptic_Tablet/Software/stm32cubeProject/tablet/CM4/Core/Inc/main.h

#define STLINK_RX_Pin GPIO_PIN_10
#define STLINK_RX_GPIO_Port GPIOB
#define STLINK_TX_Pin GPIO_PIN_11
#define STLINK_TX_GPIO_Port GPIOB
