yjc97/Haptic_Tablet/(notices)

Notices in the files:
Software/stm32cubeProject/tablet/CM7/Core/Src/main.cpp:
Copyright (c) 2022 STMicroelectronics.
All rights reserved.
This software is licensed under terms that can be found in the LICENSE file
