yjc97/Haptic_Tablet/Media/Mechanism/IMG_4430.JPG

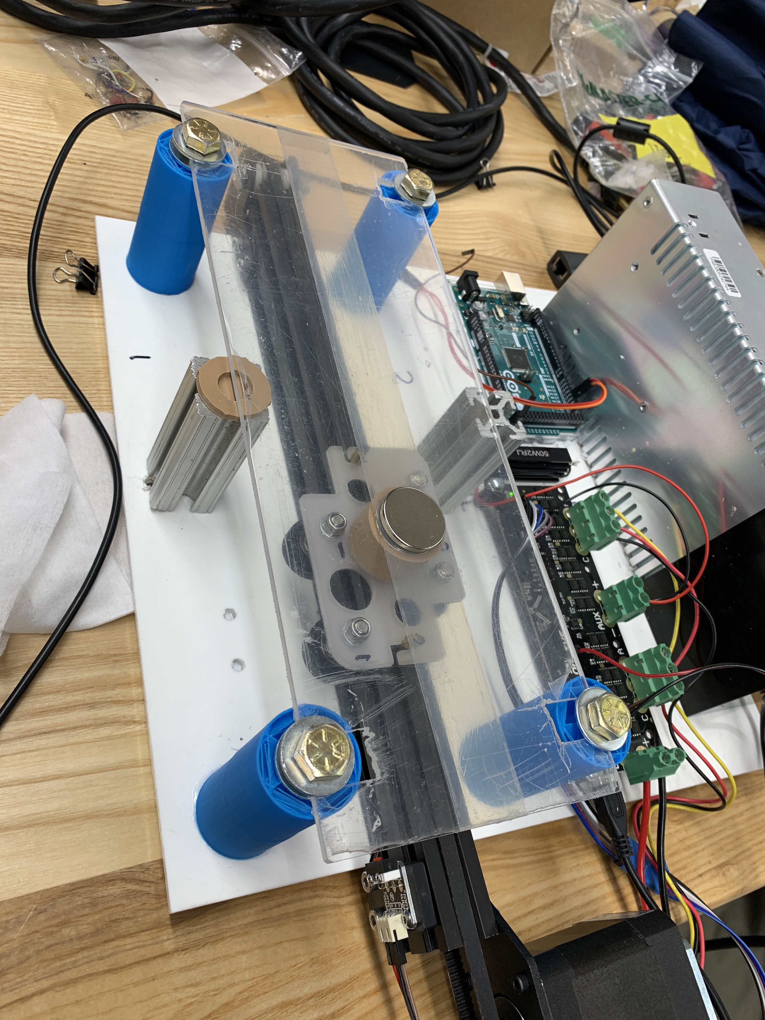
Media/Mechanism/IMG_4430.JPG
