yjc97/Haptic_Tablet/Media/Mechanism/IMG_4433.JPG

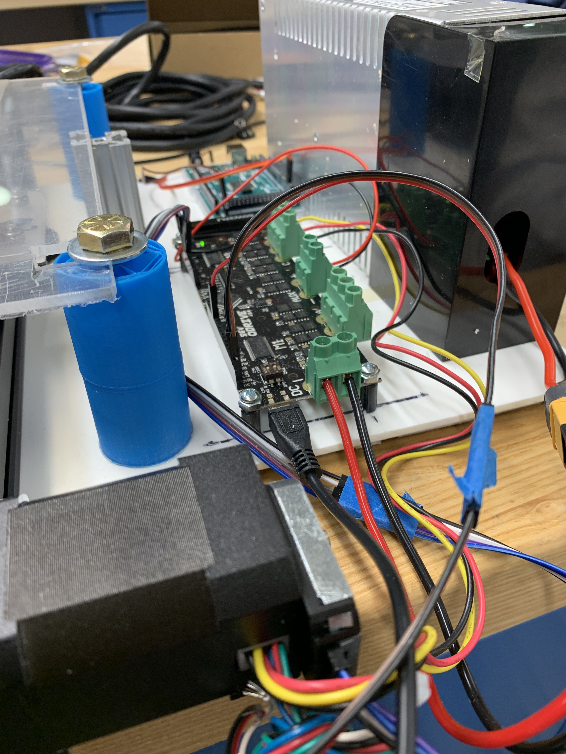
Media/Mechanism/IMG_4433.JPG
