yjc97/Haptic_Tablet/Media/Mechanism/IMG_4434.JPG

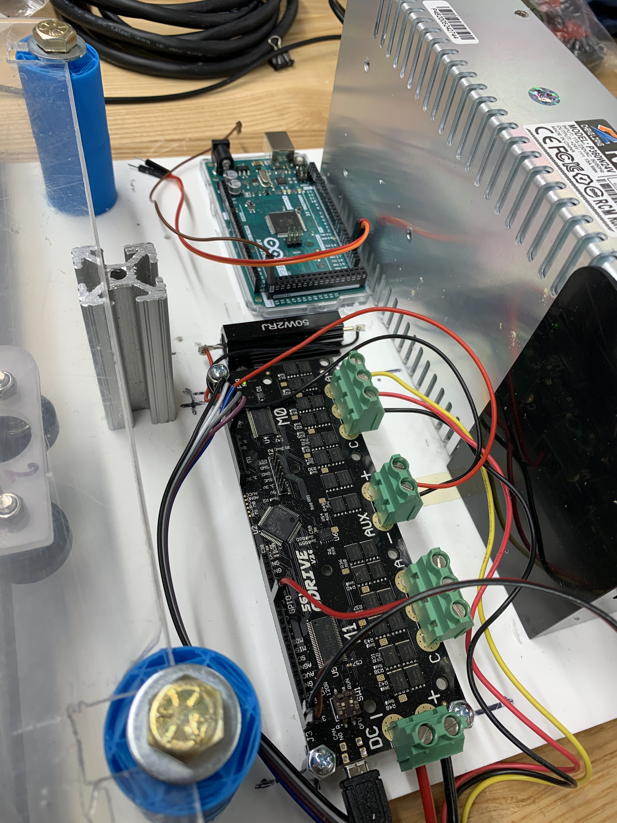
Media/Mechanism/IMG_4434.JPG
