yjc97/Haptic_Tablet/Media/Mechanism/IMG_4435.JPG

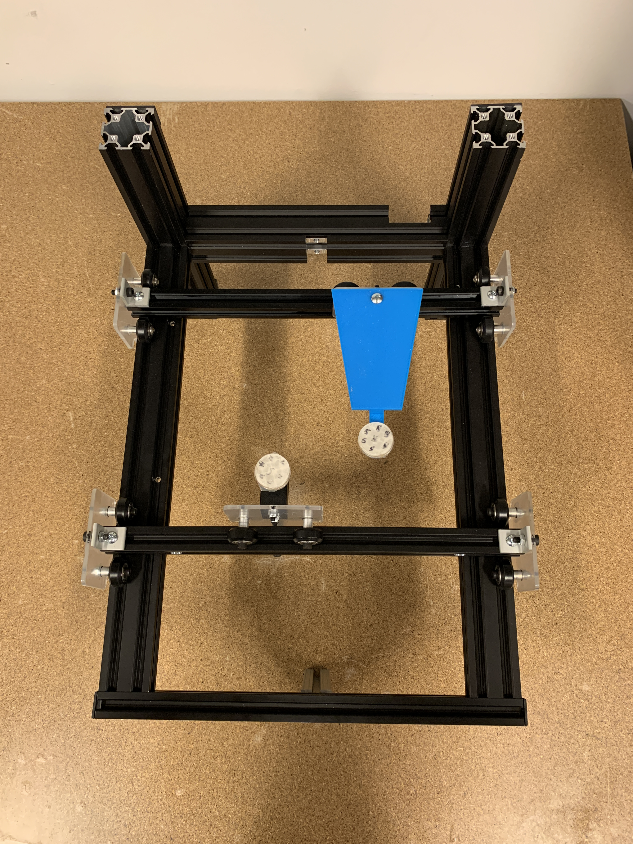
Media/Mechanism/IMG_4435.JPG
