yjc97/Haptic_Tablet/Media/Mechanism/IMG_4436.JPG

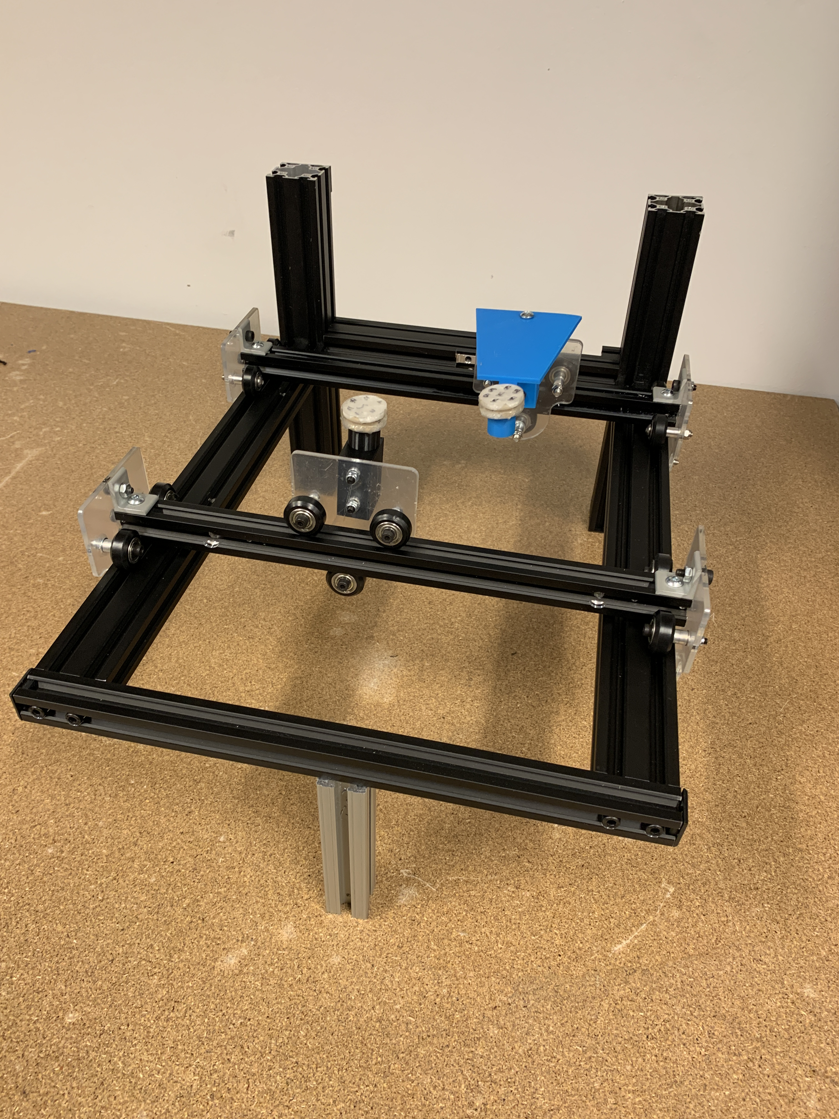
Media/Mechanism/IMG_4436.JPG
