yjc97/Haptic_Tablet/Media/Mechanism/IMG_4438.JPG

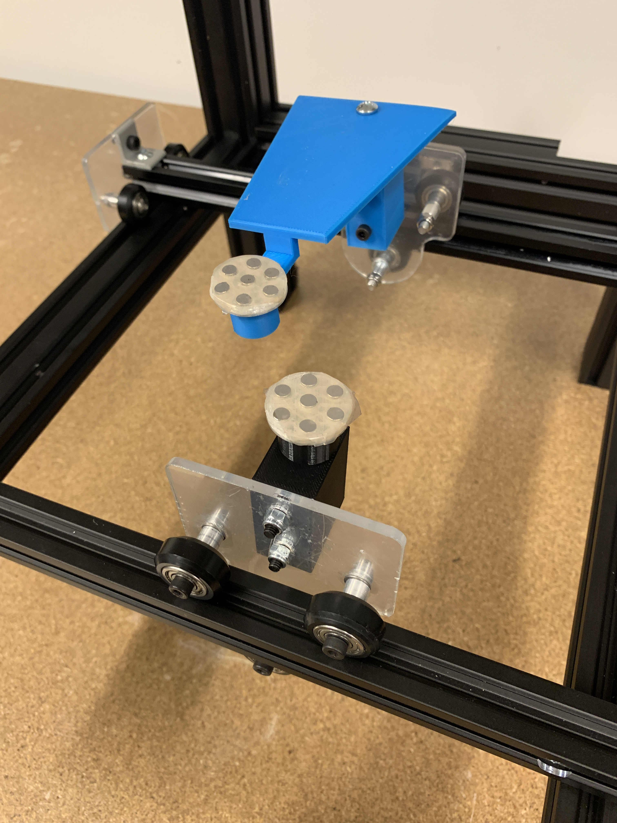
Media/Mechanism/IMG_4438.JPG
