yjc97/Haptic_Tablet/Media/Mechanism/IMG_4439.JPG

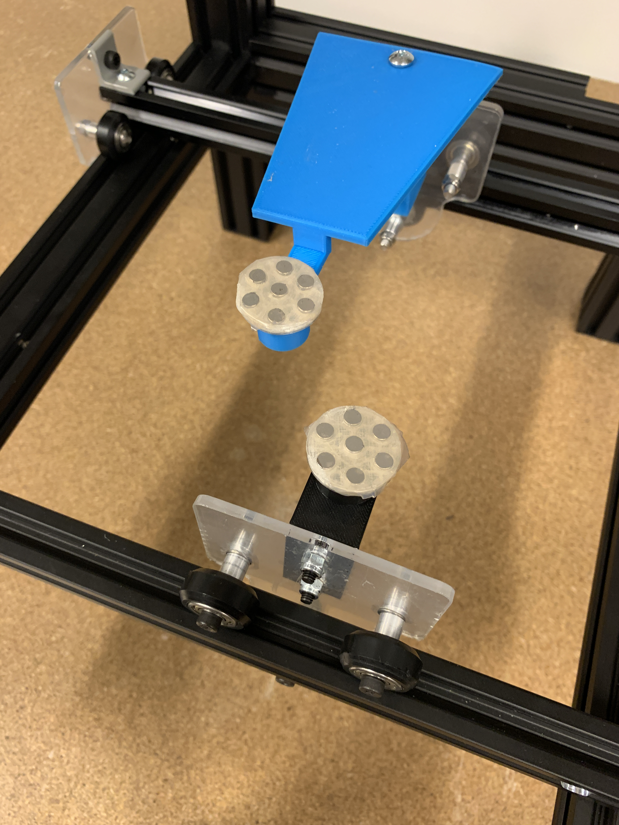
Media/Mechanism/IMG_4439.JPG
