yjc97/Haptic_Tablet/Media/Mechanism/IMG_4440.JPG

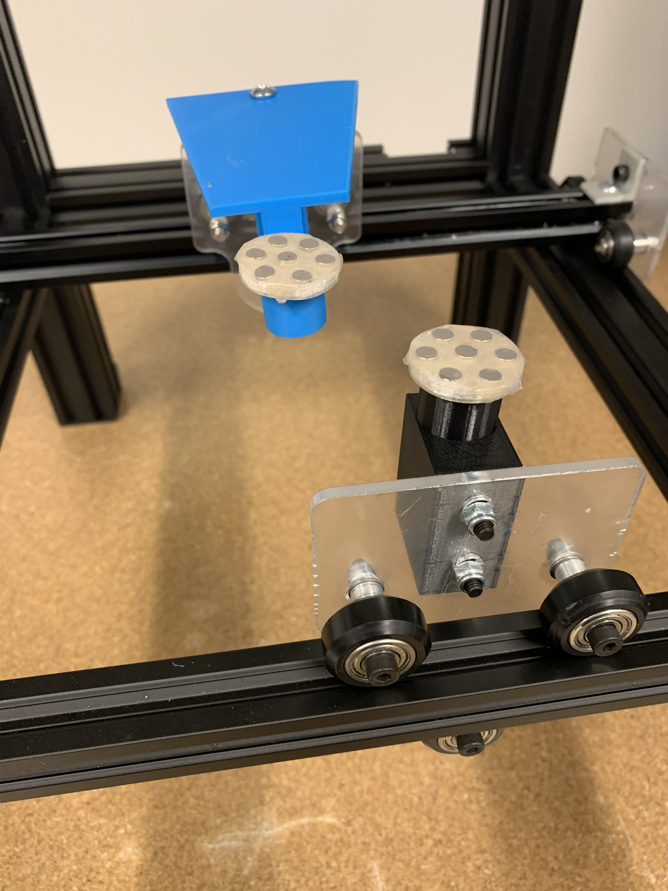
Media/Mechanism/IMG_4440.JPG
