yjc97/Haptic_Tablet/Media/Mechanism/IMG_4444.JPG

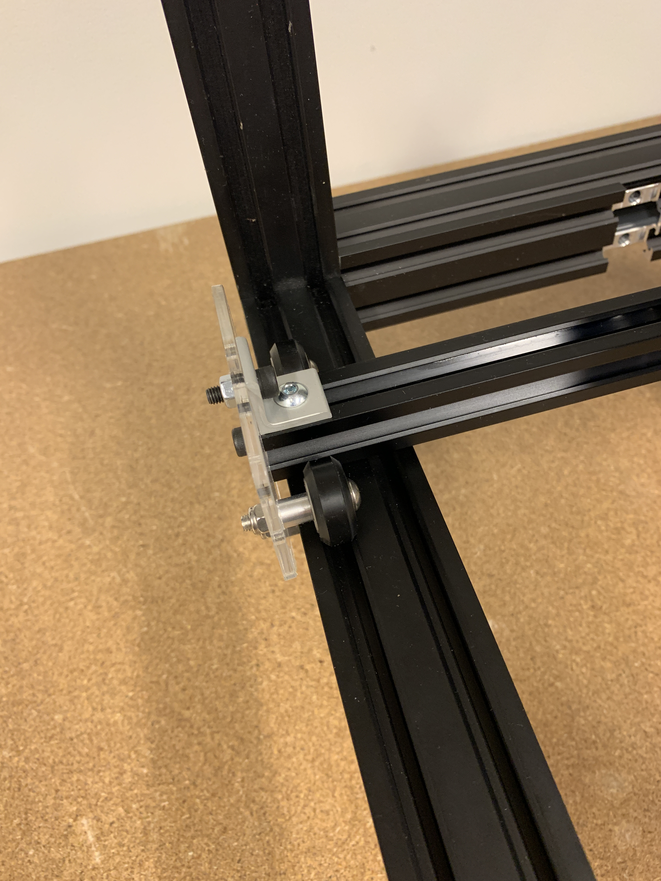
Media/Mechanism/IMG_4444.JPG
