yjc97/Haptic_Tablet/Media/Mechanism/IMG_4449.JPG

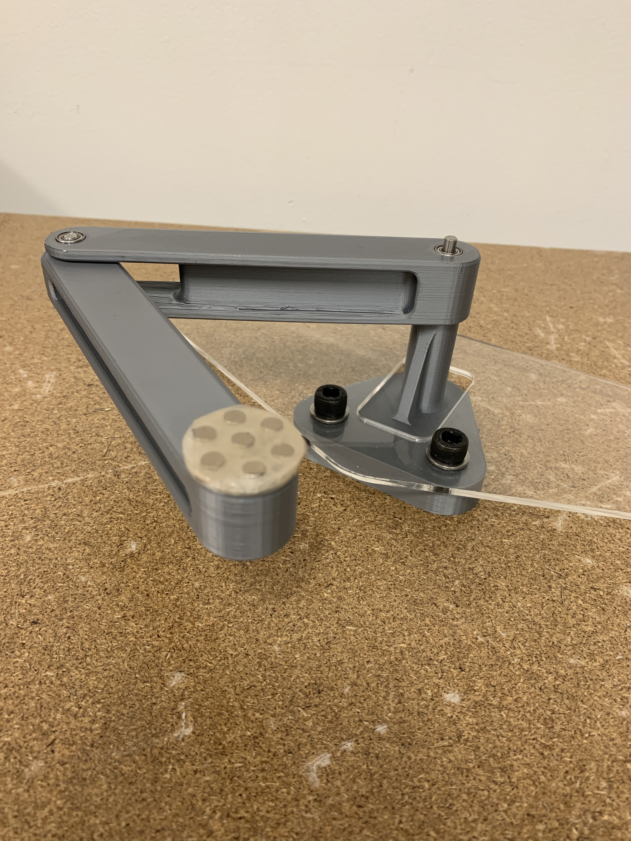
Media/Mechanism/IMG_4449.JPG
