yjc97/Haptic_Tablet/Media/Mechanism/IMG_4450.JPG

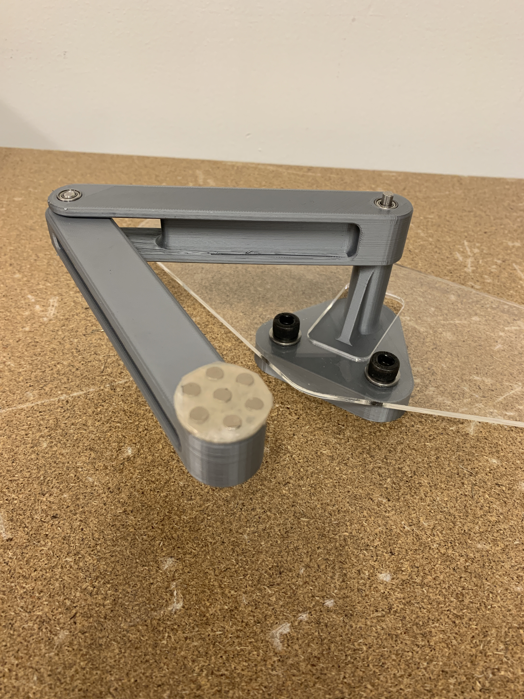
Media/Mechanism/IMG_4450.JPG
