yjc97/Haptic_Tablet/Media/Mechanism/IMG_4451.JPG

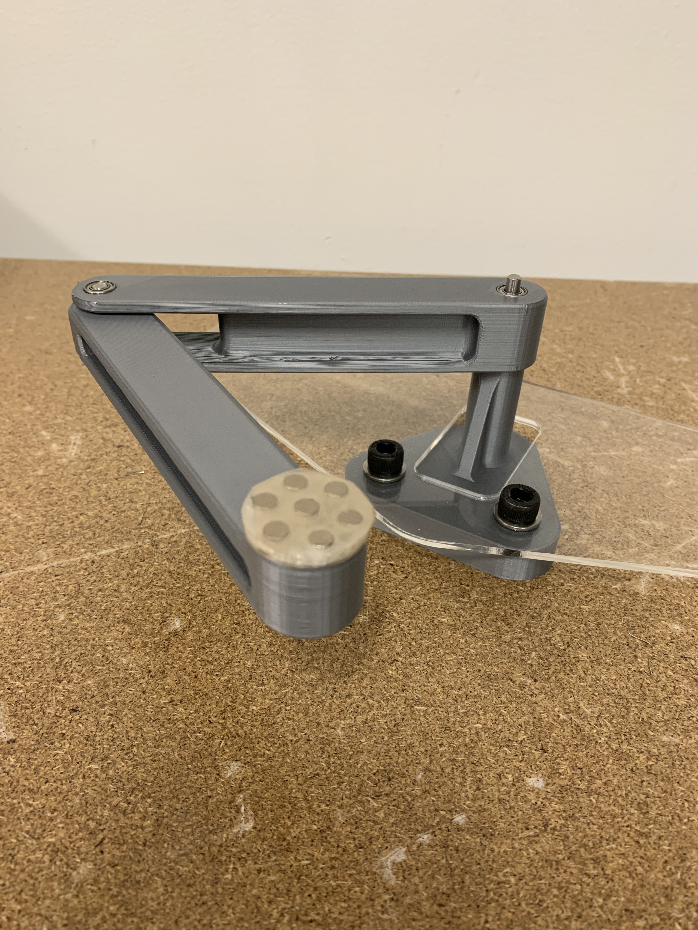
Media/Mechanism/IMG_4451.JPG
