yjc97/Haptic_Tablet/Media/Mechanism/IMG_4452.JPG

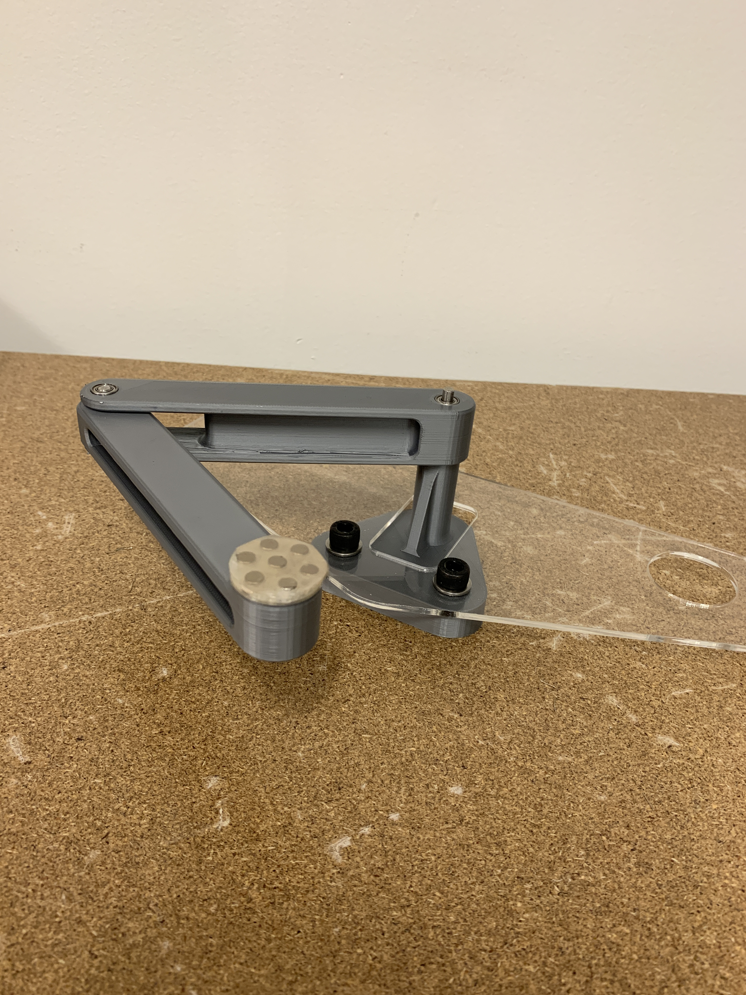
Media/Mechanism/IMG_4452.JPG
