yjc97/Haptic_Tablet/Media/Mechanism/IMG_4453.JPG

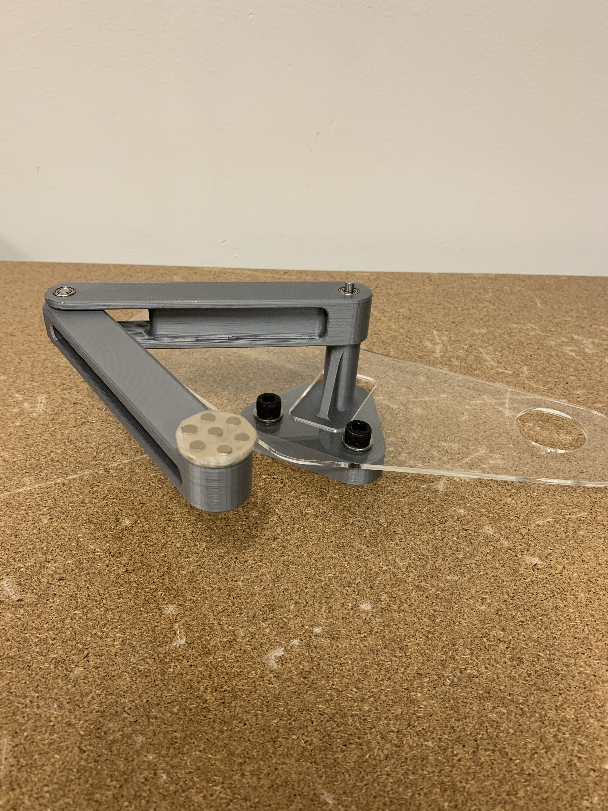
Media/Mechanism/IMG_4453.JPG
